EricoDeMecha/Die-Set/README.md

# DieSet Project
##  Problem statement

Among the significant advances in civil engineering, developing construction parts in pieces and sliding them together is being widely adopted especially when construction is on a busy site, and sometimes due to extreme urgency for the completion of the project. This approach allows for modularization and distribution of the project modules. However, it also introduces complexity to the project as such parts weigh hundreds of tonnes. Sliding such constructions into place requires a standard piece of engineering. 

##  Proposed solution 
This project proposes a viable solution to this problem. It proposes a slight modification of a caster wheel by setting the caster angle to zero, eliminating bearings, and using high-strength materials with a yield strength of at least 241MPa.

##  CADCAMing the solution
### parts
* Top  plate
* Axle Support
* Axle
* Wheel
#### Sofwares
   * Autodesk Inventor Pro 2020
   * Autdesk  Inventor CAM Ultimate 2020

**Note**

   Find more in the report and presentation directories,
