EricoDeMecha/Die-Set/Presentation/presentation.pptx

## Die set

easing heavy skidding

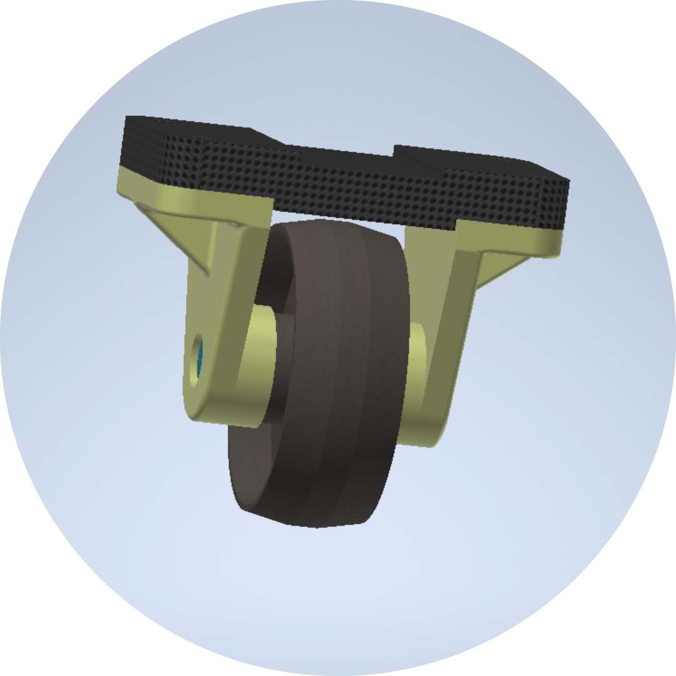
[picture p1: figure]

## Problem

- Heavy tracks. Casts.
- Complicated plate tracks.
- Enormous hydraulics.
- Costly tracks.
(Video Evidence)

## Comparison 01

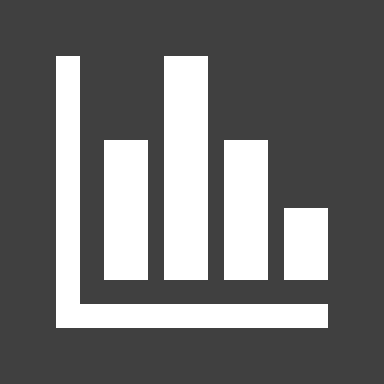
[picture p2: figure]
Bar chart

- Caster wheel 01

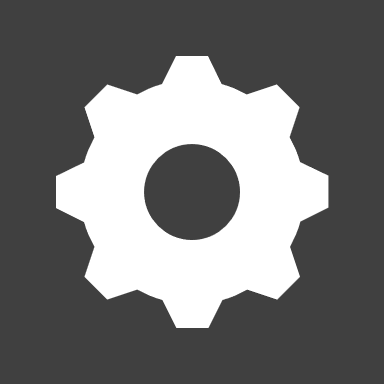
[picture p3: figure]
Single gear

- Die Set 01

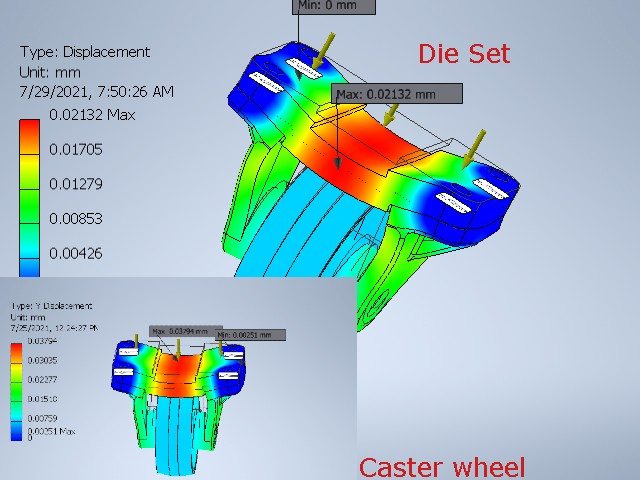
[picture p4: figure]
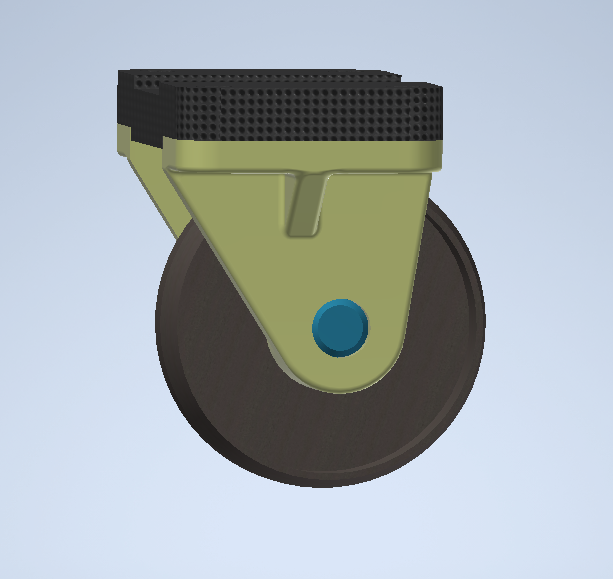
[picture p5: figure]

caster wheel
- Caster angle of approximately 15
- 0.03791mm Y displacement

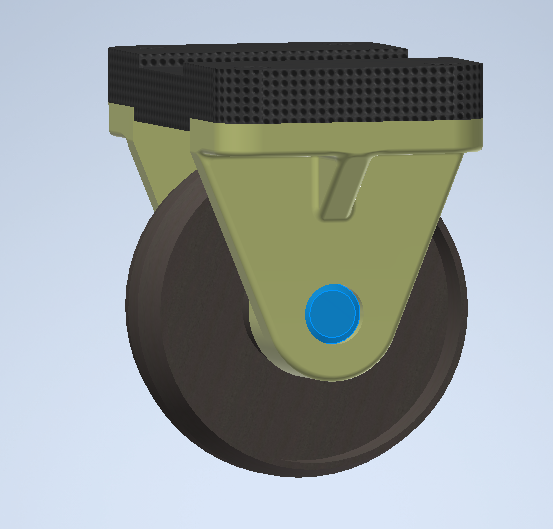
[picture p6: figure]

Die set
- Zero Caster angle
- 0.02132mm Y displacement

## Material

STAINLESS STEEL

CARBON STEEL
MALLEABLE IRON

## TOP PLATE 01

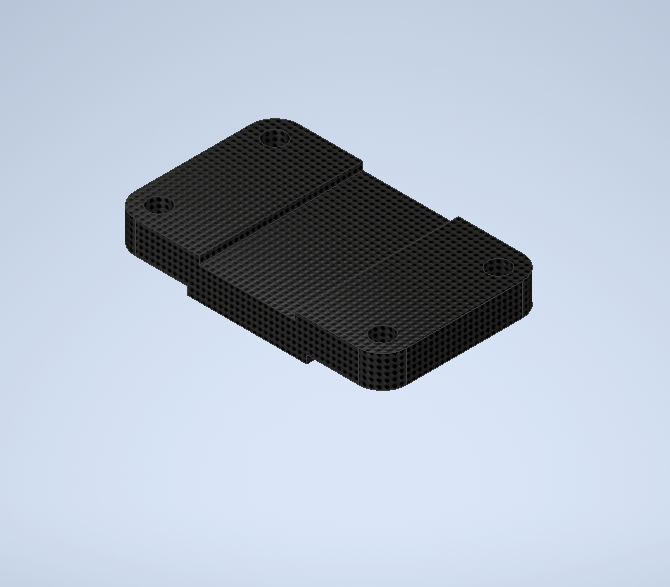
[picture p7: figure]

It is a 136mm by 82 mm by 16mm with four 11mm diameter holes
PART DESIGN: - design with machining in mind.
I. 2D MILLING (16mm flat mill)
- Stock material removal.
- top groove milling (2mm).
- 2 side grooves milling (2mm).
- Filleting (12mm radius).
MILLING: - Milling with mounting in mind.
II. DRILLING (10mm drill)
- Guided drilling(5mm then 10mm)
NOTE: - Two part machining
- machining time

## AXLE SUPPORT 02

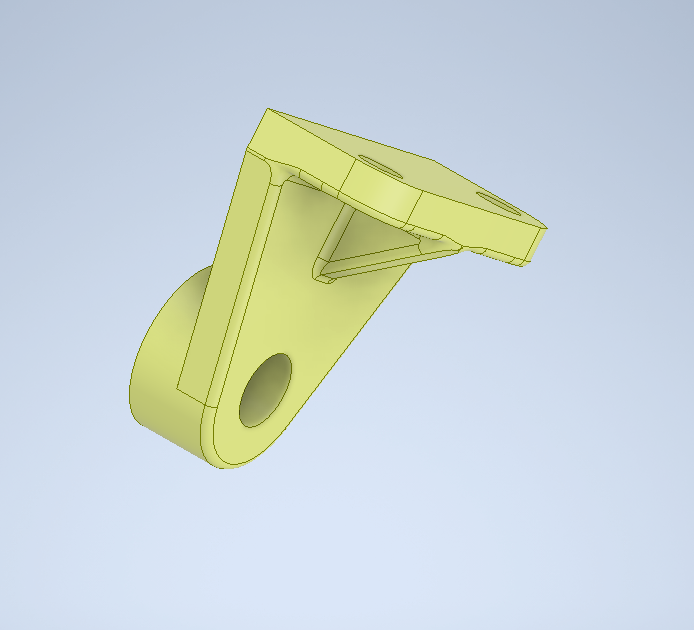
[picture p8: figure]

Connects the wheel axle and the top plate.
- Three part machining
I. 2D MILLING
- Stock material removal.
II. 2D ADAPTIVE MILLING
- Milling pockets around the rib.
- Milling the gradient of the rib.
- Filleting edges.
- Drilling by milling.
III. FINISHING
- Ball mill for smooth rib gradient.

## AXLE 03

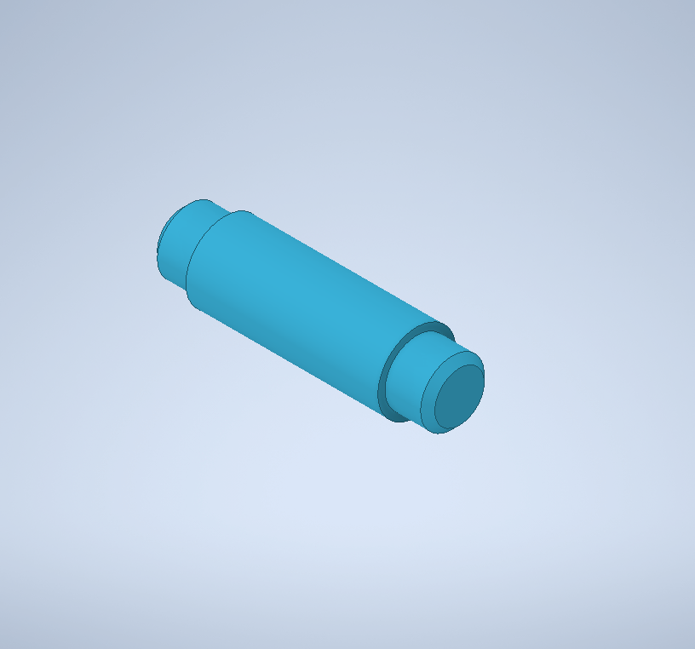
[picture p9: figure]

Supports the wheel. Cylindrical, 21.9mm O.D. , 17.9mm I.D. , and 78mm length.
I. FACING
- Removal extra stock material.
II. PROFILE TURNING
- Pattern: chamfer, side parting
NOTE: - two part milling (symmetric)

## WHEEL 04

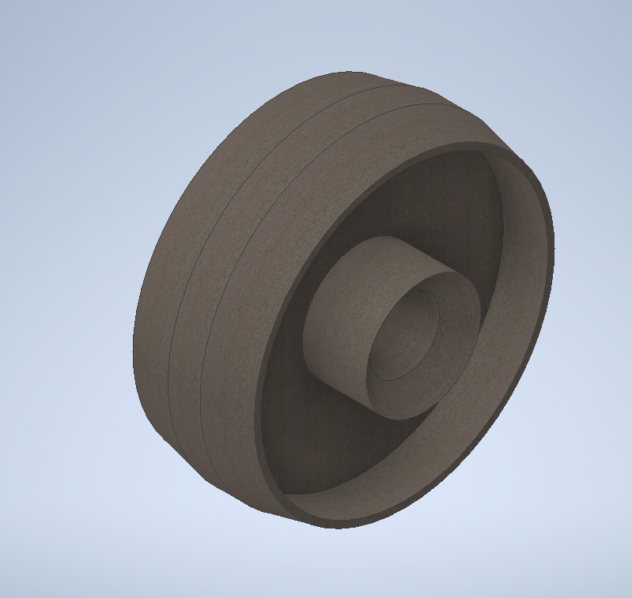
[picture p10: figure]

Interfaces with either the rail or the ground.
I. 2D MILLING
- Stock extra material removal.
II. 2D CONTOUR MILLING.
- chamfer milling
III. DRILLING BY MILLING
- circular milling with increasing feed rate.
Note:- Machining time
- Symmetric two part milling.

## NOTE 01

- NOTE 01 MACHINING TIME

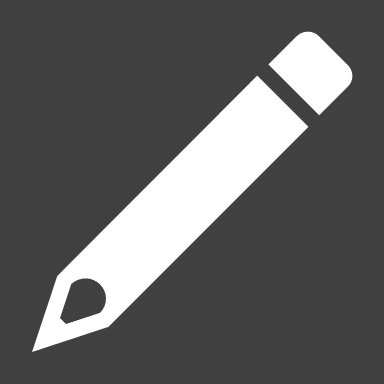
[picture p11: figure]
Pencil

- Tool travel path. Idling.
- Adaptive milling. Optimized tool path.

- Ball milling tool for 2D milling ribs.
- 0.5mm material left for finishing.
- Tool speed.

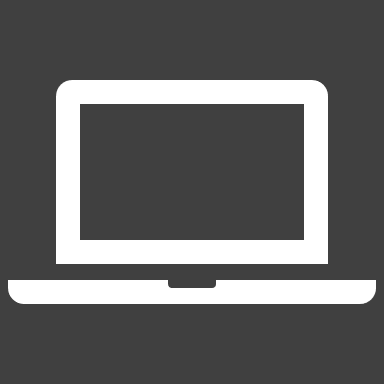
[picture p12: figure]
Laptop

- NOTE 02 SURFACE AESTHETICS

## NOTE 02

- NOTE 03 not achieved

- Synchronizing subsequent adaptive milling operations.
- Filleting for the axle support.
- Smooth finishing for the axle support’s rib.

- - TODO

- NOTE 02 todo

## Chart

## Table

TOPIC 01 | TOPIC 02 | TOPIC 03 | TOPIC 04 | TOPIC 05
Item 01 | Text | Text | Text | Text
Item 02 | Text | Text | Text | Text
Item 03 | Text | Text | Text | Text
Item 04 | Text | Text | Text | Text
Item 05 | Text | Text | Text | Text
Item 06 | Text | Text | Text | Text
Item 07 | Text | Text | Text | Text
Item 08 | Text | Text | Text | Text
TOTAL | Text | Text | Text | Text

## Project files

Template Editing Instructions and Feedback

## Thank you!

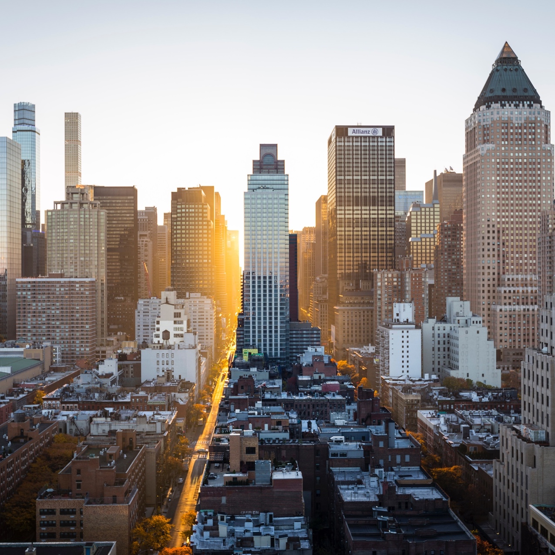
[picture p13: figure]
cityscape

Flora@contoso.com

- http://www.contoso.com/
