EricoDeMecha/Die-Set/(list of files, cad)

Other CAD files:
CAD/CasterWheel/Assembly.iam
CAD/CasterWheel/OldVersions/Assembly.0008.iam
CAD/CasterWheel/OldVersions/axle.0002.ipt
CAD/CasterWheel/OldVersions/axleSupport.0004.ipt
CAD/CasterWheel/OldVersions/drawing.0001.idw
CAD/CasterWheel/OldVersions/topPlate.0006.ipt
CAD/CasterWheel/OldVersions/wheel.0004.ipt
CAD/CasterWheel/axle.ipt
CAD/CasterWheel/axleSupport.ipt
CAD/CasterWheel/drawing.idw
CAD/CasterWheel/topPlate.ipt
CAD/CasterWheel/wheel.ipt
CAD/DieSet/Assembly.iam
CAD/DieSet/OldVersions/Assembly.0006.iam
CAD/DieSet/OldVersions/axle.0004.ipt
CAD/DieSet/OldVersions/axleSupport.0005.ipt
CAD/DieSet/OldVersions/drawing.0003.idw
CAD/DieSet/OldVersions/topPlate.0010.ipt
CAD/DieSet/OldVersions/wheel.0005.ipt
CAD/DieSet/axle.ipt
CAD/DieSet/axleSupport.ipt
CAD/DieSet/drawing.idw
CAD/DieSet/topPlate.ipt
CAD/DieSet/wheel.ipt
CAM/Assembly.iam
CAM/OldVersions/Assembly.0003.iam
CAM/OldVersions/axle.0002.ipt
CAM/OldVersions/axleSupport.0003.ipt
CAM/OldVersions/topPlate.0004.ipt
CAM/OldVersions/wheel.0004.ipt
CAM/axle.ipt
CAM/axleSupport.ipt
CAM/axleSupport2/OldVersions/Assembly.0001.iam
CAM/axleSupport2/OldVersions/axleSupport.0003.ipt
CAM/axleSupport2/OldVersions/topPlate.0002.ipt
CAM/axleSupport2/OldVersions/wheel.0001.ipt
CAM/axleSupport2/axleSupport.ipt
CAM/axleSupport3/OldVersions/Assembly.0001.iam
CAM/axleSupport3/OldVersions/axleSupport.0002.ipt
CAM/axleSupport3/OldVersions/topPlate.0002.ipt
CAM/axleSupport3/OldVersions/wheel.0001.ipt
CAM/axleSupport3/axleSupport.ipt
CAM/axleSupportFinal1/OldVersions/Assembly.0001.iam
CAM/axleSupportFinal1/OldVersions/axleSupport.0002.ipt
CAM/axleSupportFinal1/OldVersions/topPlate.0002.ipt
CAM/axleSupportFinal1/OldVersions/wheel.0001.ipt
CAM/axleSupportFinal1/axleSupport.ipt
CAM/drawing.idw
CAM/topPlate.ipt
CAM/topPlate2/OldVersions/Assembly.0001.iam
CAM/topPlate2/OldVersions/axleSupport.0001.ipt
CAM/topPlate2/OldVersions/topPlate.0003.ipt
CAM/topPlate2/OldVersions/wheel.0001.ipt
CAM/topPlate2/topPlate.ipt
CAM/wheel.ipt
