EricoDeMecha/Die-Set/Reports/CasterWheelAnalysisReports/Caster Wheel Stress Analysis Report.pdf

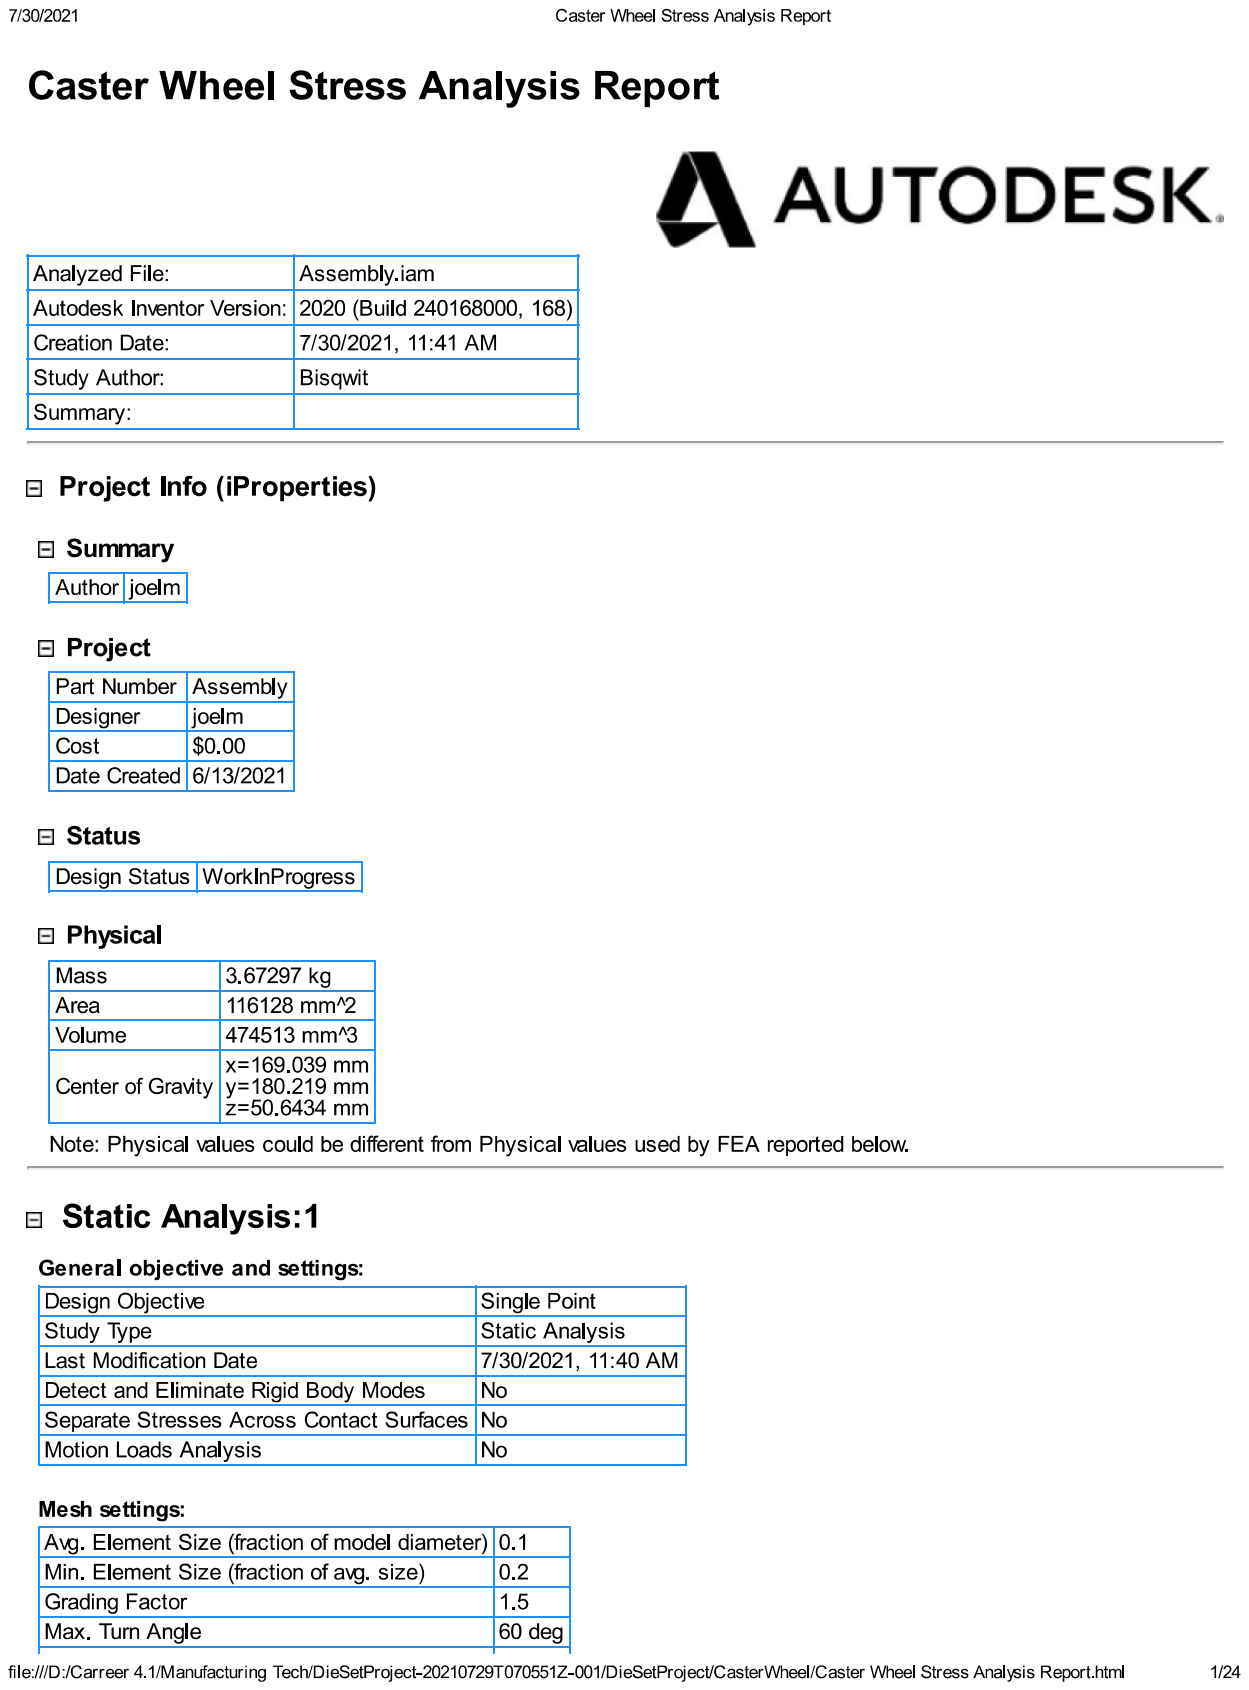
[picture p26: page 1]

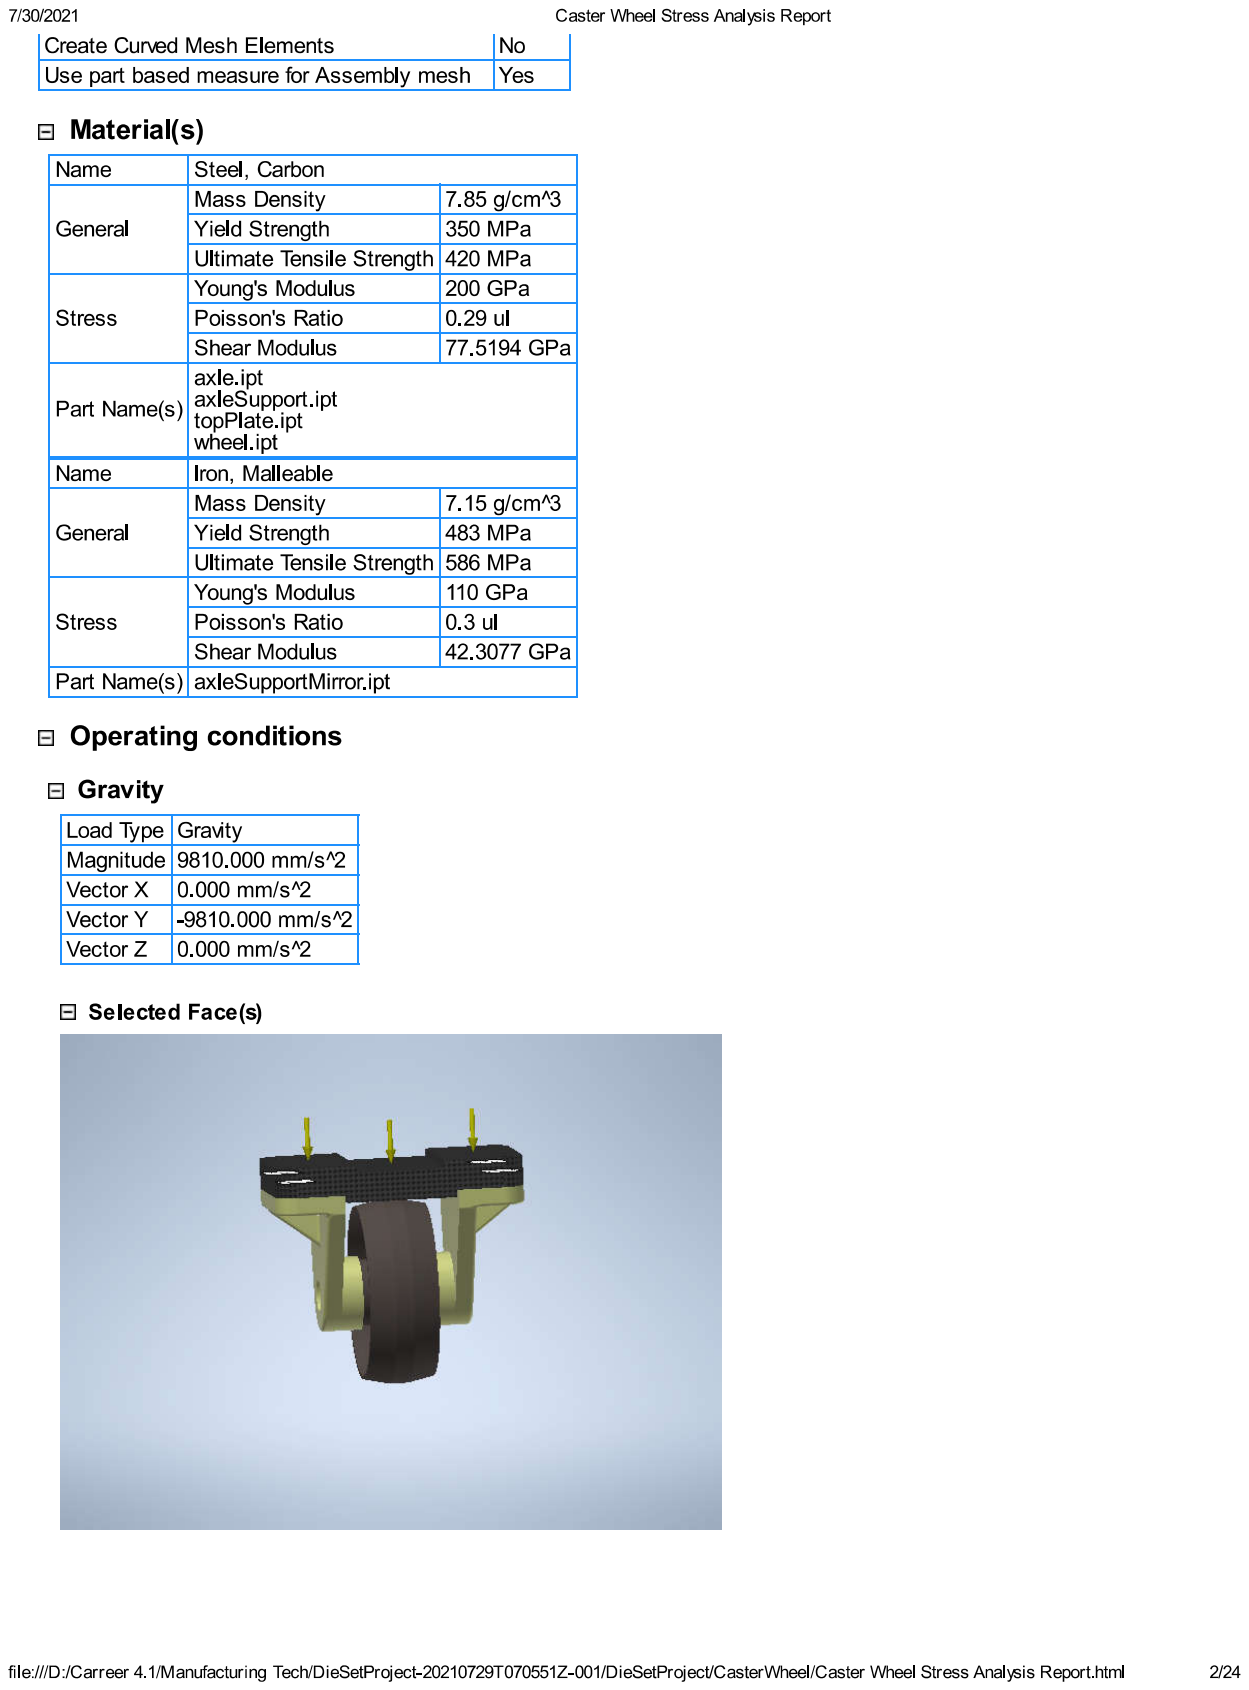
[picture p27: page 2]

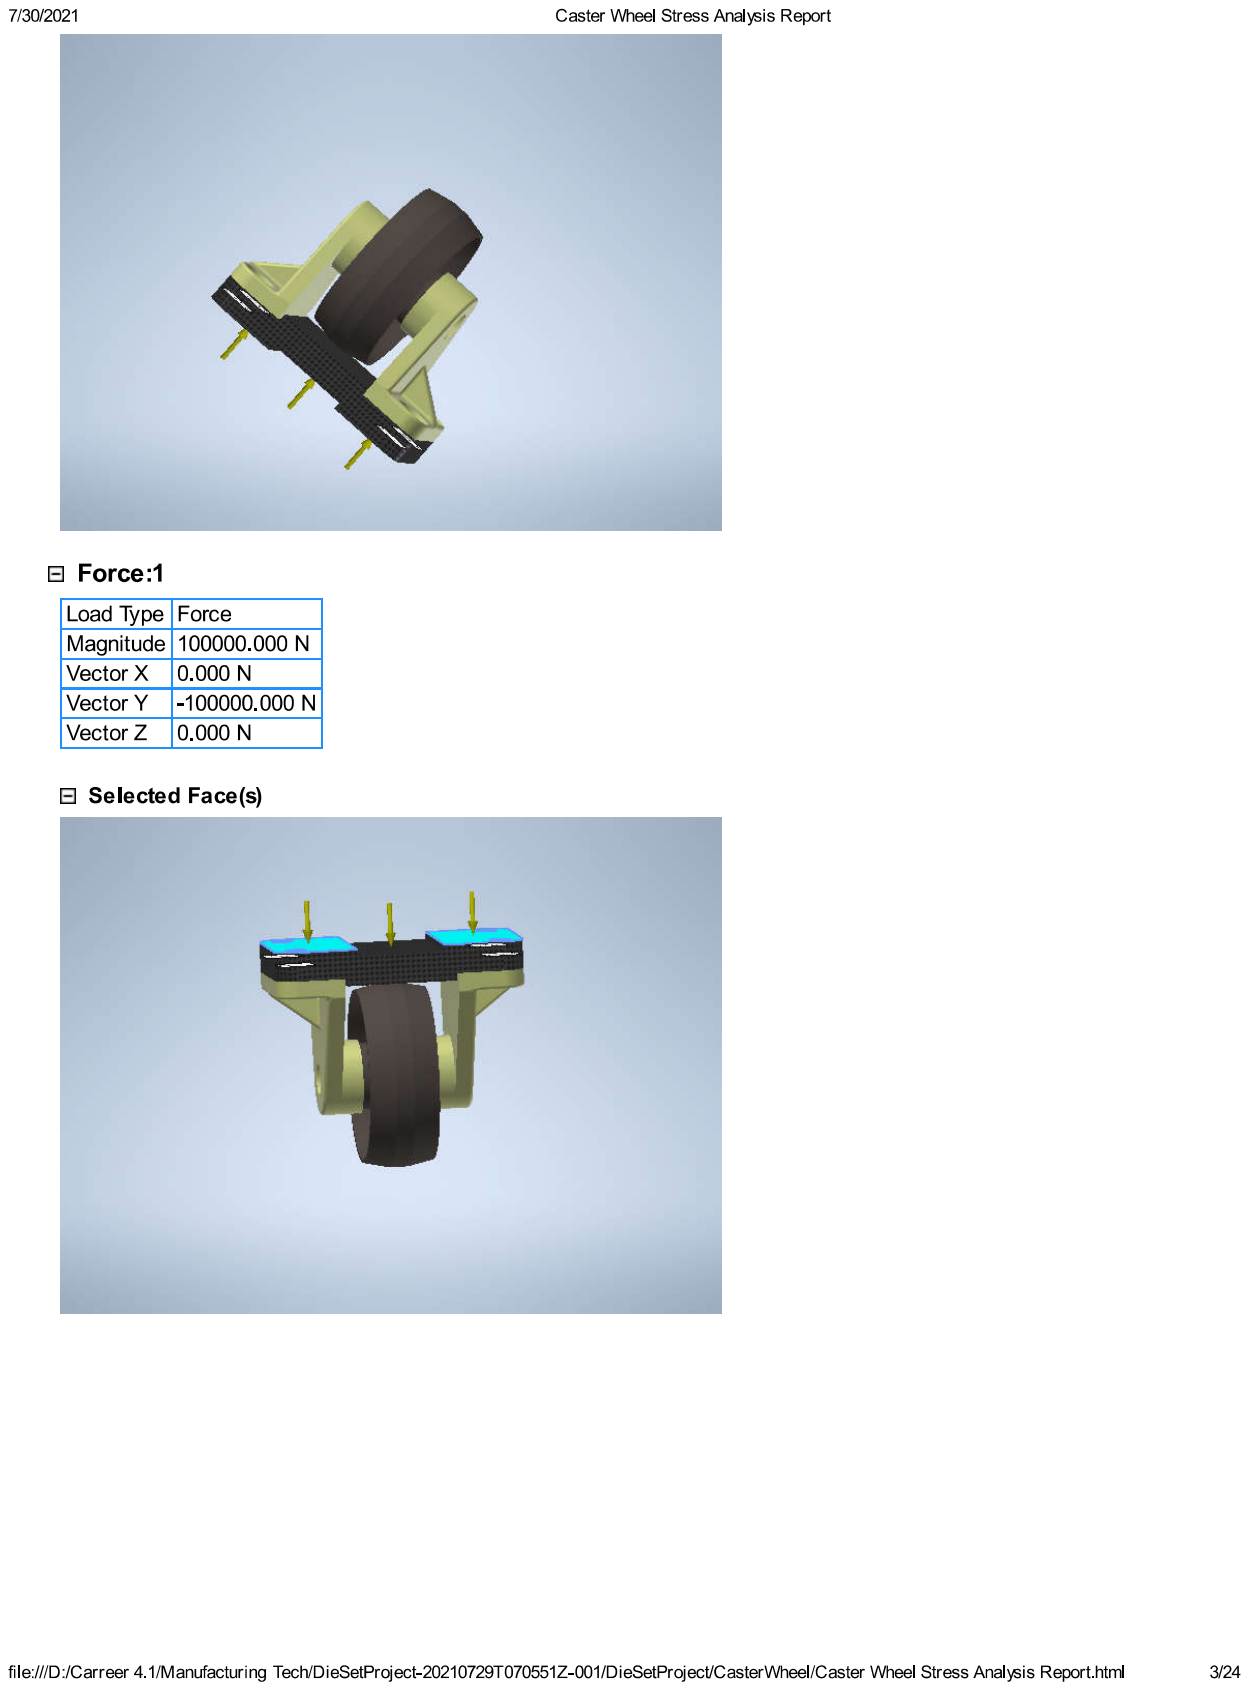
[picture p28: page 3]

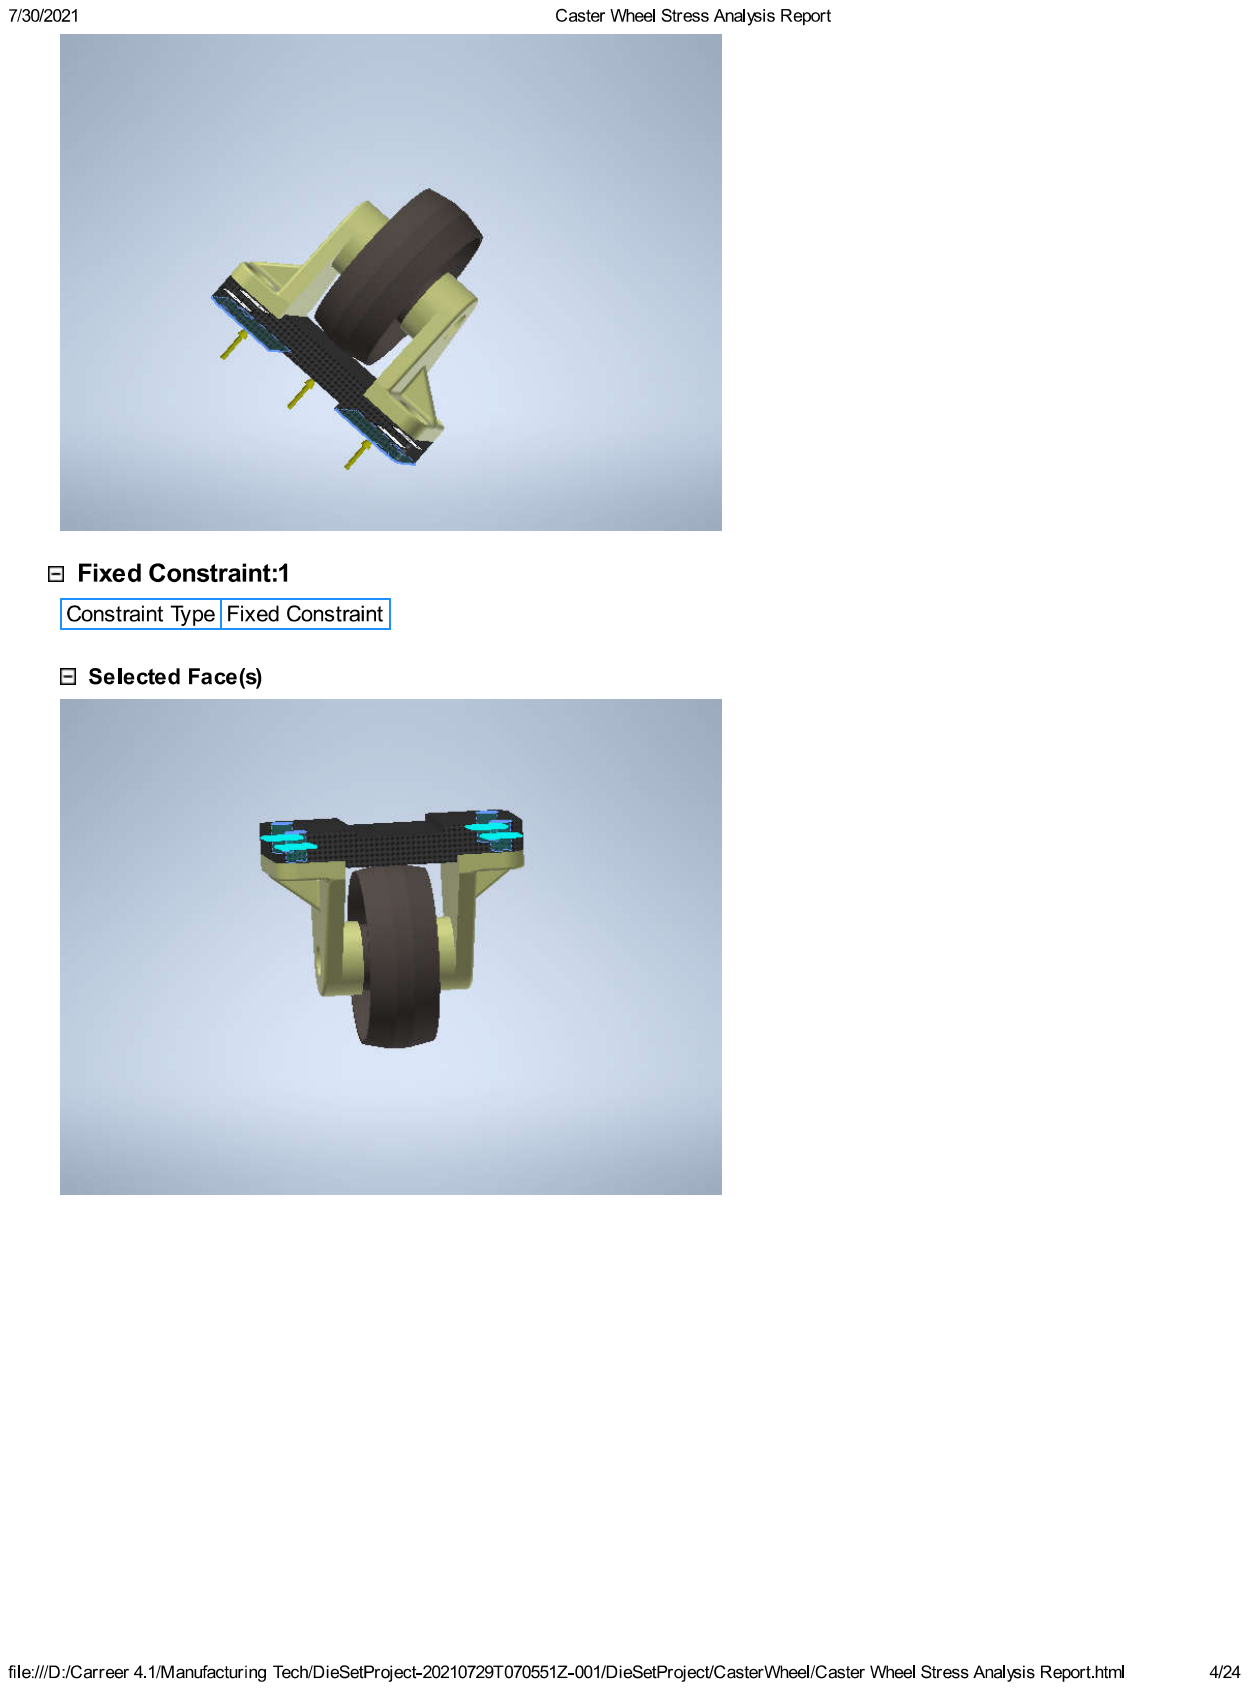
[picture p29: page 4]

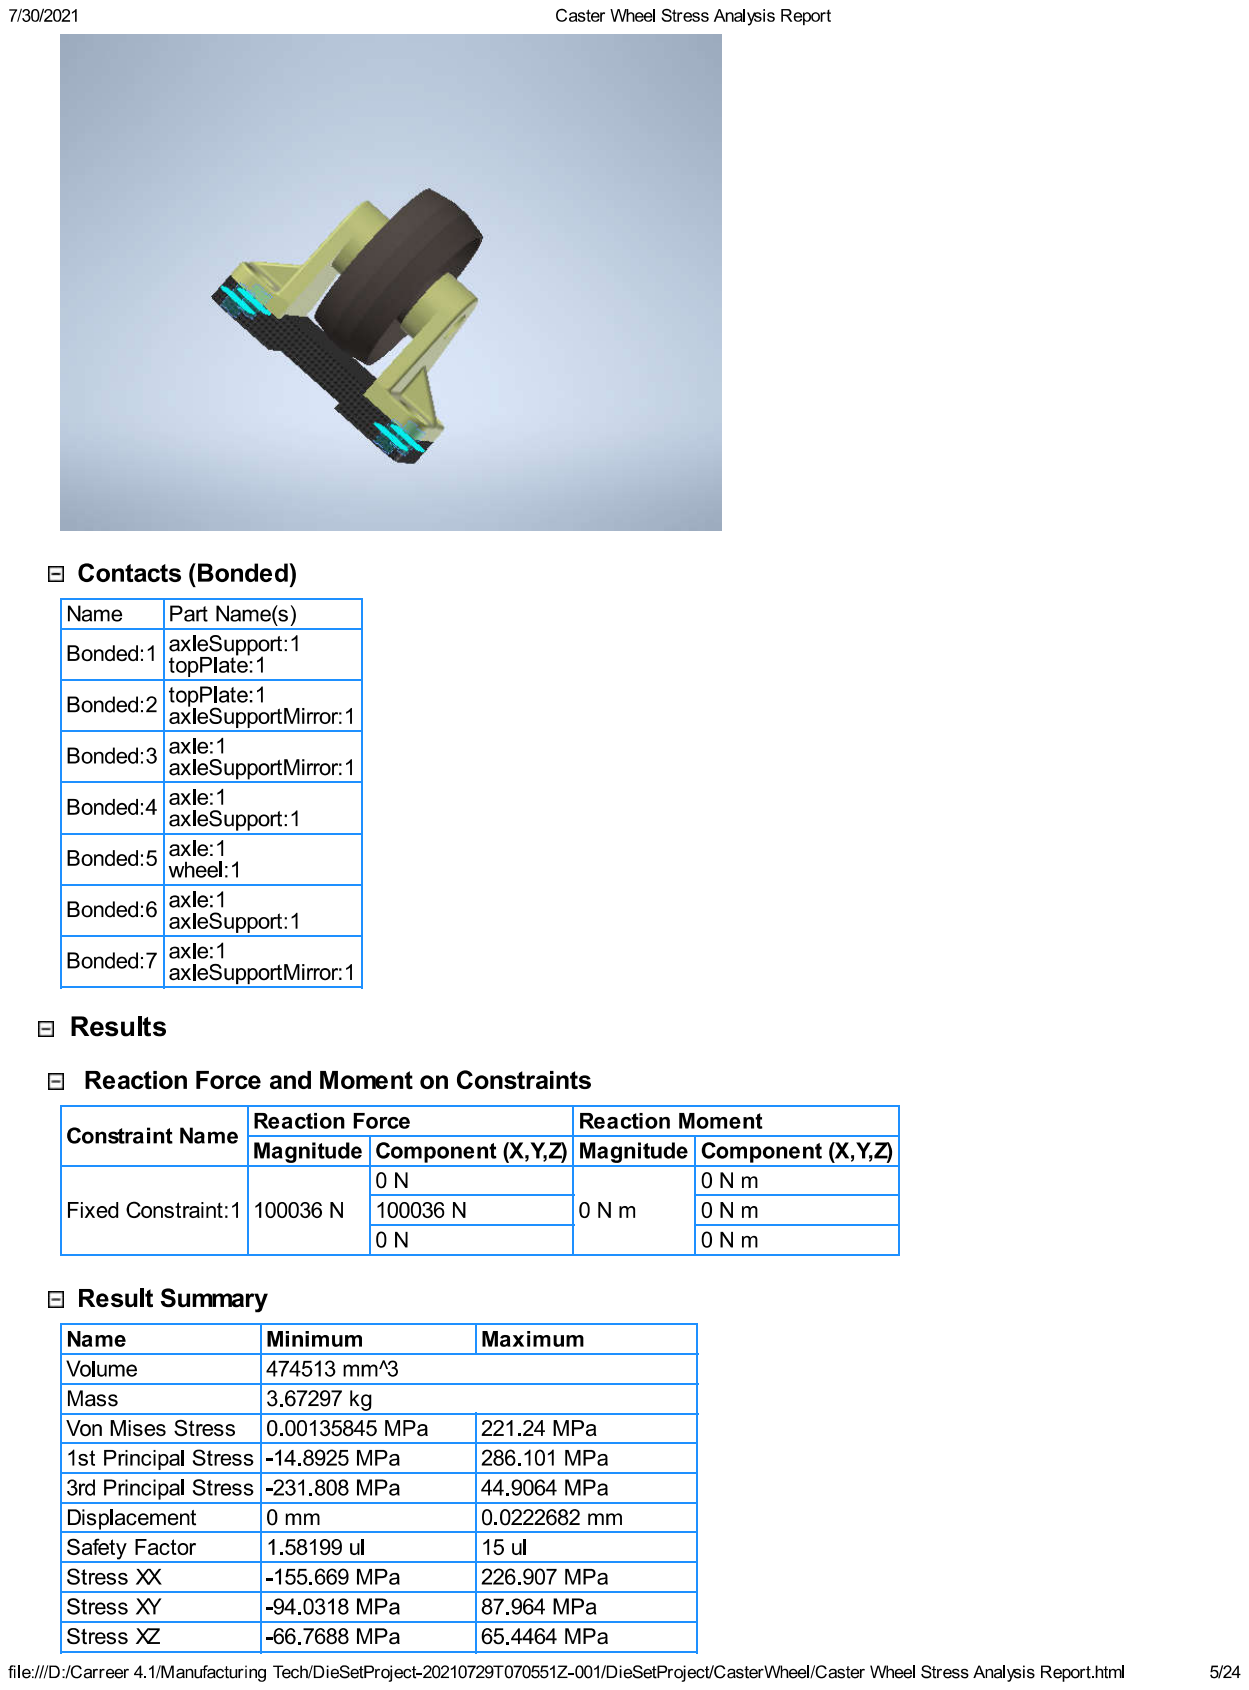
[picture p30: page 5]

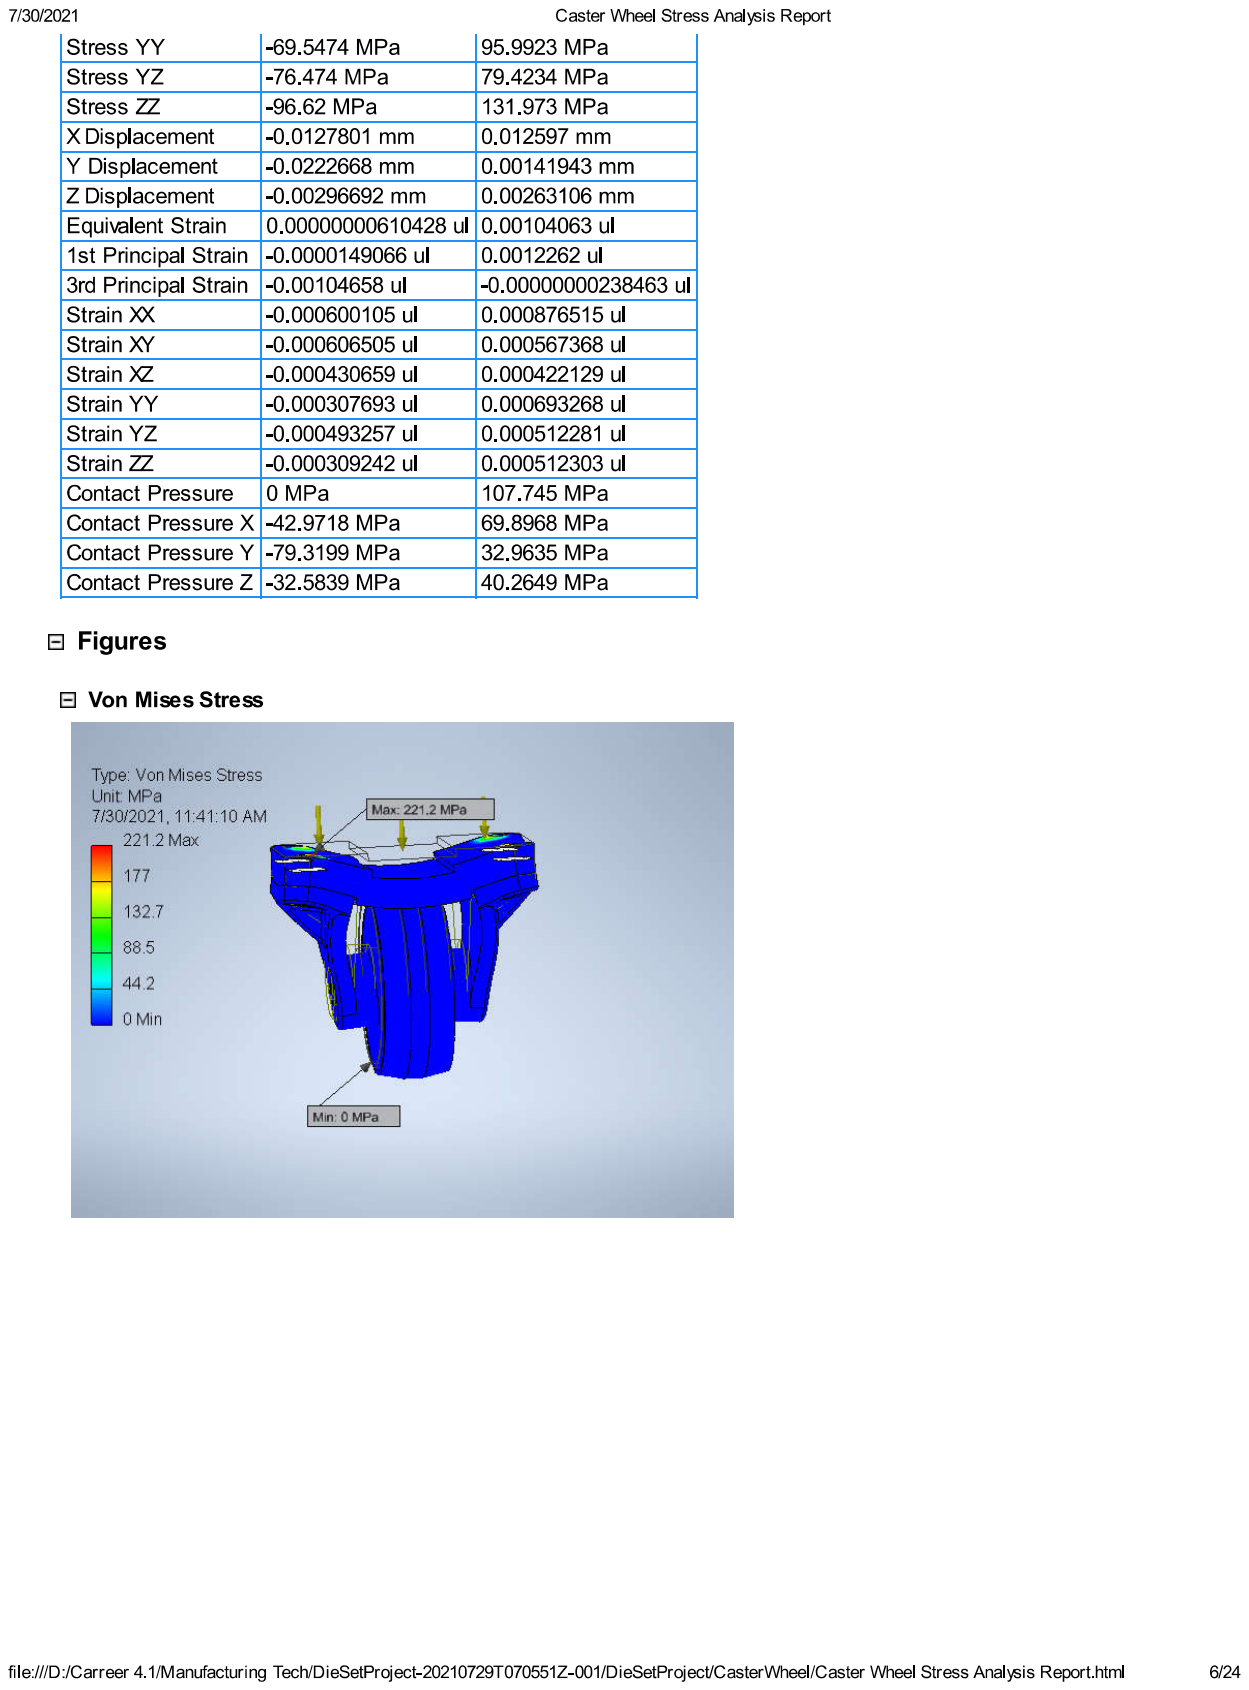
[picture p31: page 6]

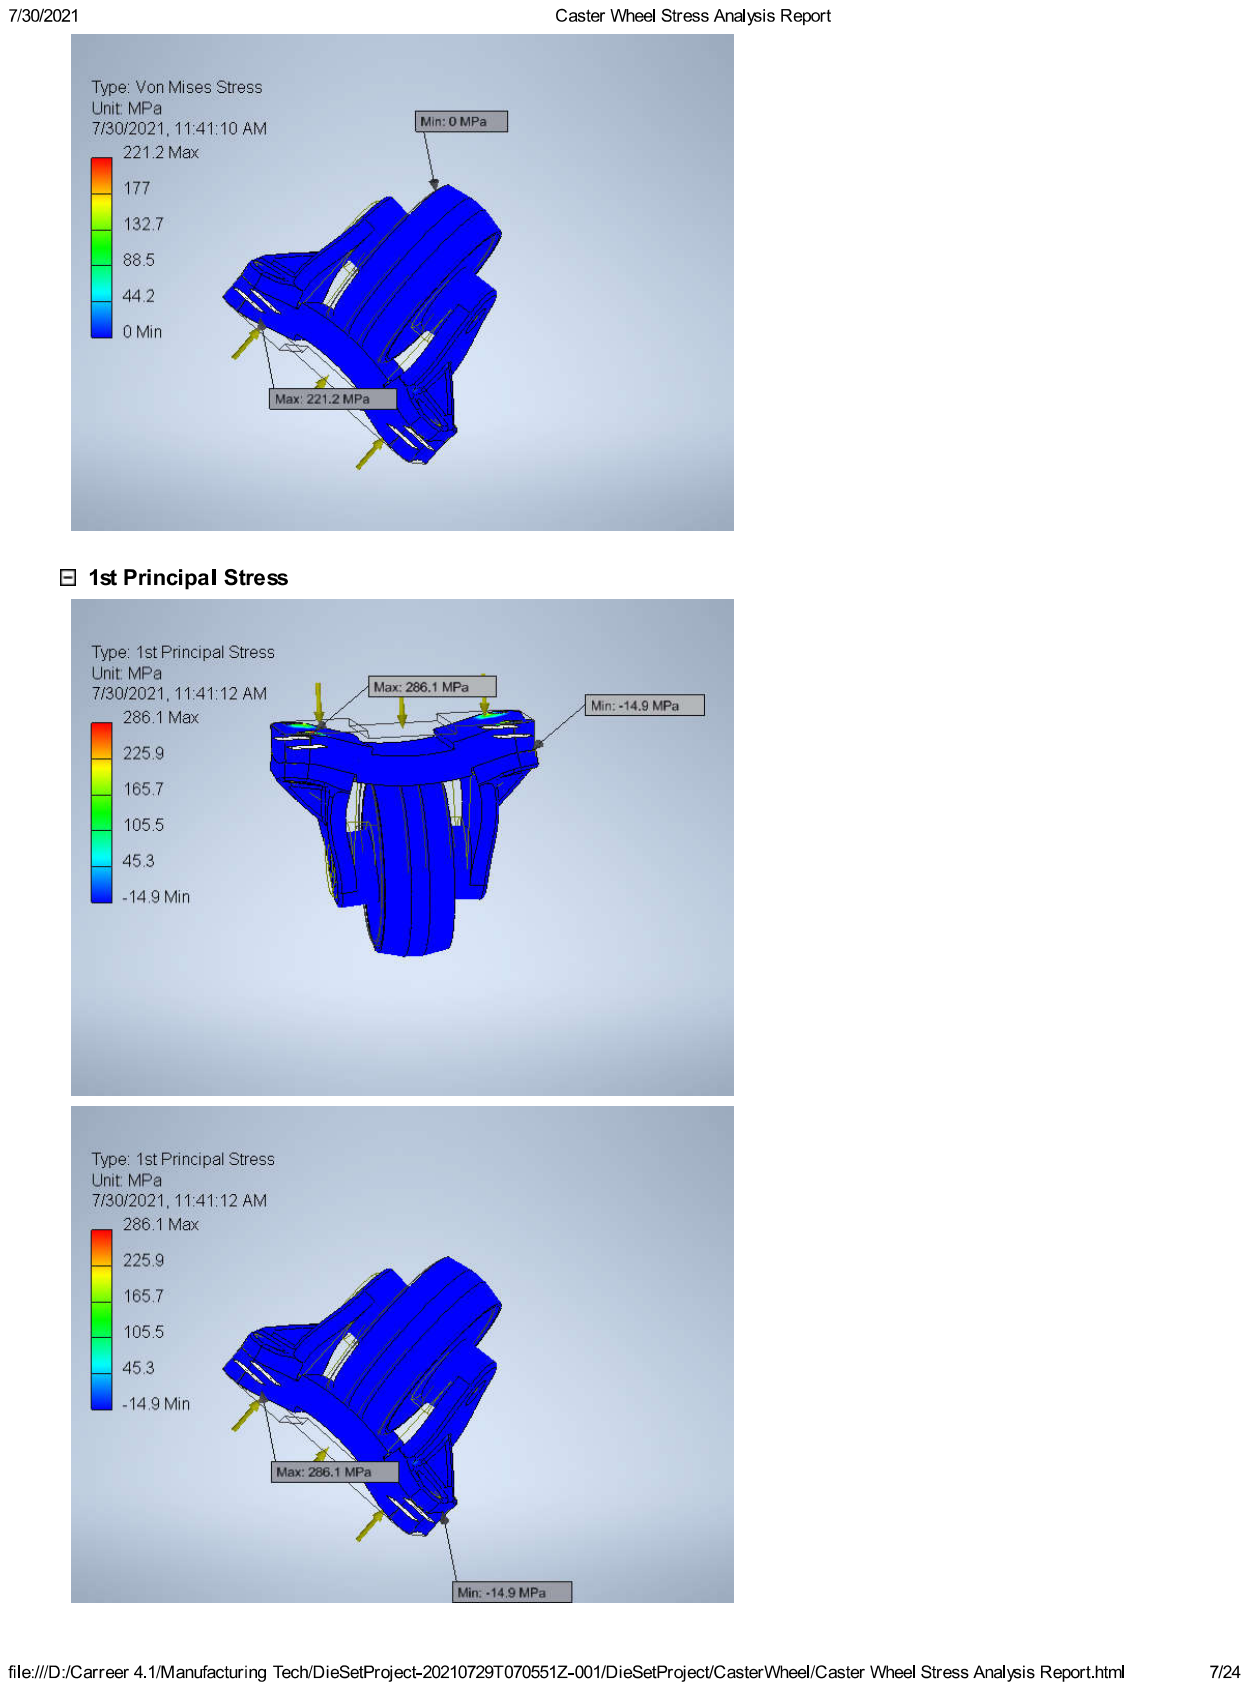
[picture p32: page 7]

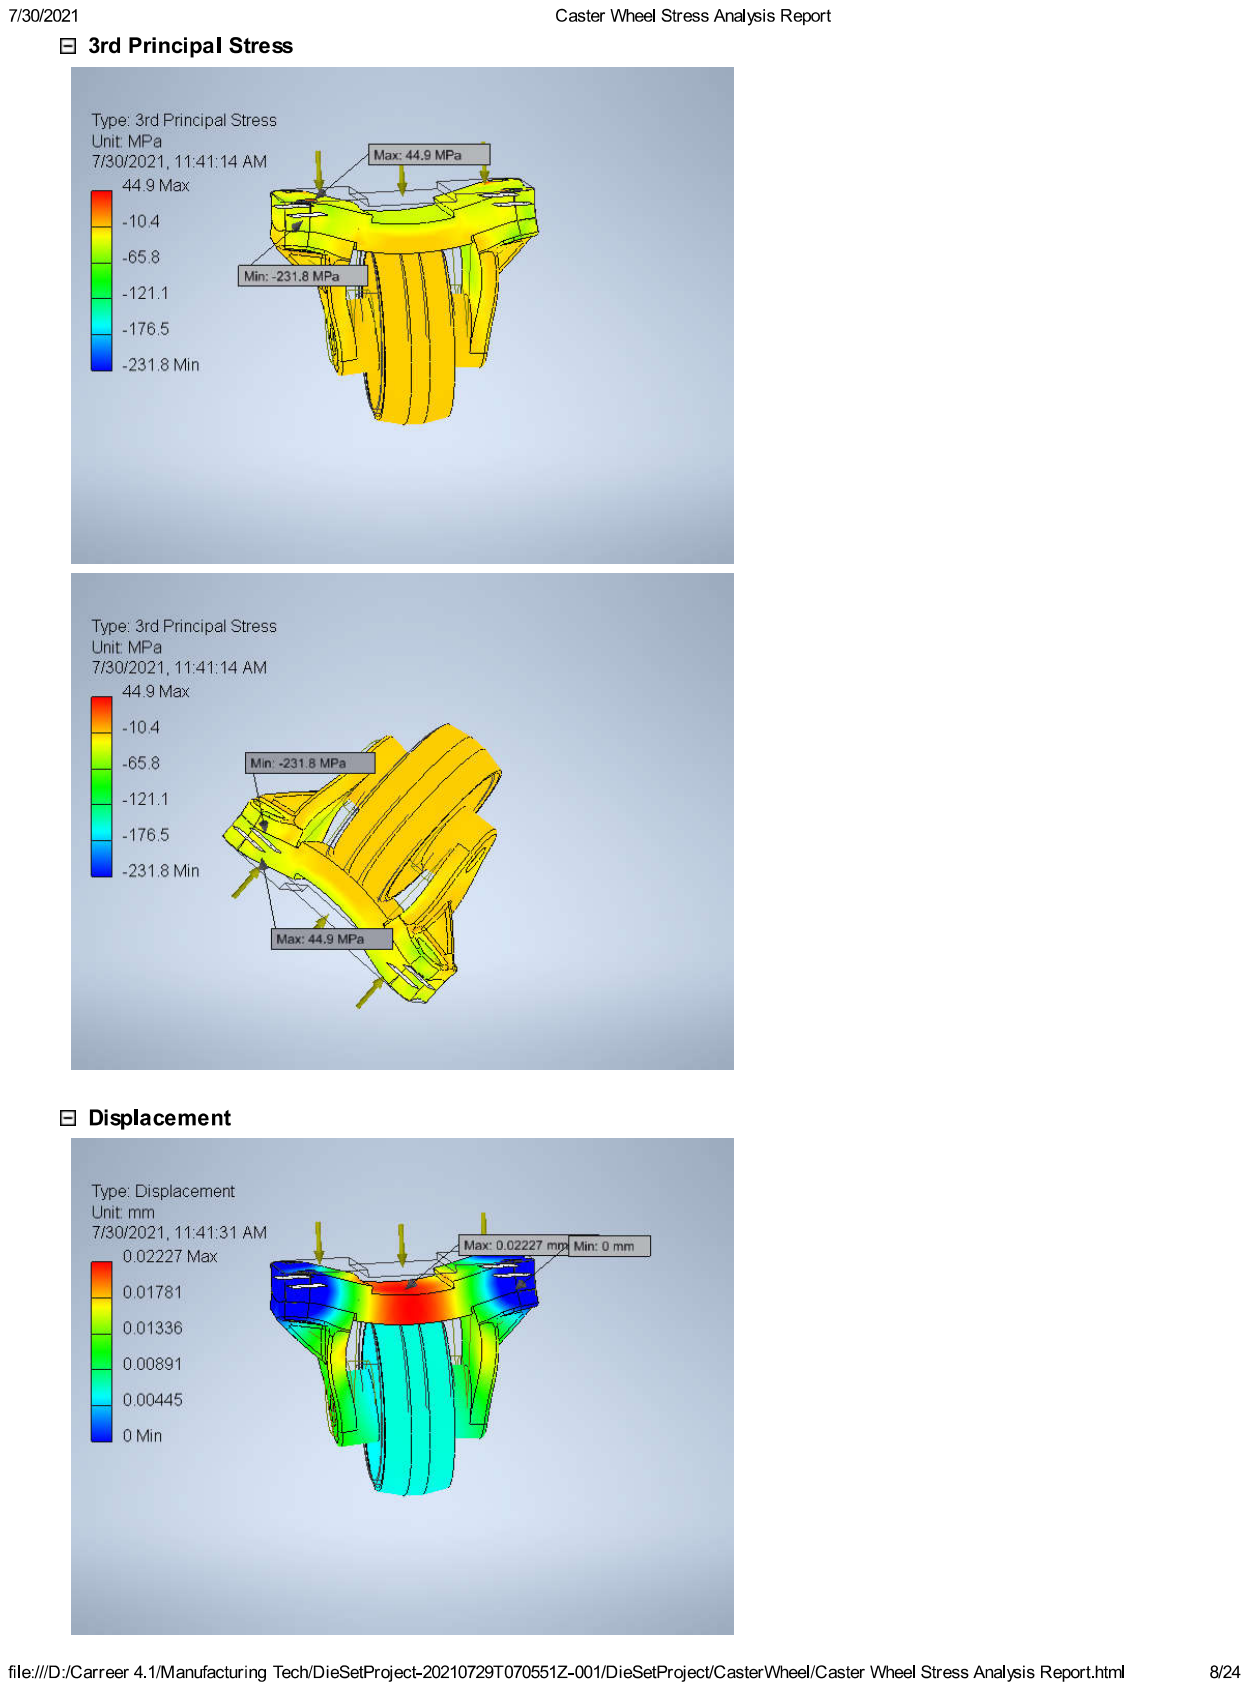
[picture p33: page 8]

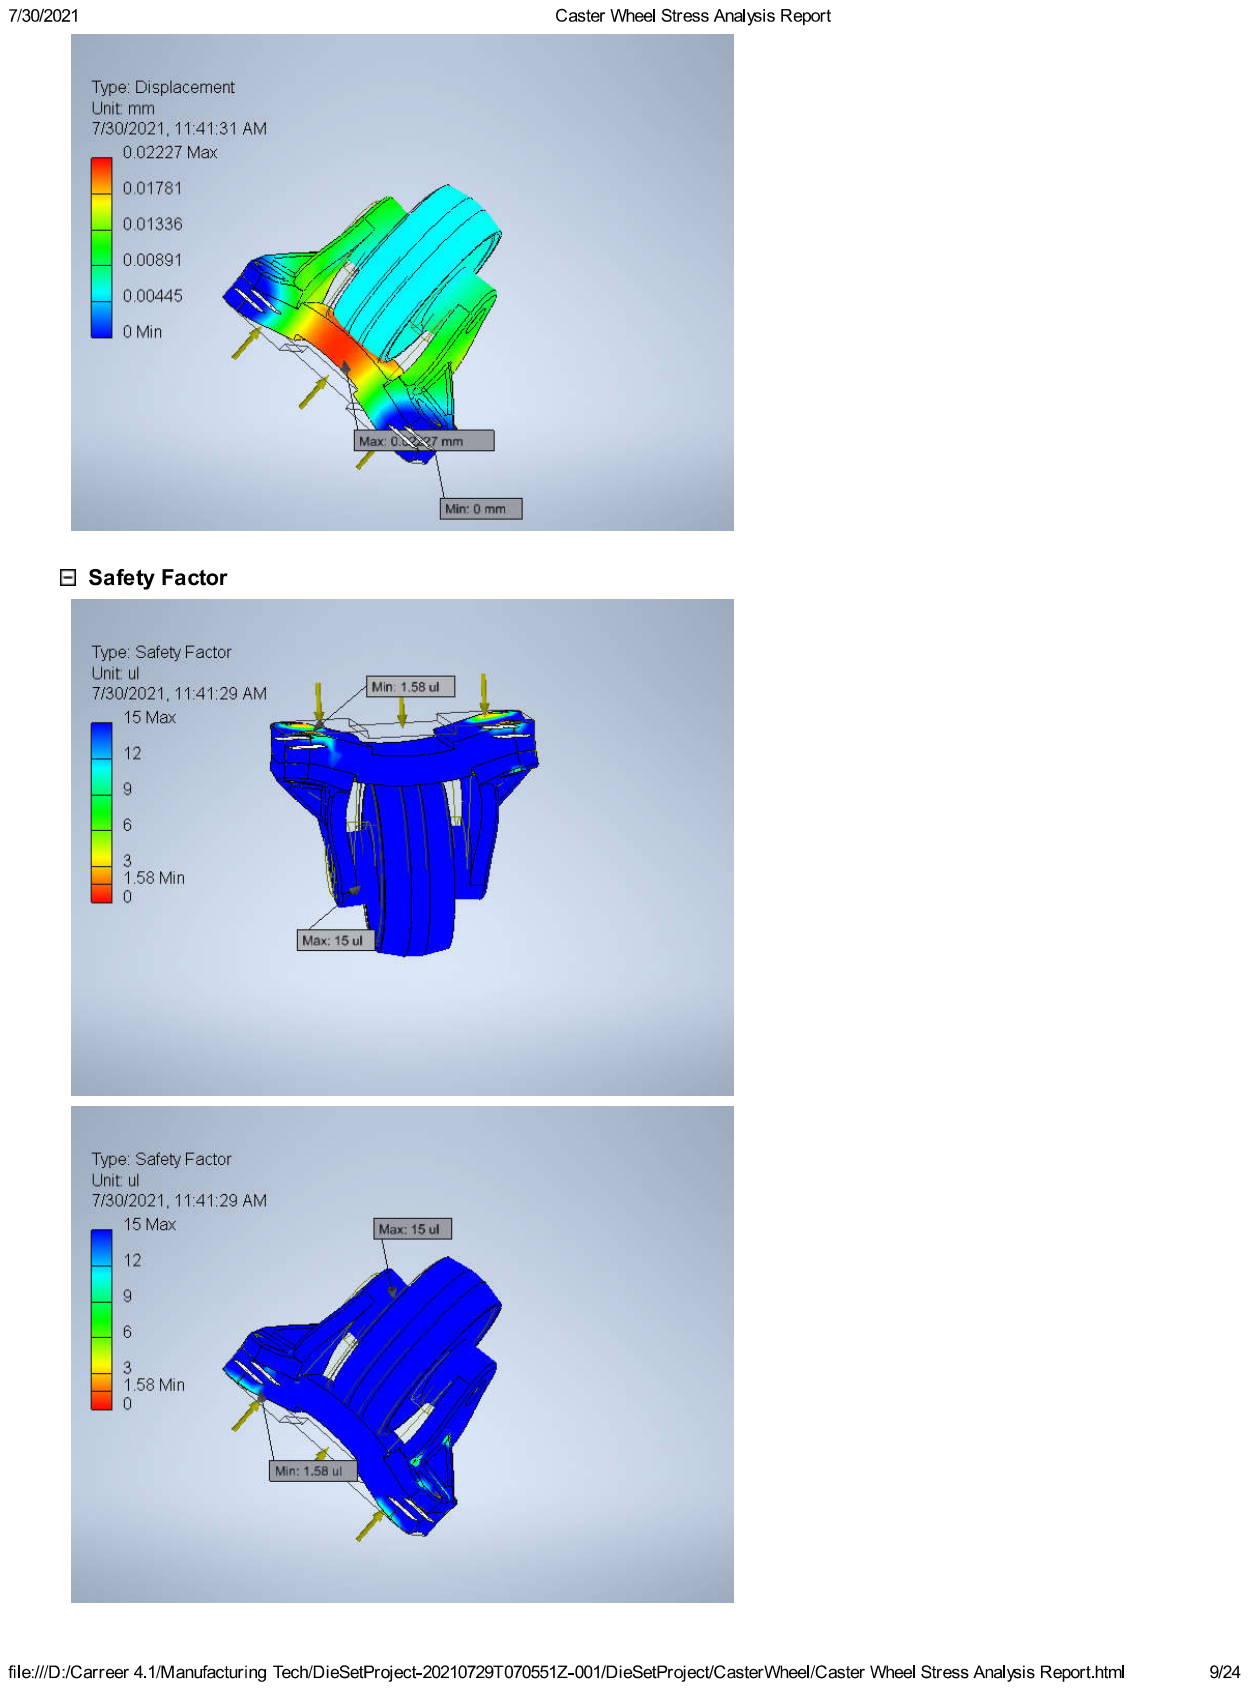
[picture p34: page 9]

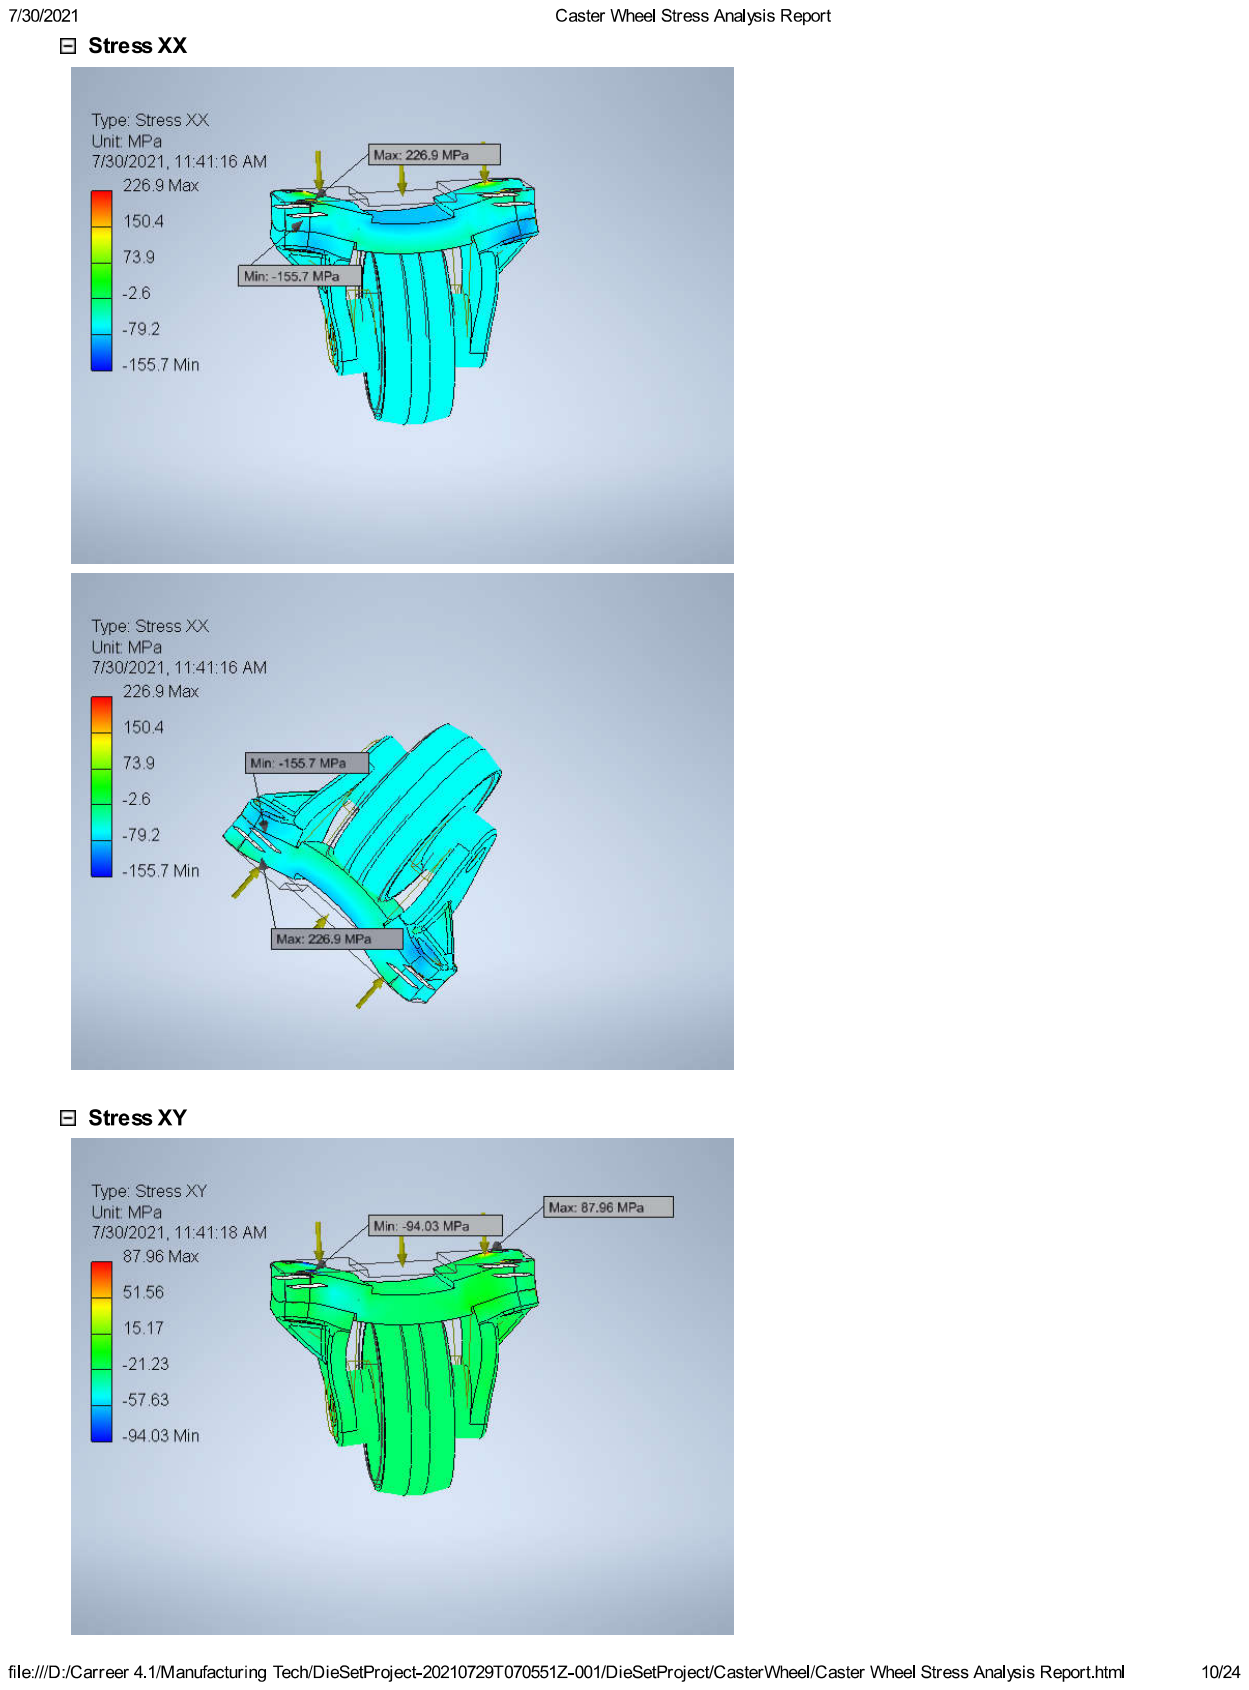
[picture p35: page 10]

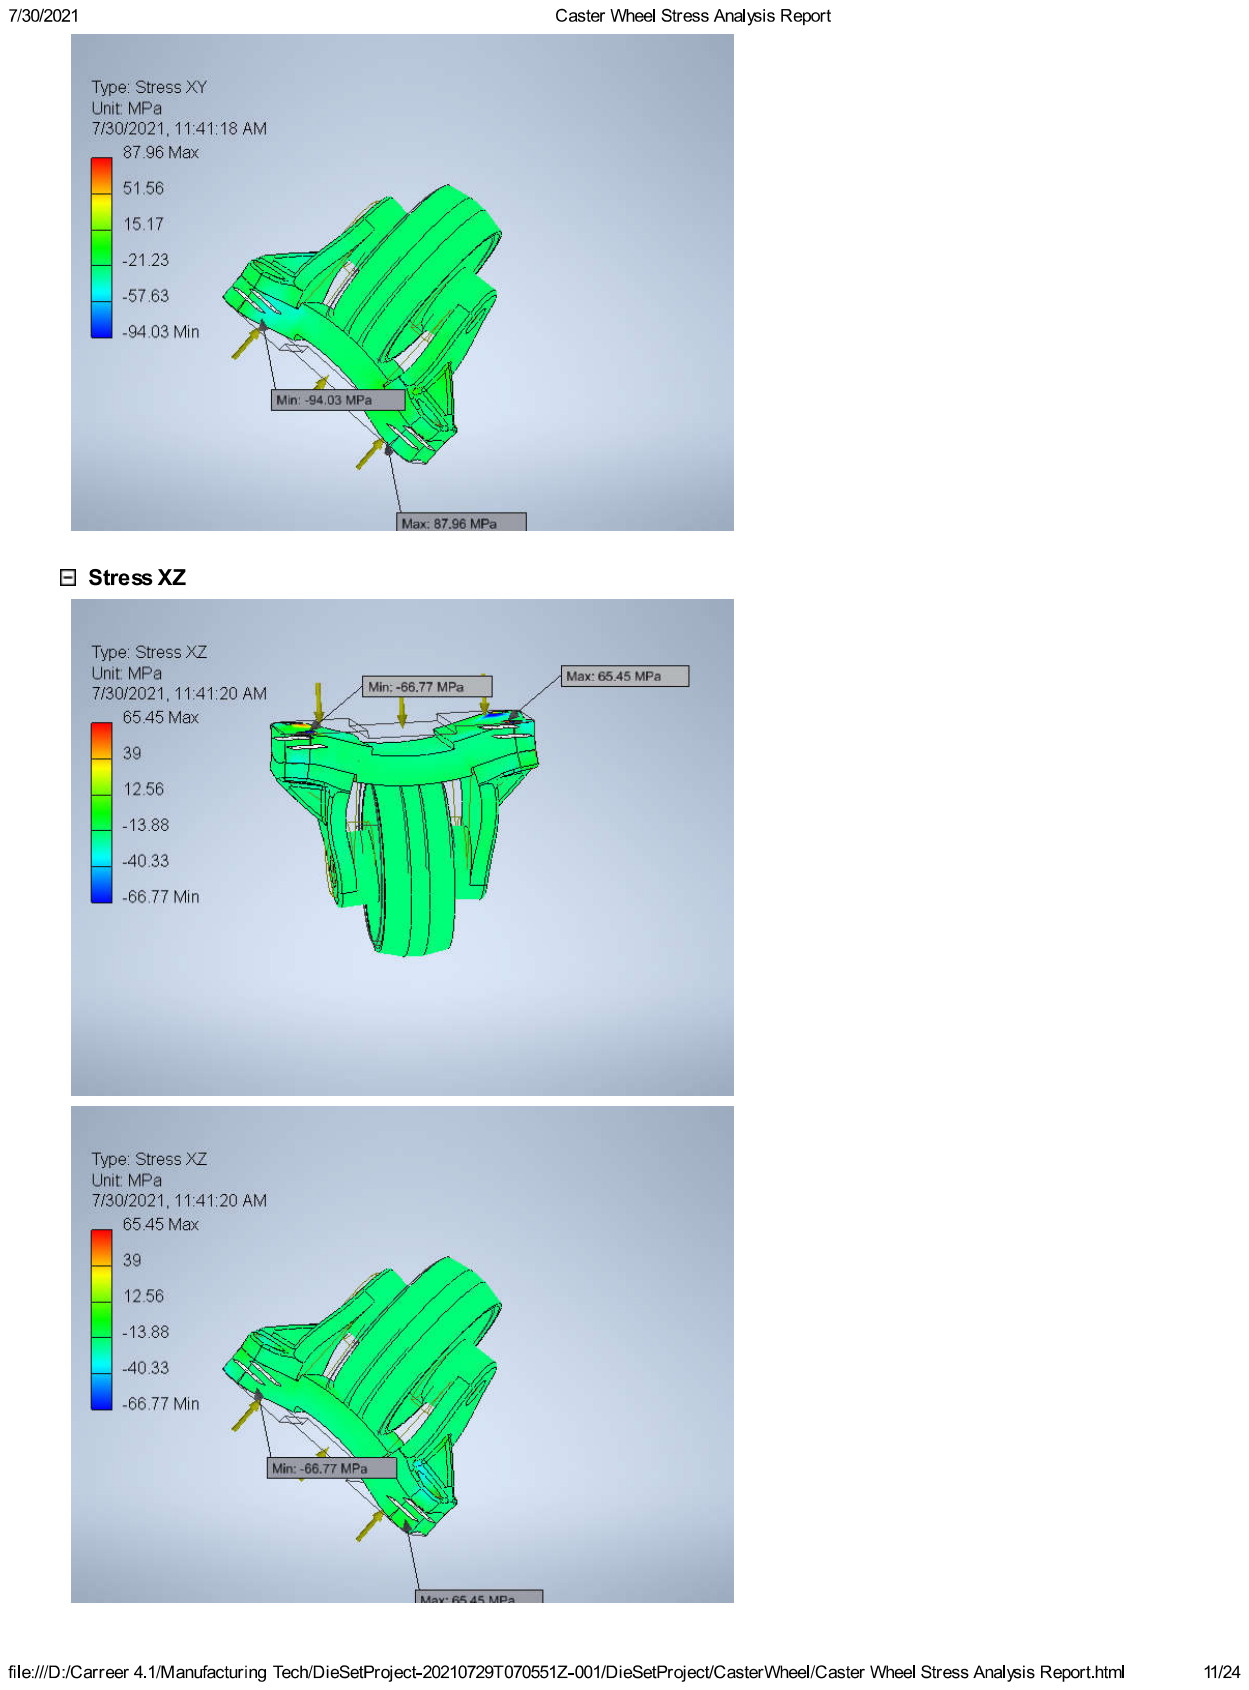
[picture p36: page 11]

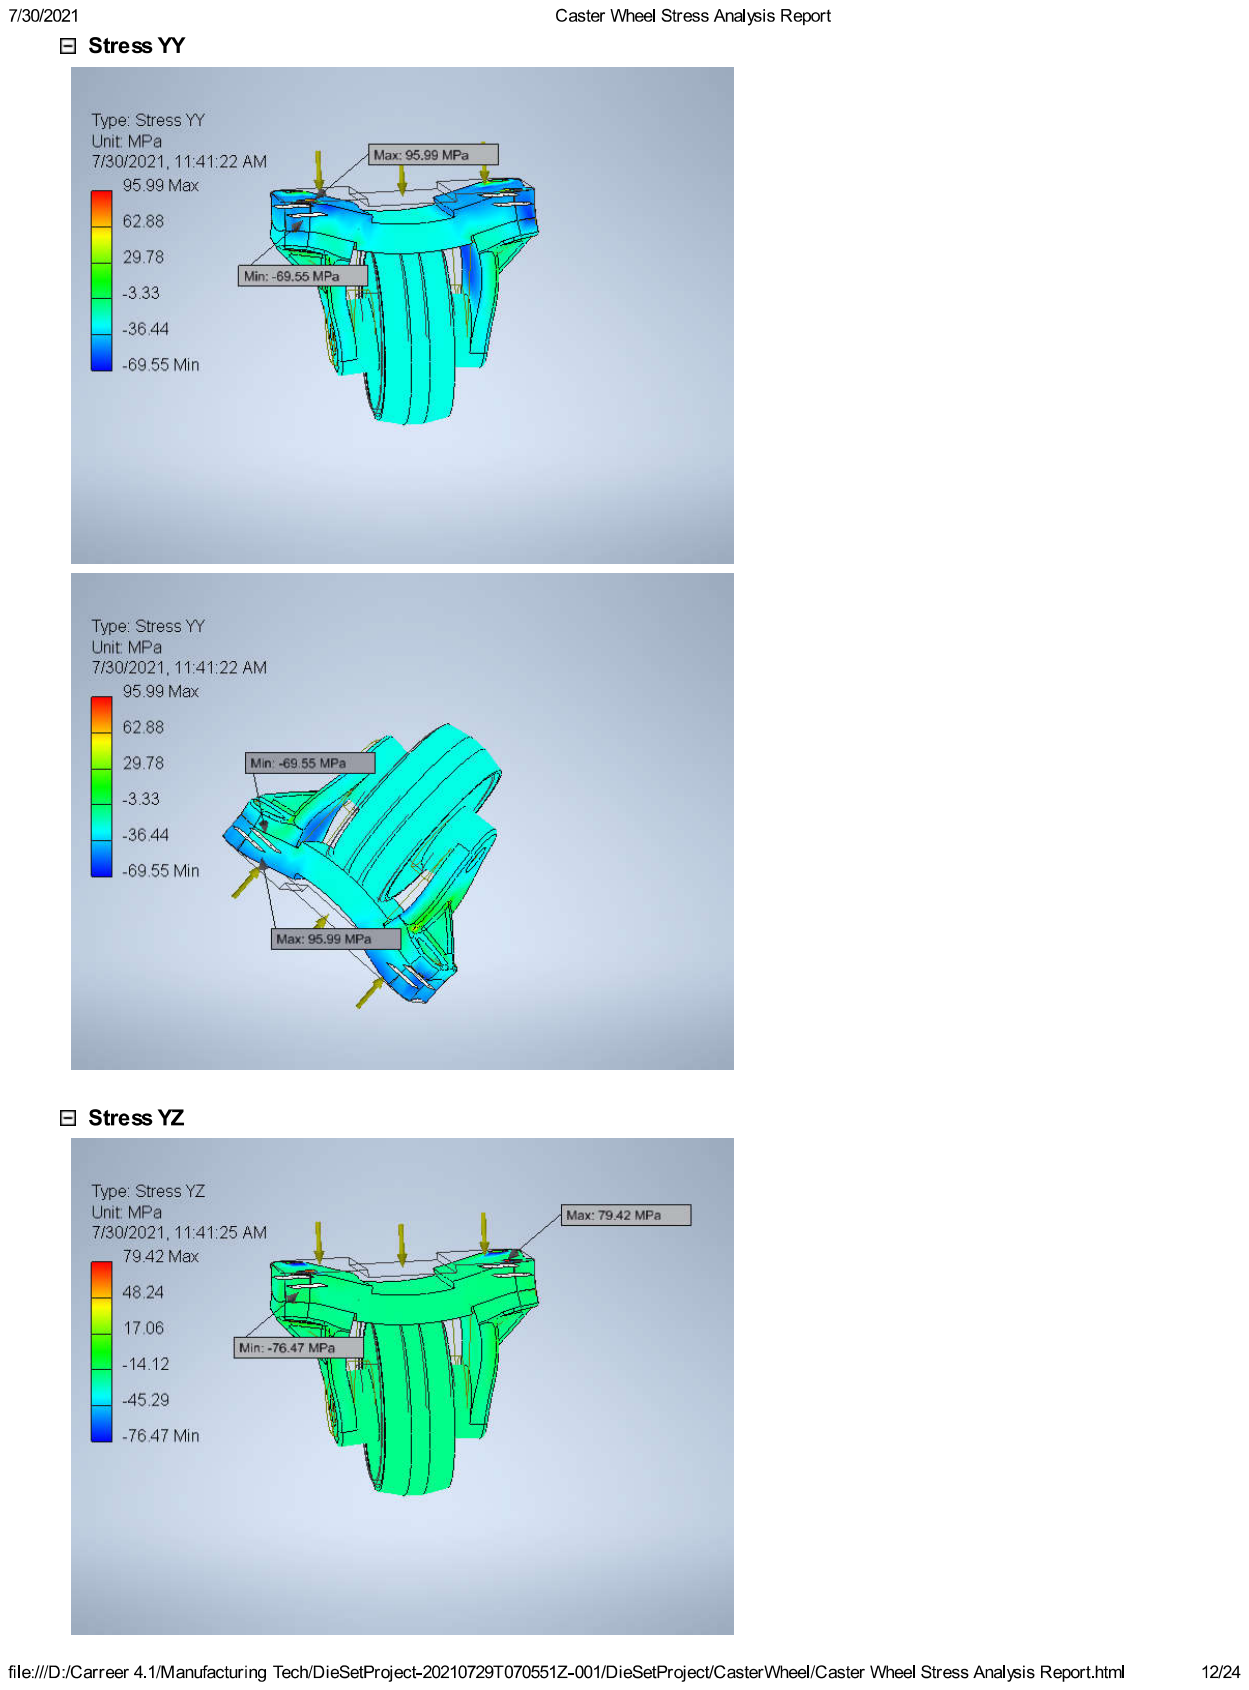
[picture p37: page 12]

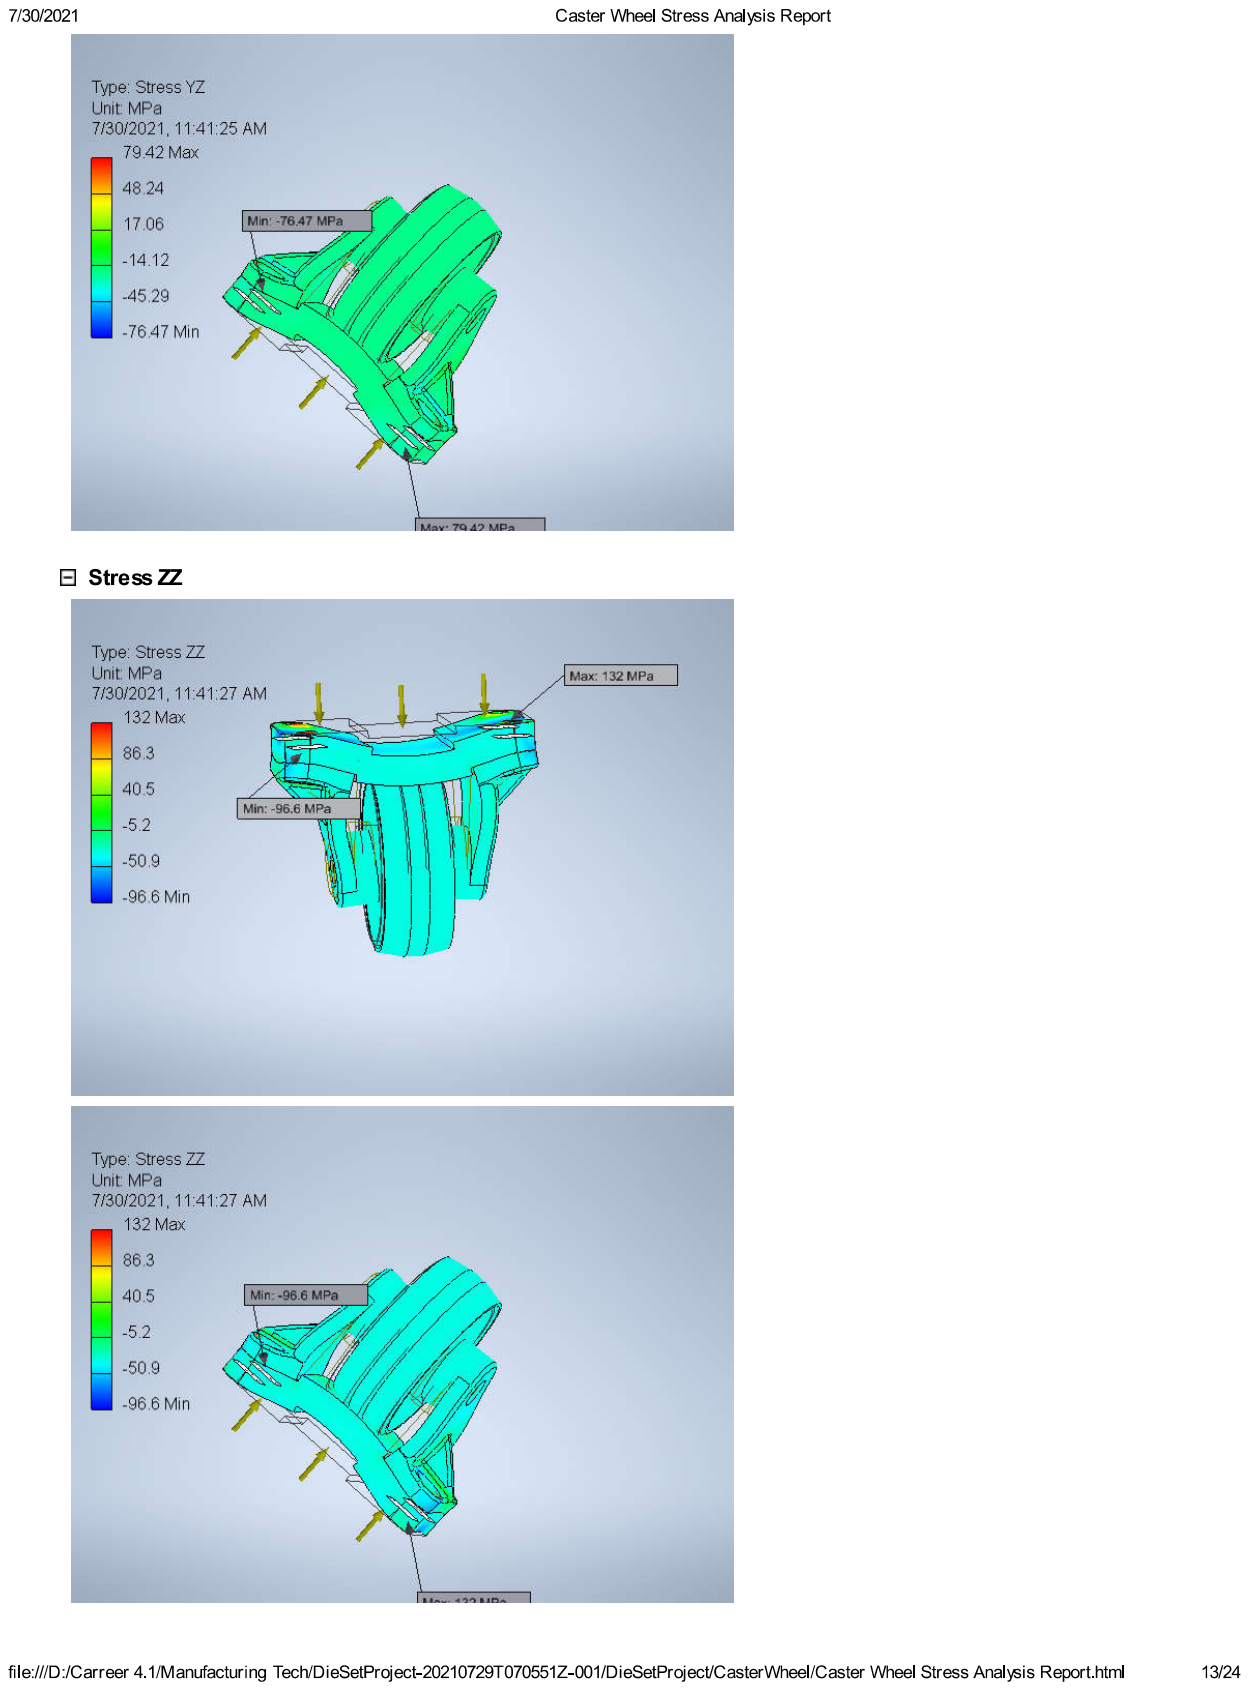
[picture p38: page 13]

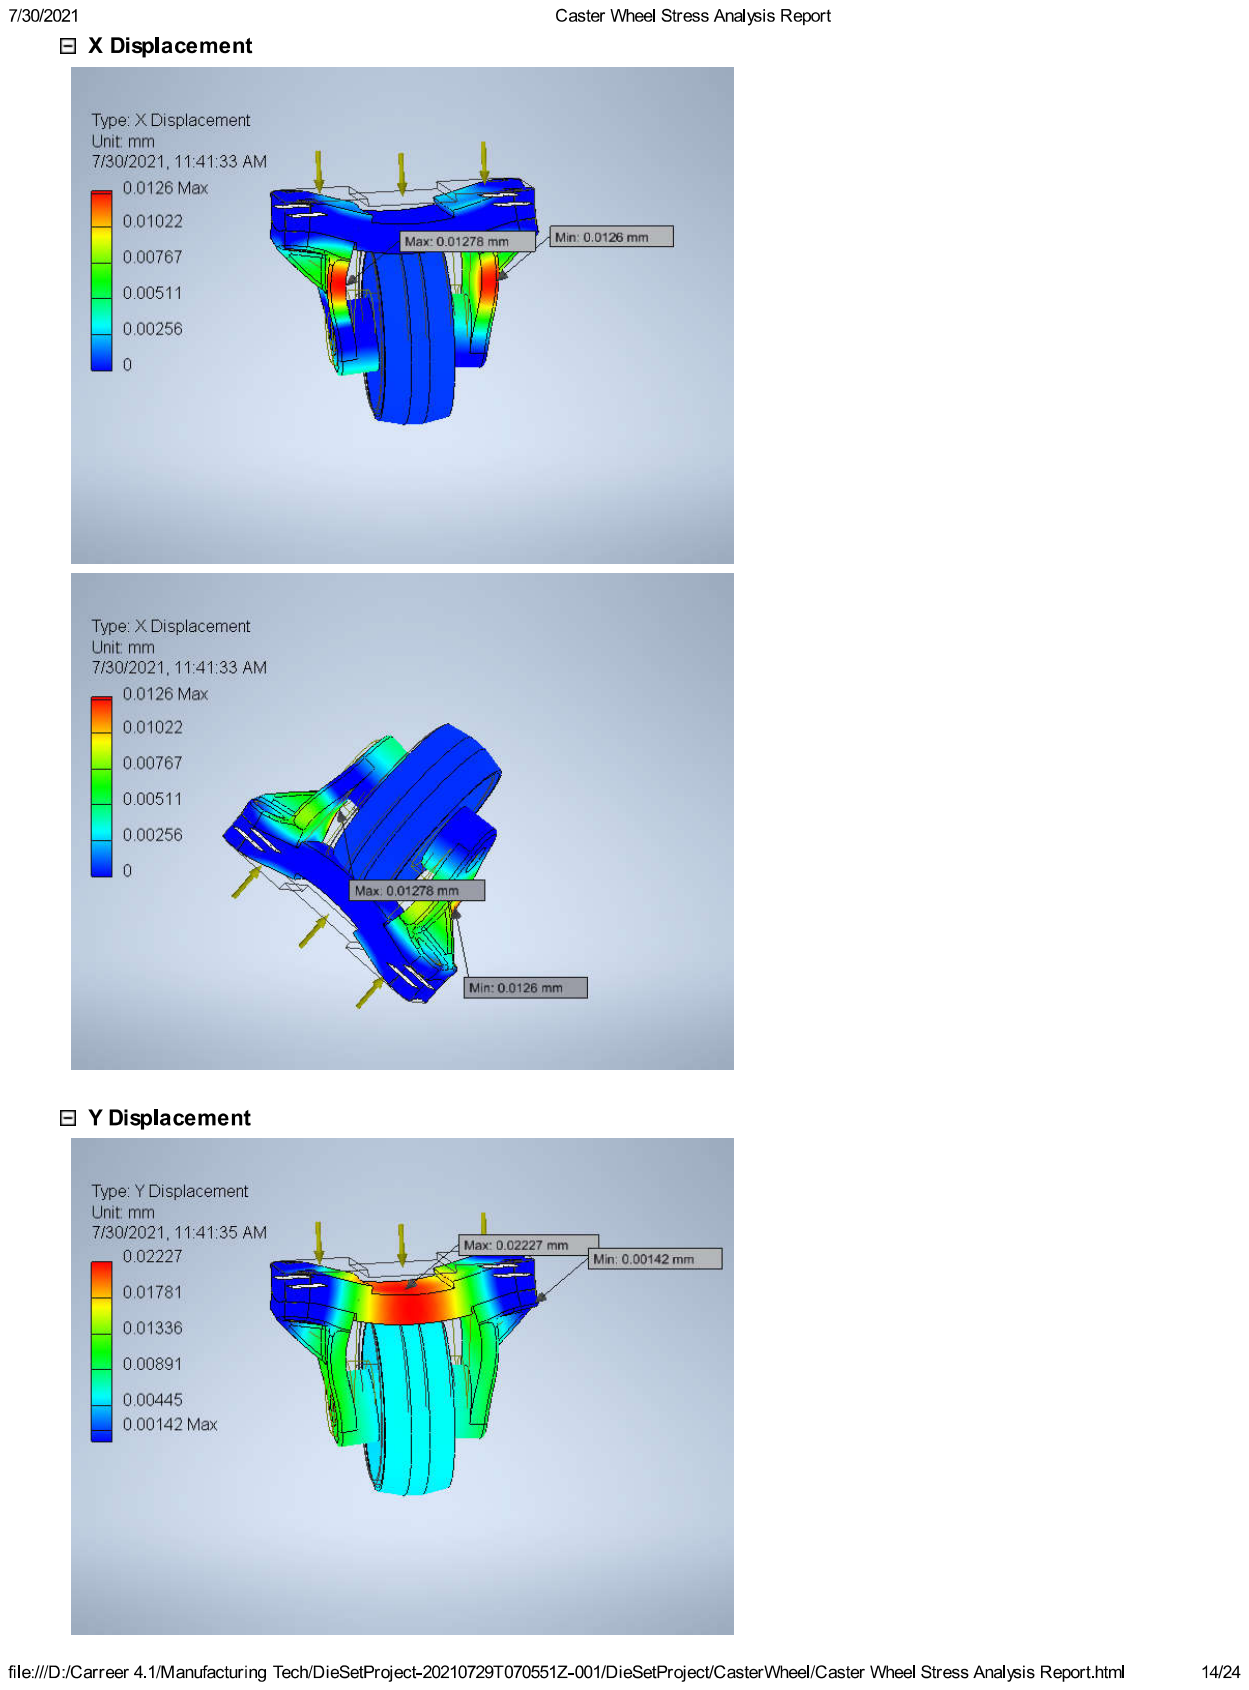
[picture p39: page 14]

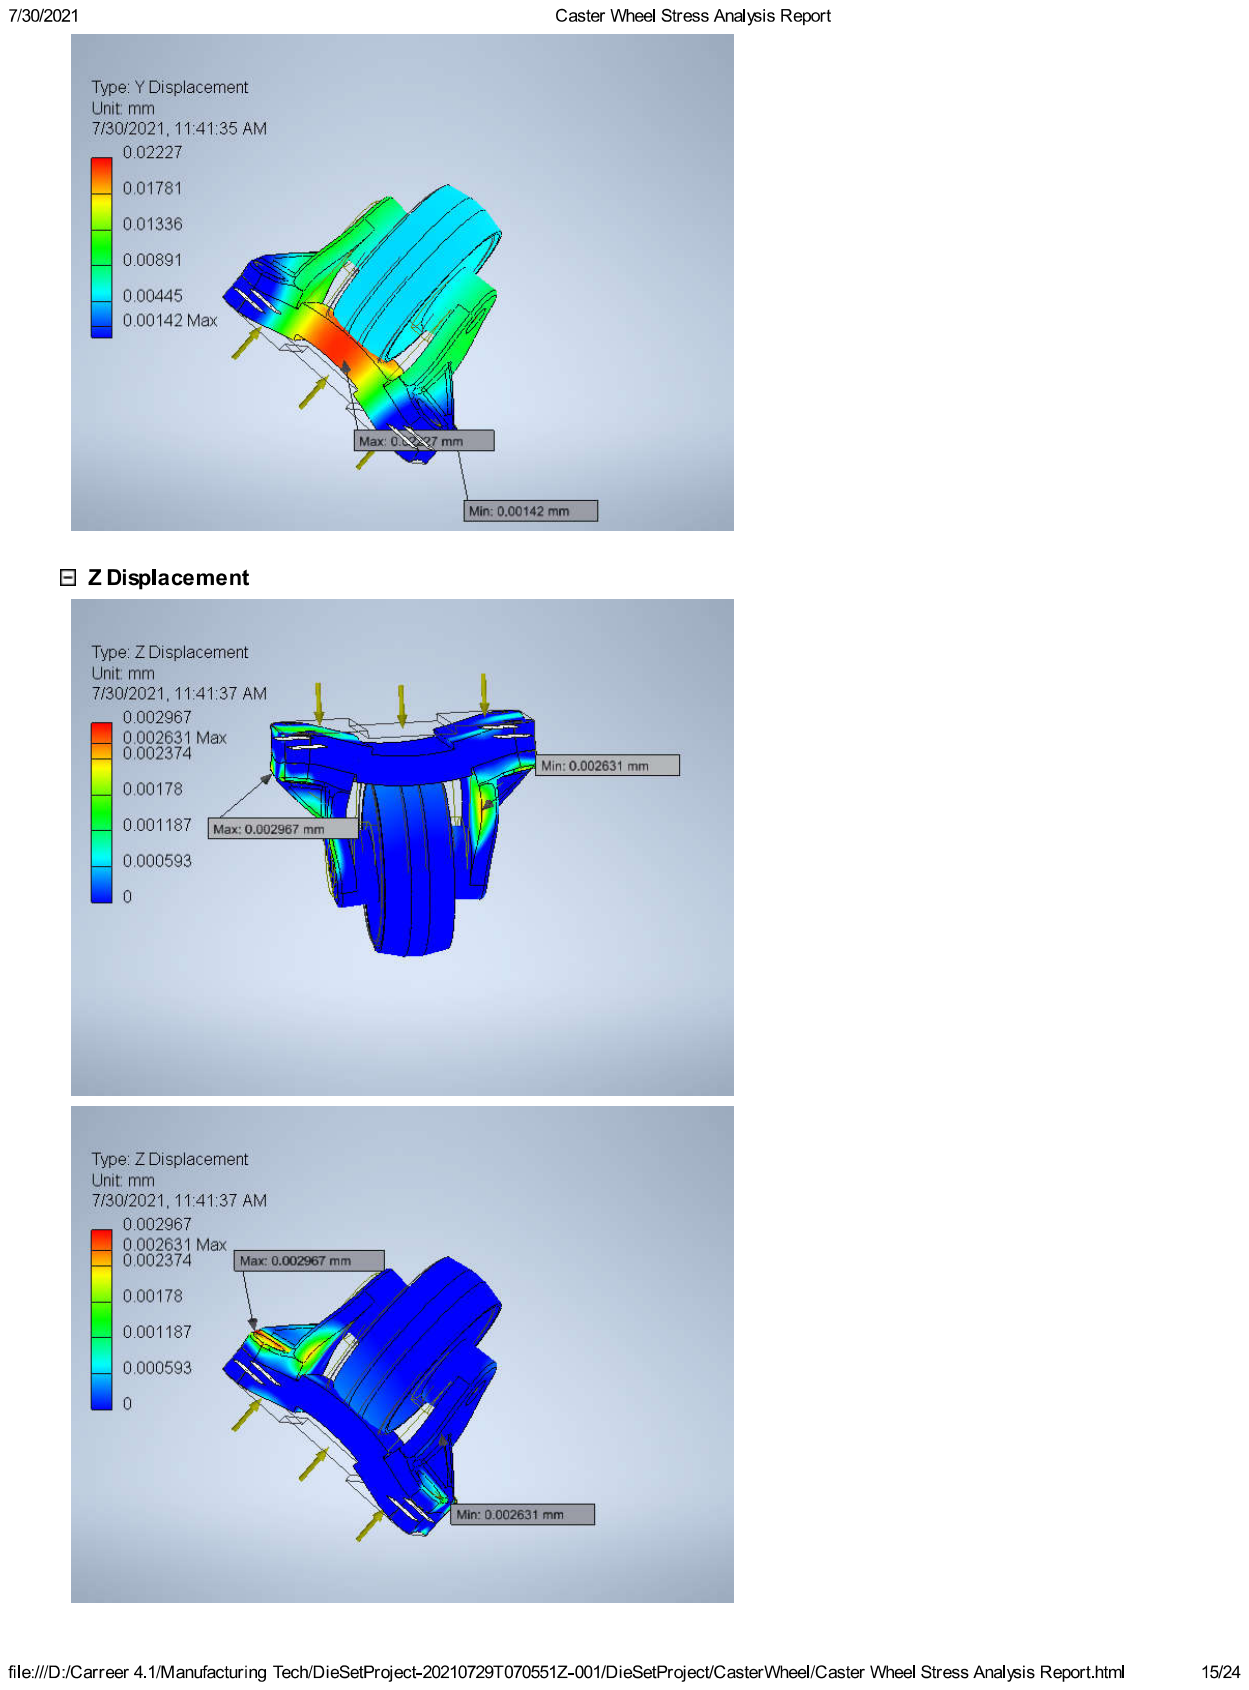
[picture p40: page 15]

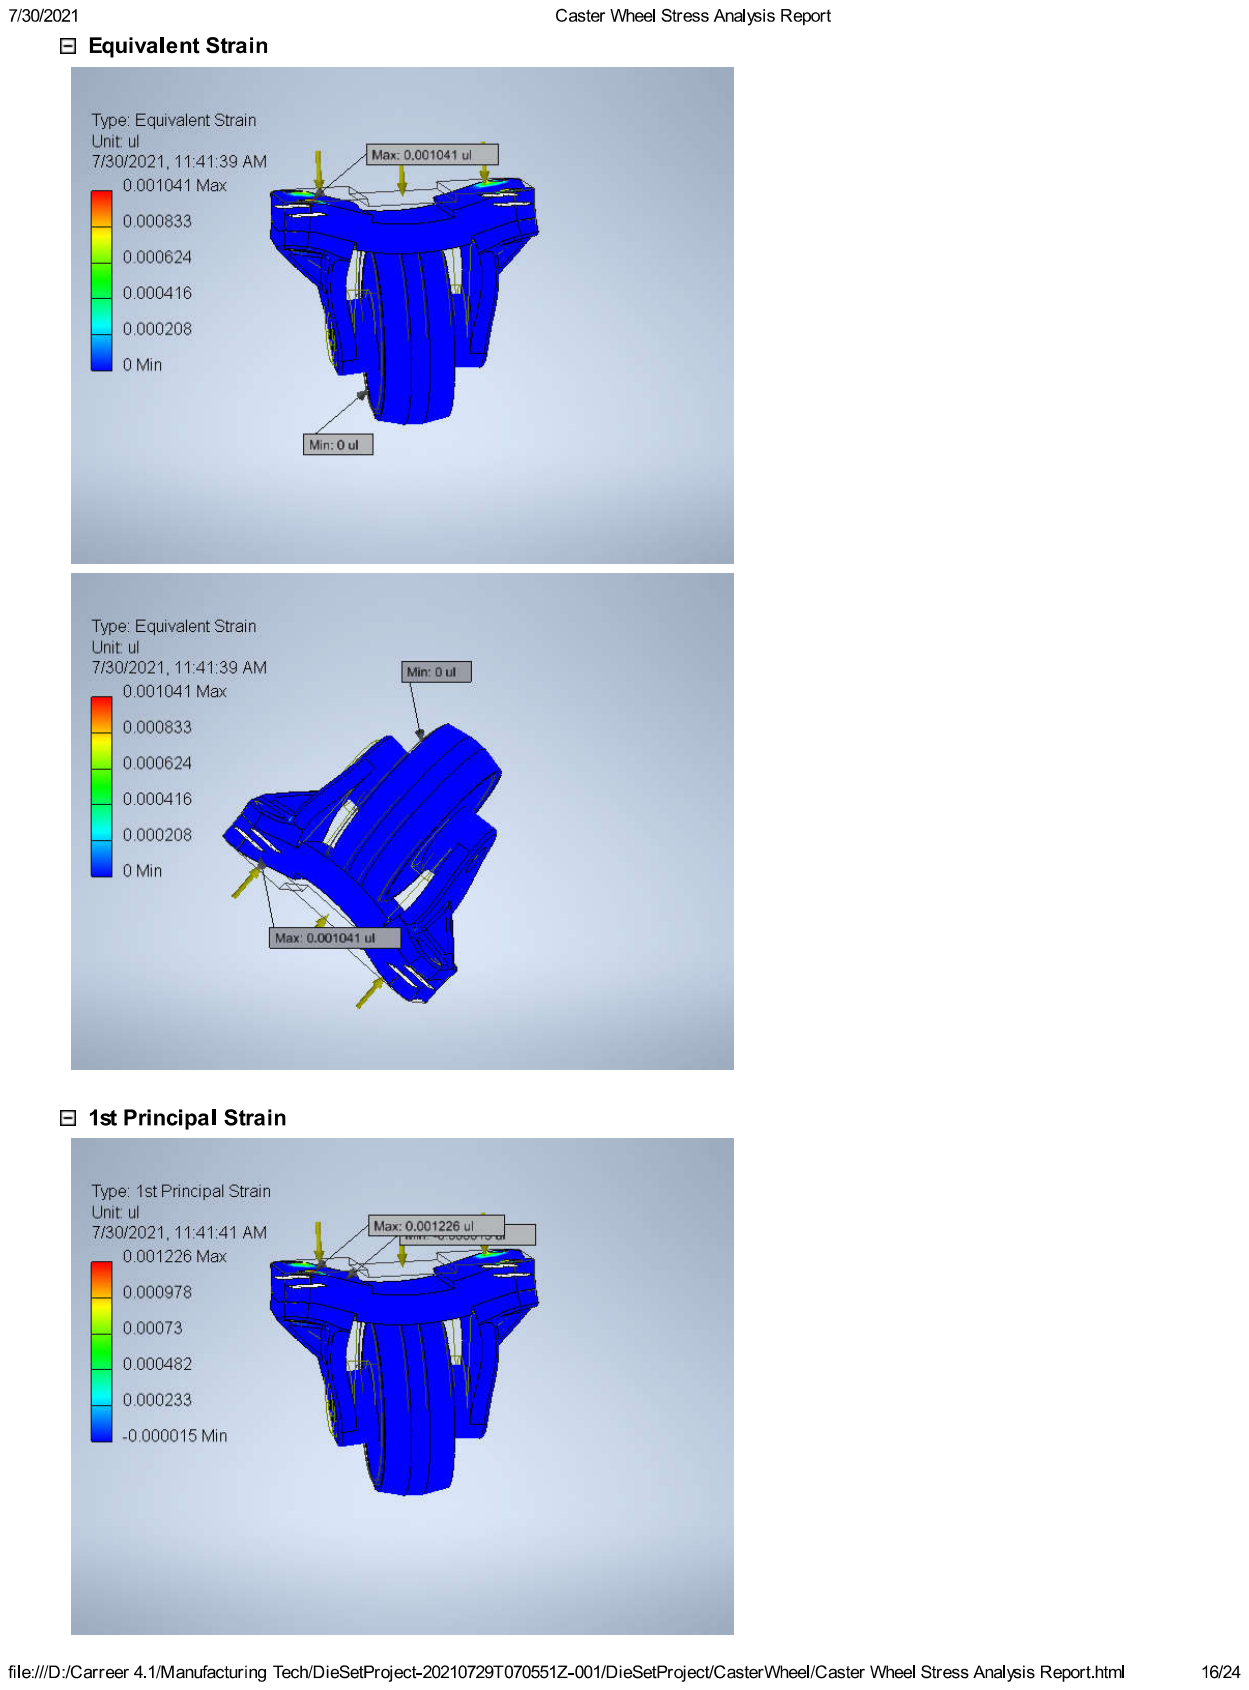
[picture p41: page 16]

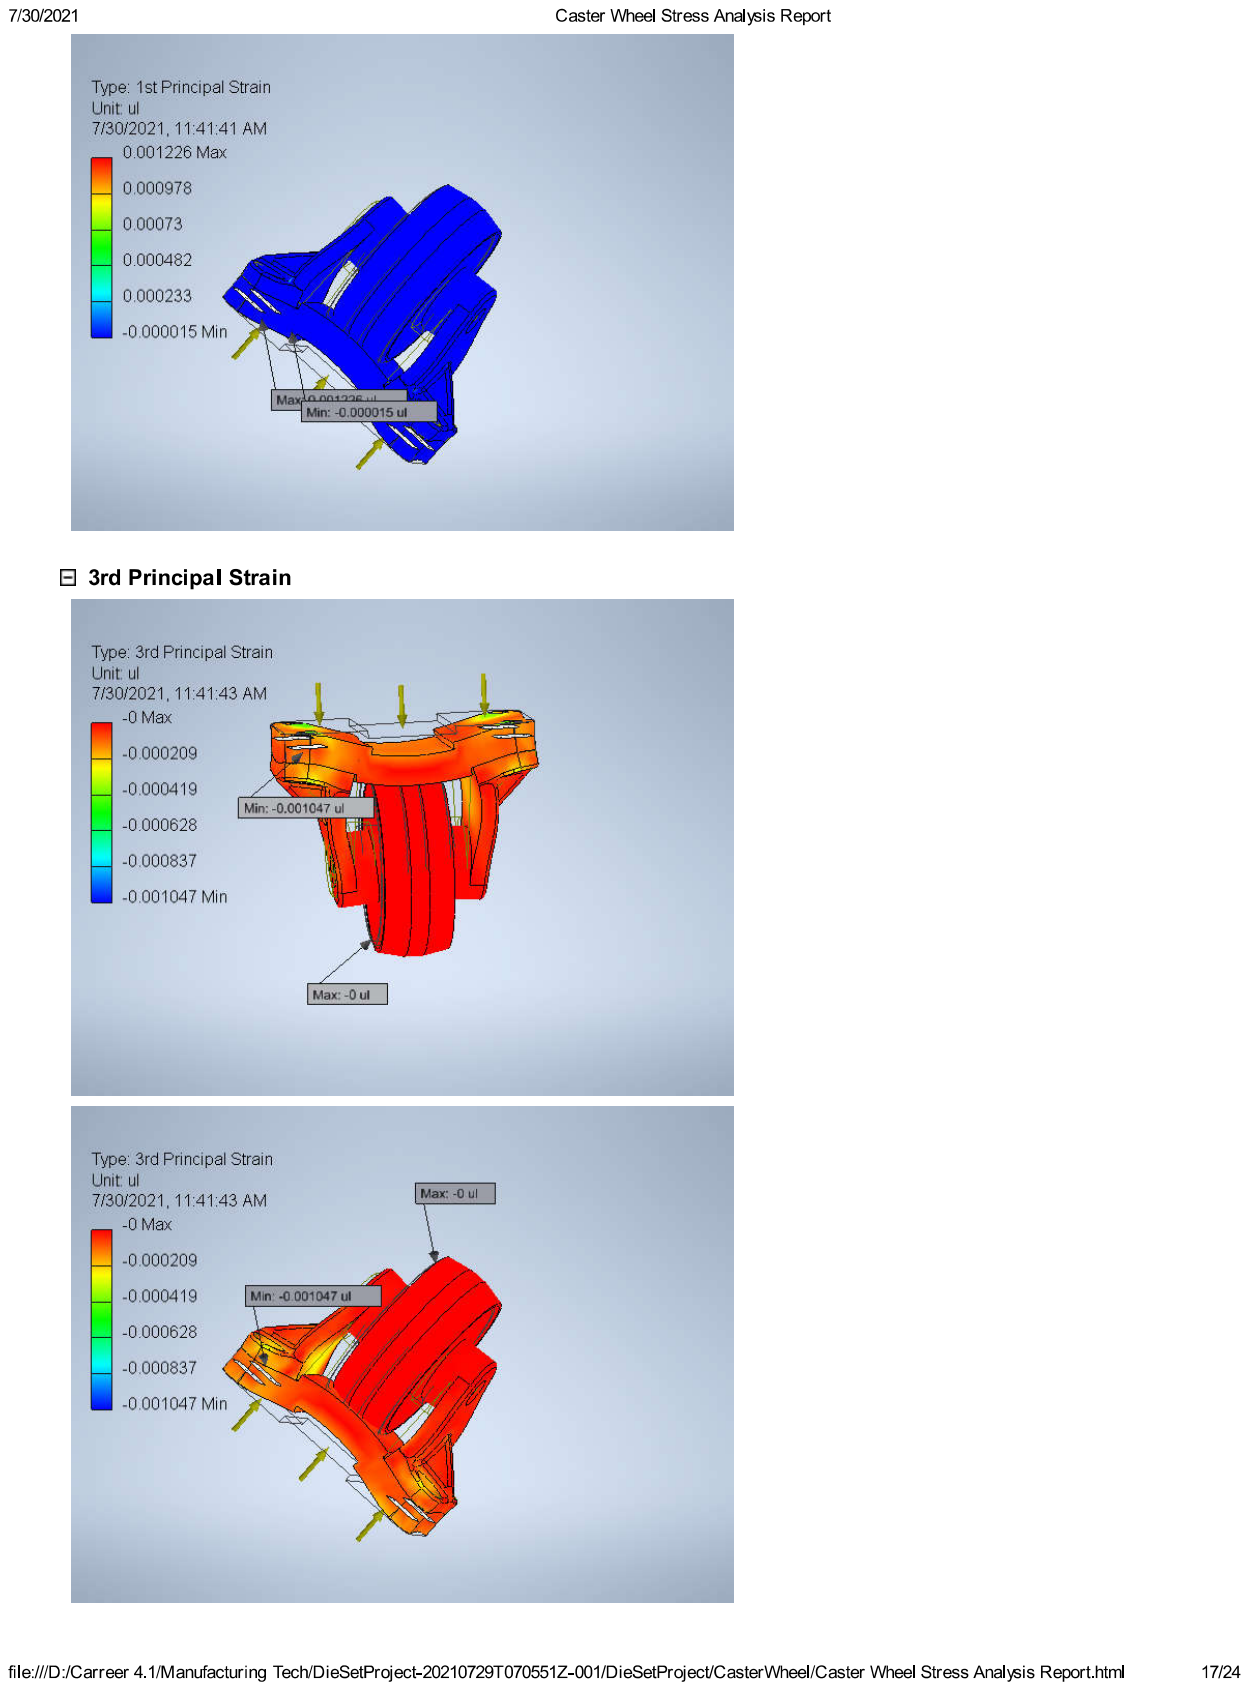
[picture p42: page 17]

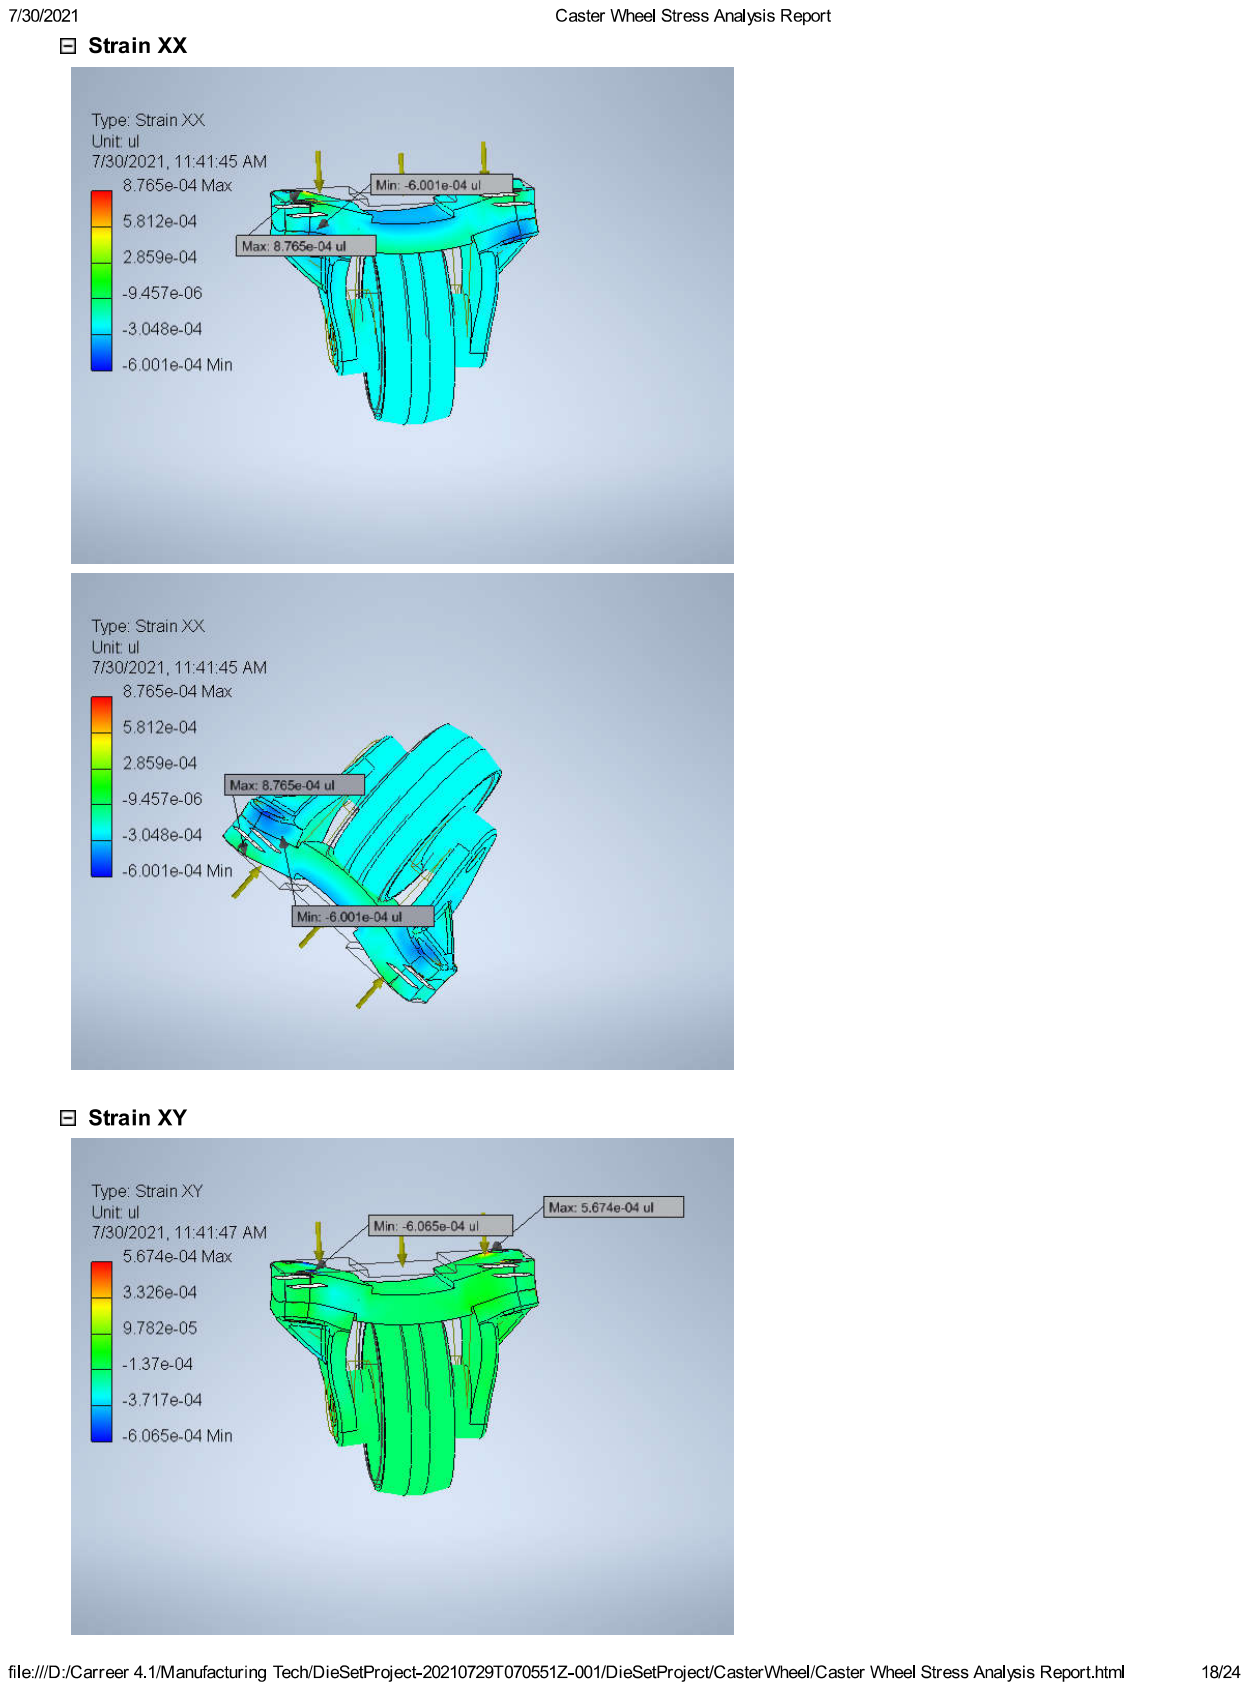
[picture p43: page 18]

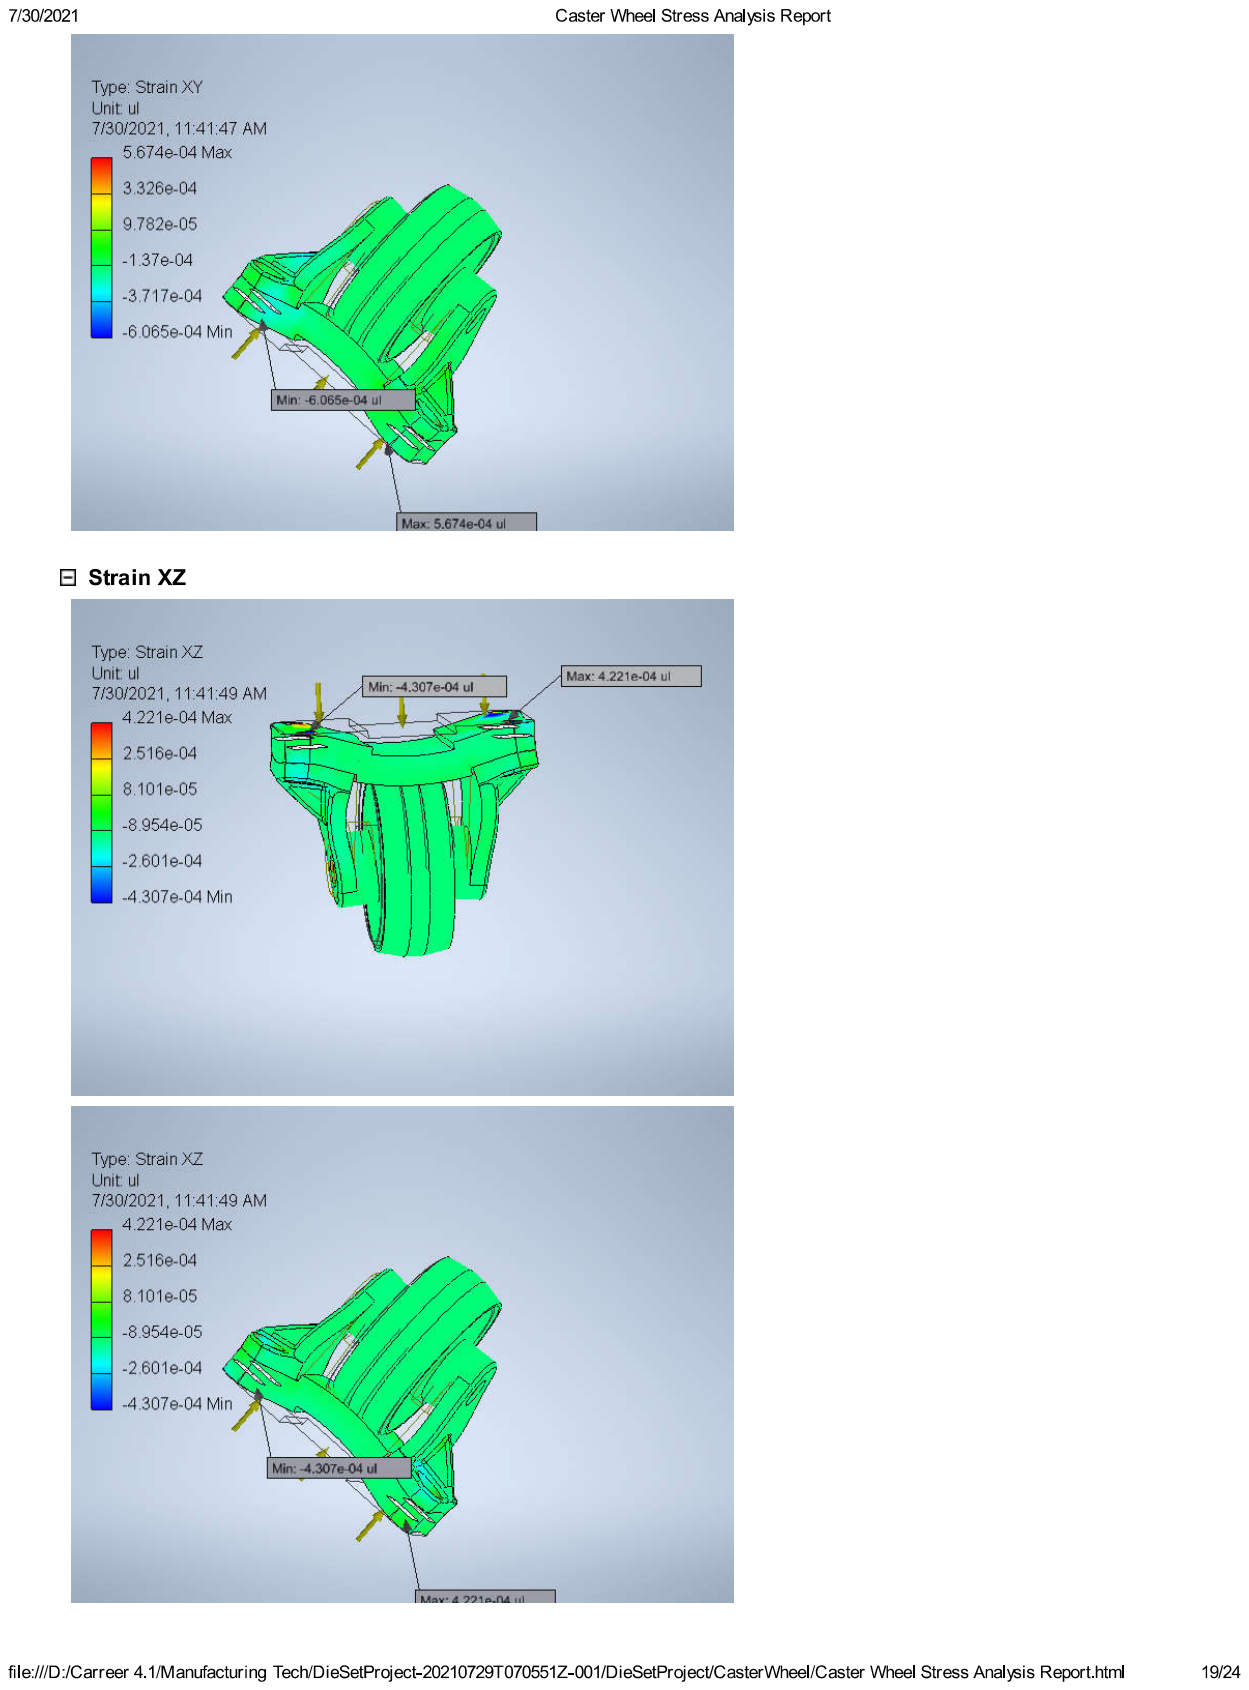
[picture p44: page 19]

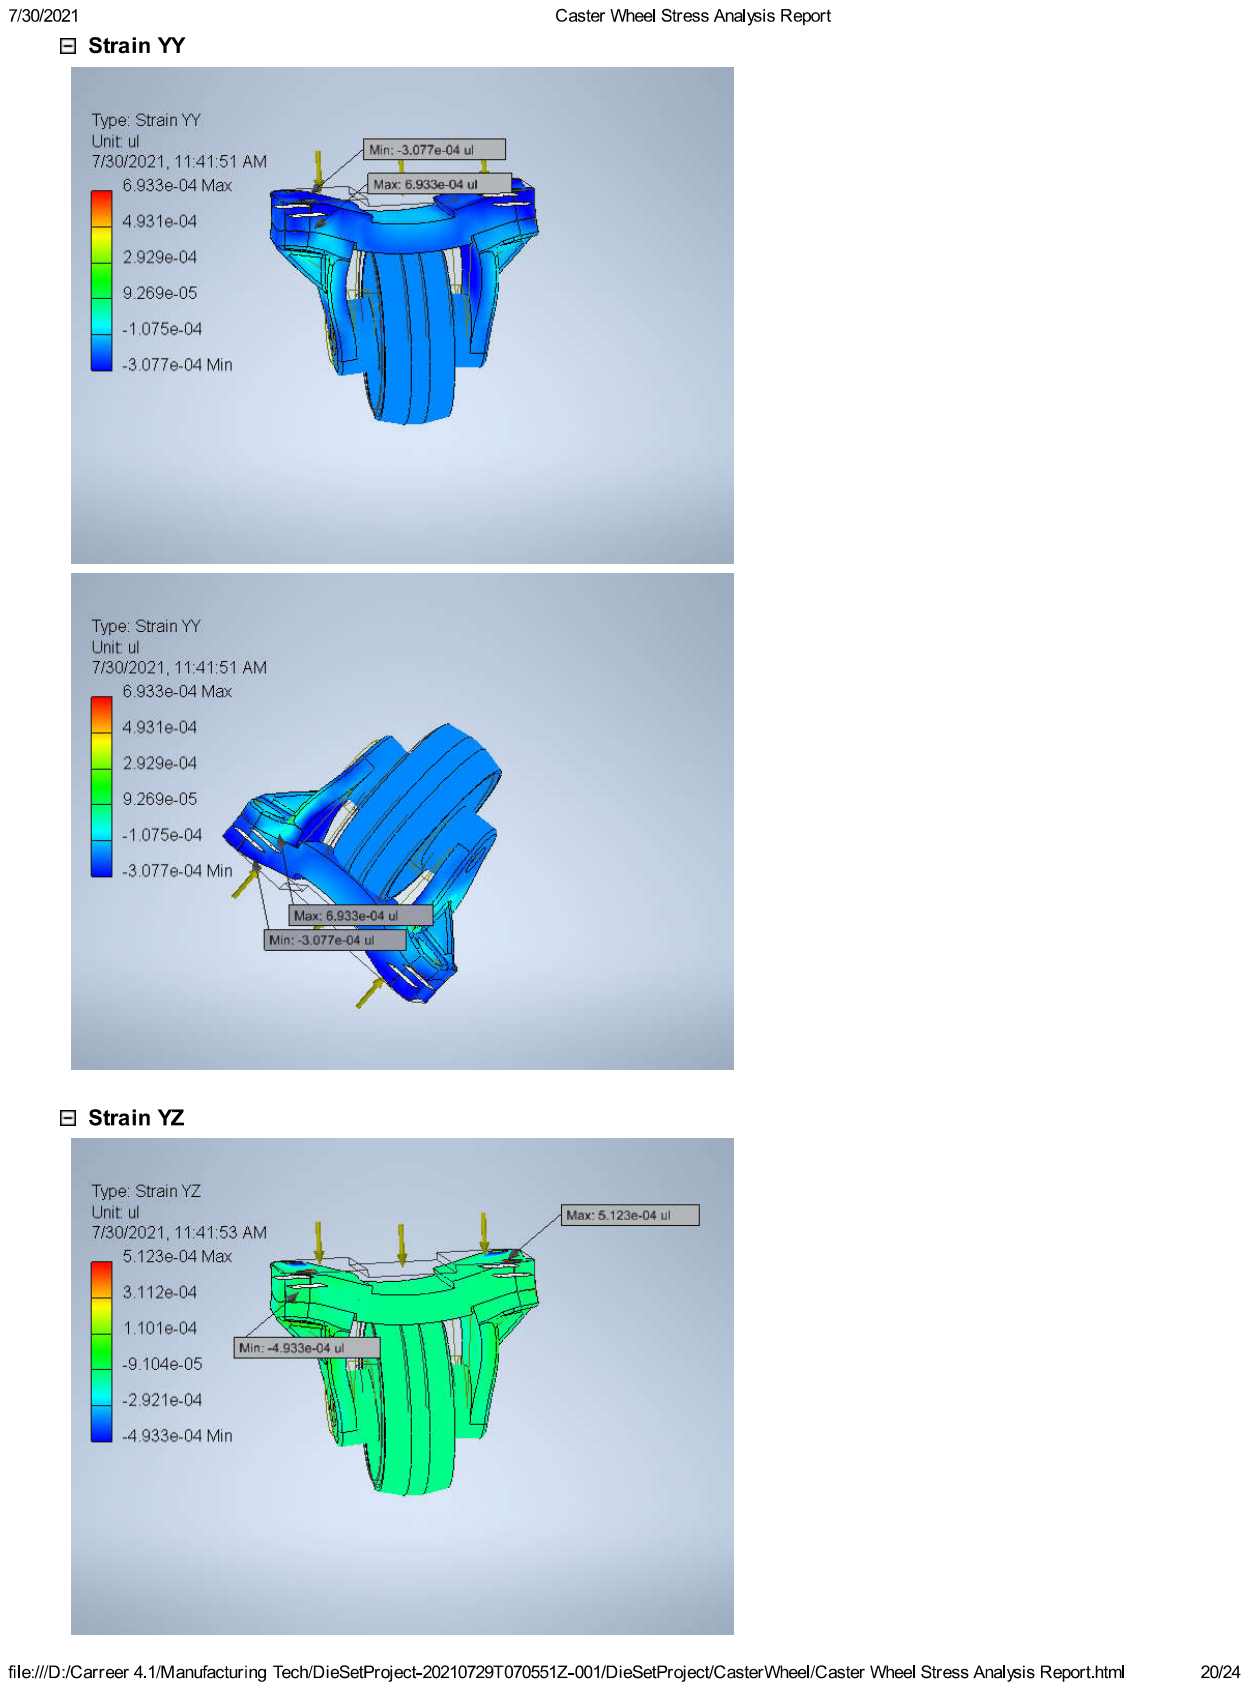
[picture p45: page 20]

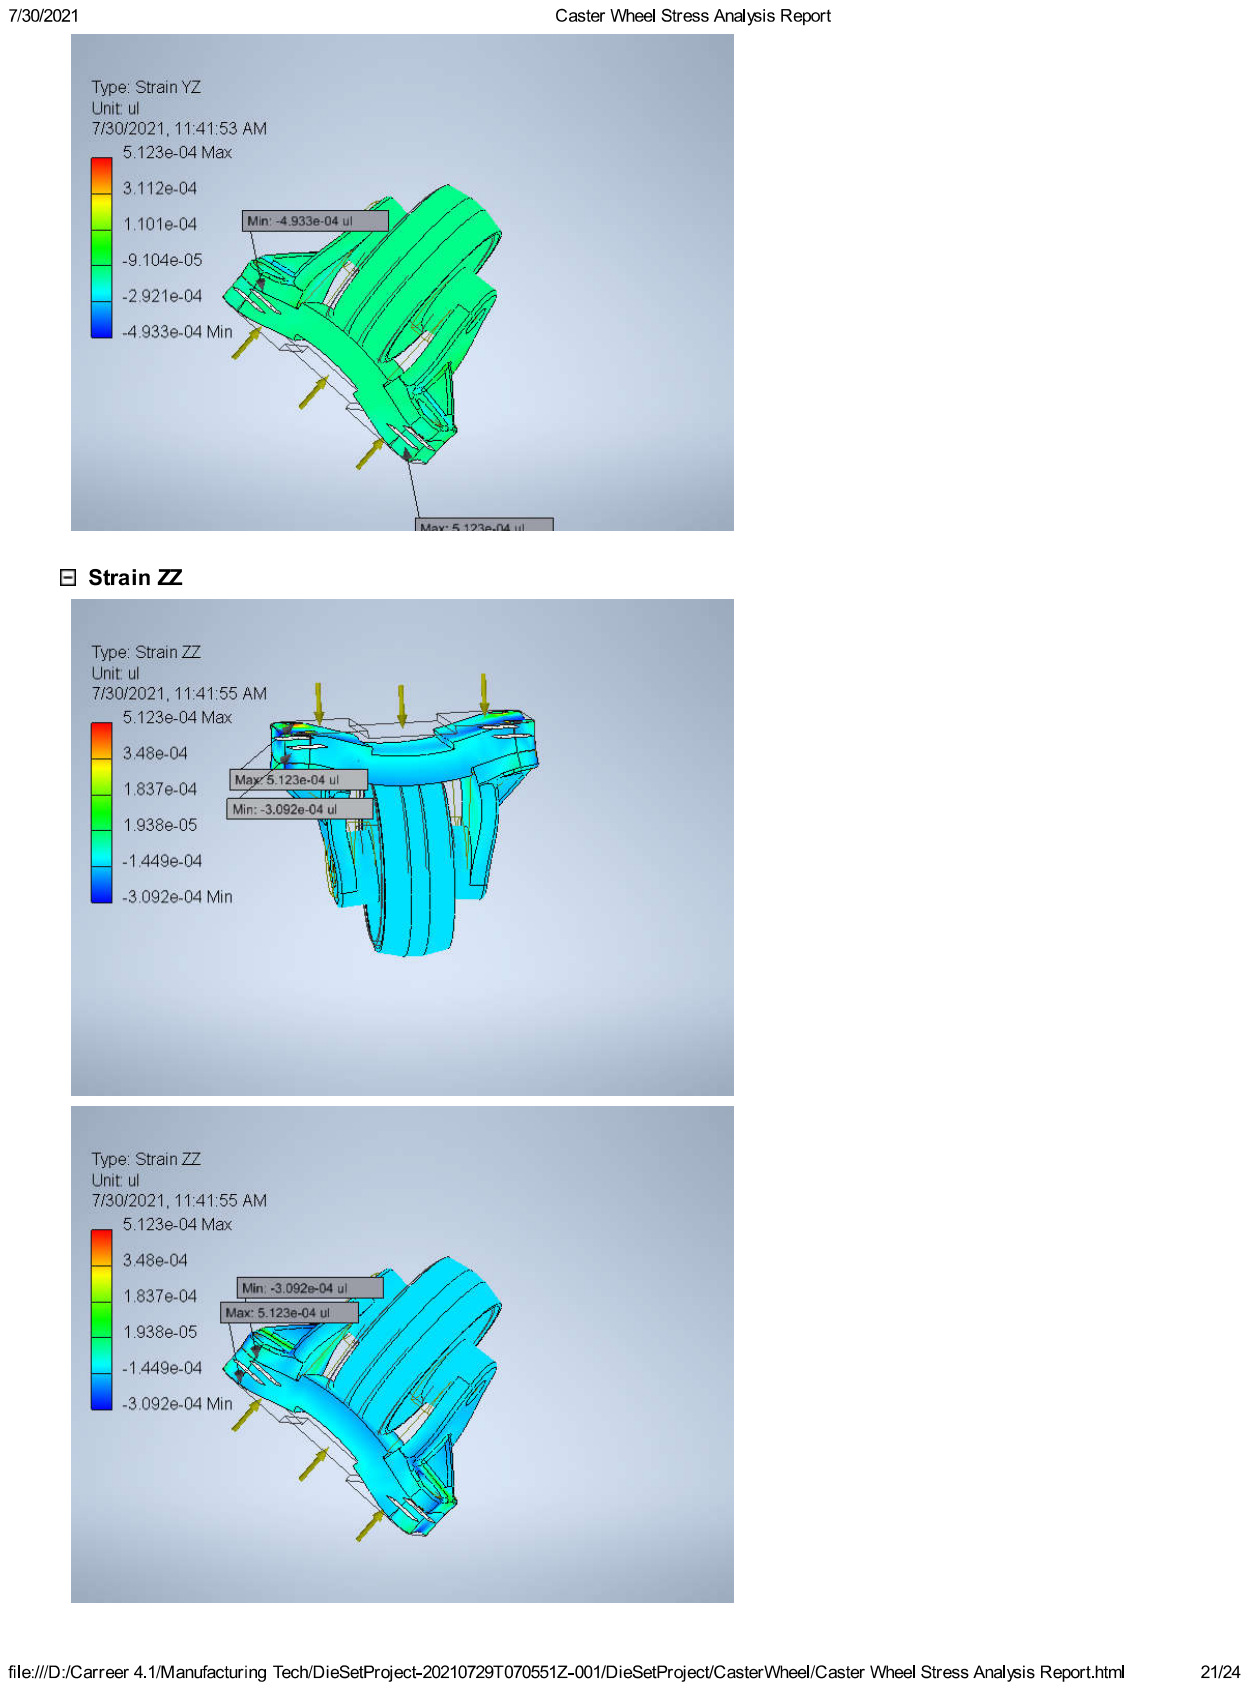
[picture p46: page 21]

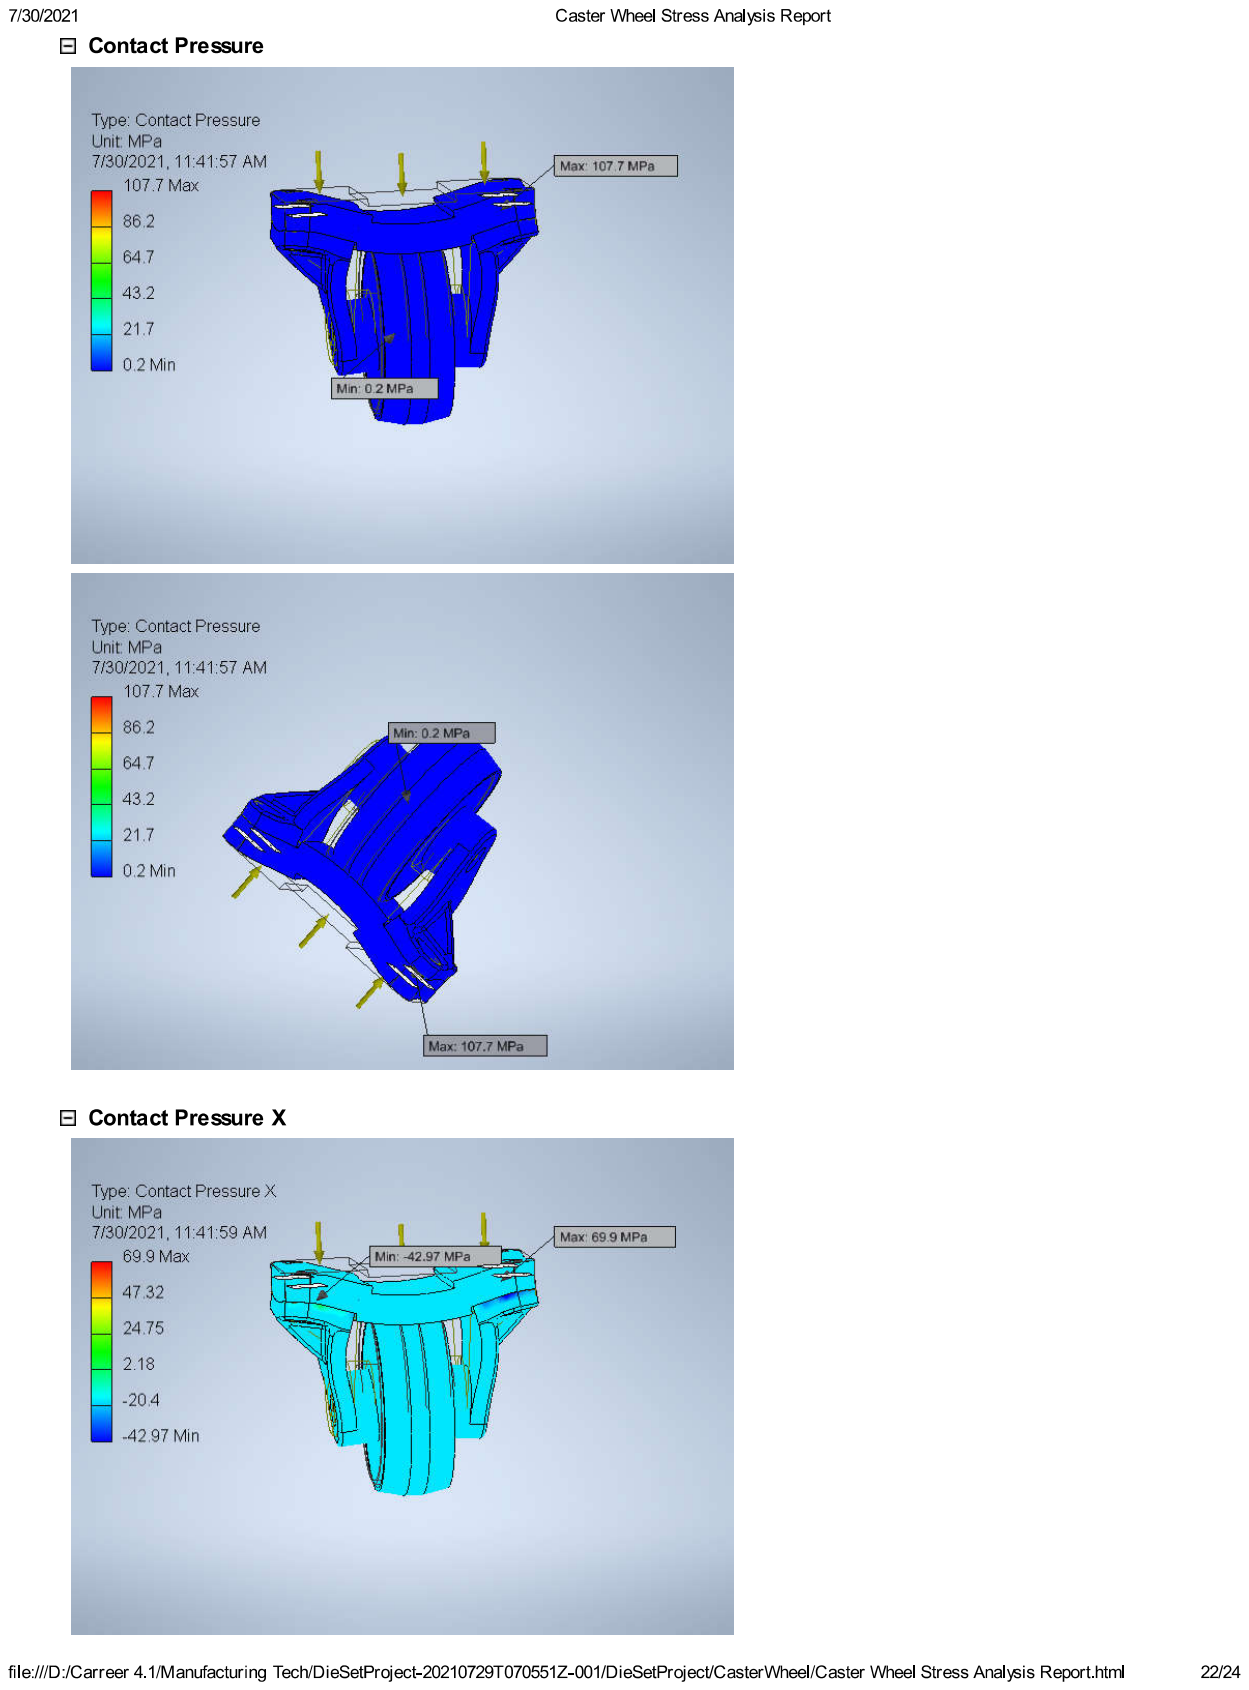
[picture p47: page 22]

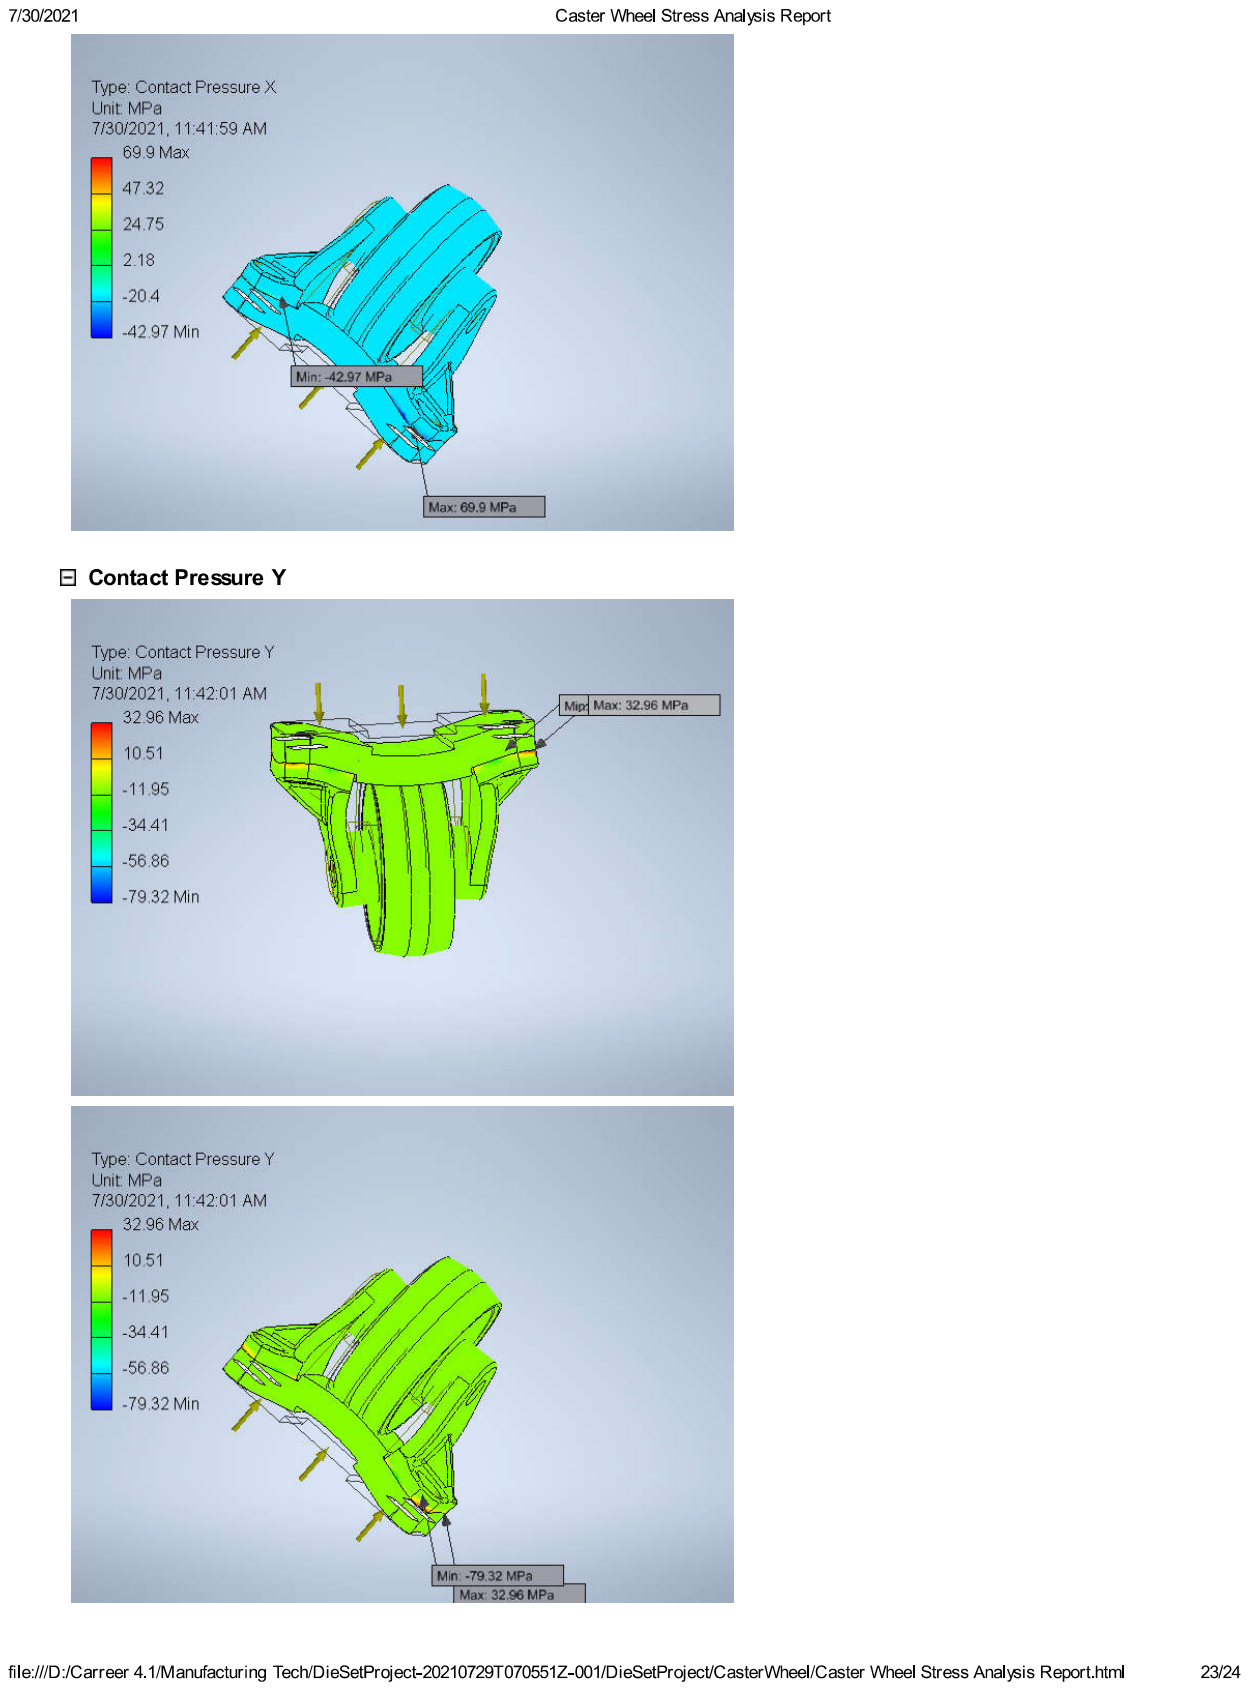
[picture p48: page 23]

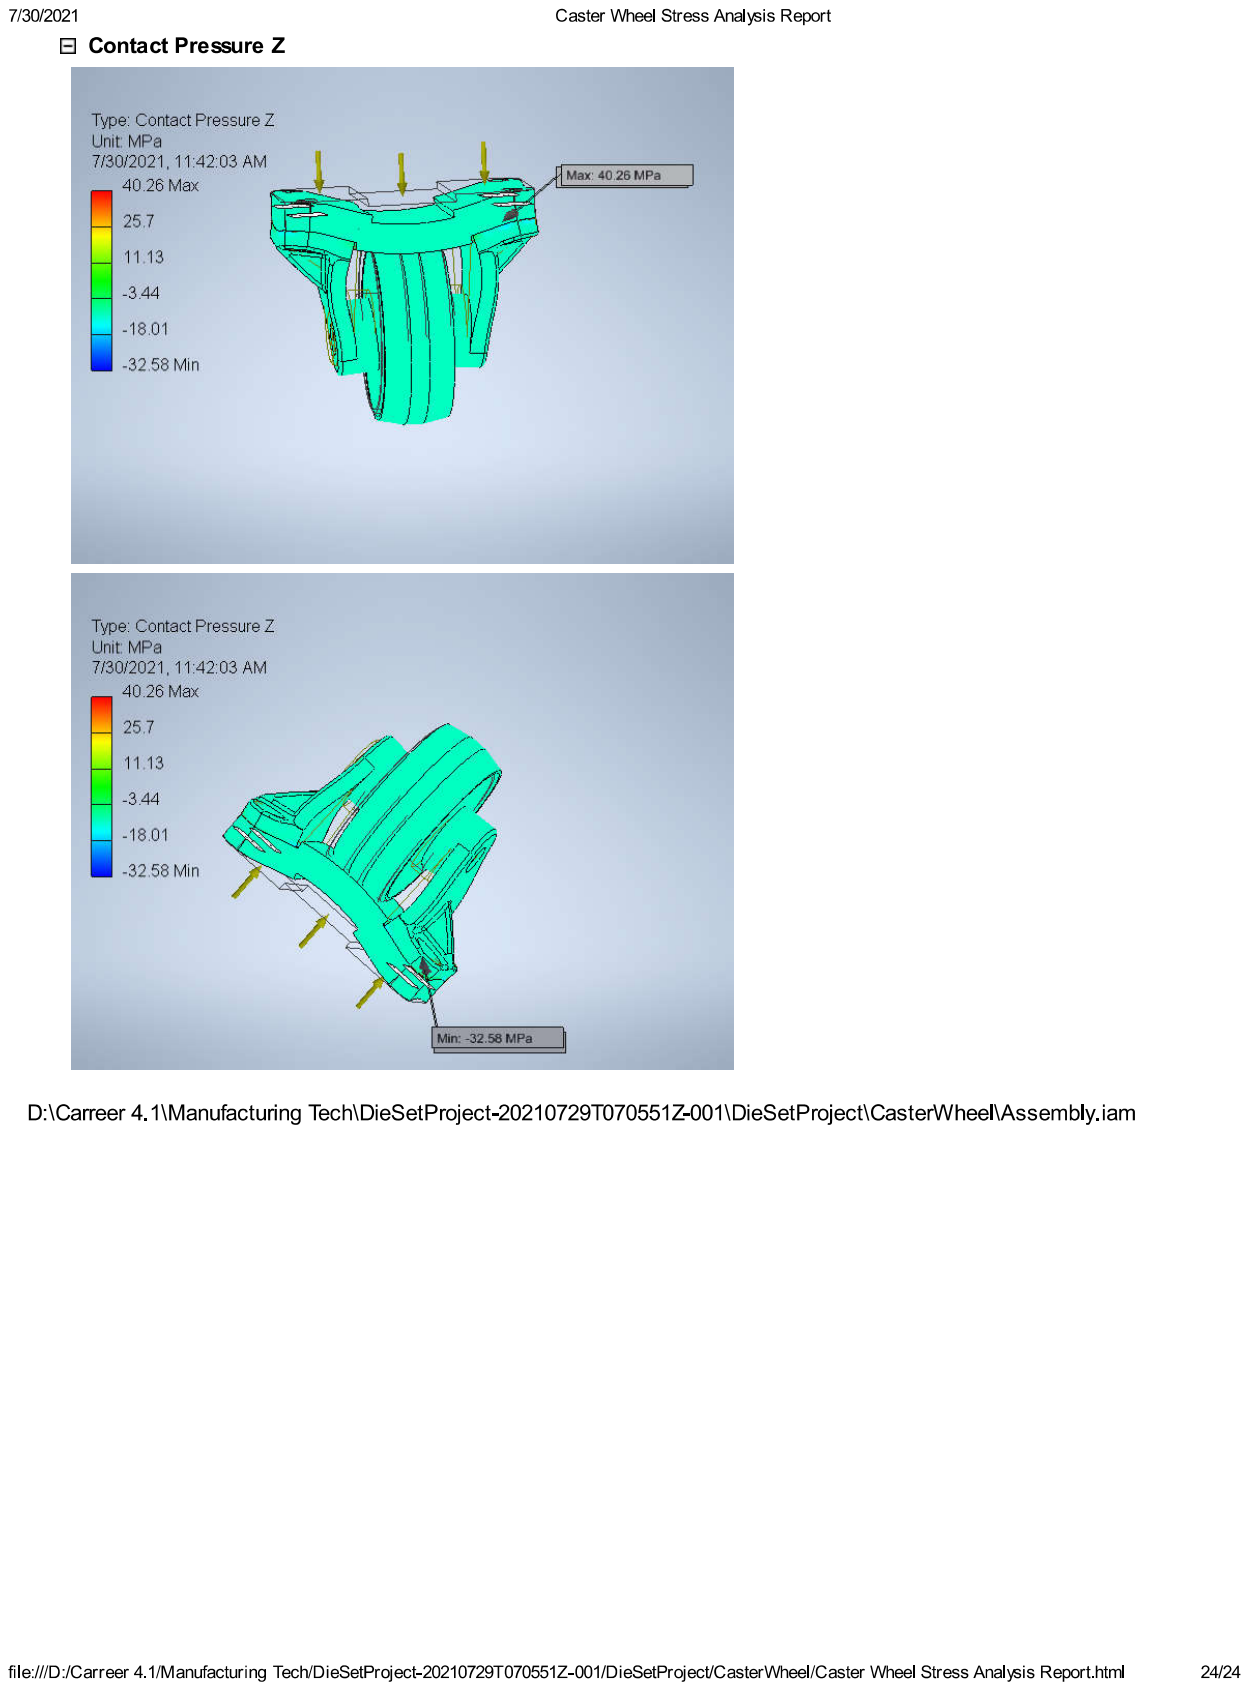
[picture p49: page 24]
