EricoDeMecha/Die-Set/Reports/DieSetAnalysisReports/High carbon steel Top Plate Analysis Report.pdf

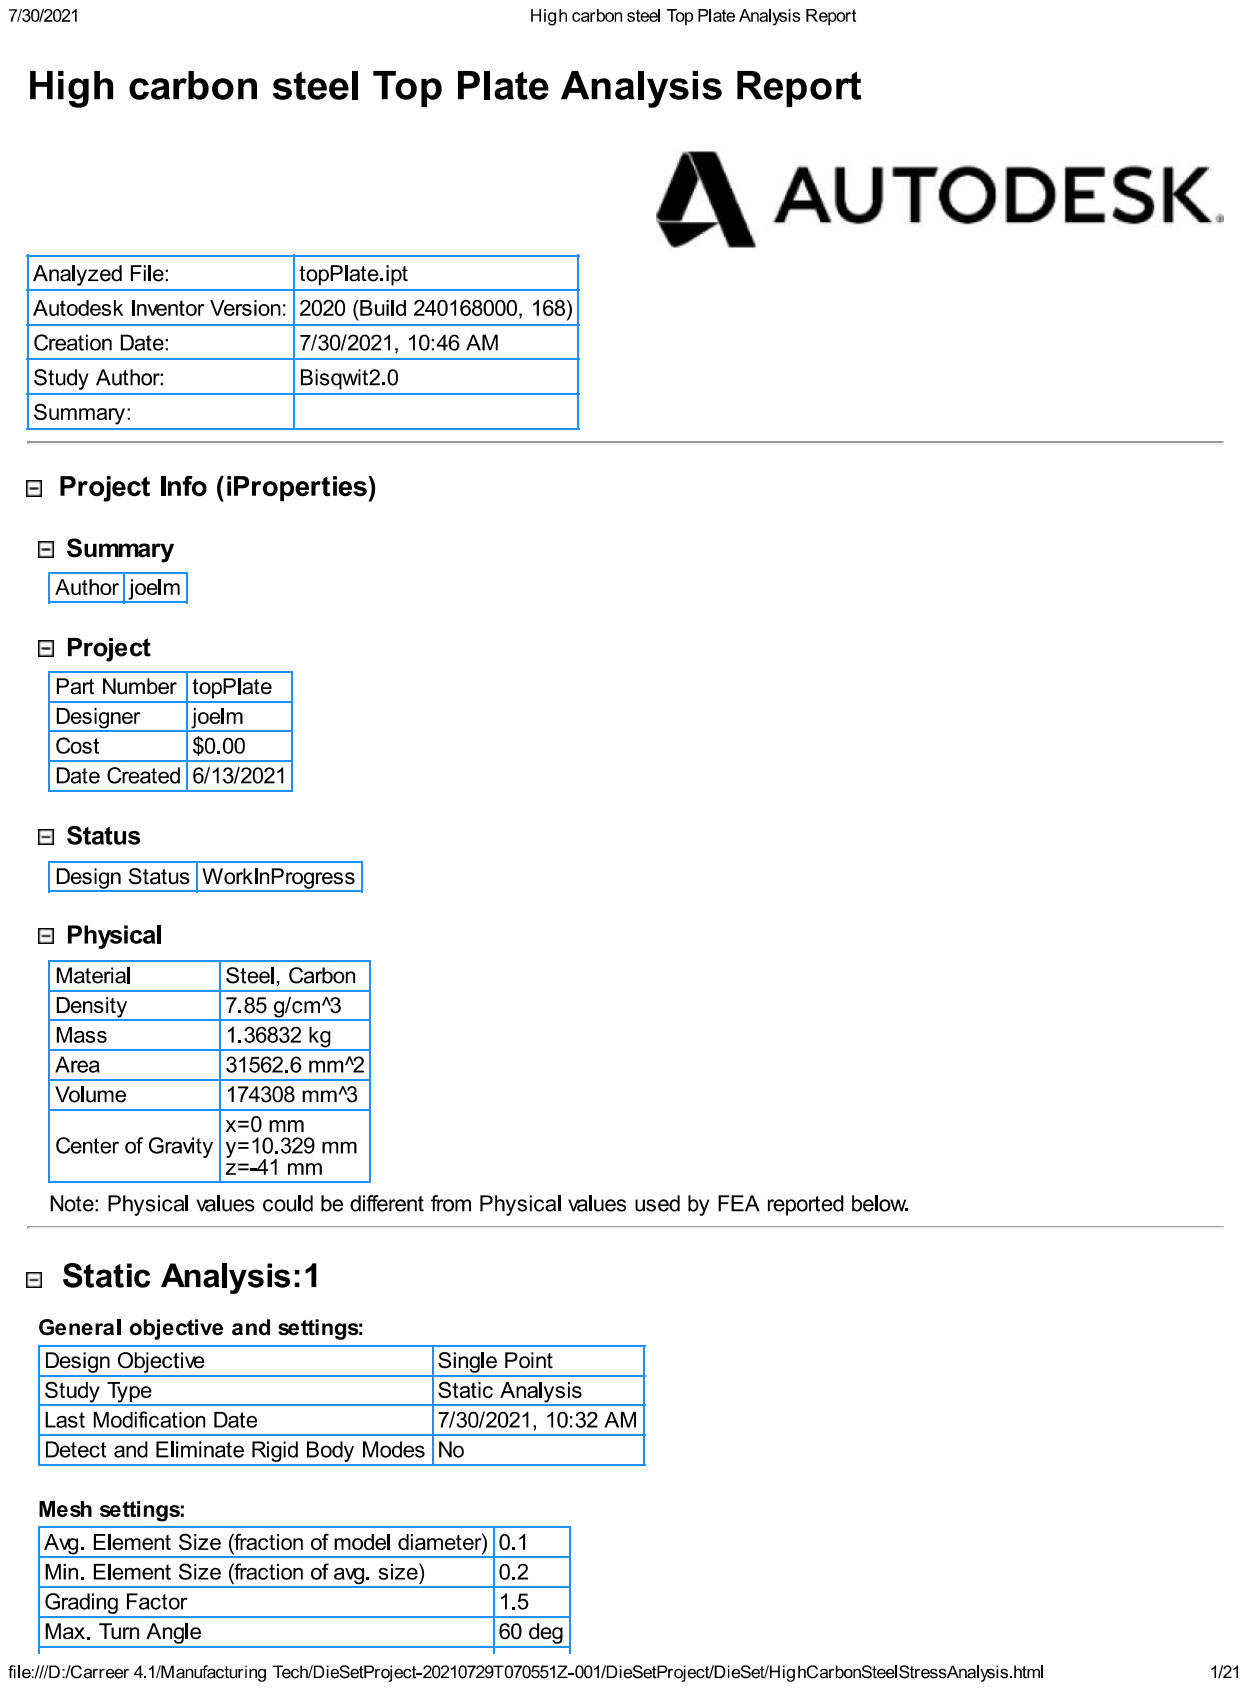
[picture p50: page 1]

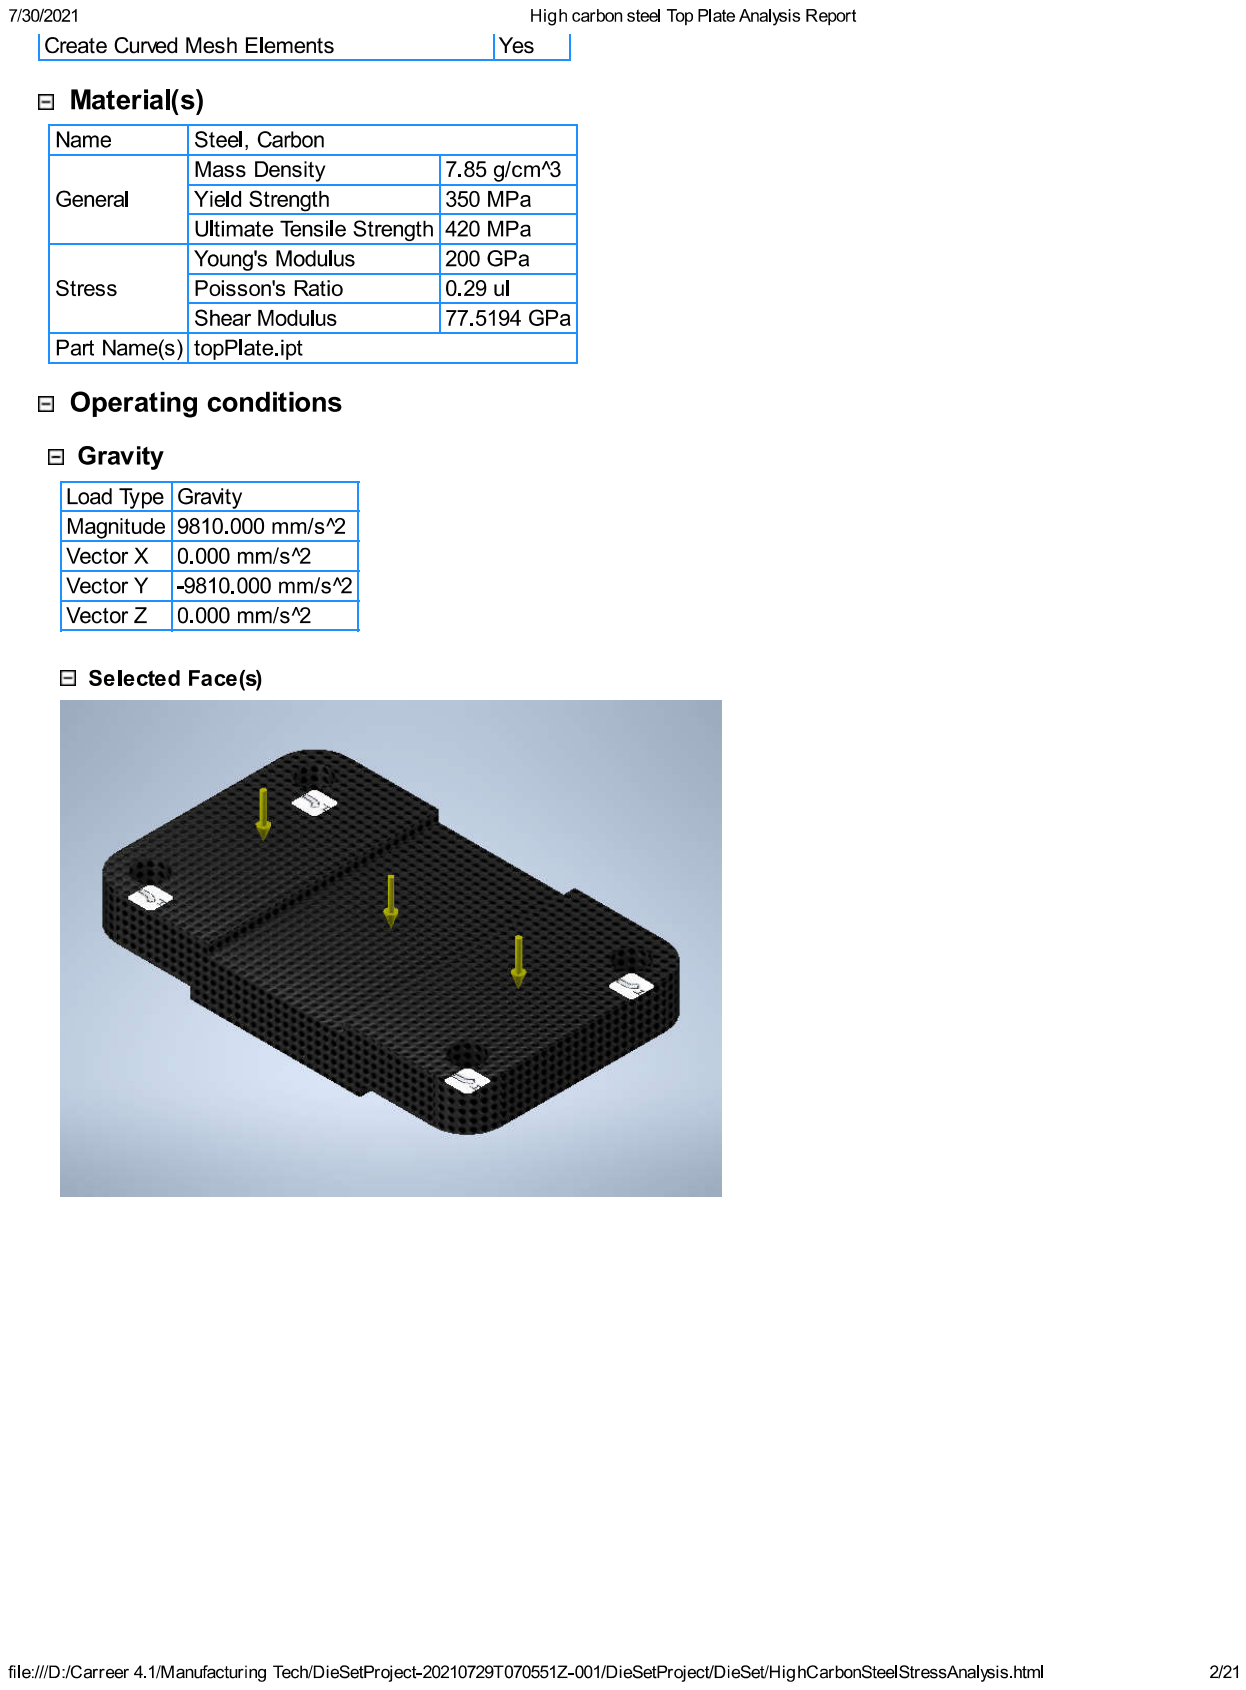
[picture p51: page 2]

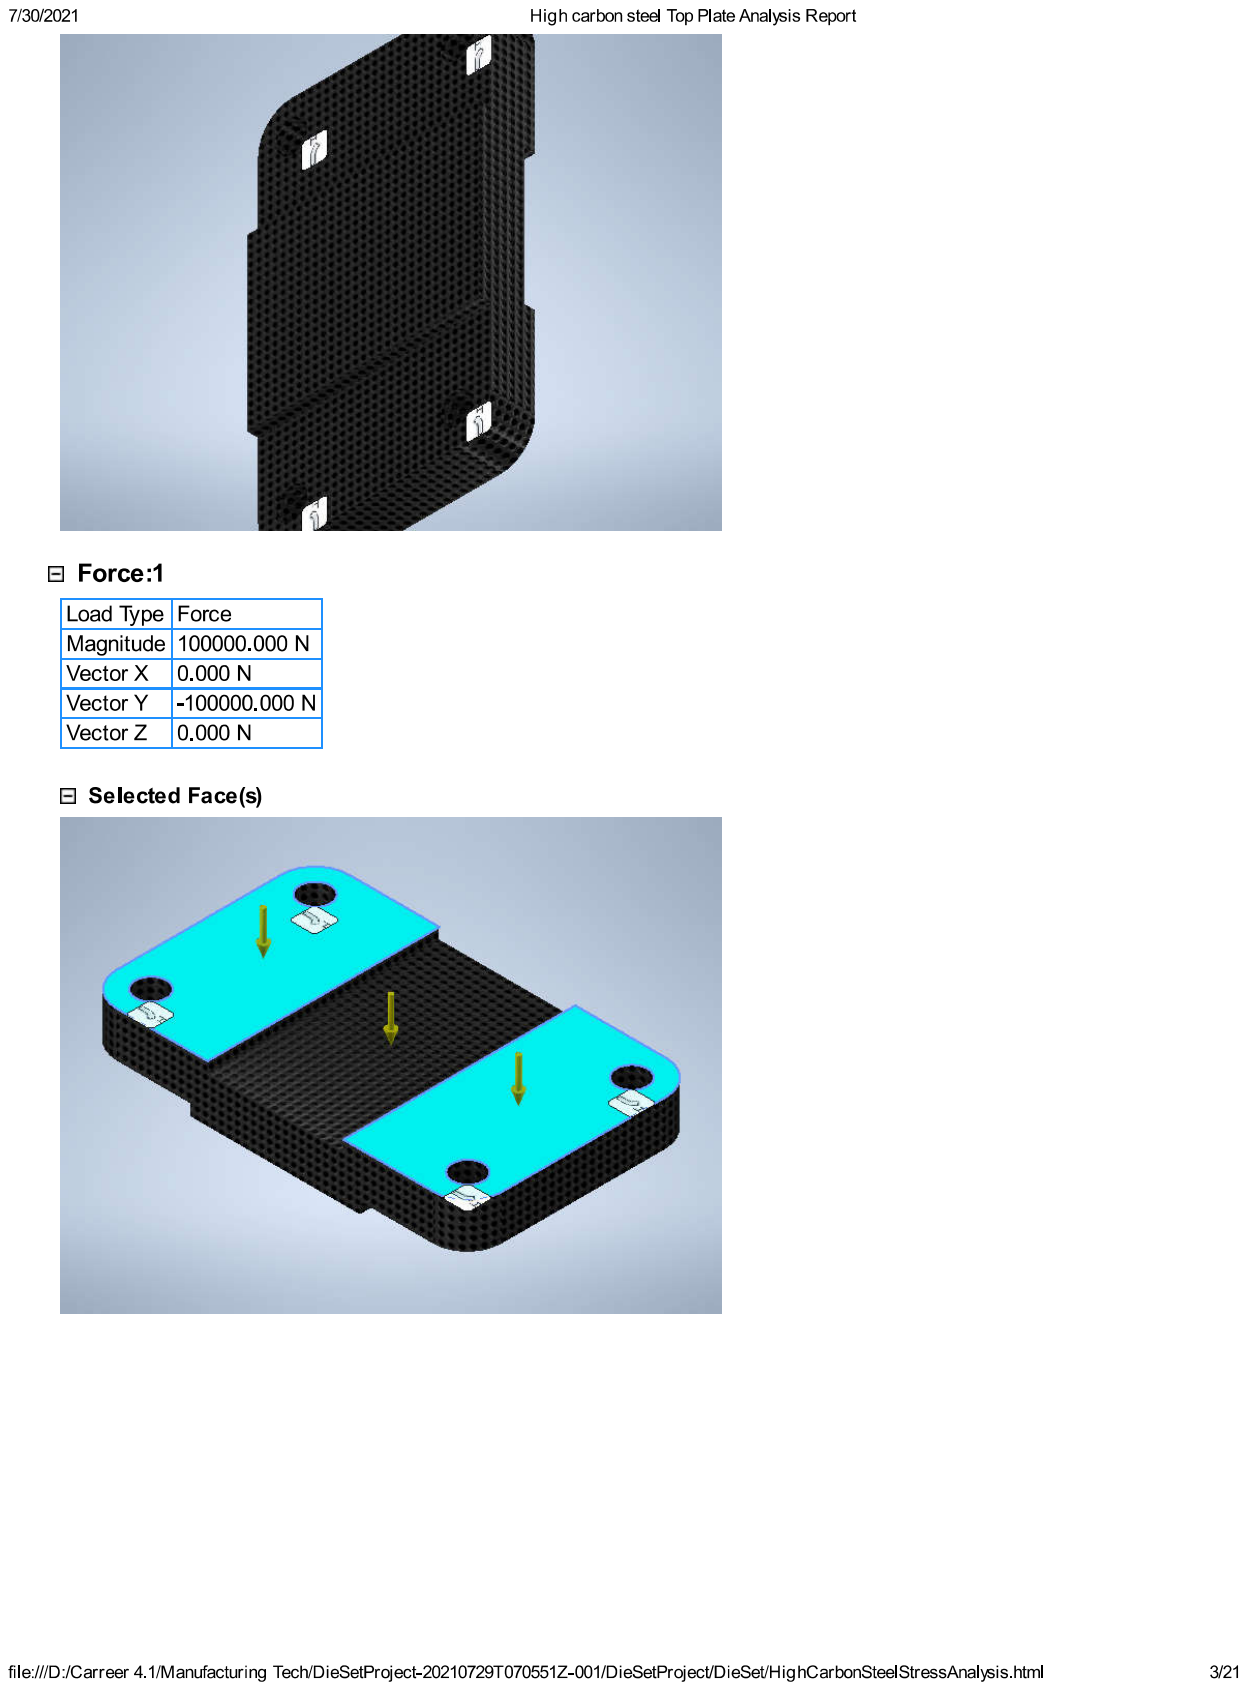
[picture p52: page 3]

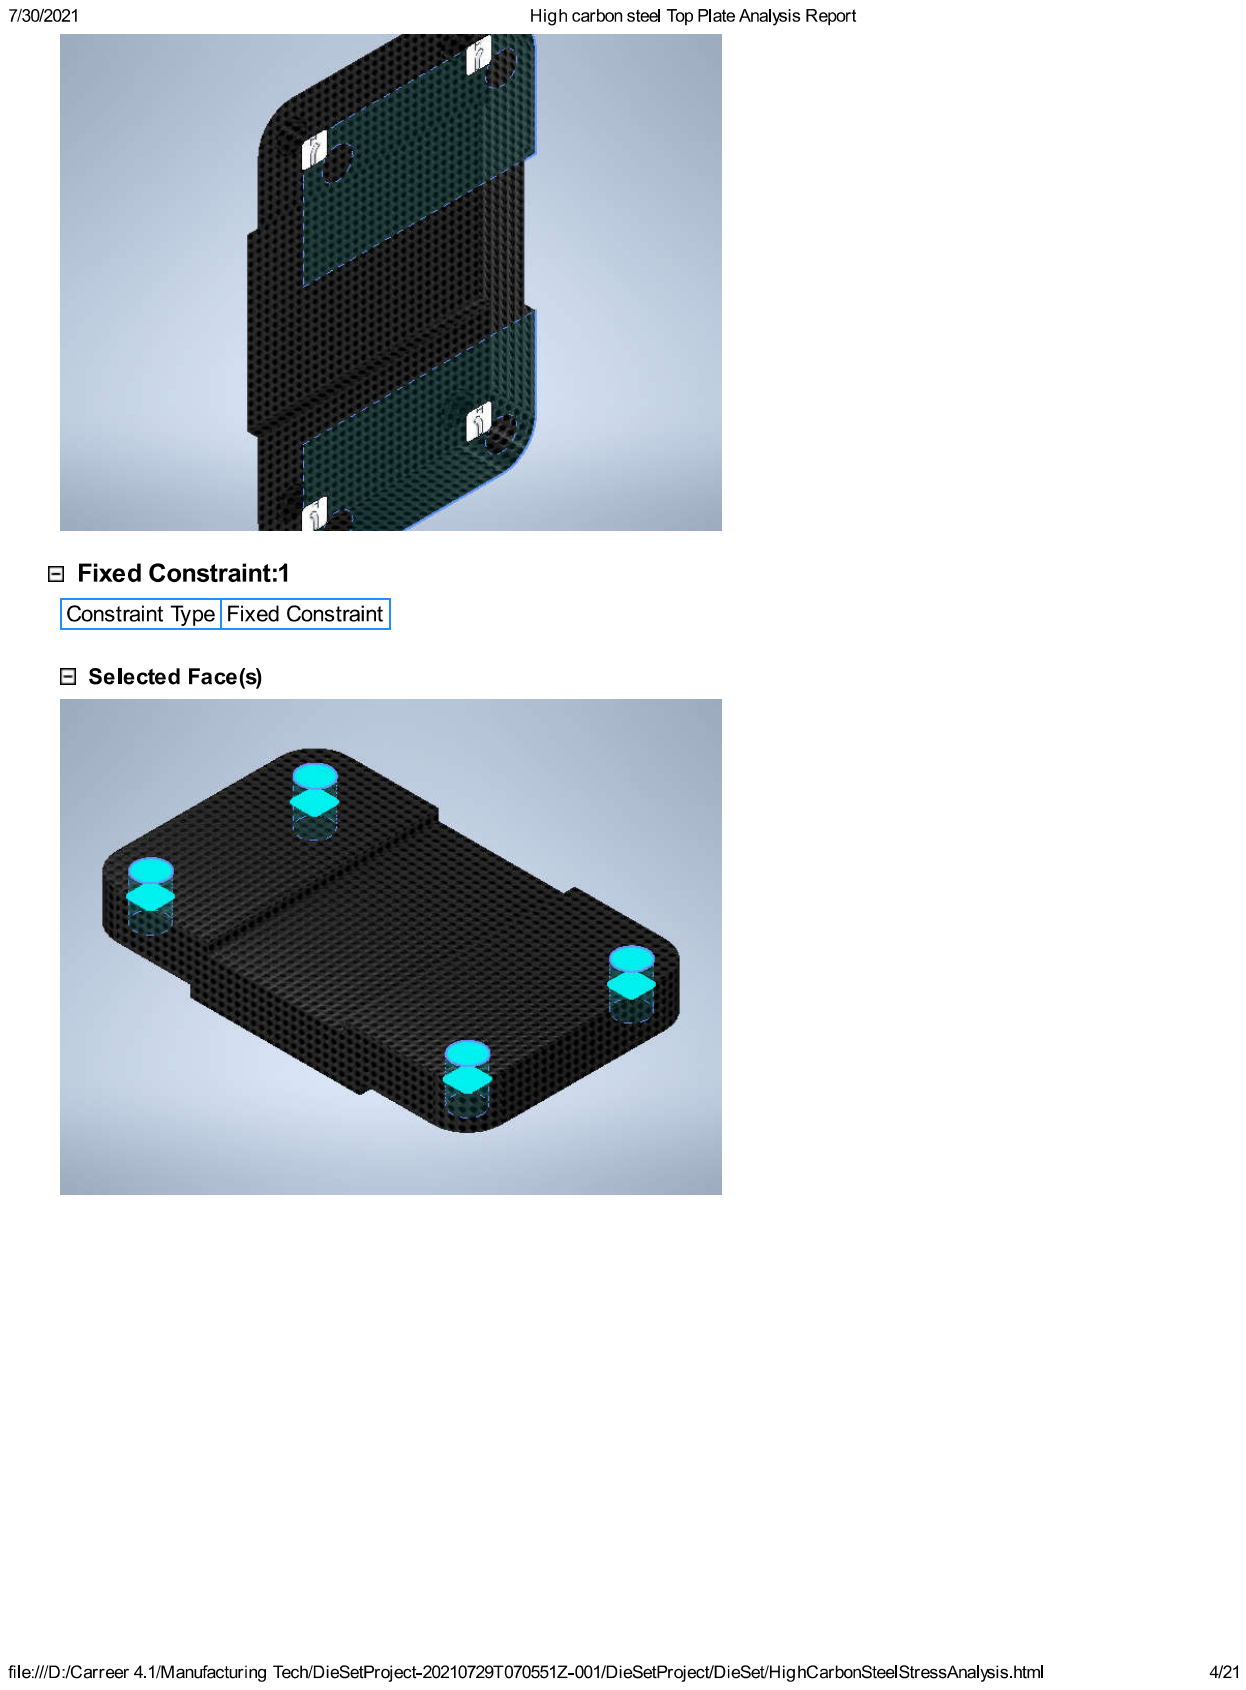
[picture p53: page 4]

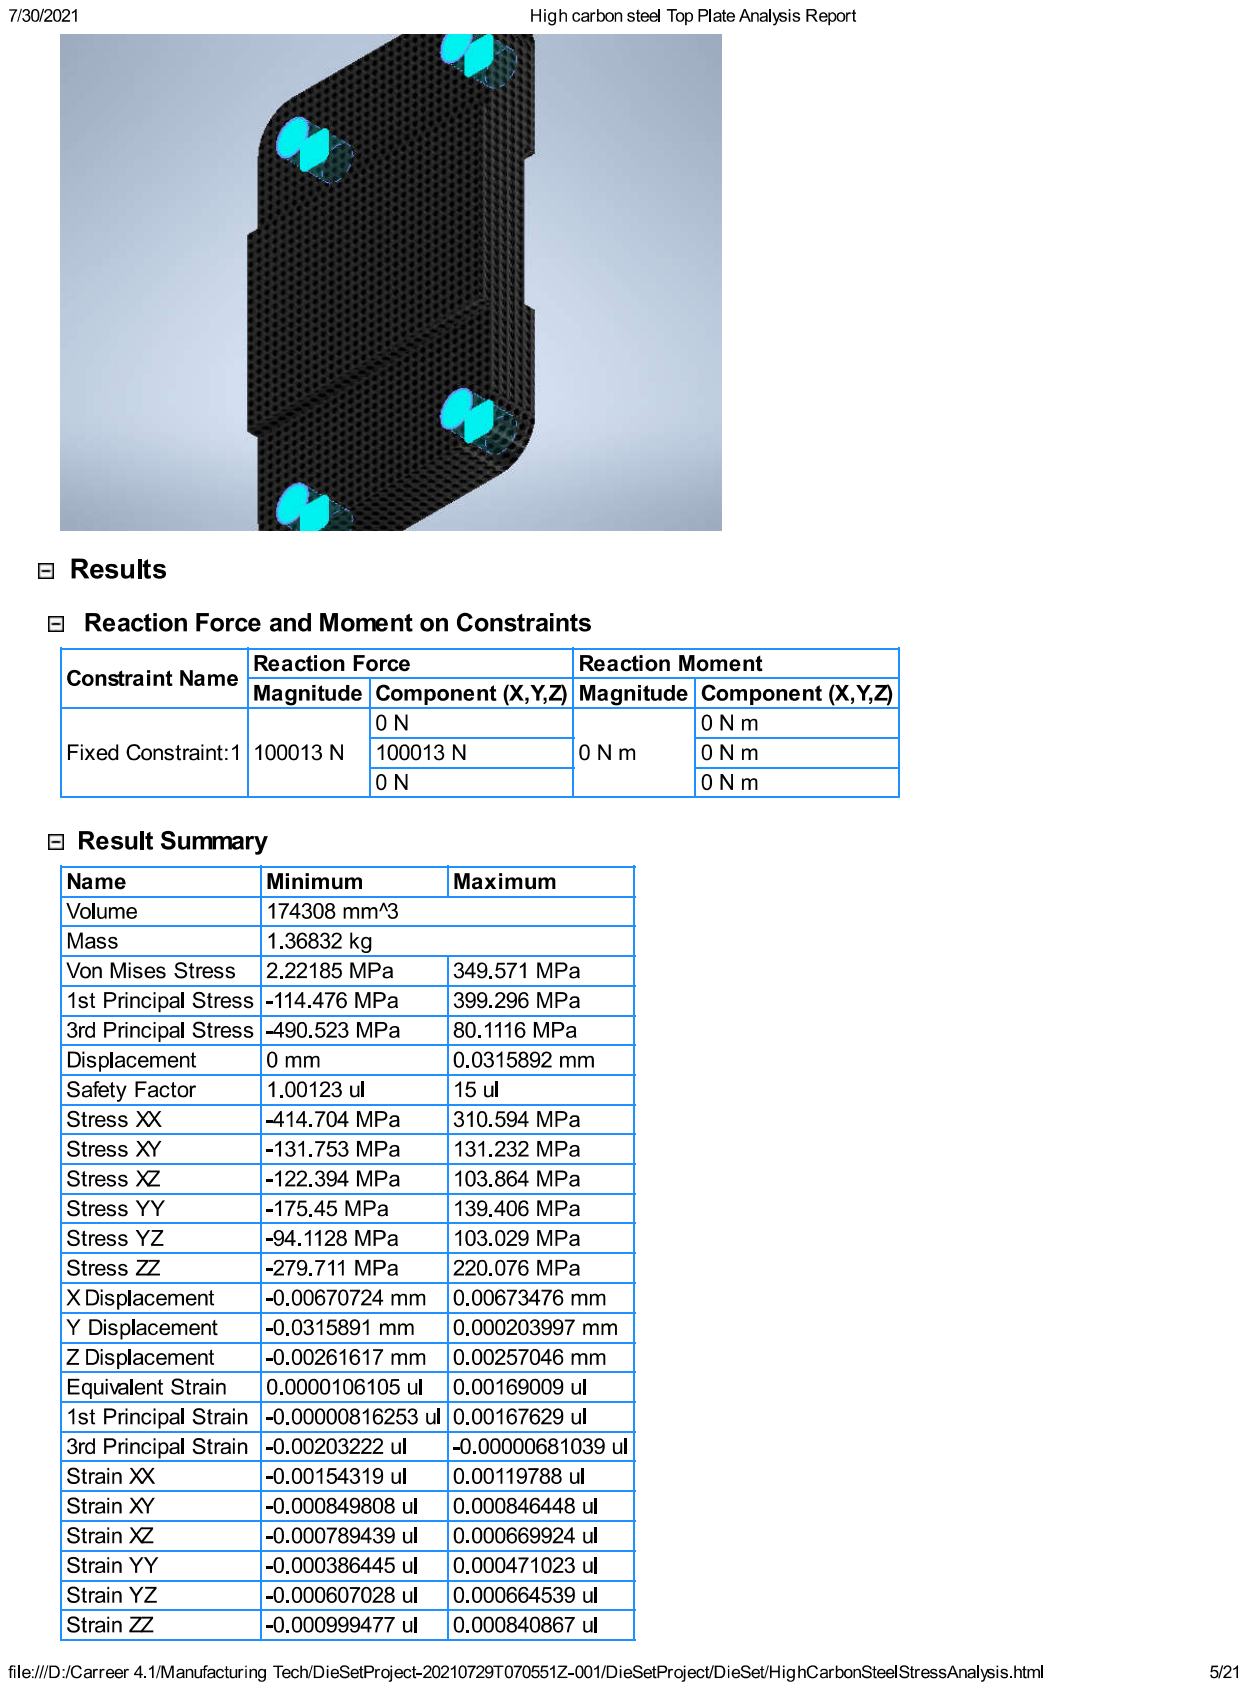
[picture p54: page 5]

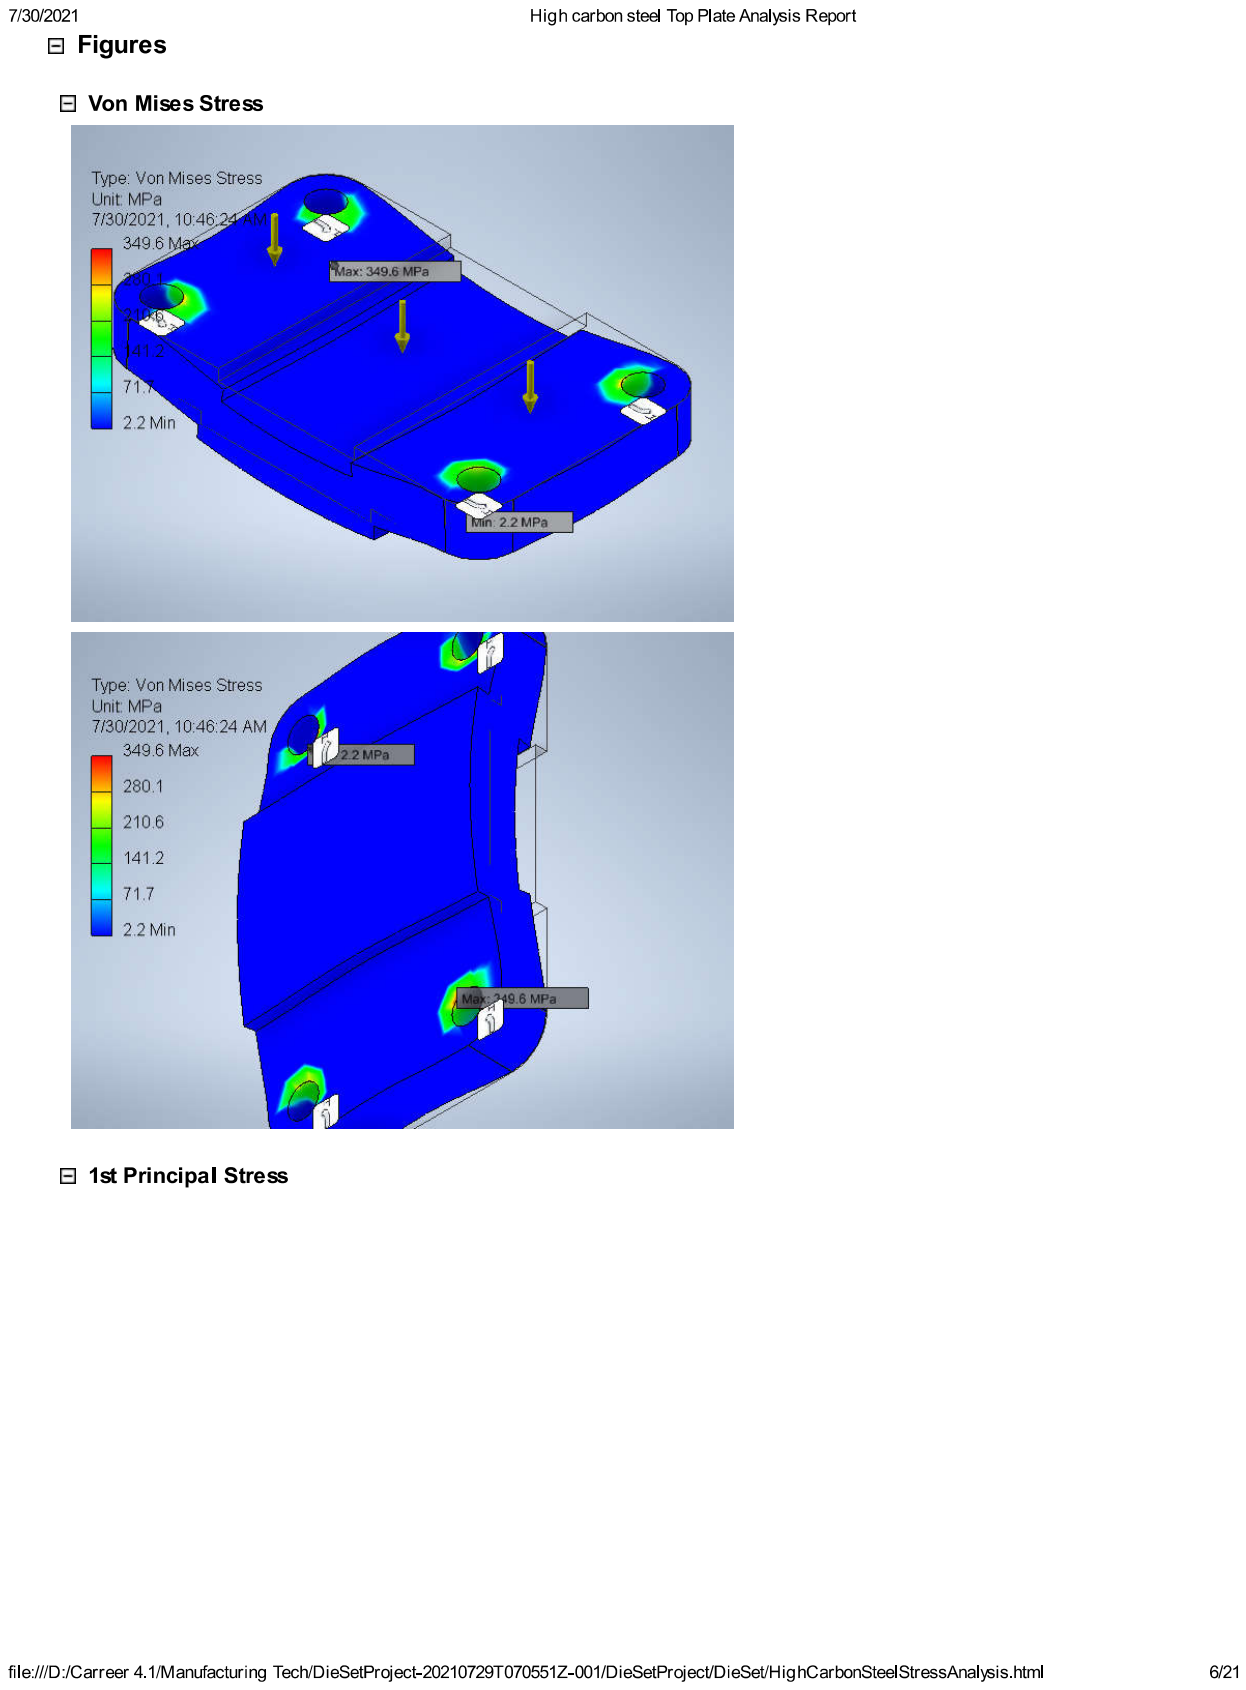
[picture p55: page 6]

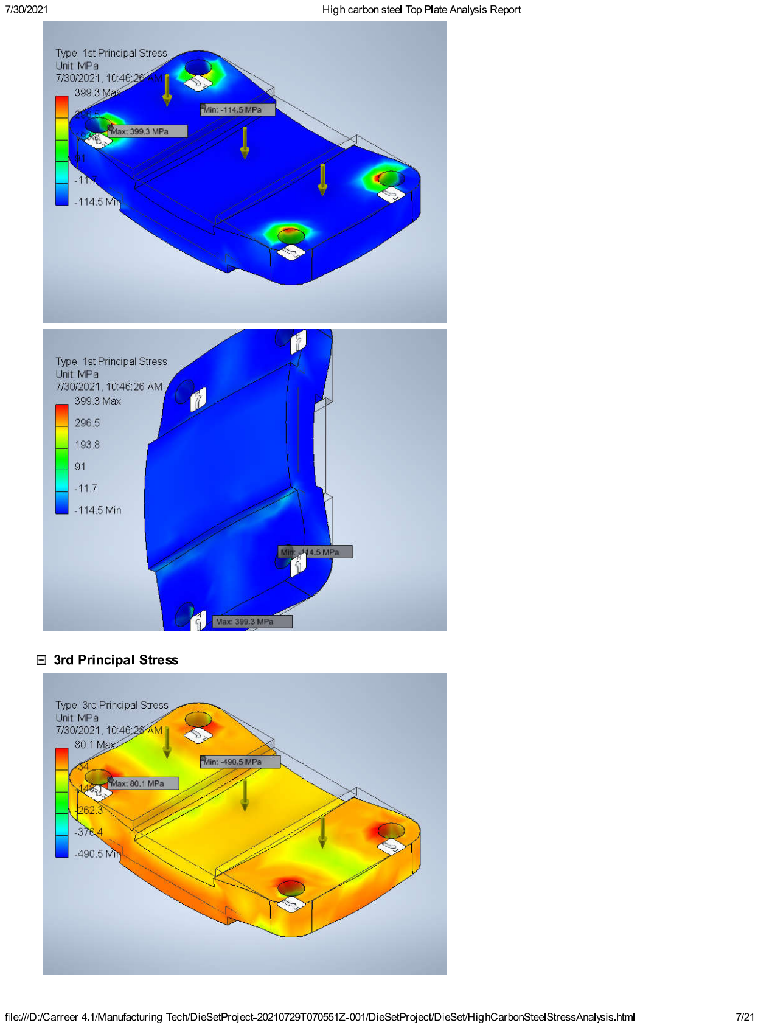
[picture p56: page 7]

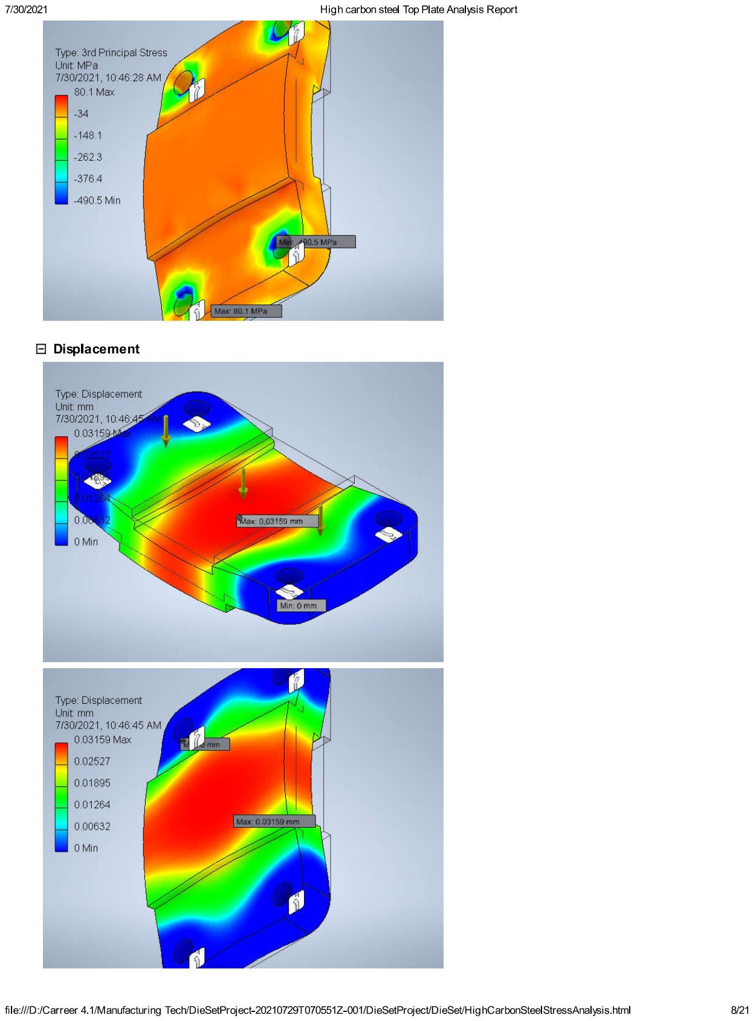
[picture p57: page 8]

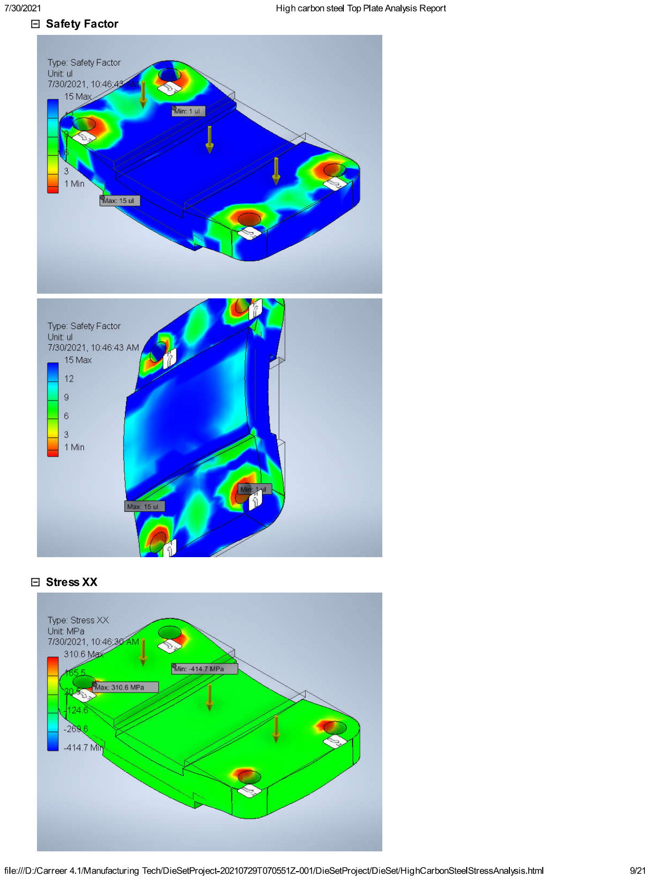
[picture p58: page 9]

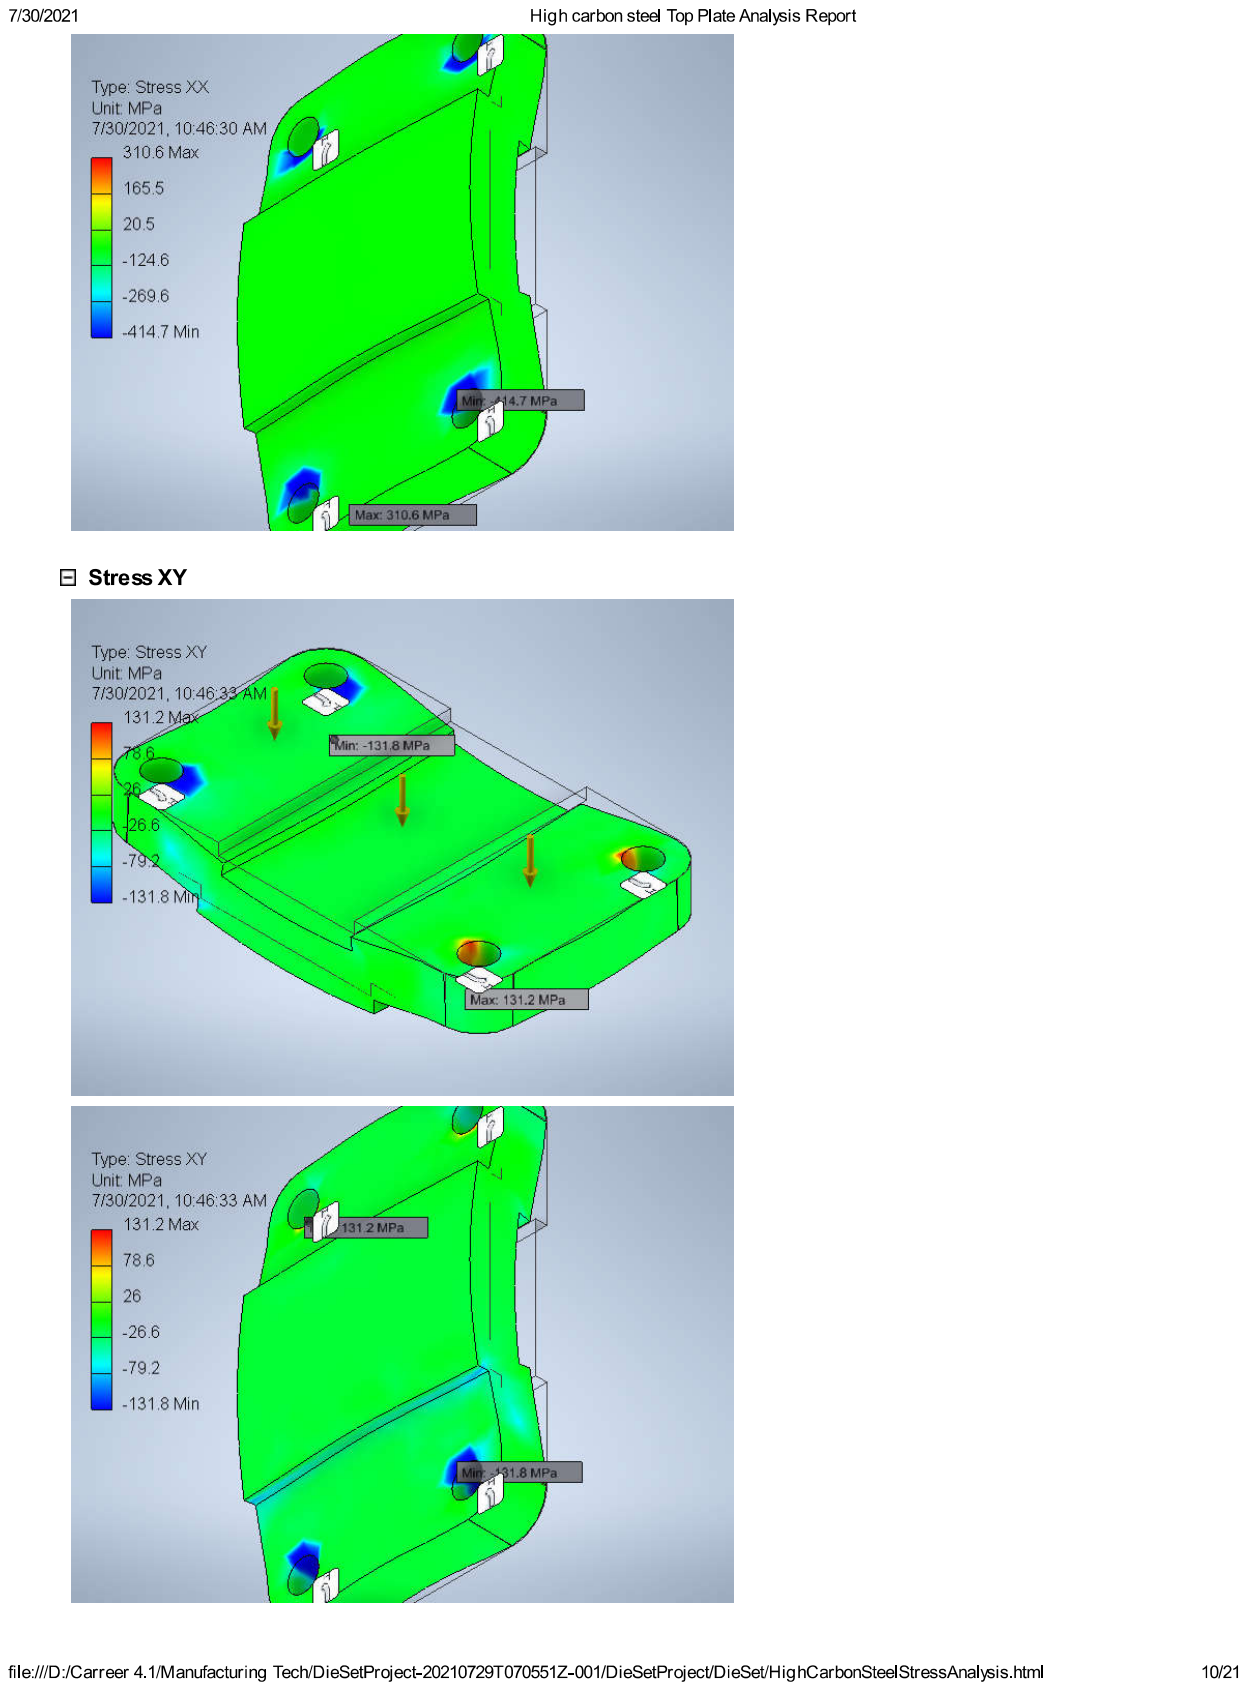
[picture p59: page 10]

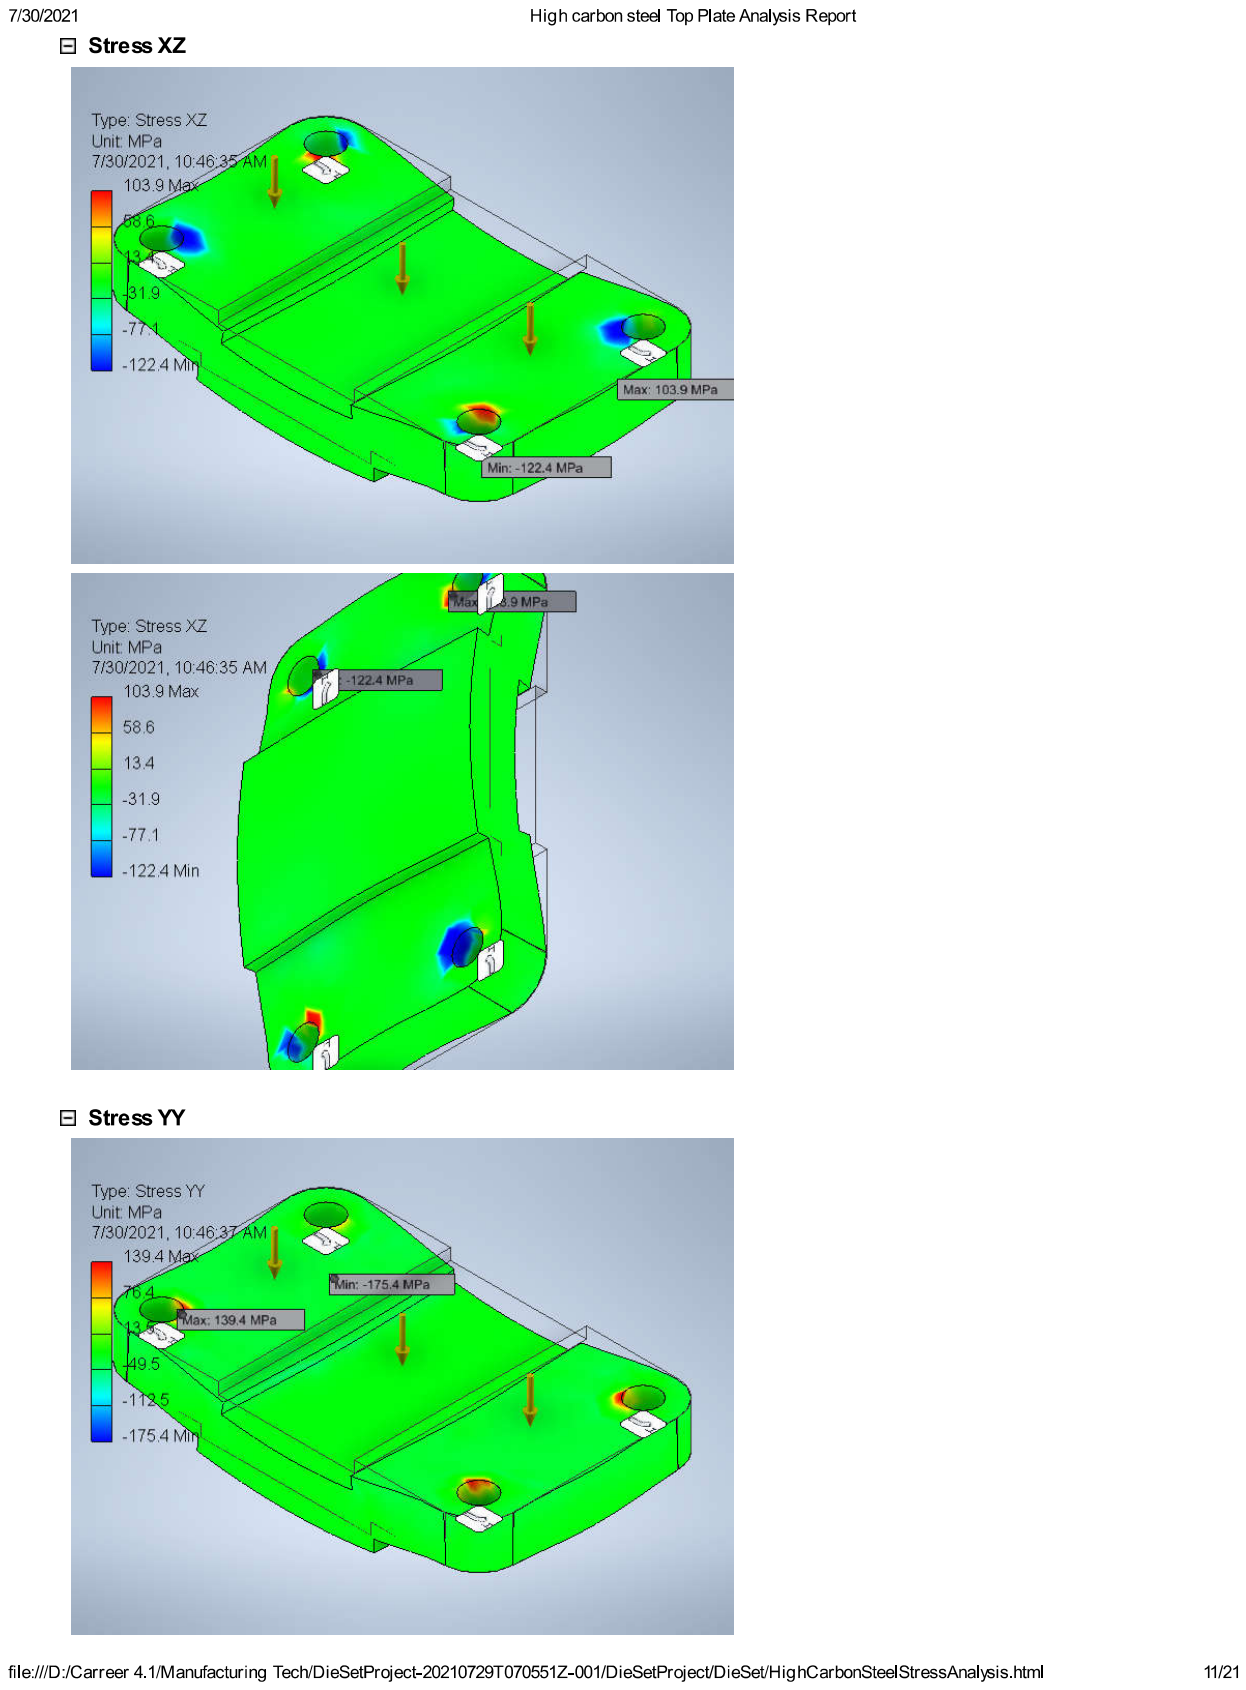
[picture p60: page 11]

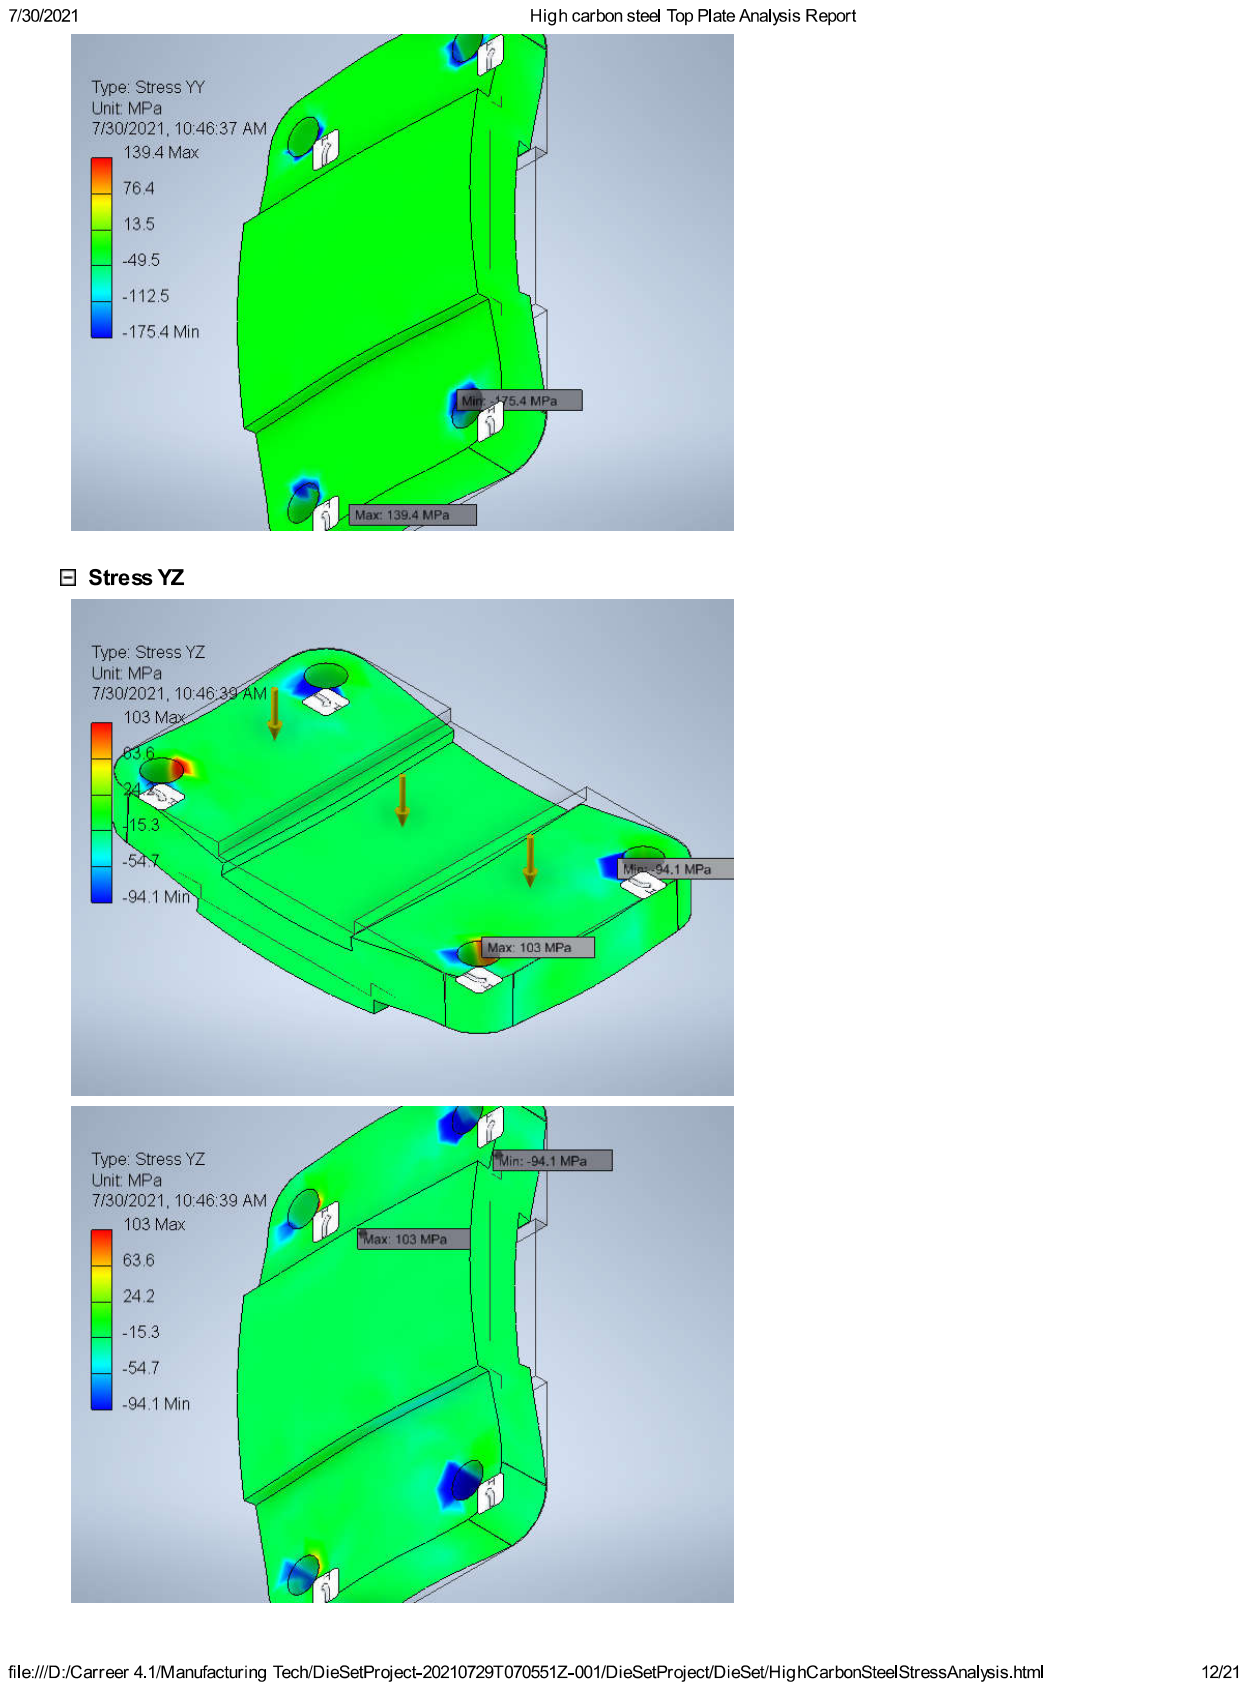
[picture p61: page 12]

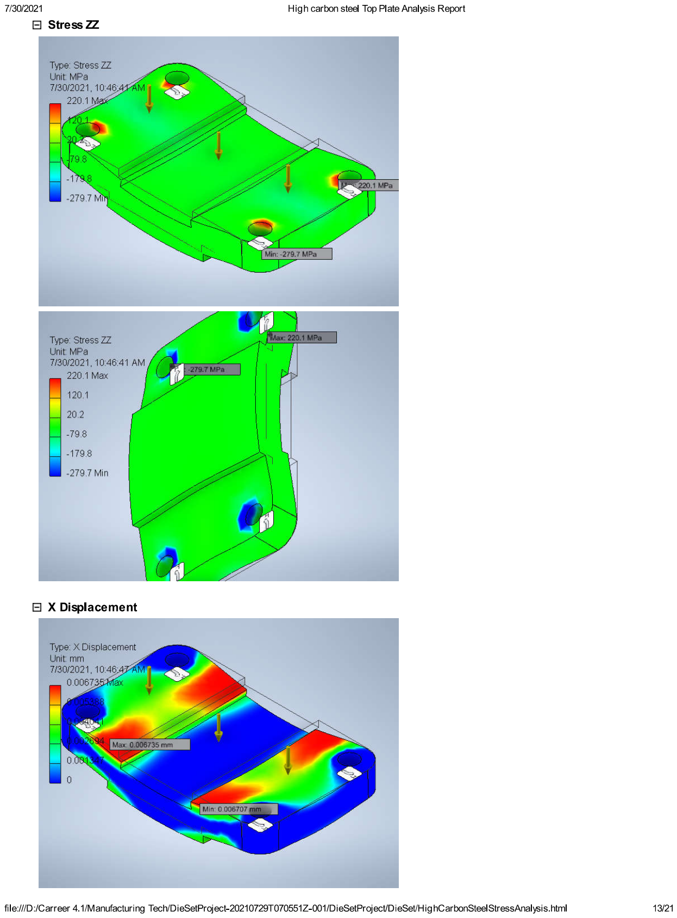
[picture p62: page 13]

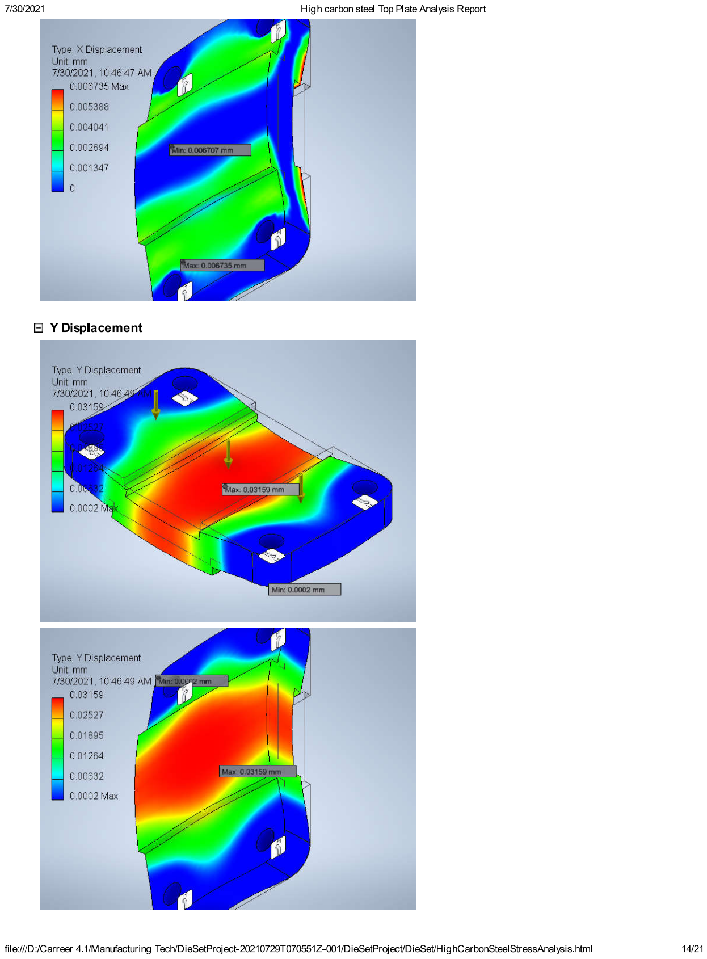
[picture p63: page 14]

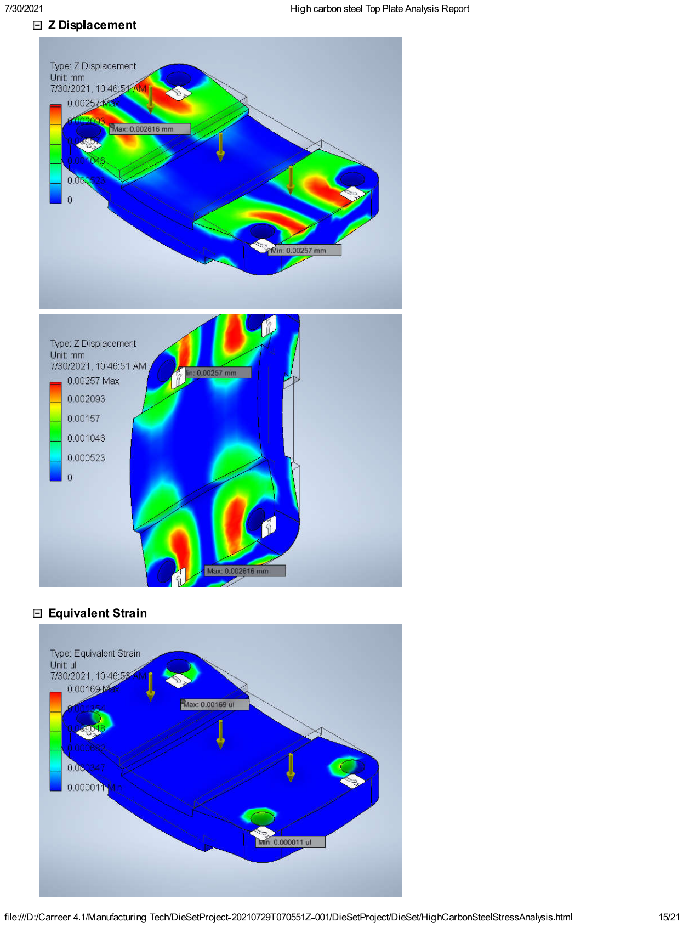
[picture p64: page 15]

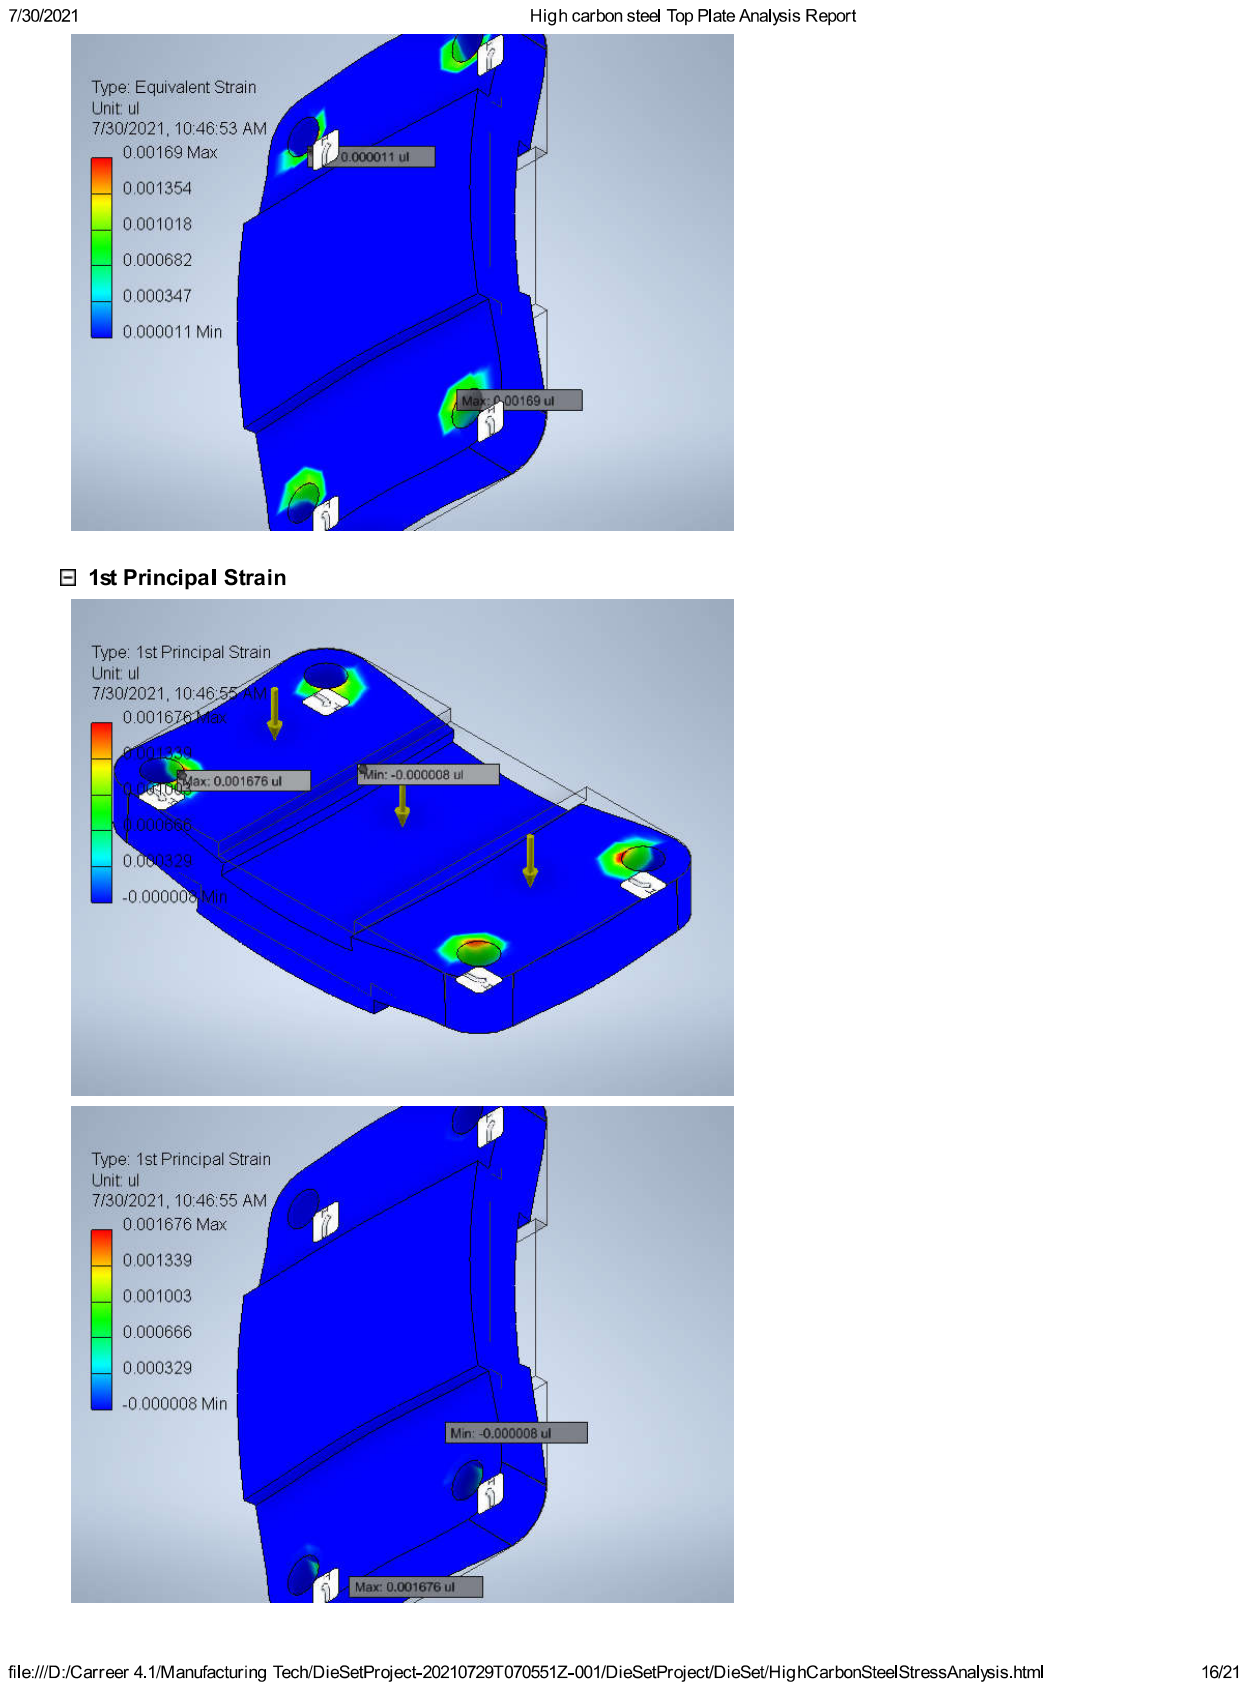
[picture p65: page 16]

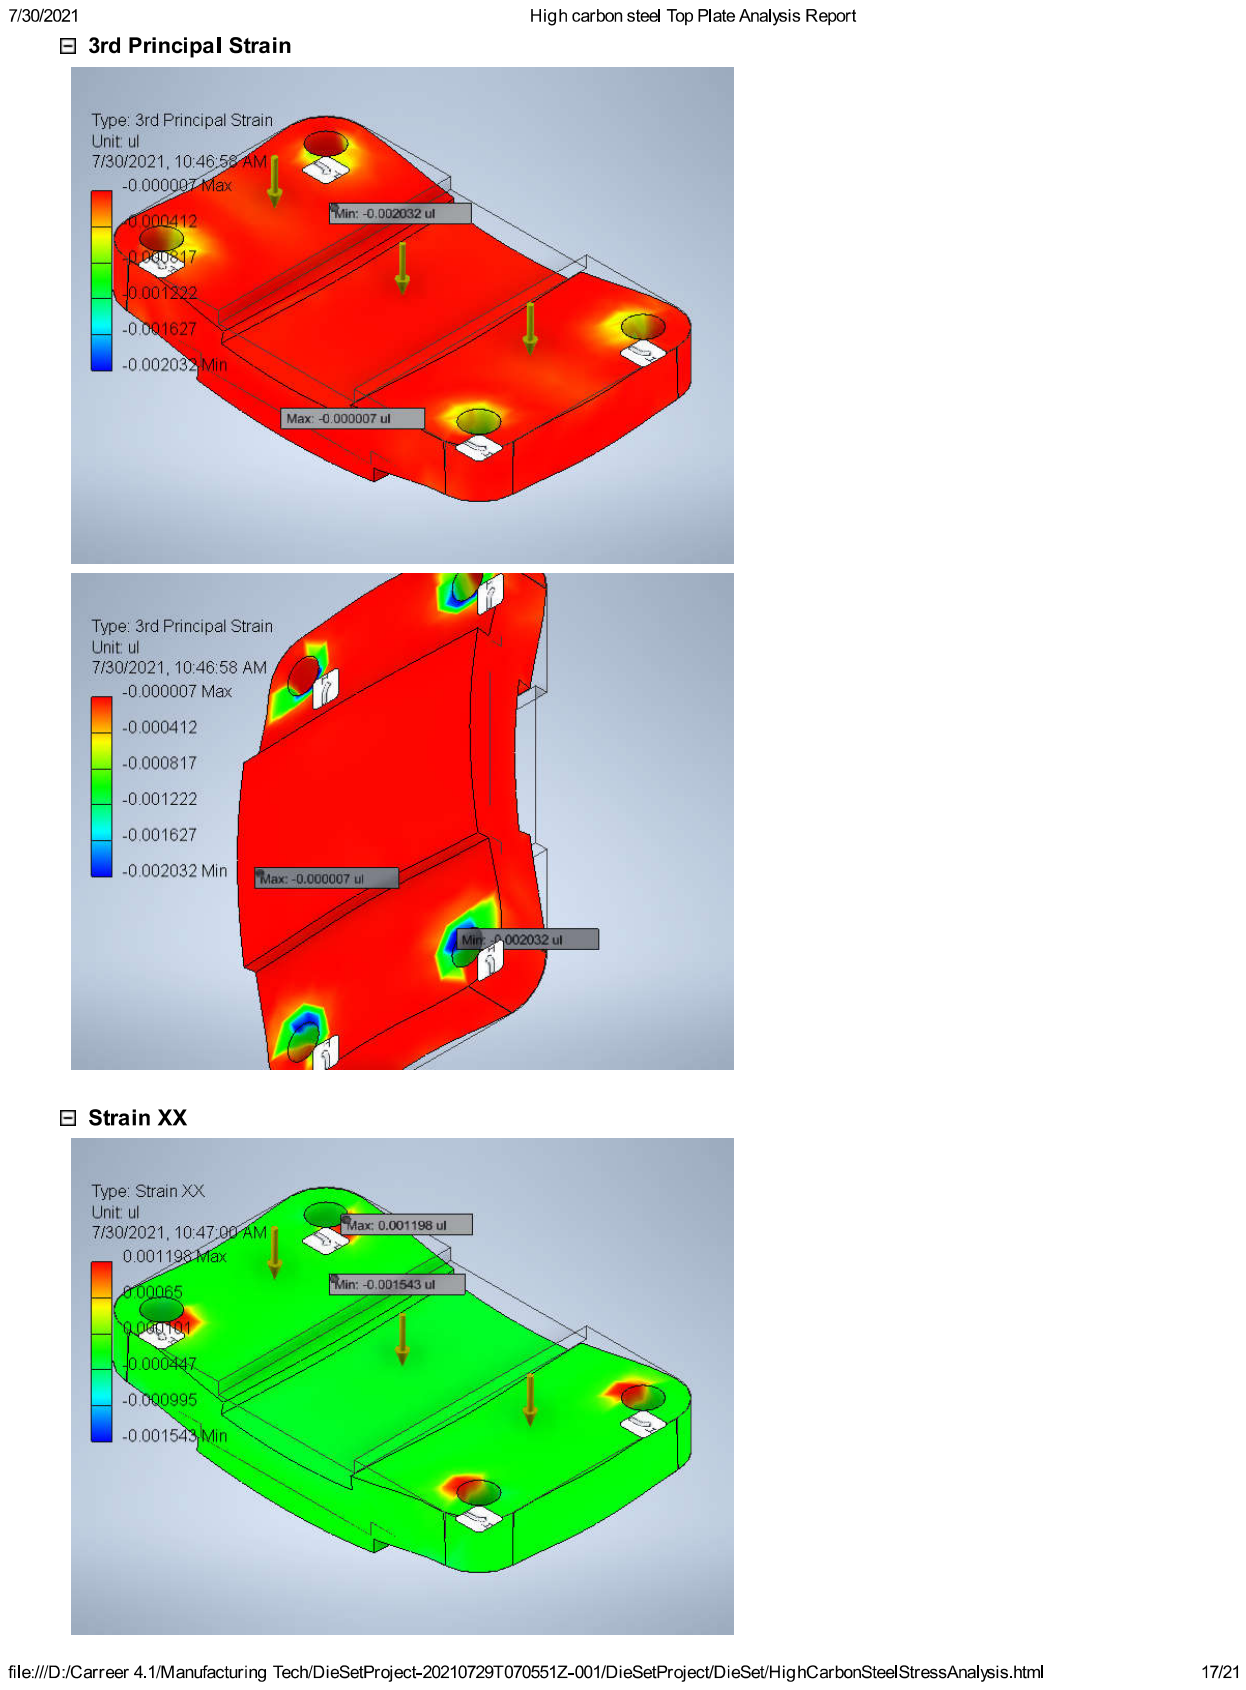
[picture p66: page 17]

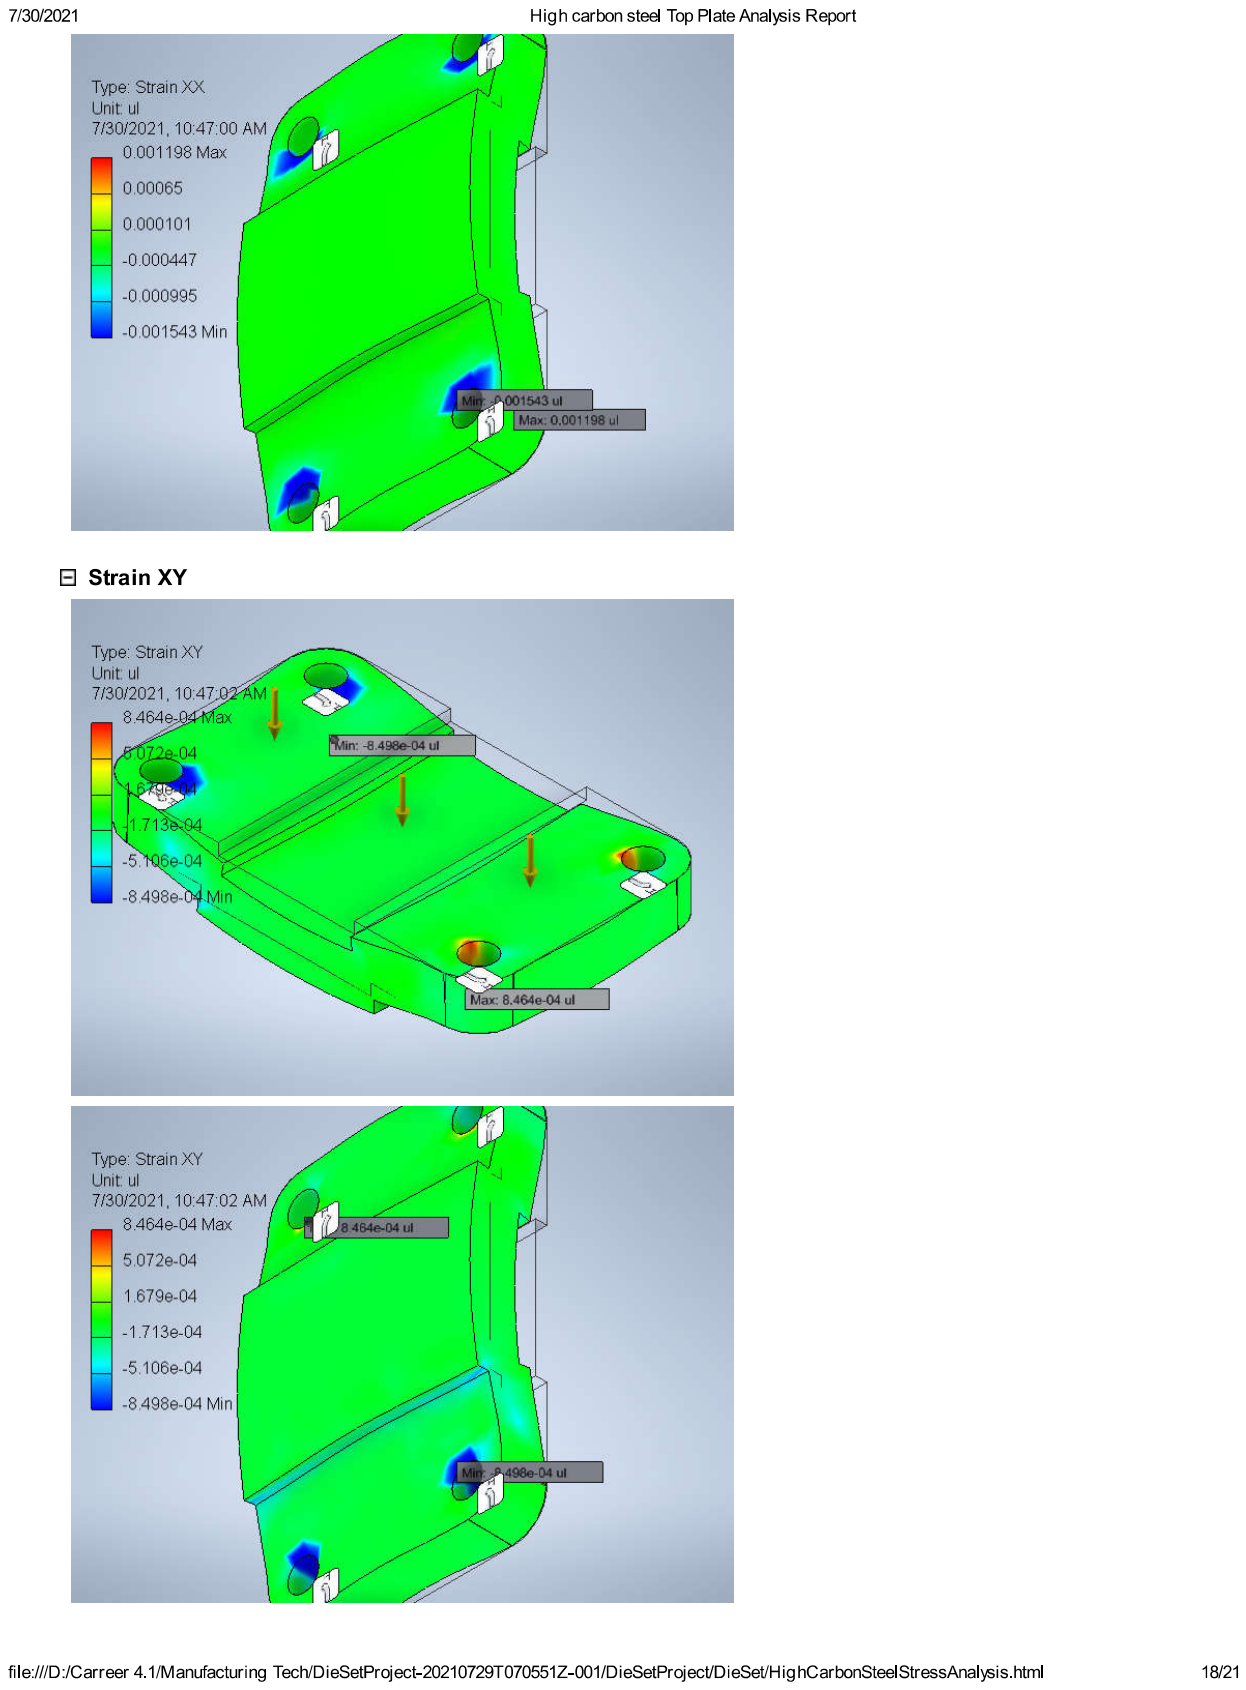
[picture p67: page 18]

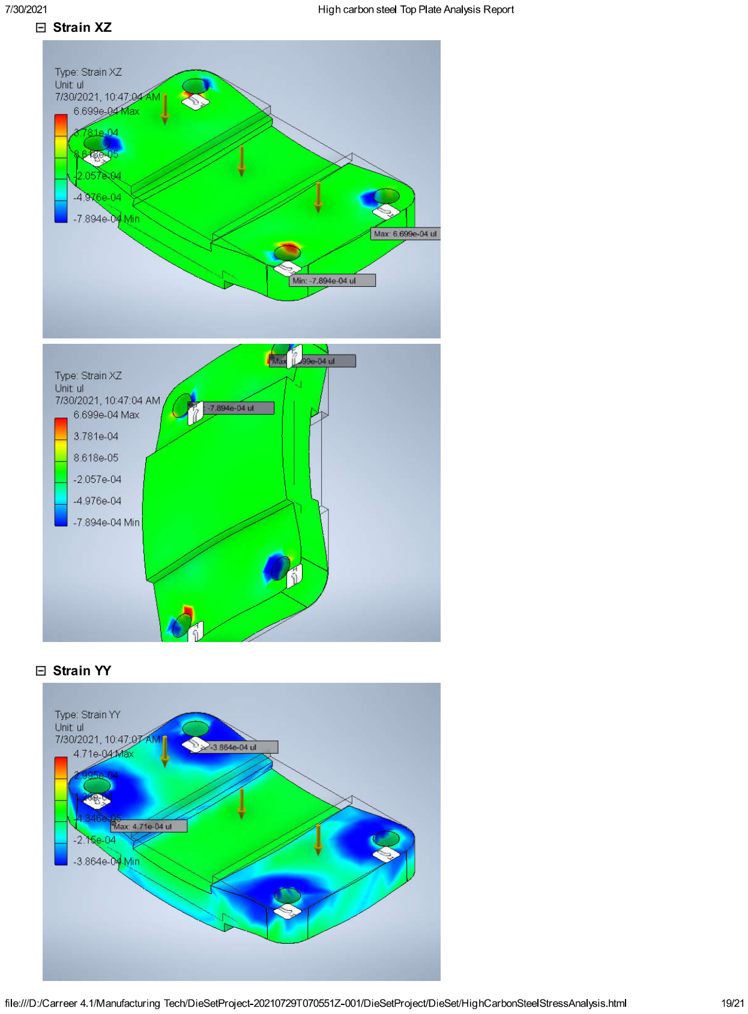
[picture p68: page 19]

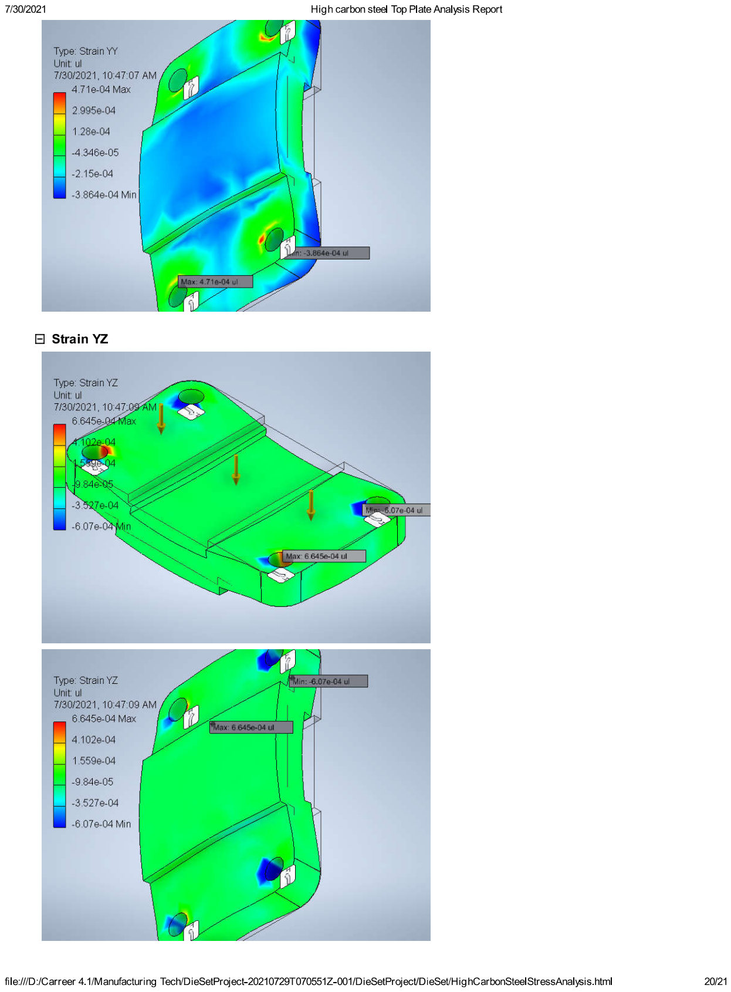
[picture p69: page 20]

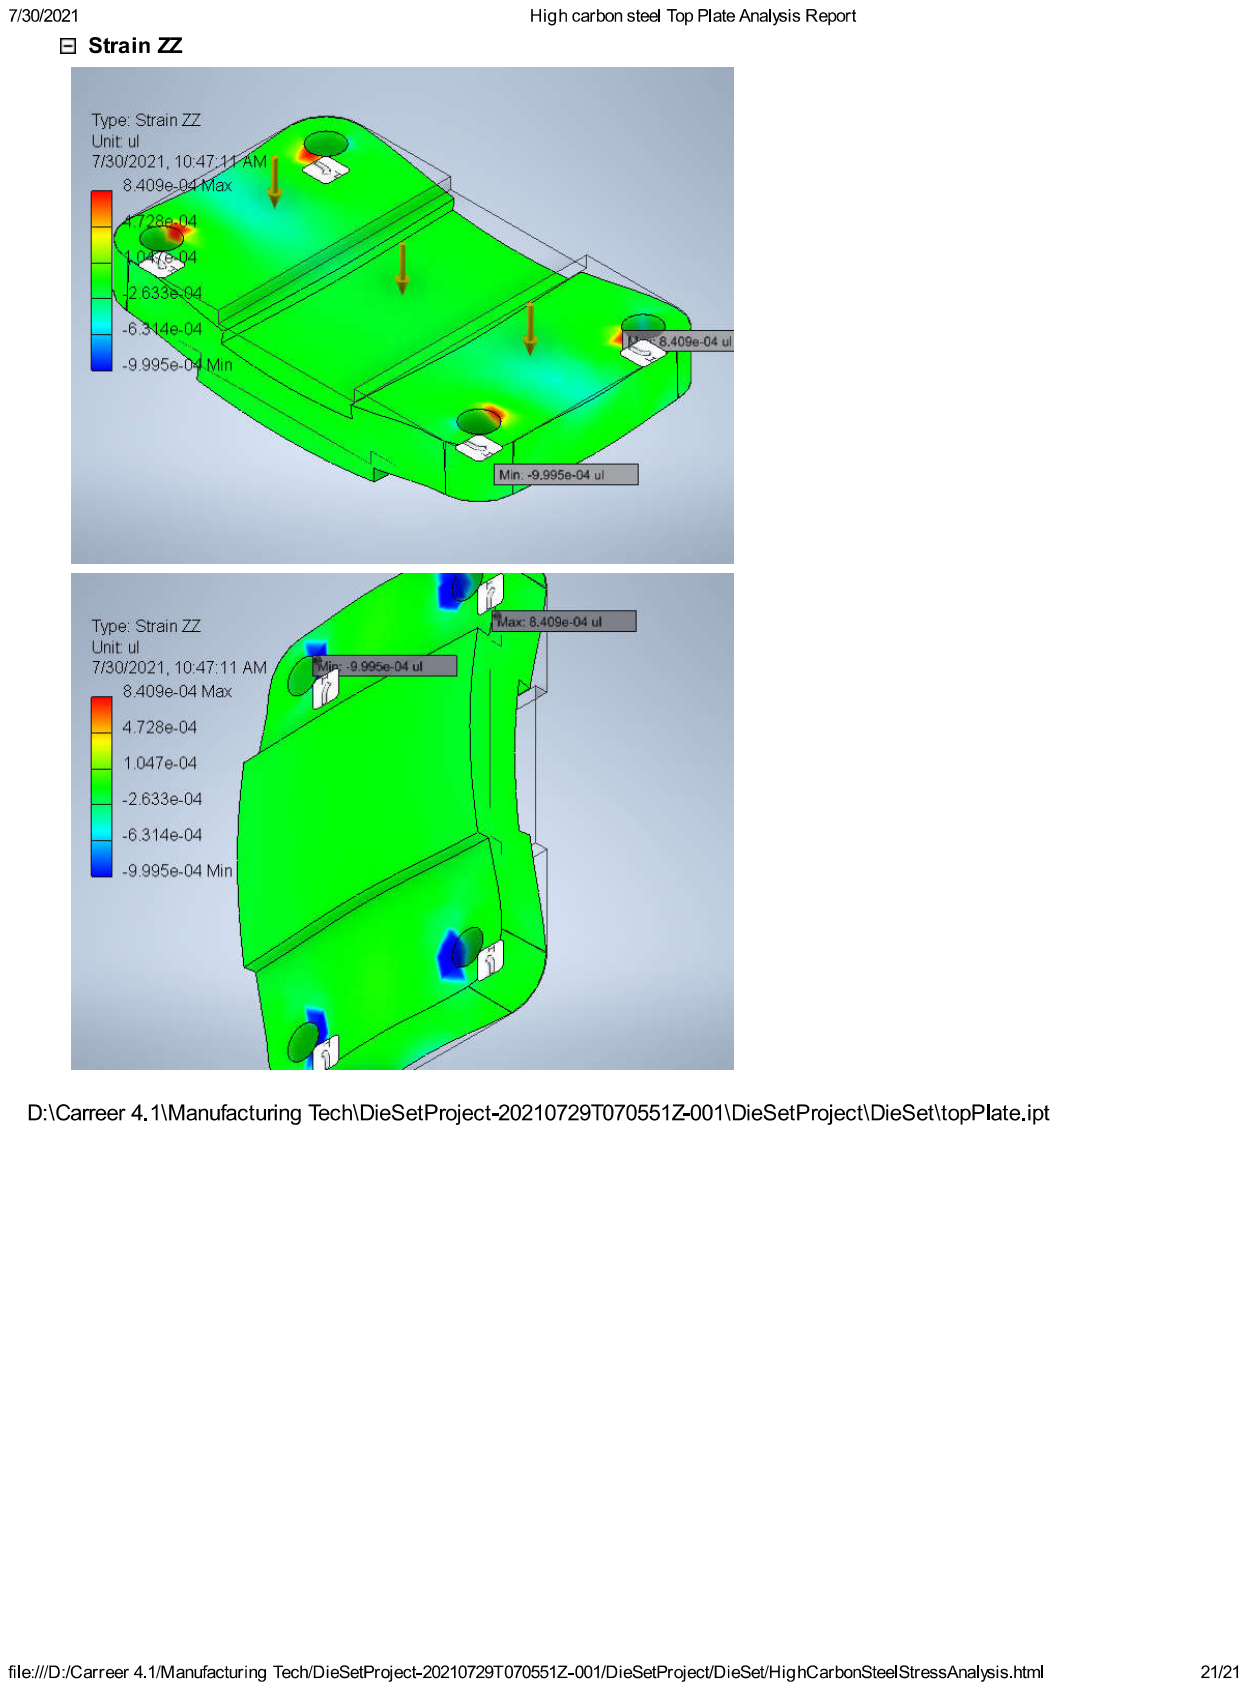
[picture p70: page 21]
