EricoDeMecha/Die-Set/Reports/DieSetAnalysisReports/Stainless Steel Top Plate Analysis Report.pdf

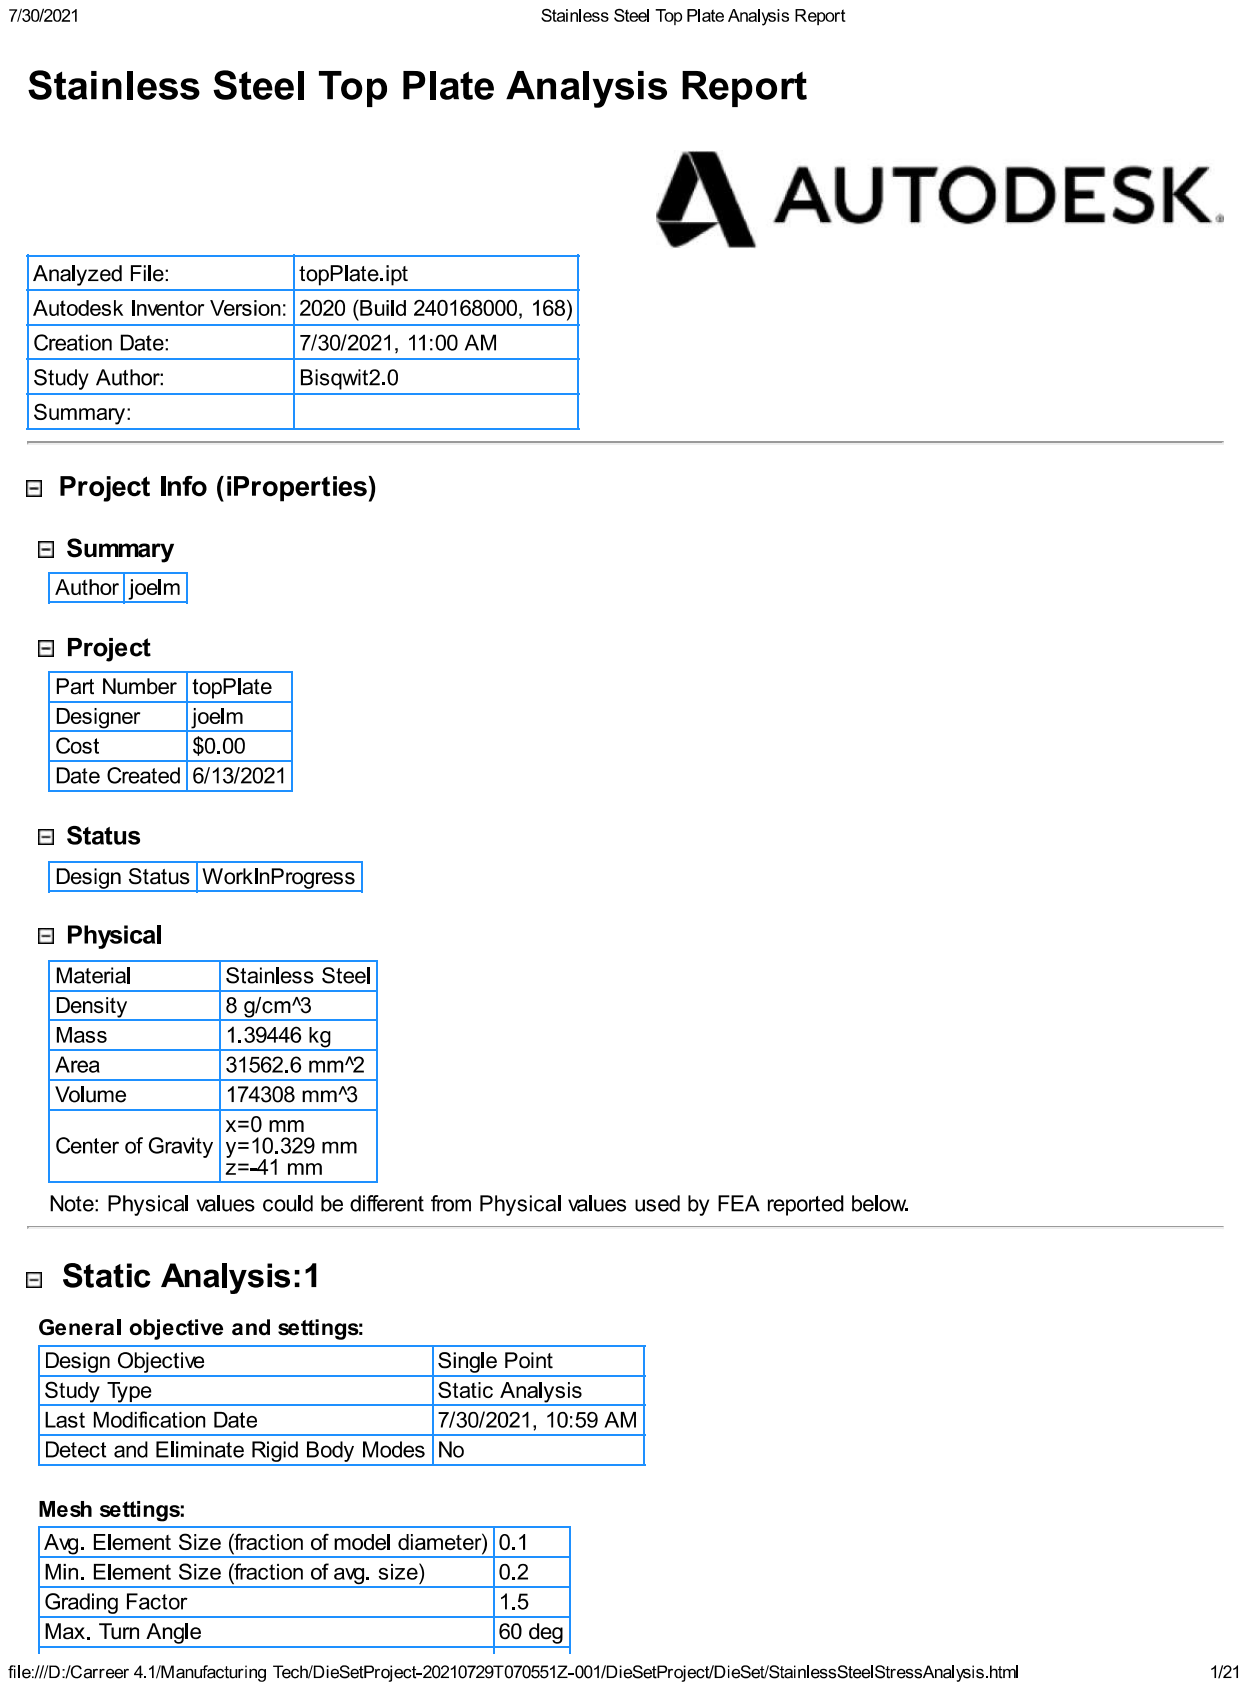
[picture p92: page 1]

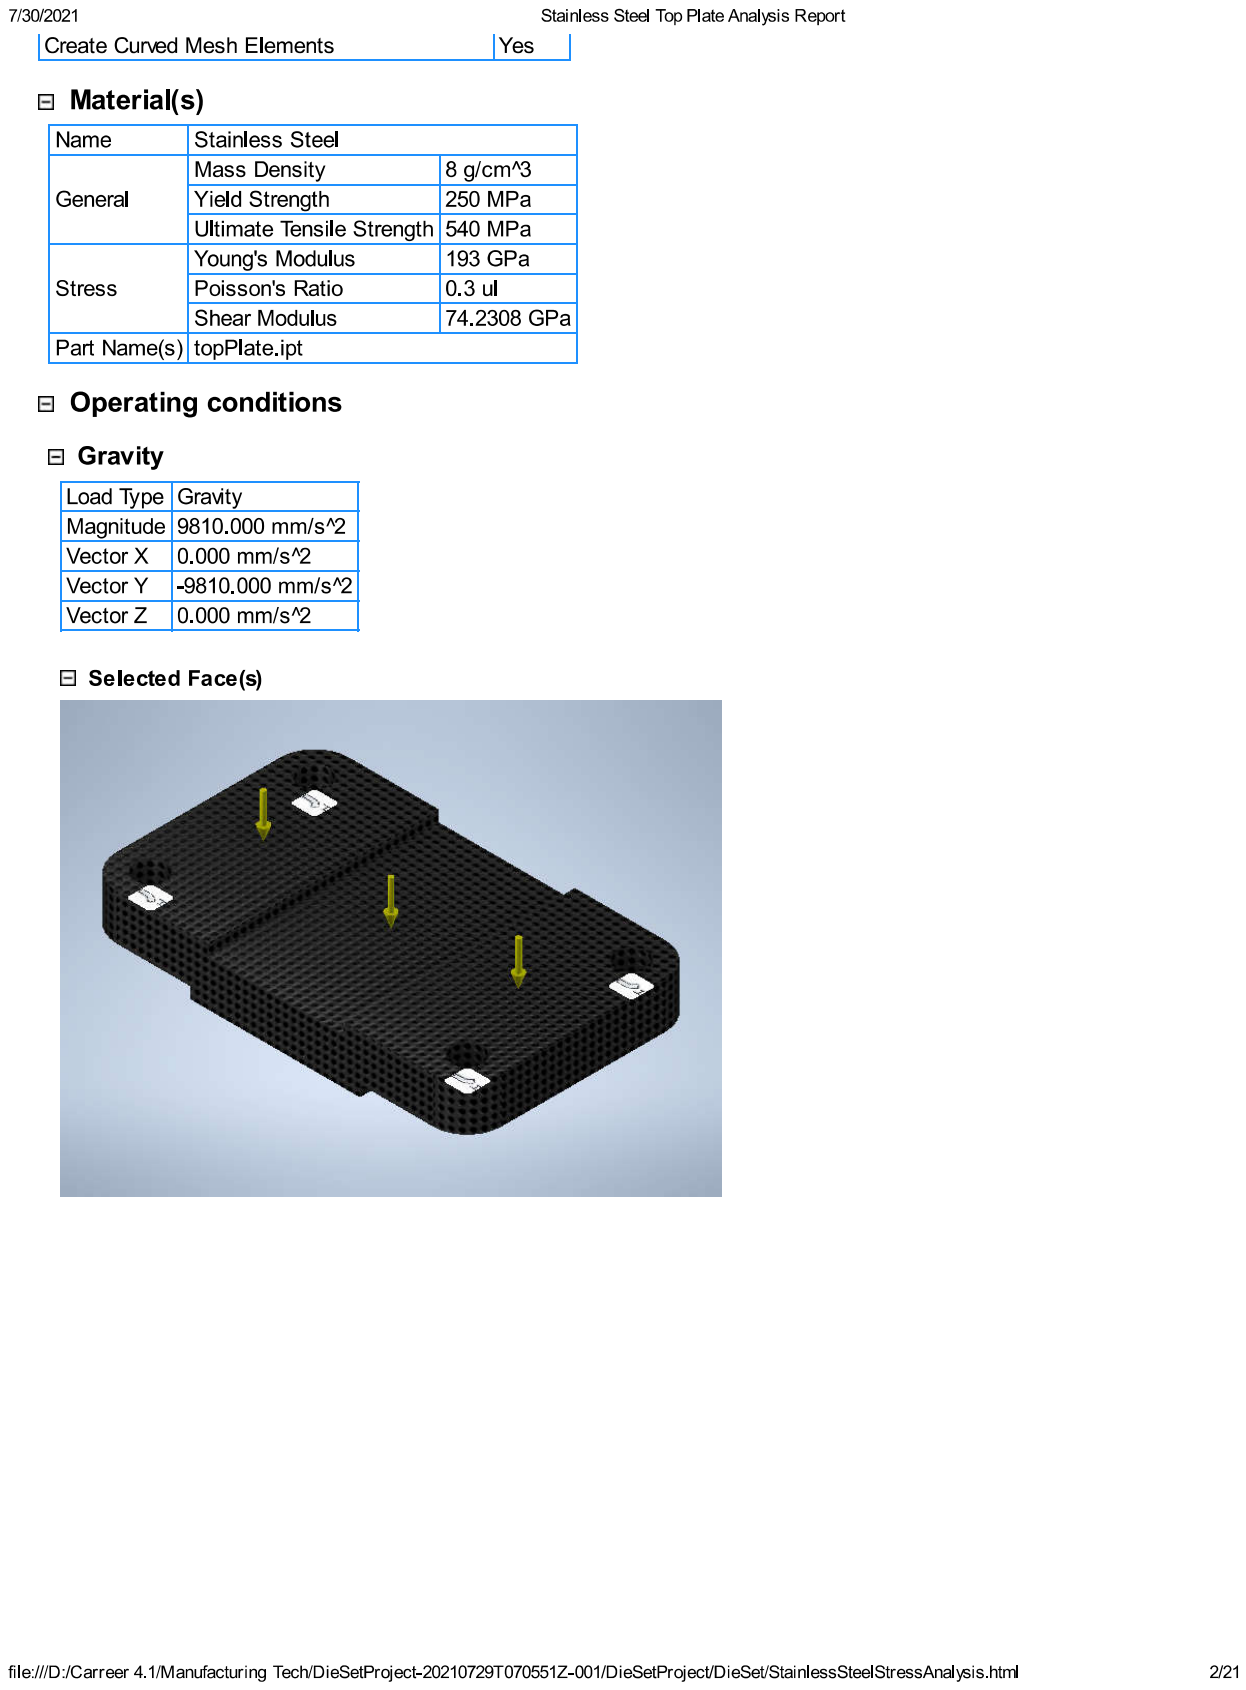
[picture p93: page 2]

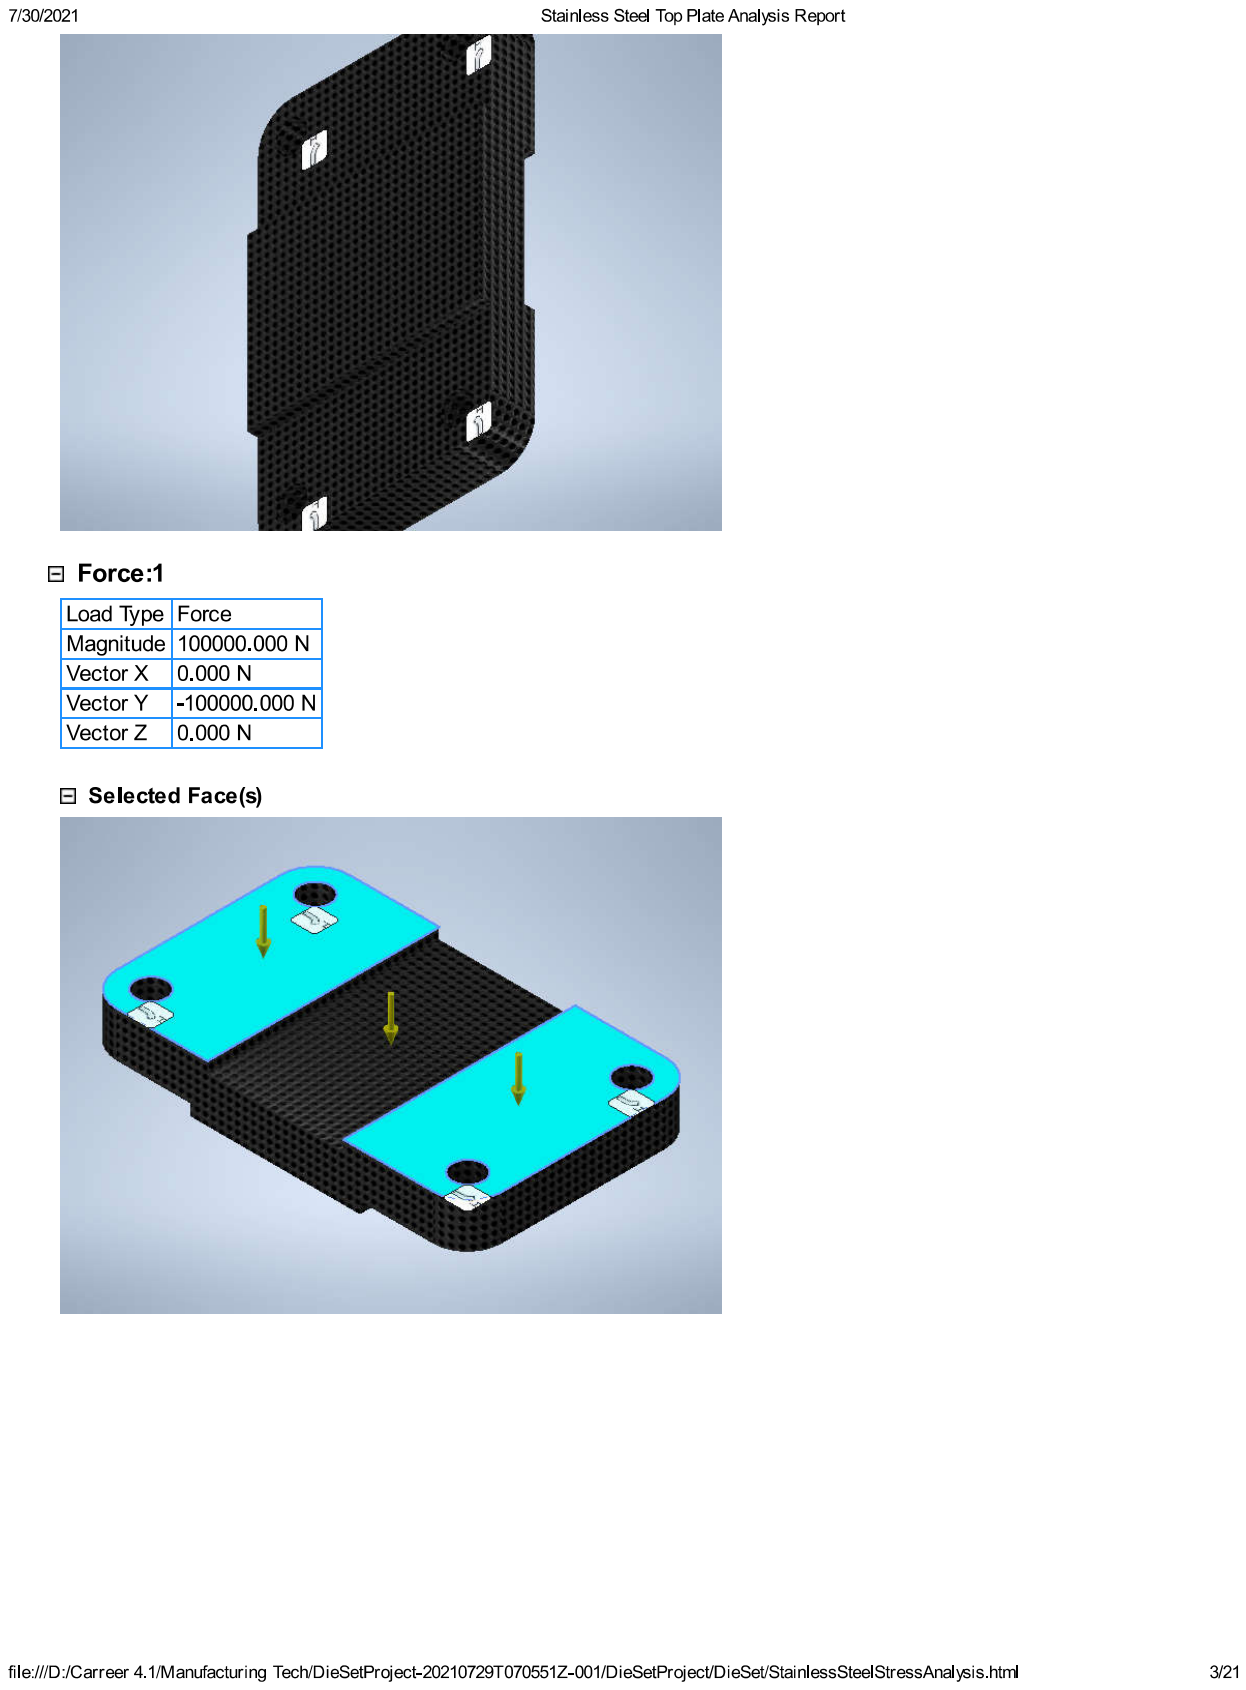
[picture p94: page 3]

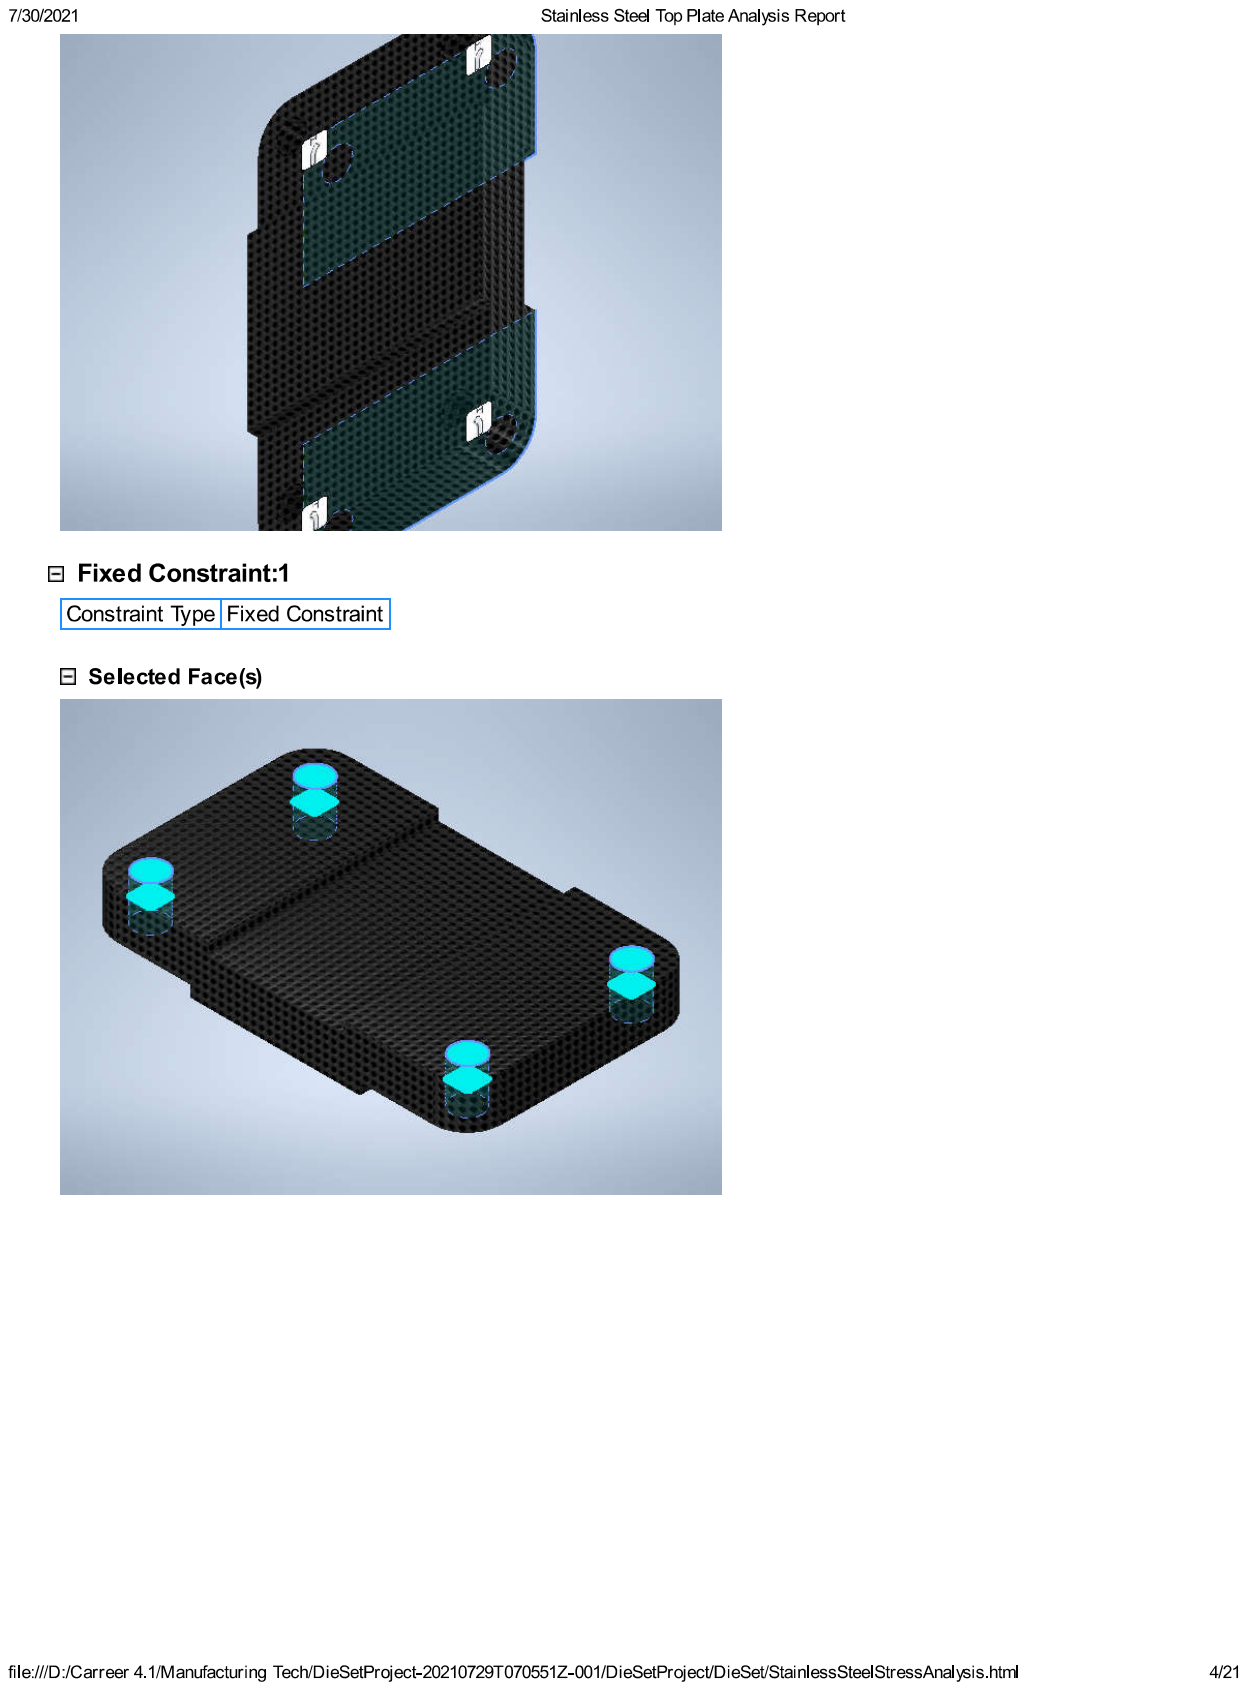
[picture p95: page 4]

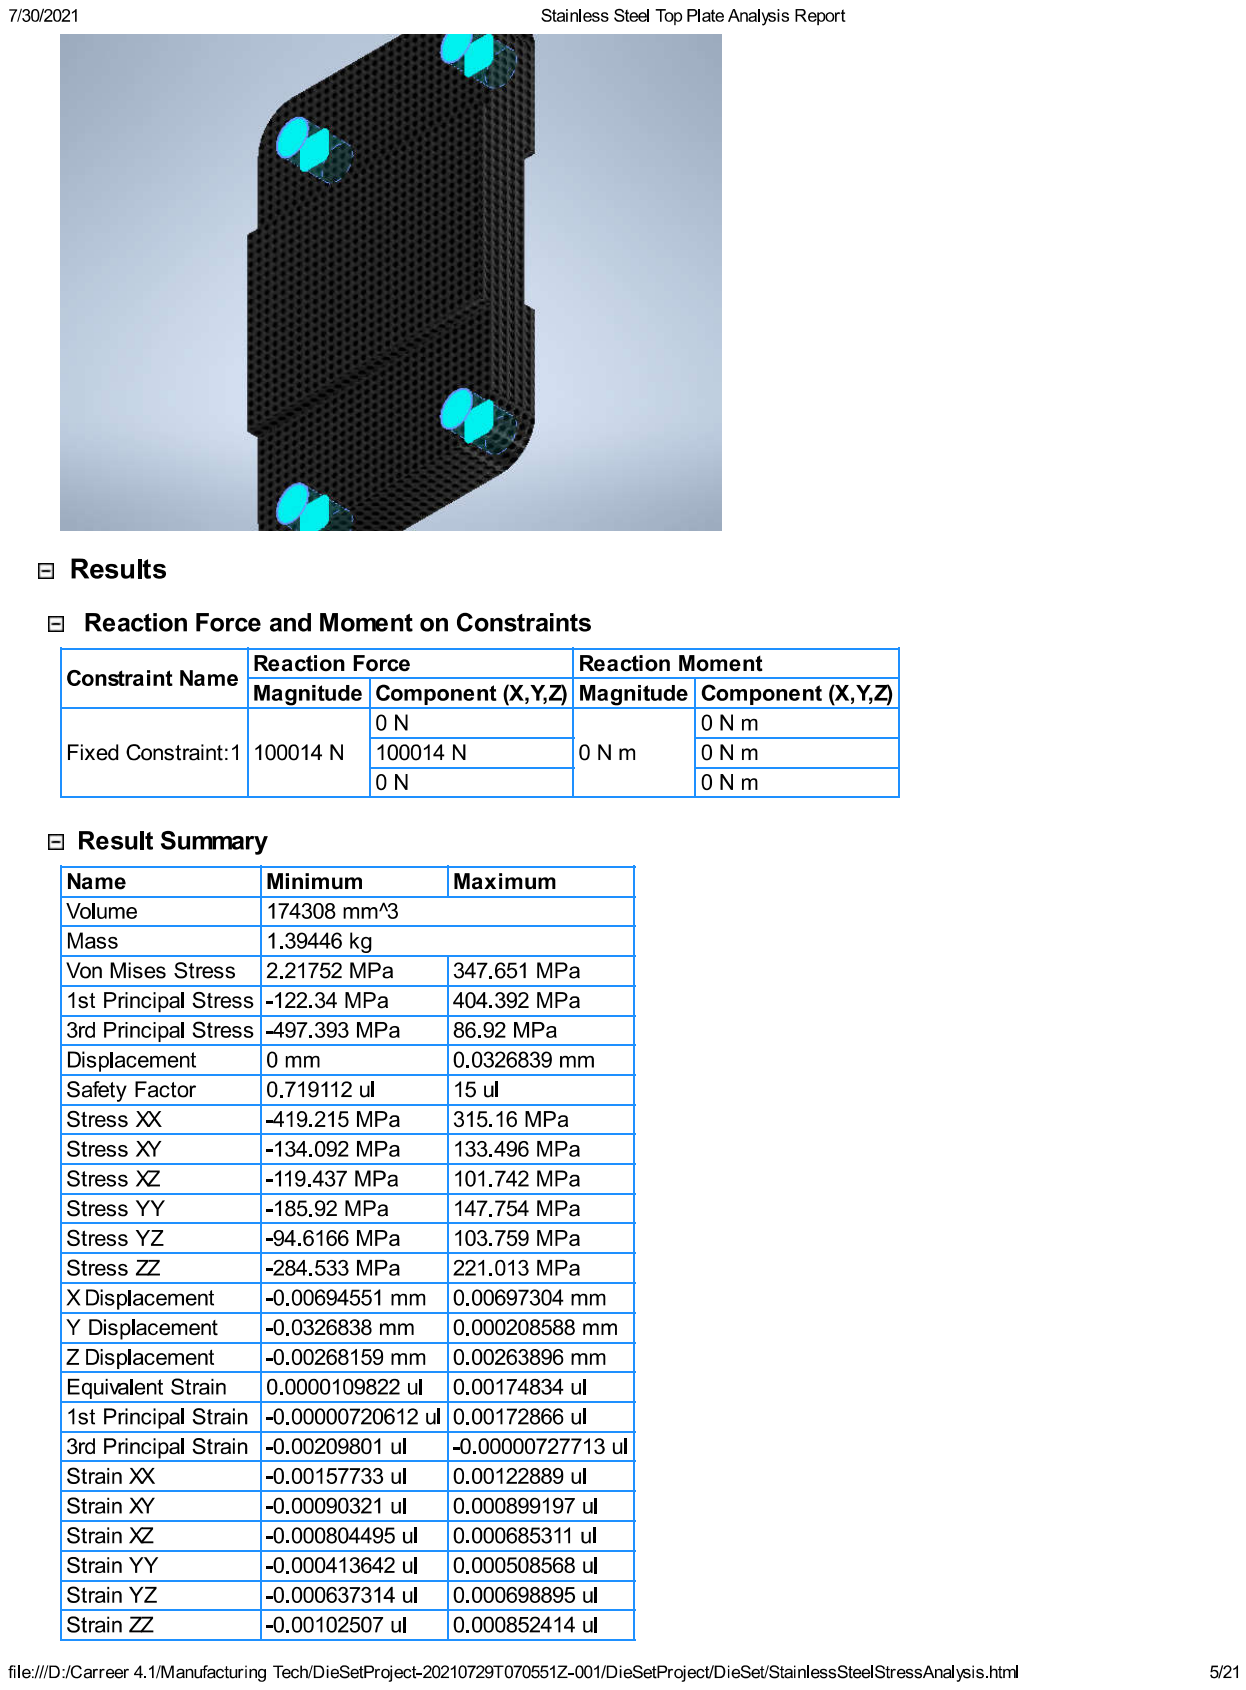
[picture p96: page 5]

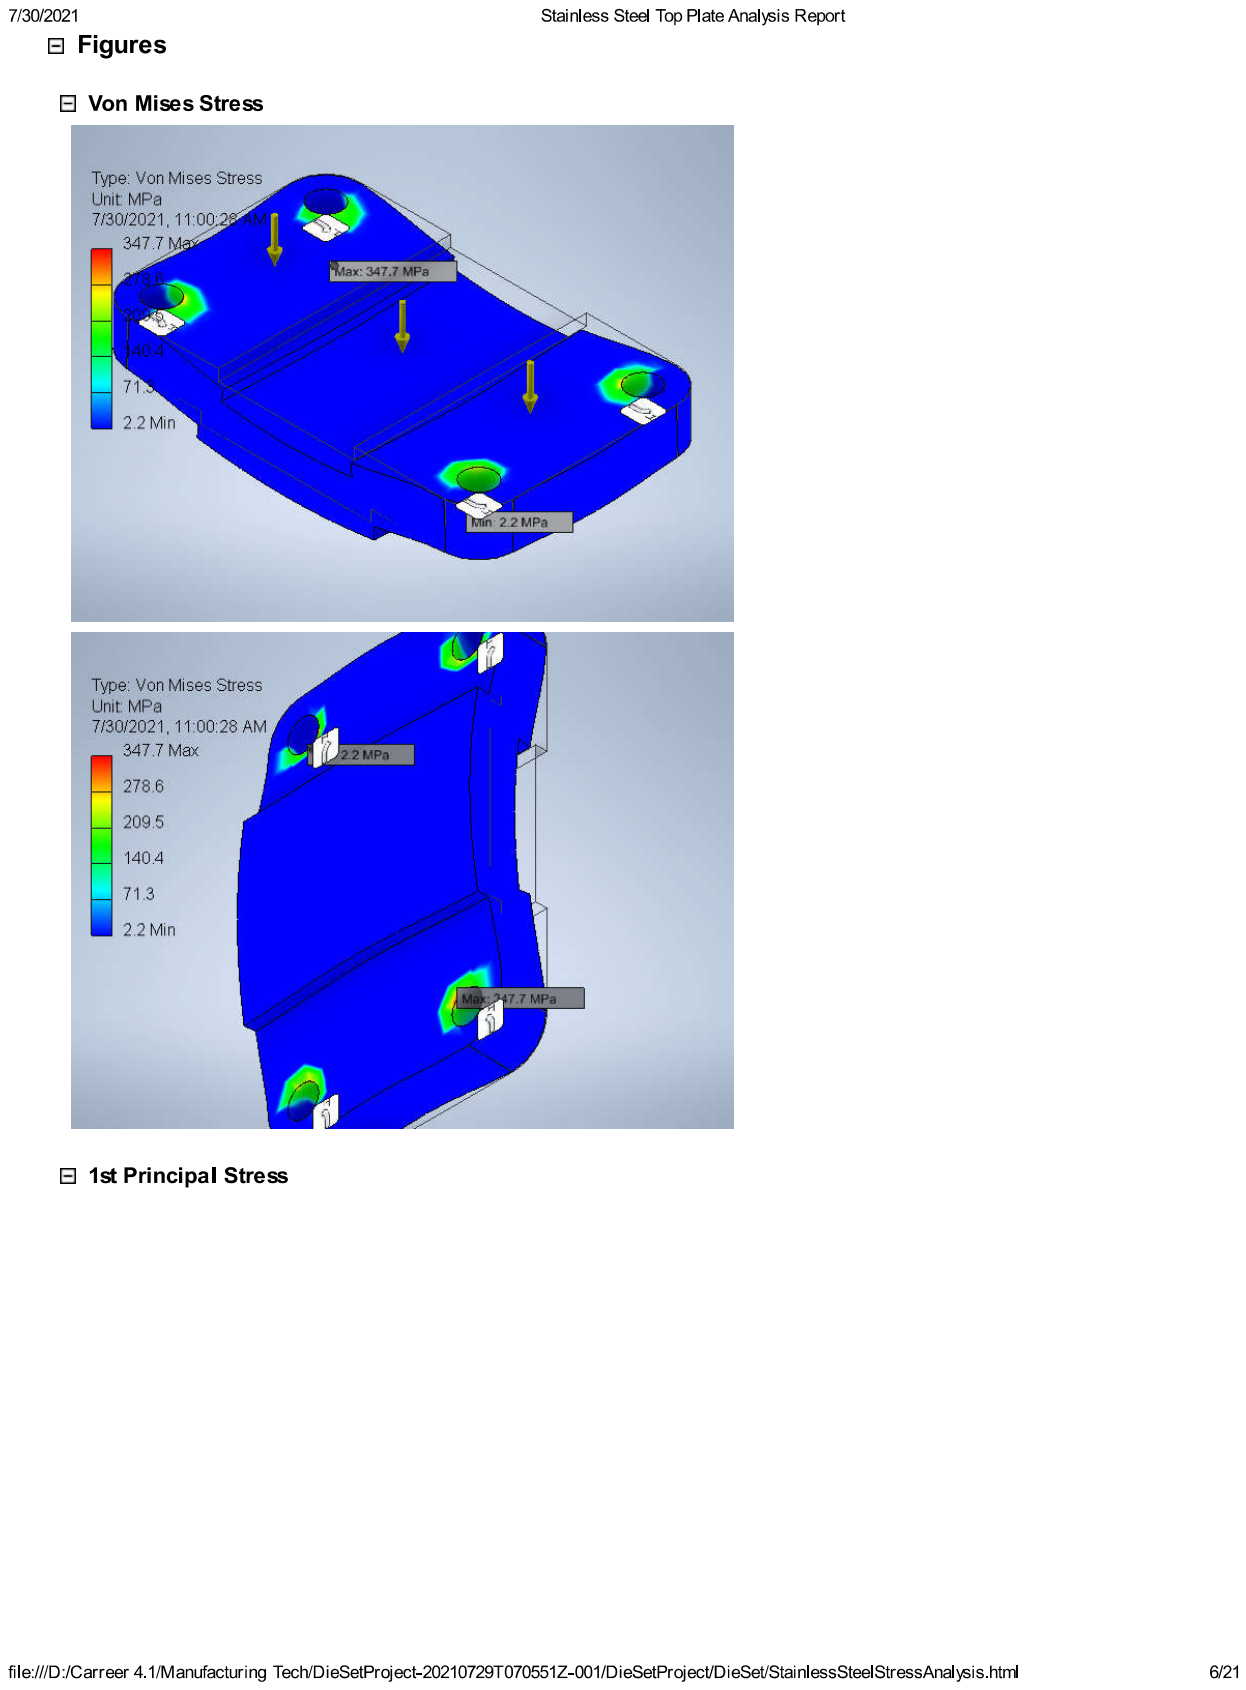
[picture p97: page 6]

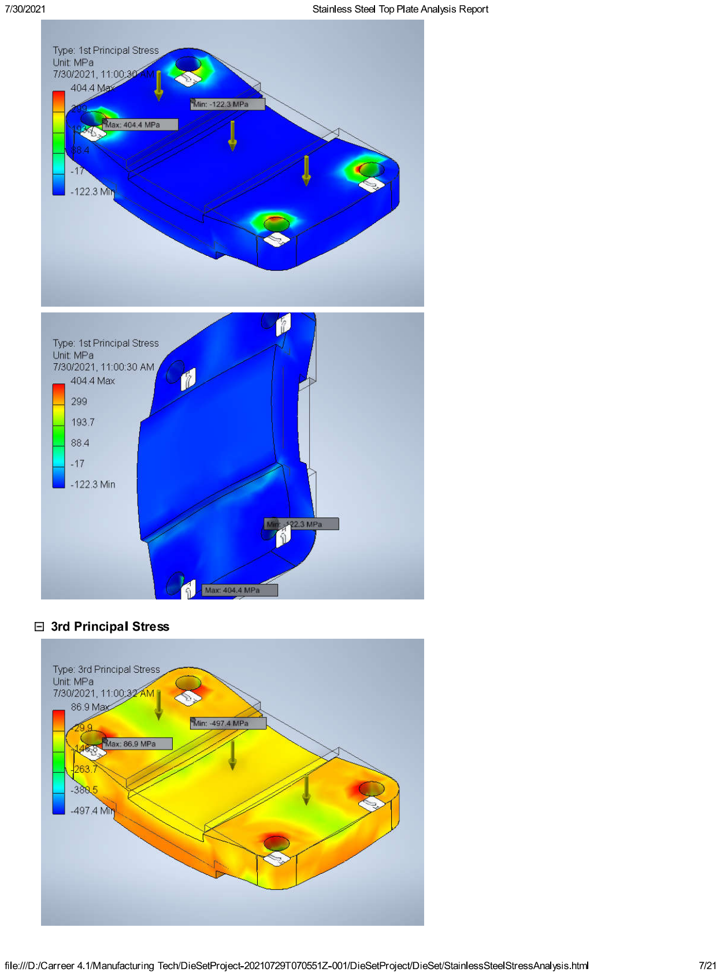
[picture p98: page 7]

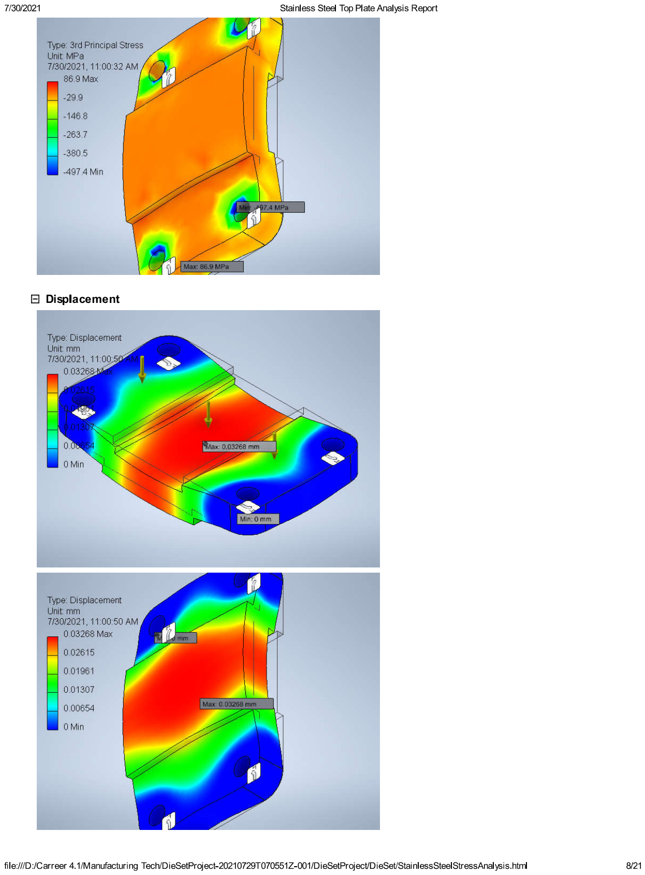
[picture p99: page 8]

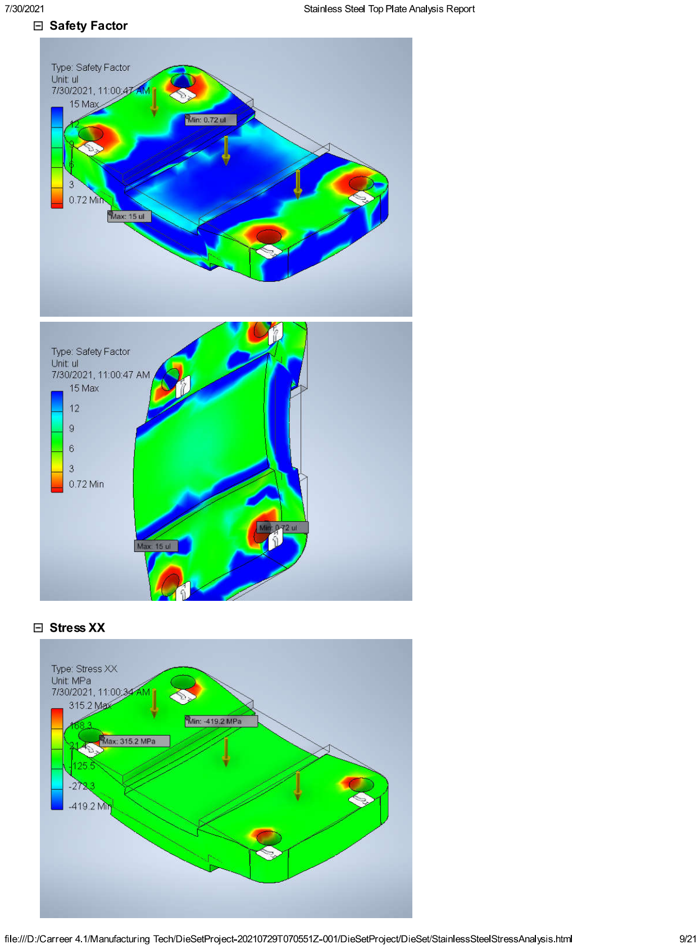
[picture p100: page 9]

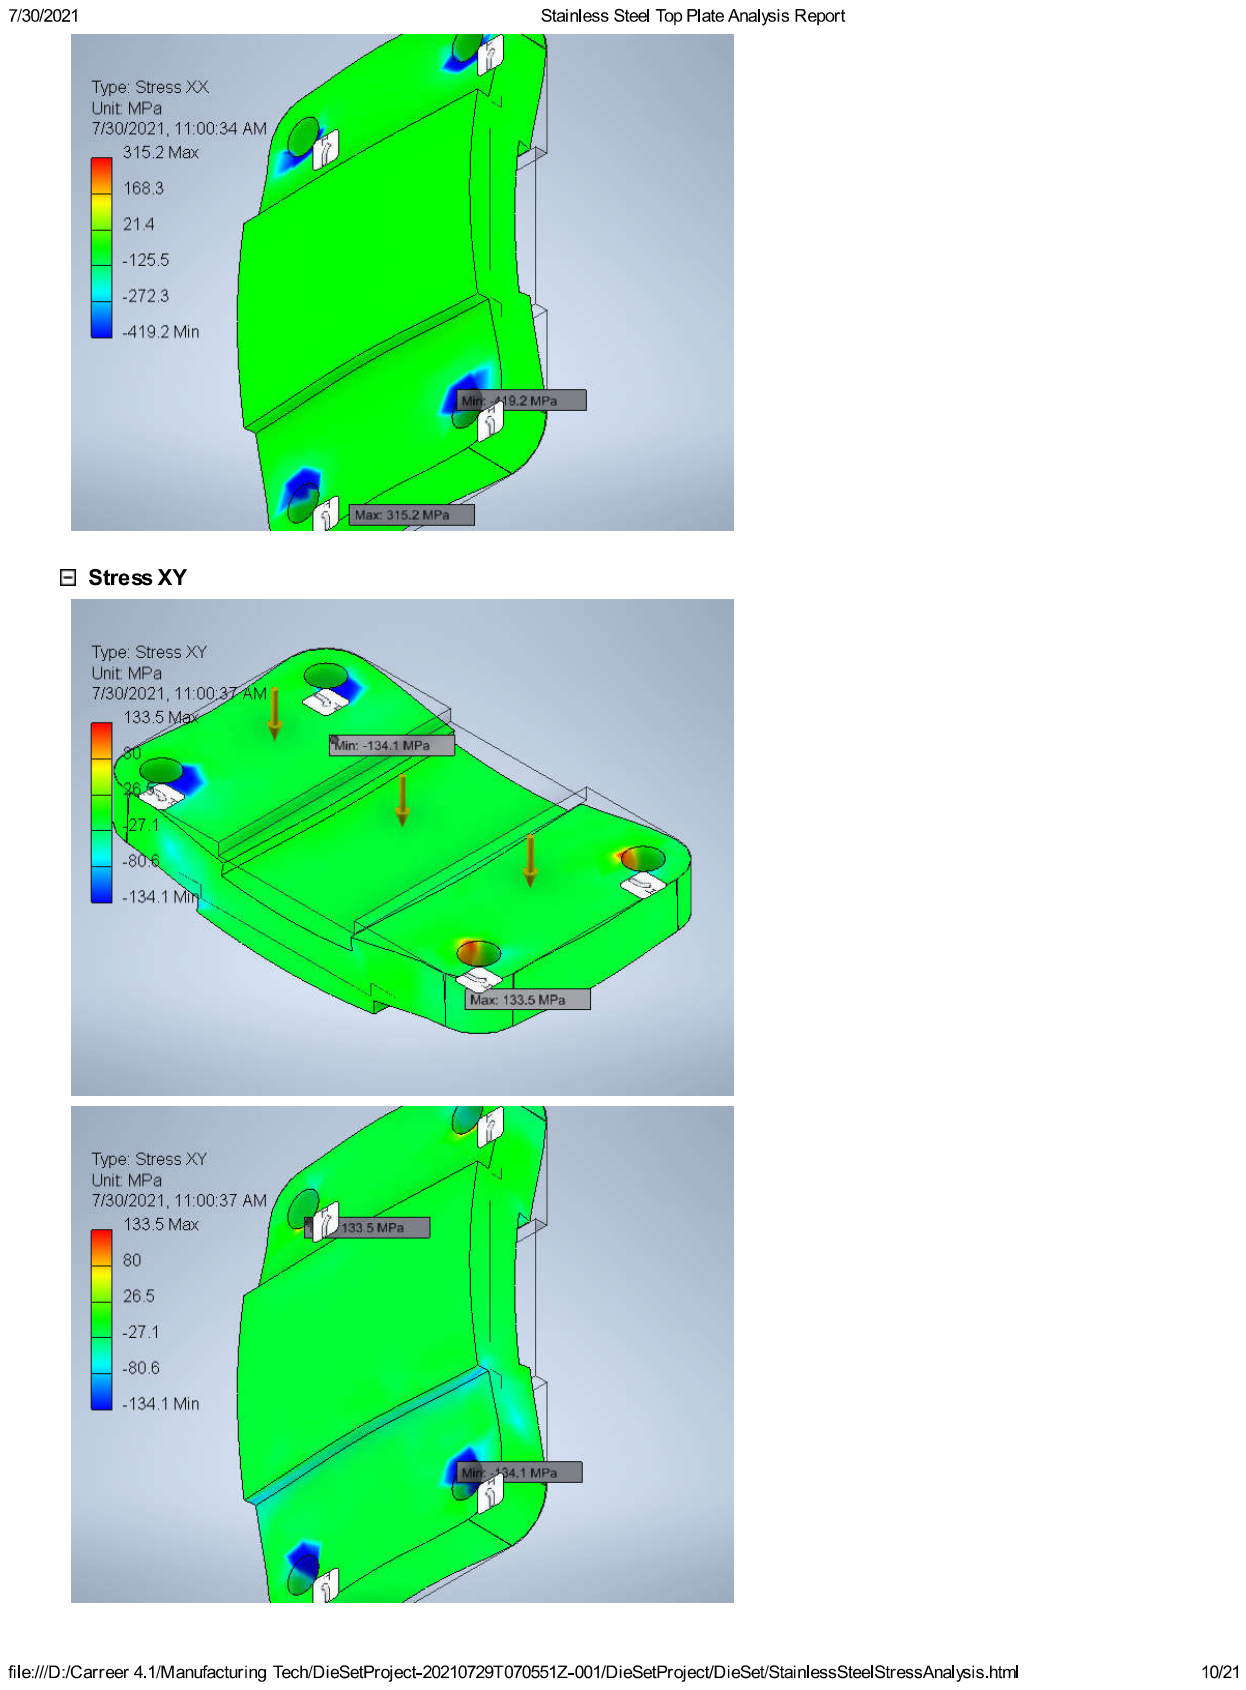
[picture p101: page 10]

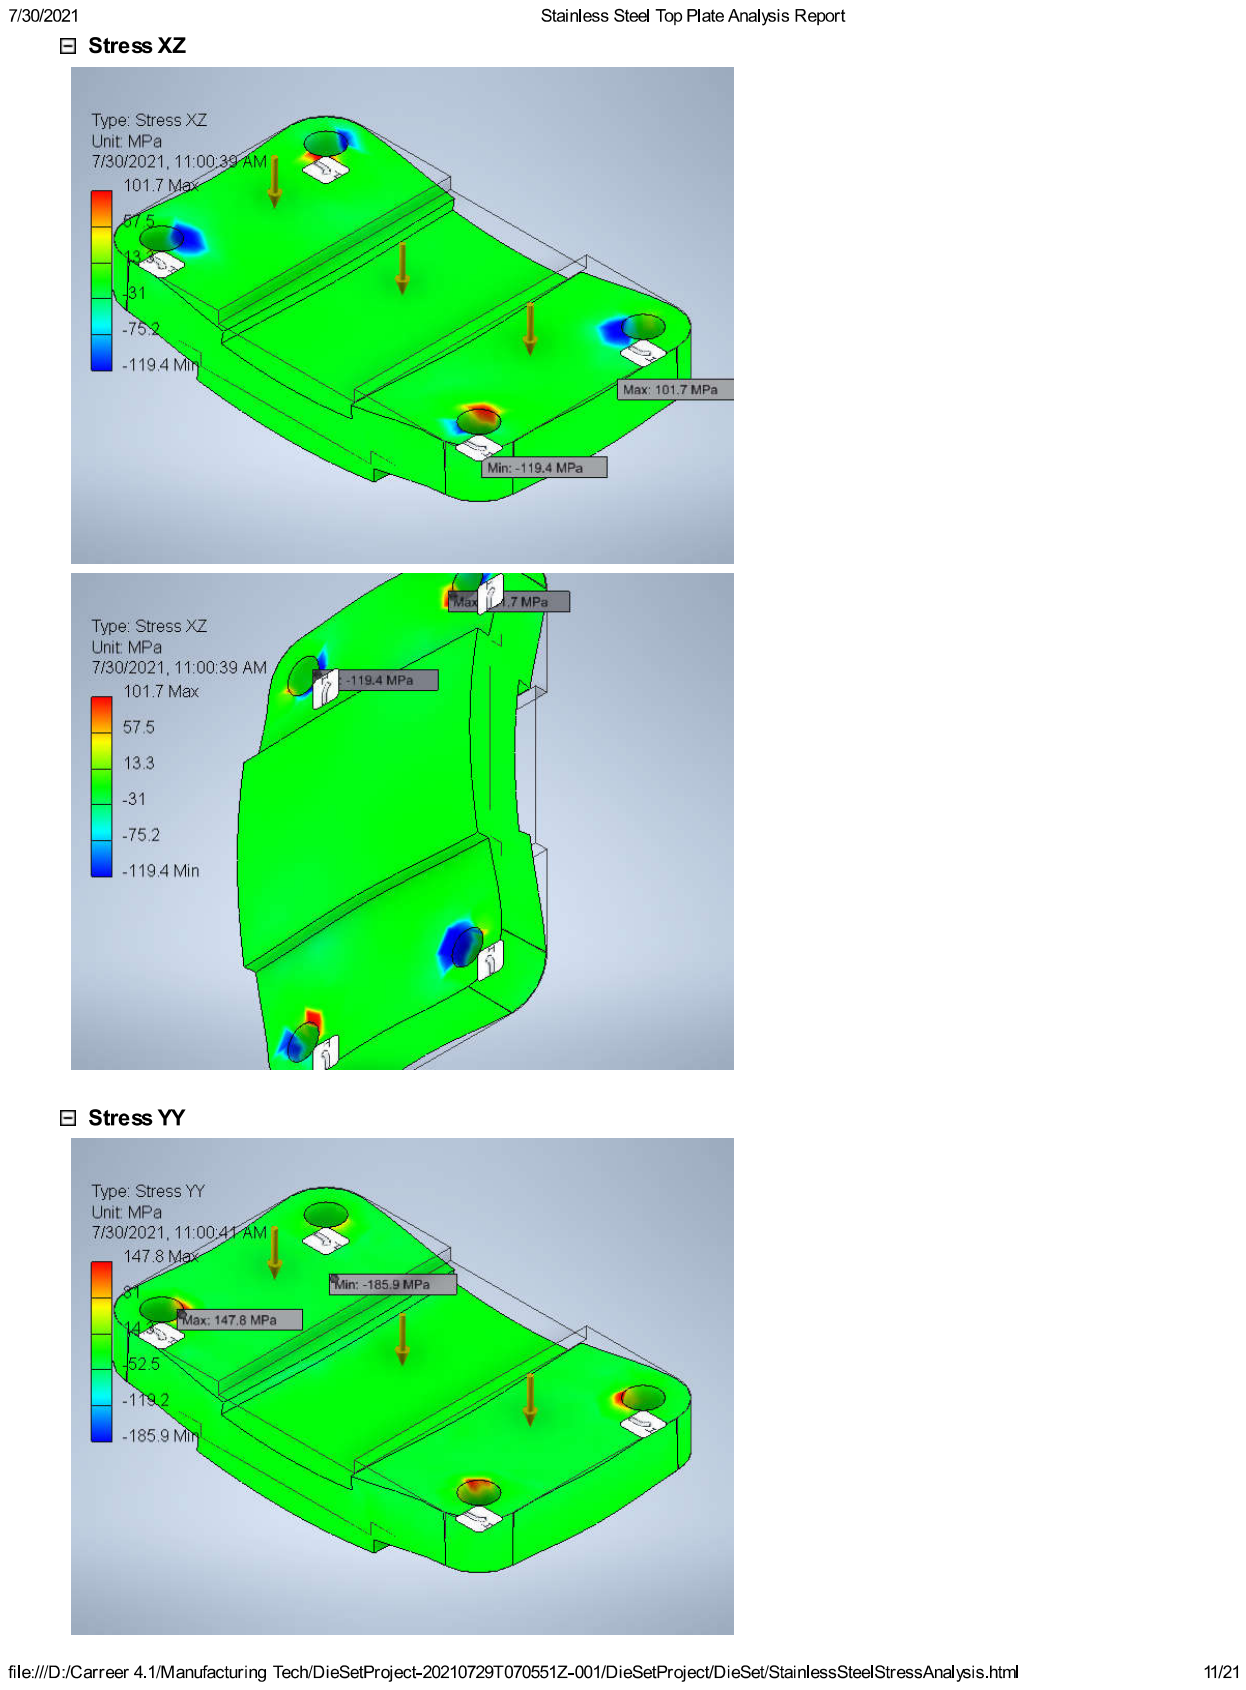
[picture p102: page 11]

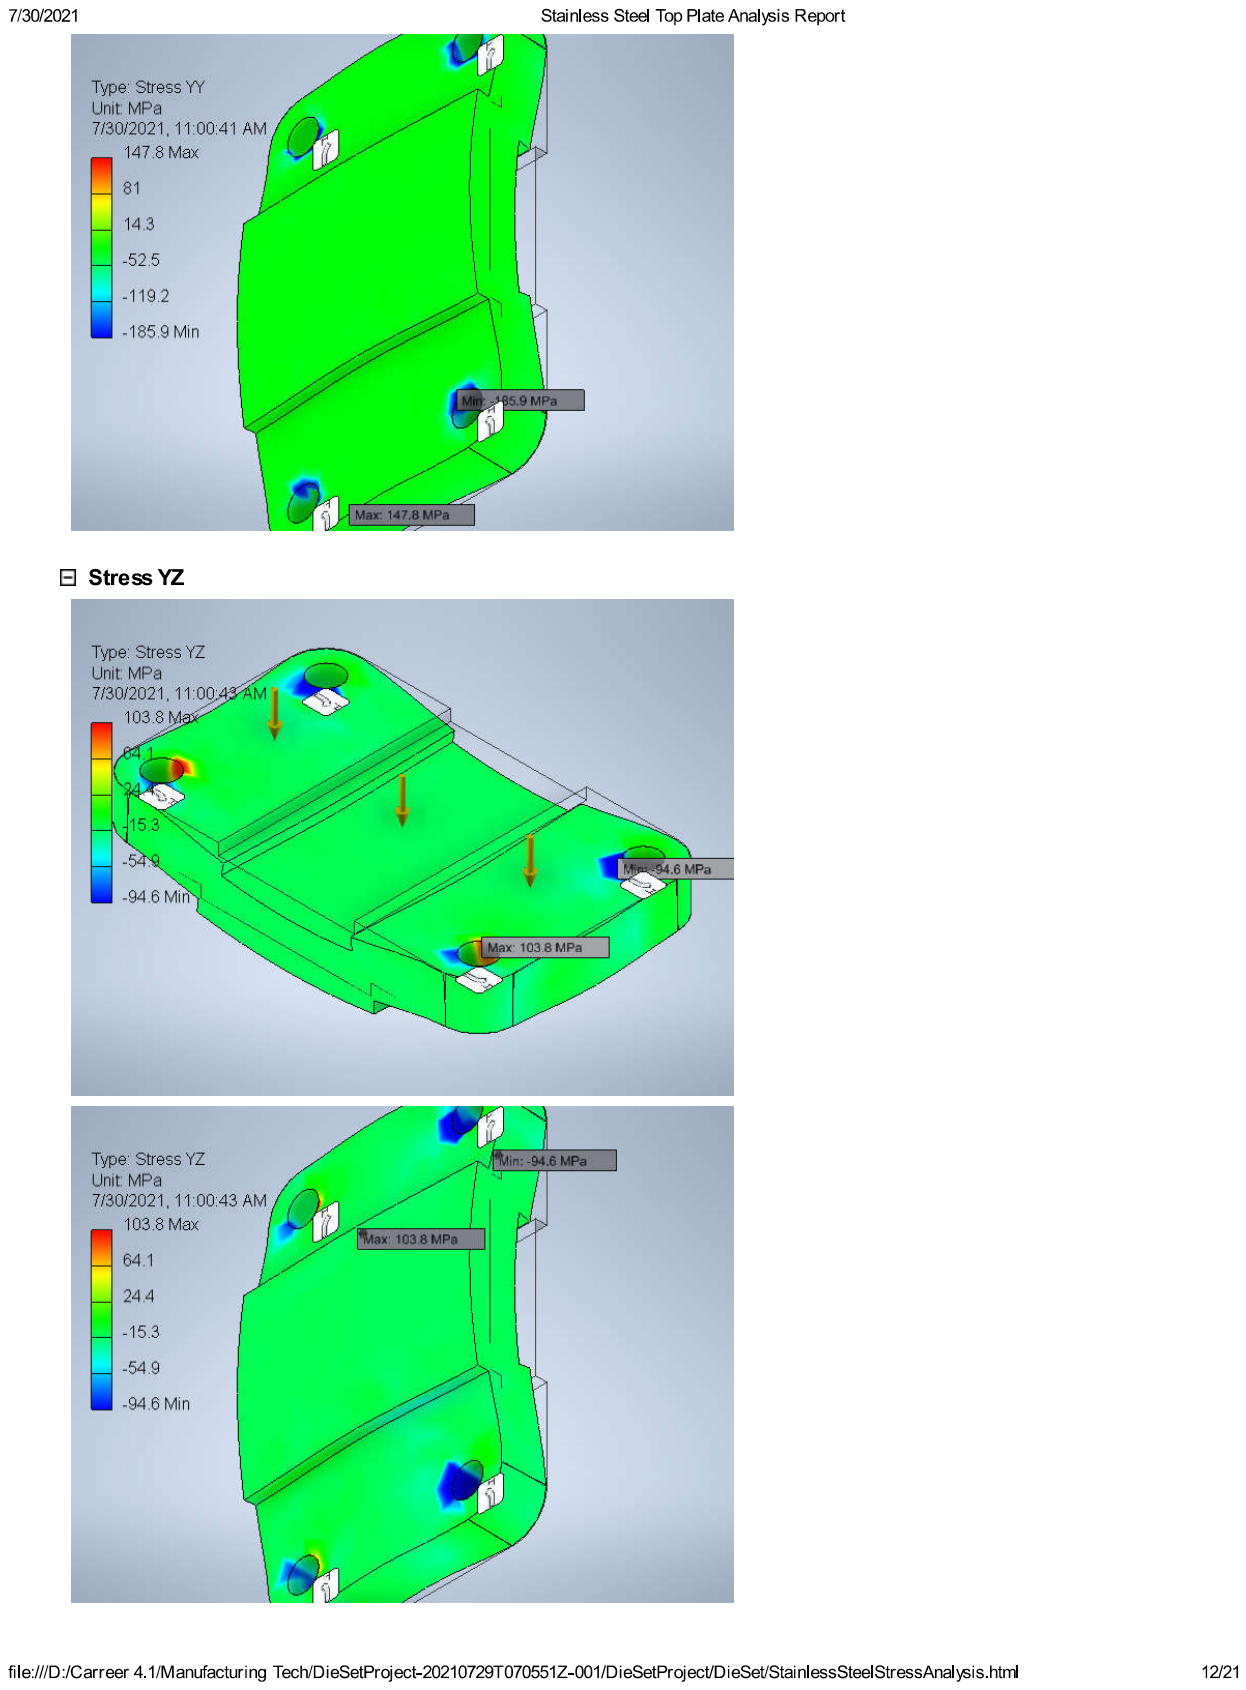
[picture p103: page 12]

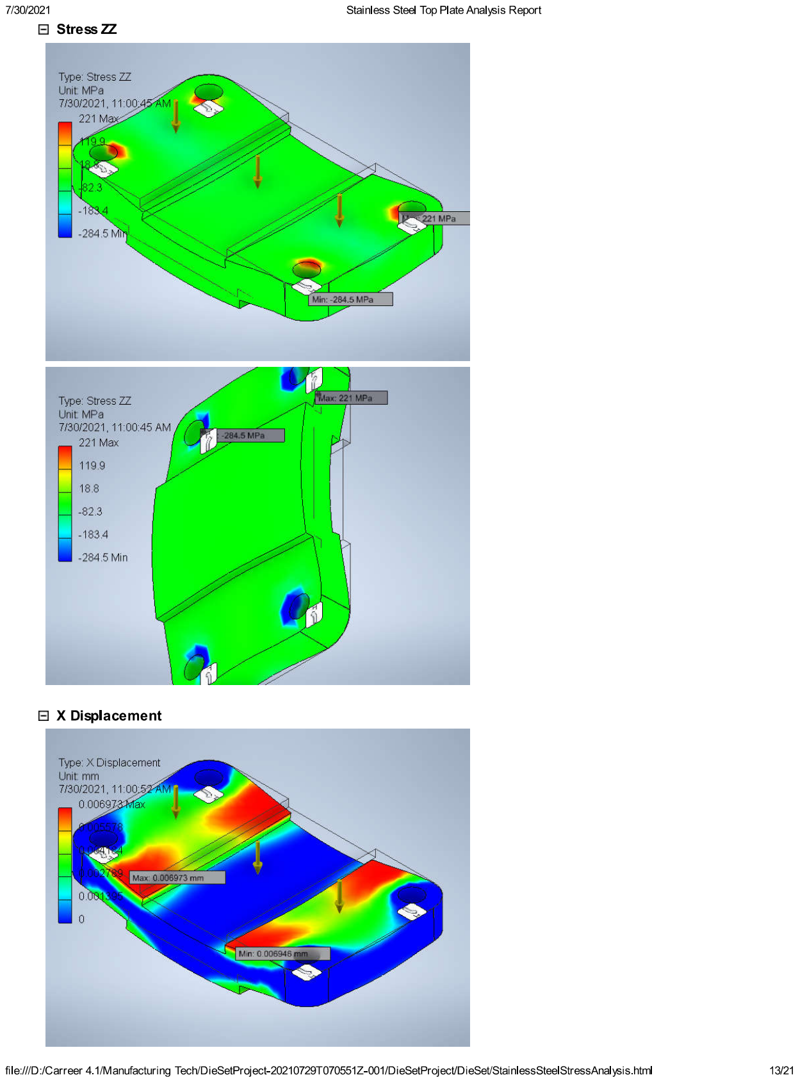
[picture p104: page 13]

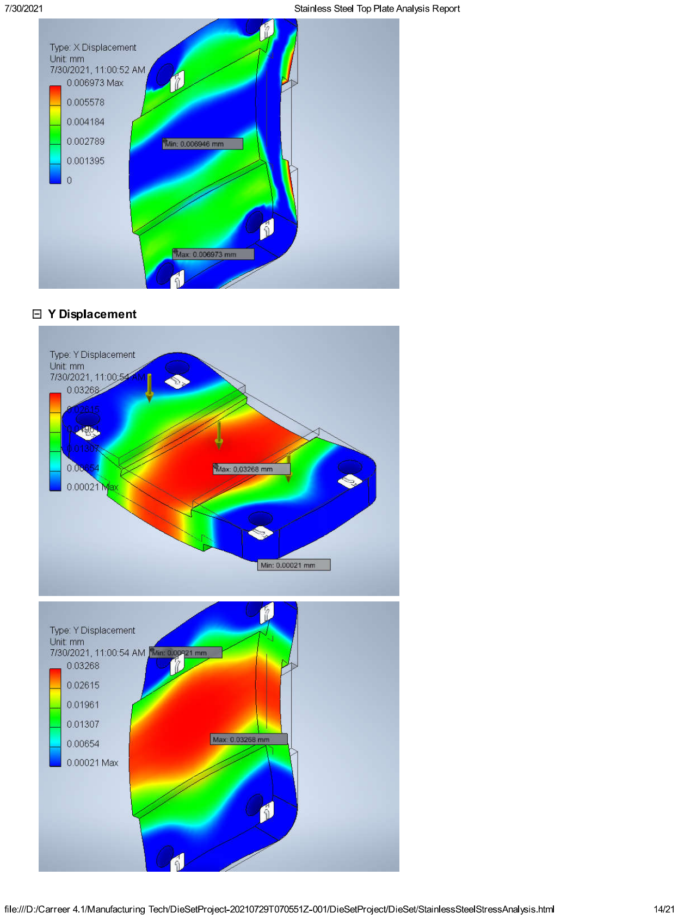
[picture p105: page 14]

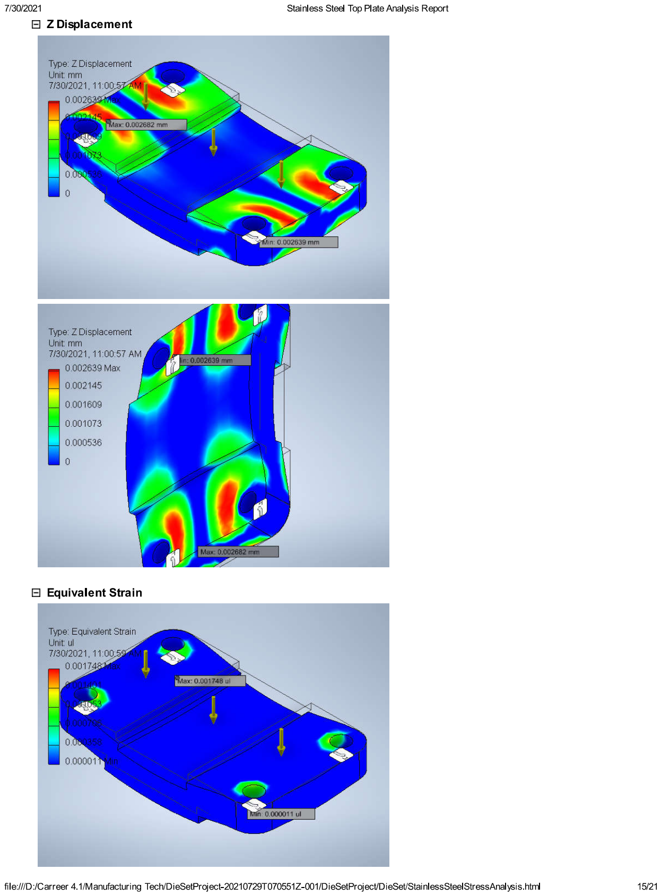
[picture p106: page 15]

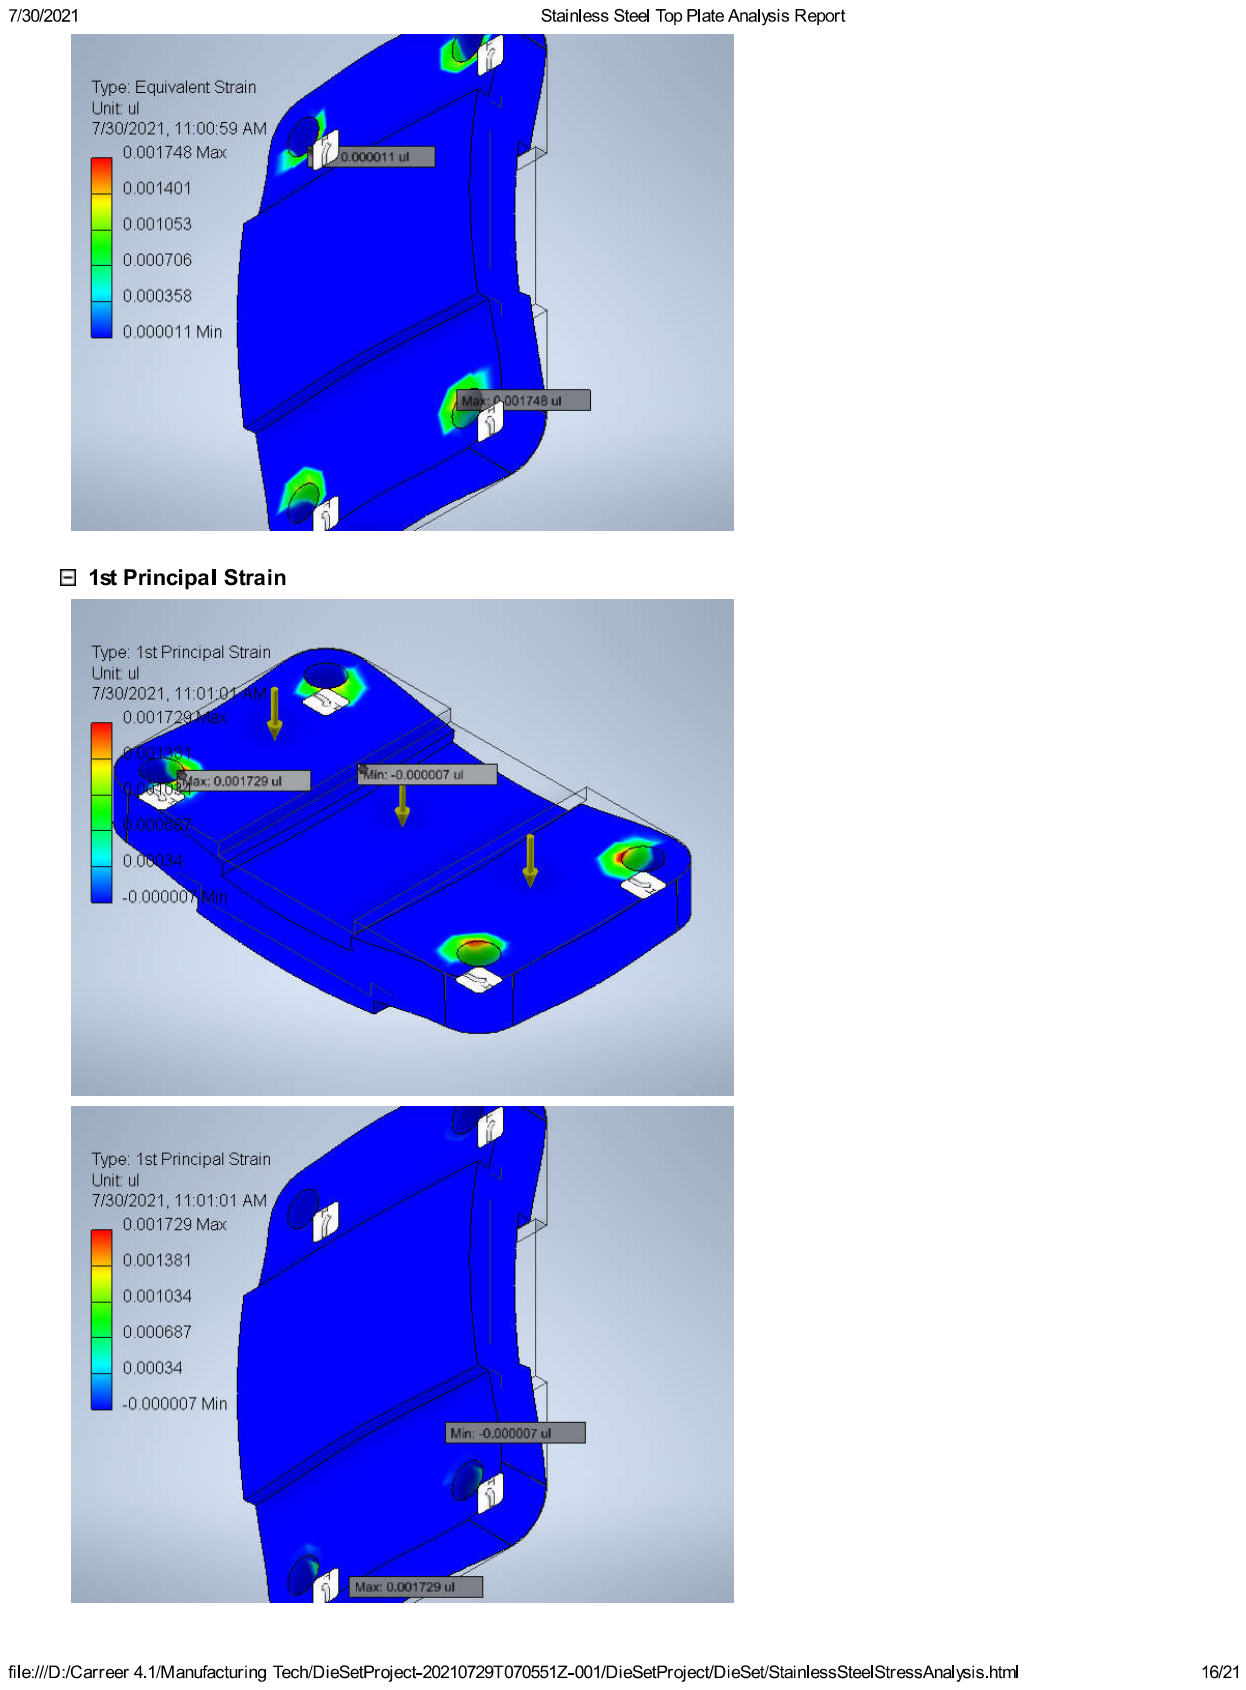
[picture p107: page 16]

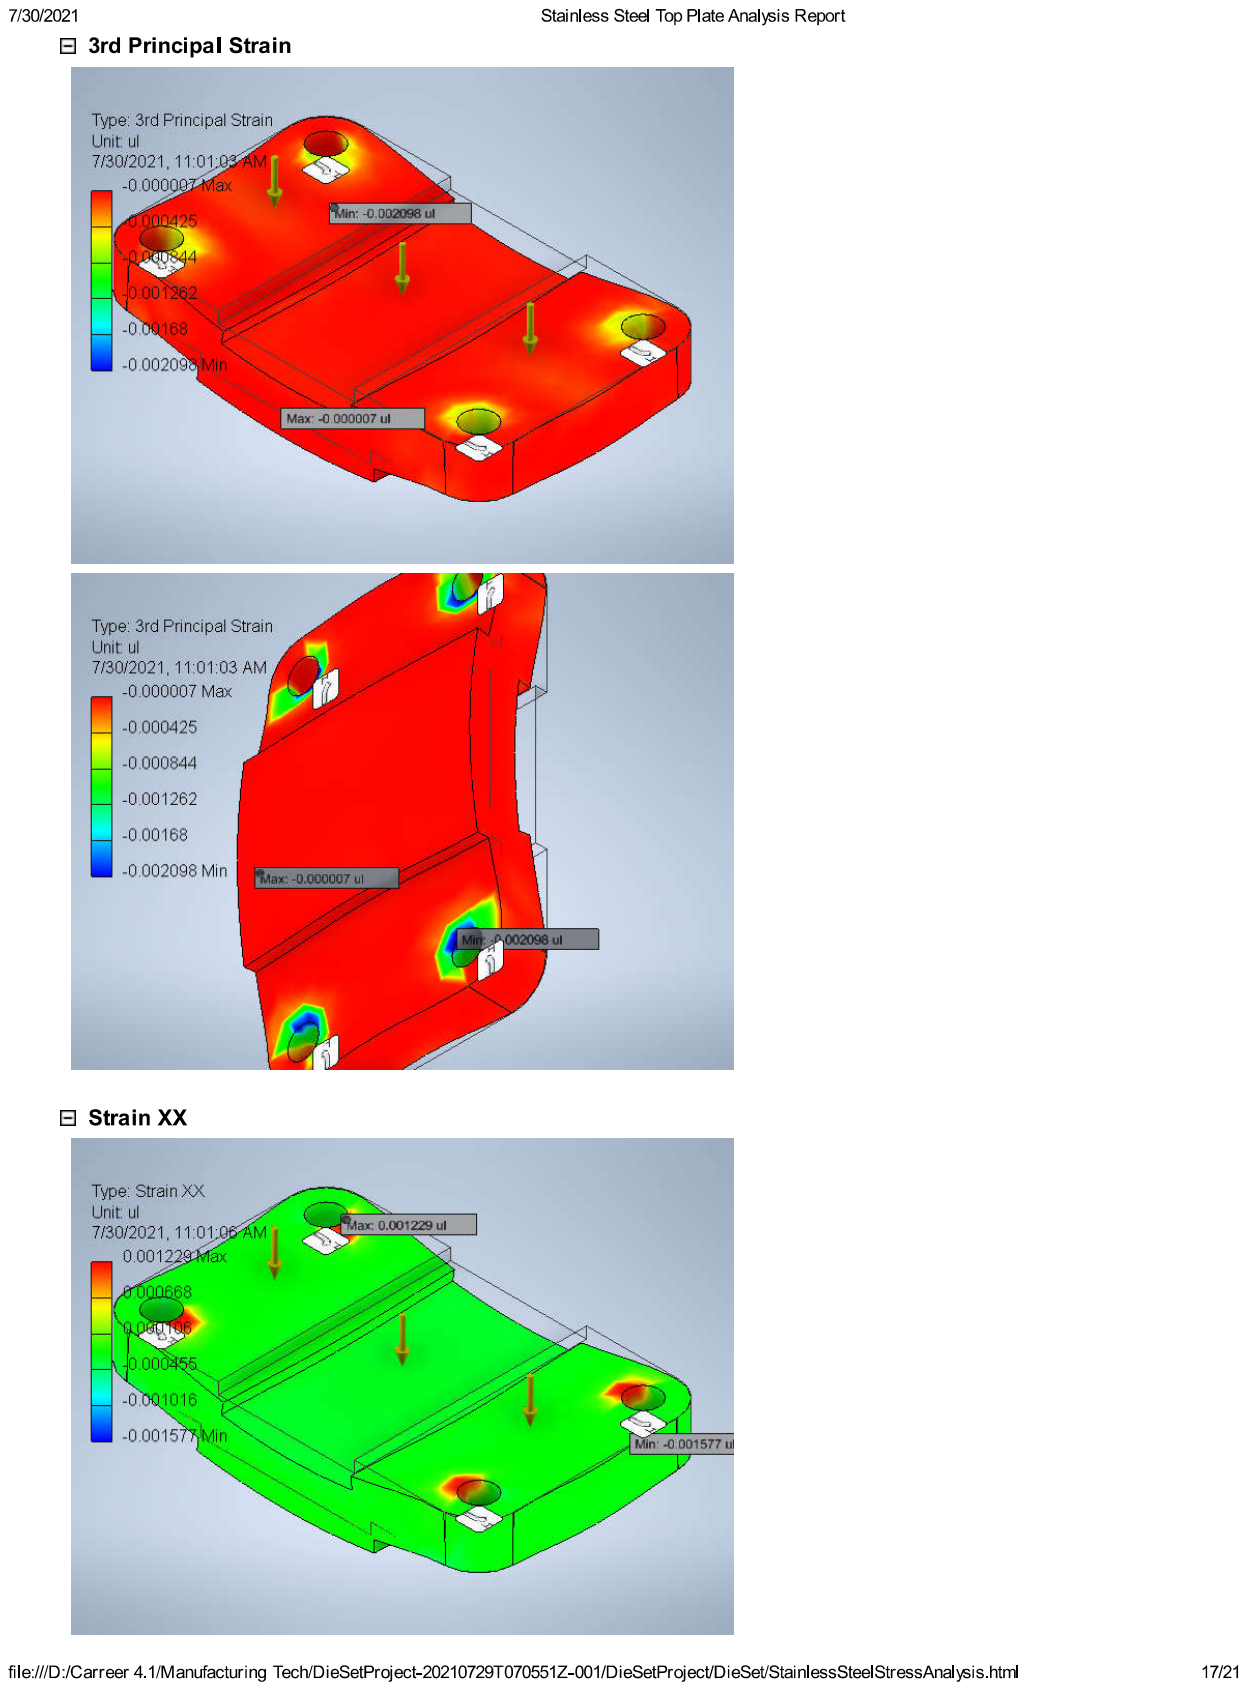
[picture p108: page 17]

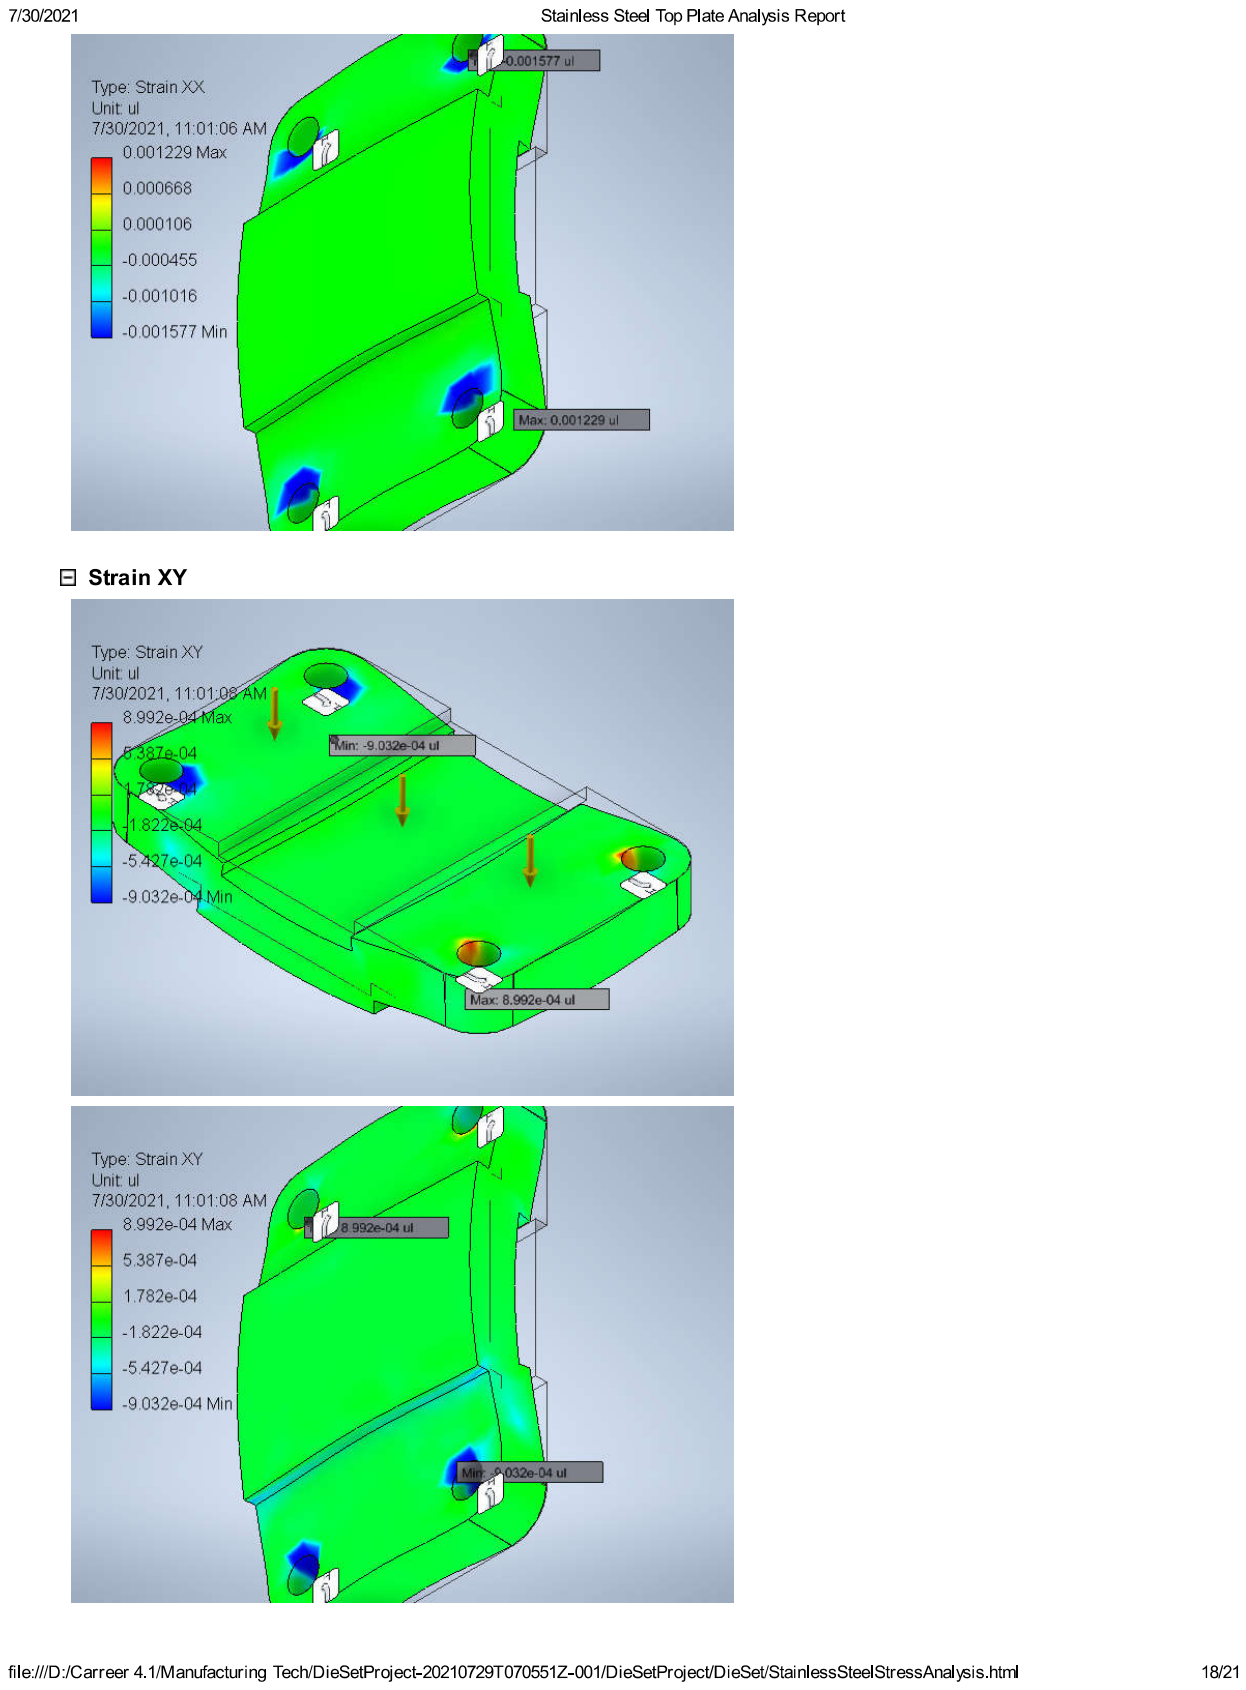
[picture p109: page 18]

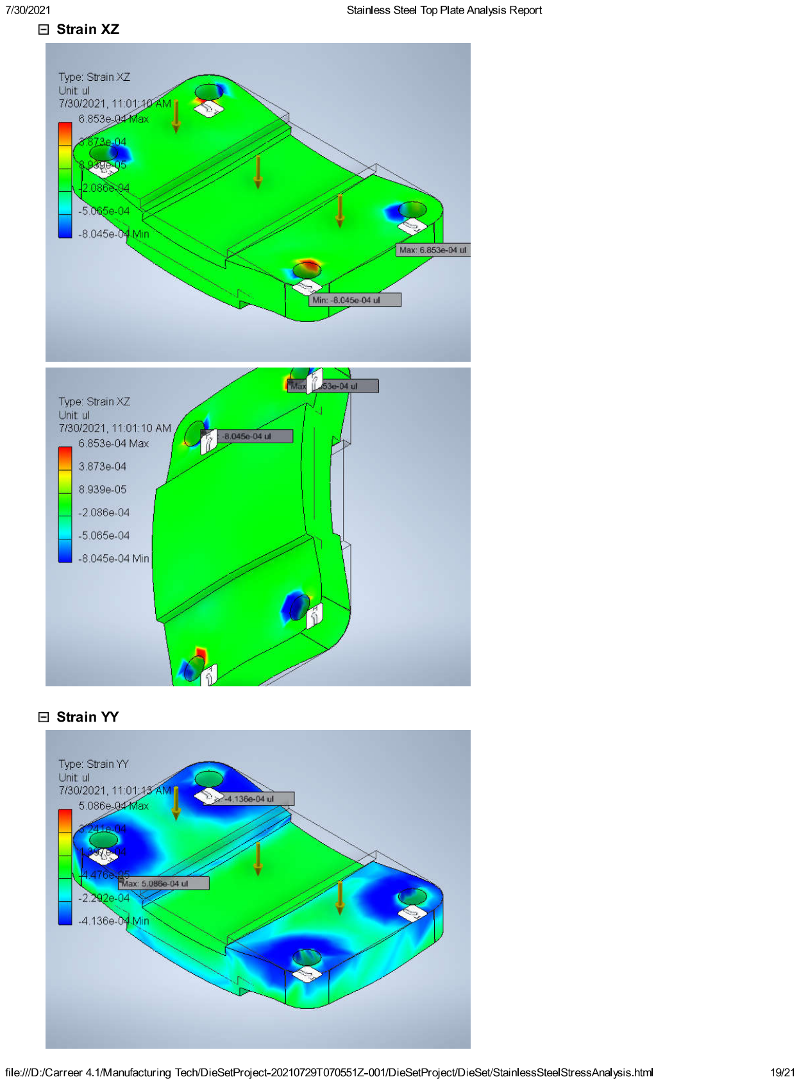
[picture p110: page 19]

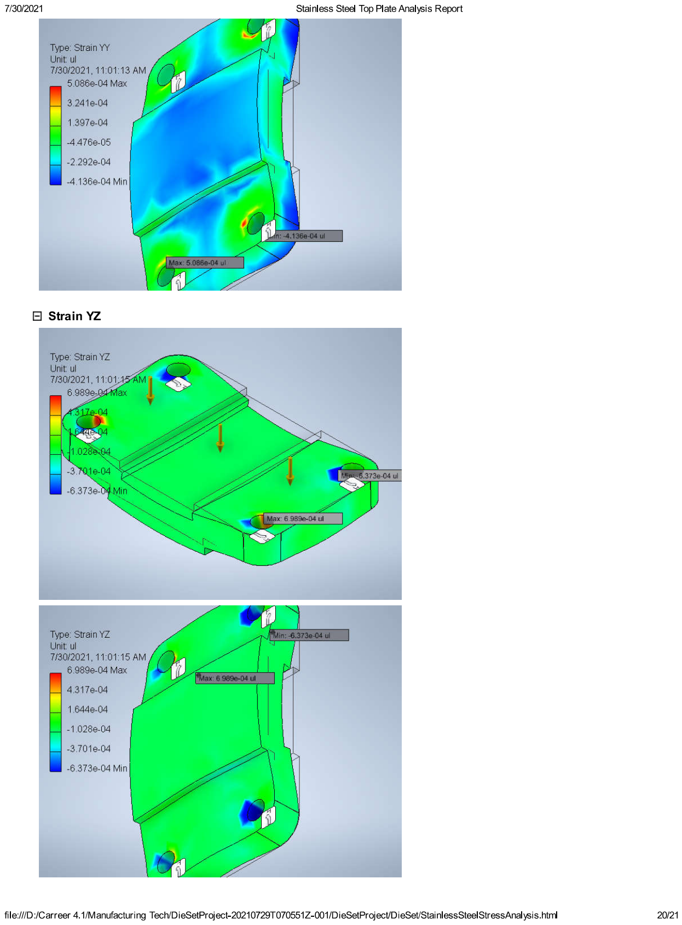
[picture p111: page 20]

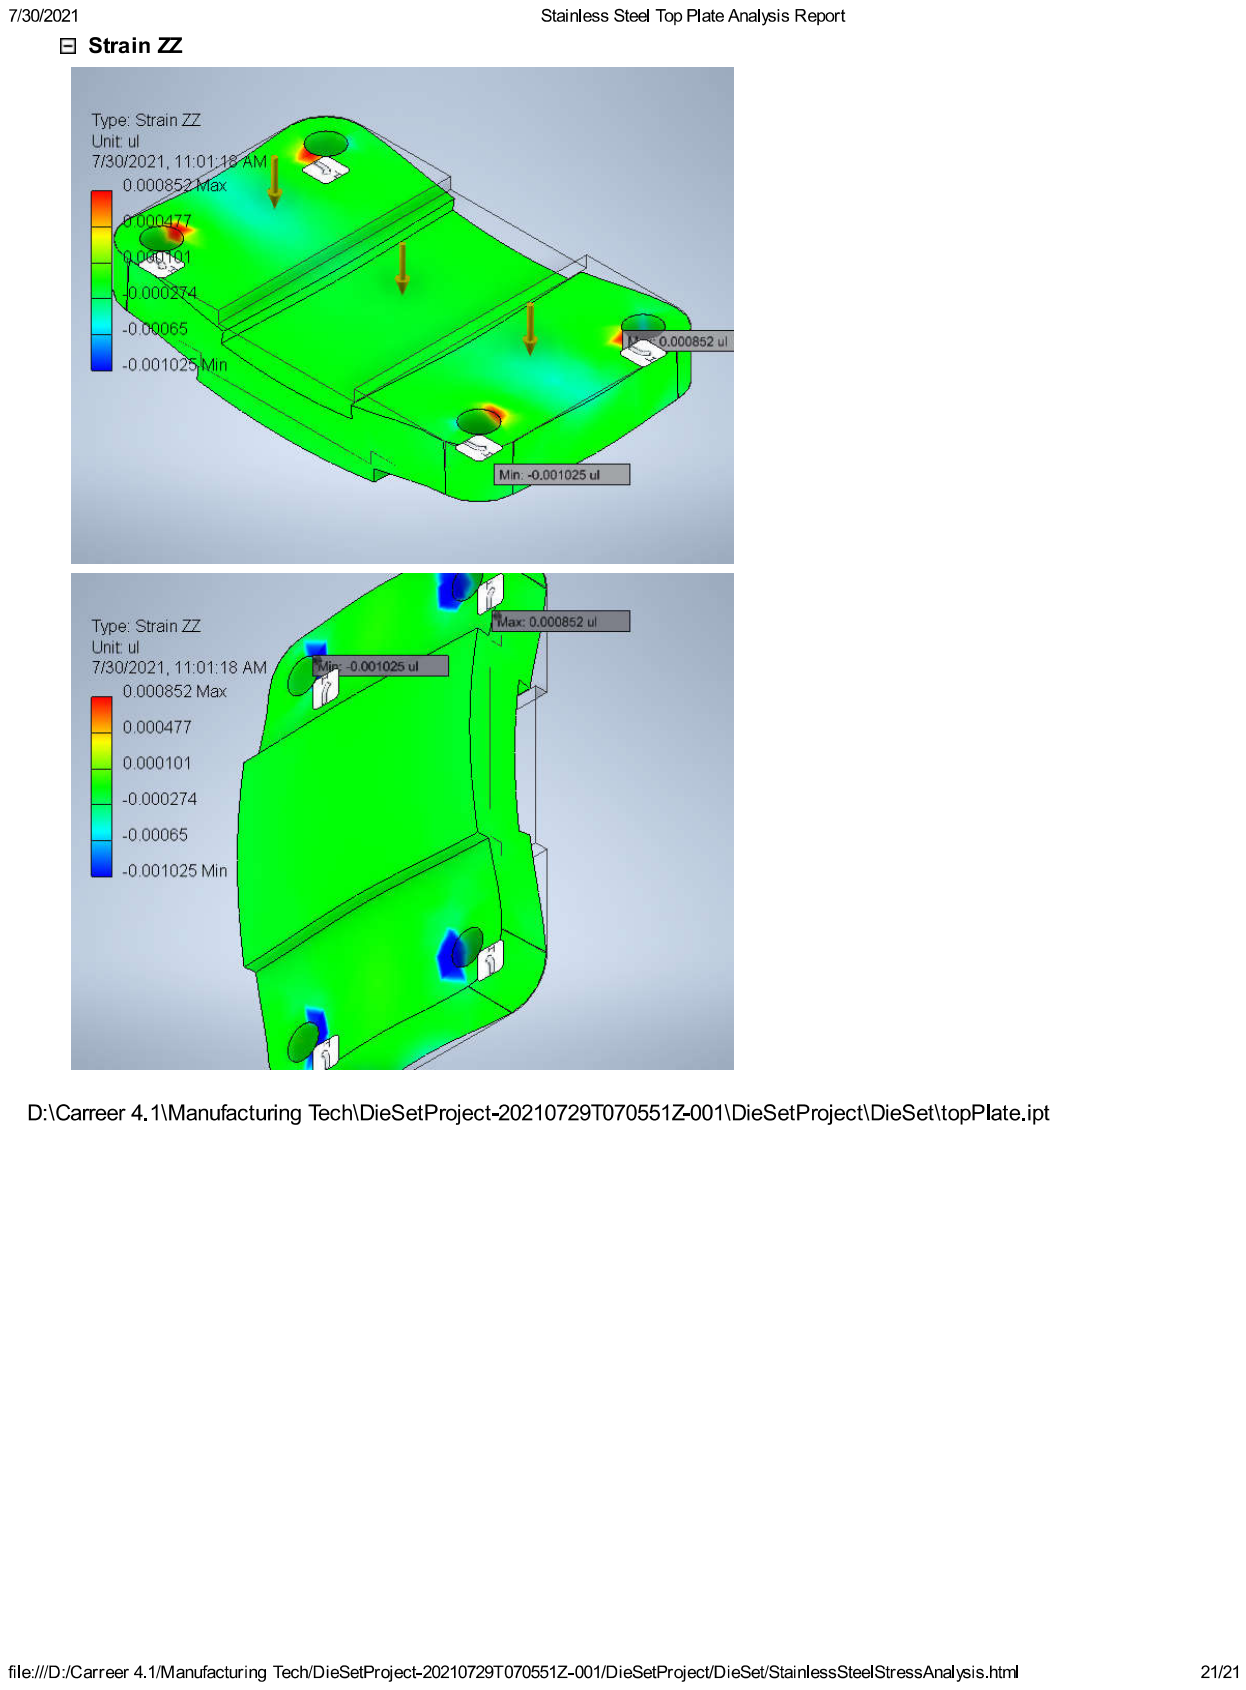
[picture p112: page 21]
