EricoDeMecha/Die-Set/Reports/DieSetAnalysisReports/Die Set Stress Analysis Report.pdf

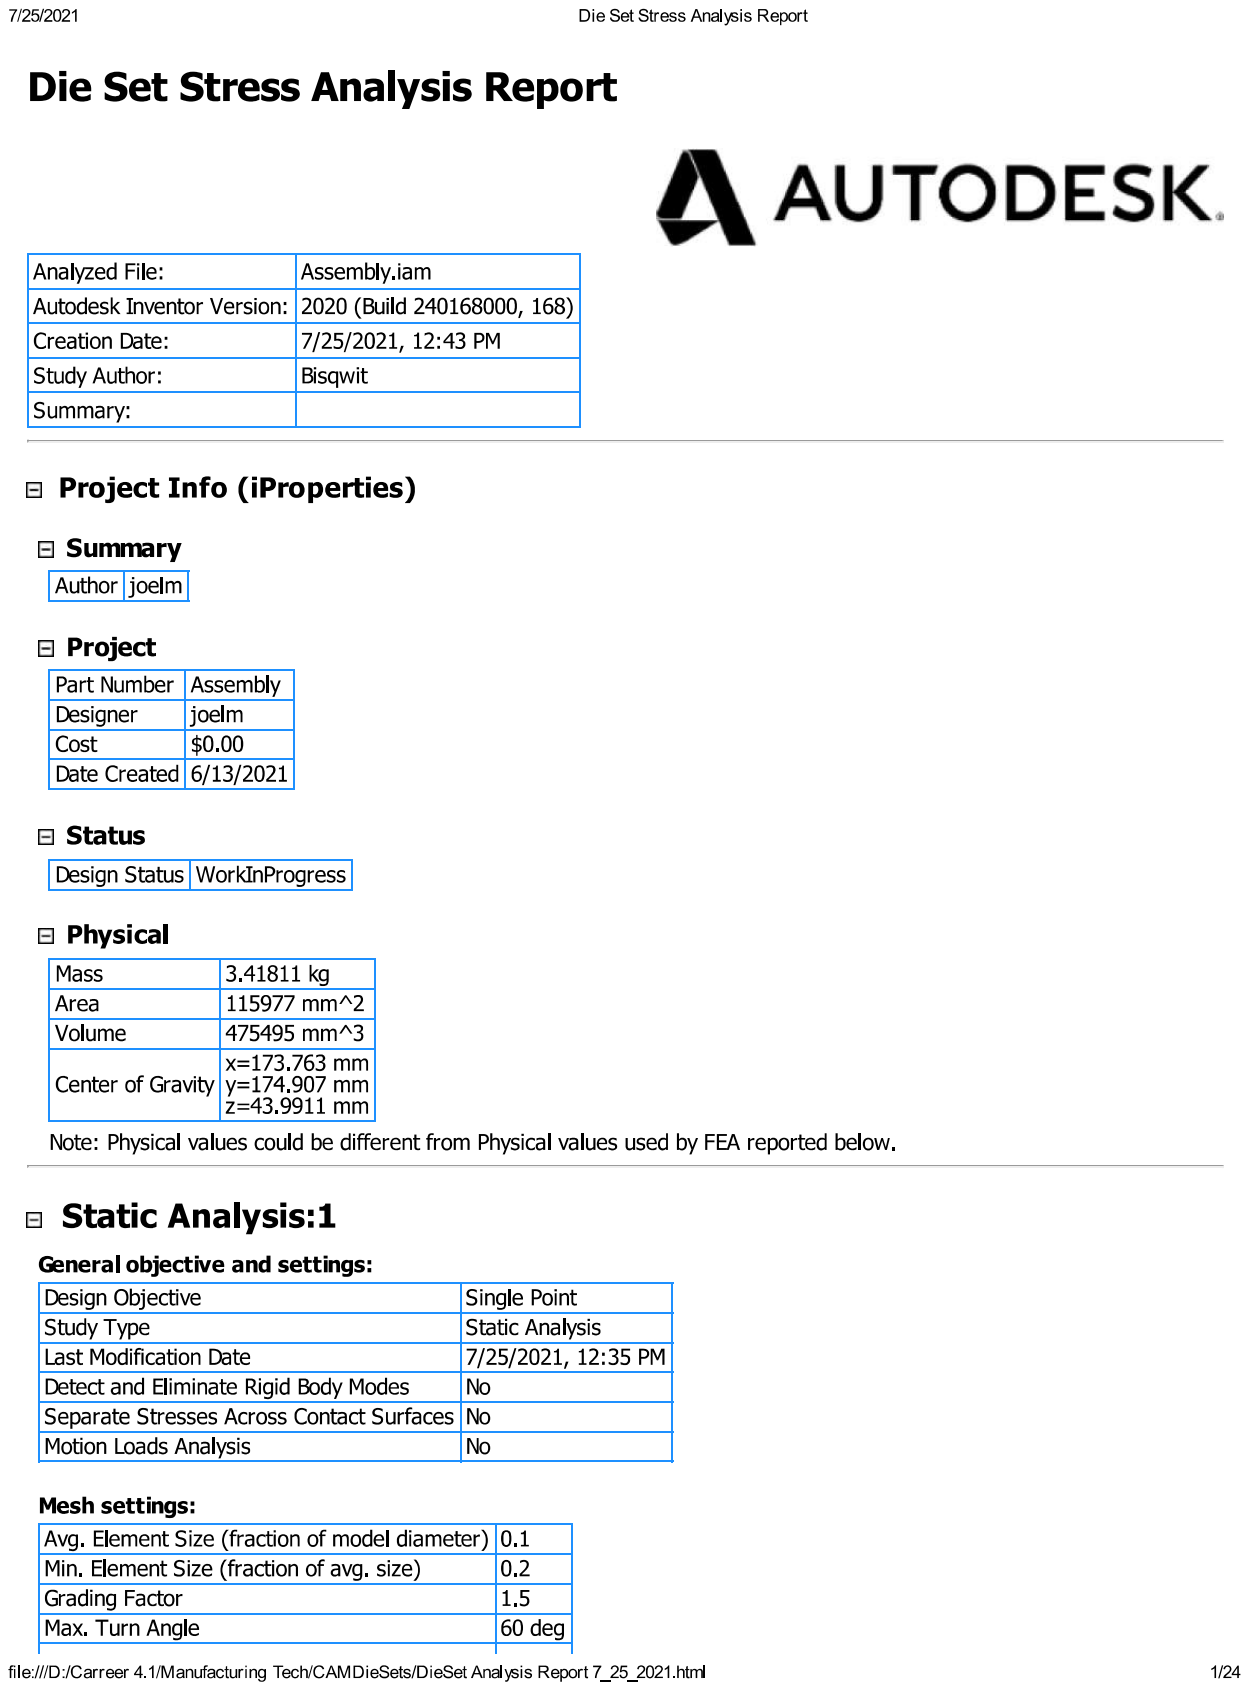
[picture p113: page 1]

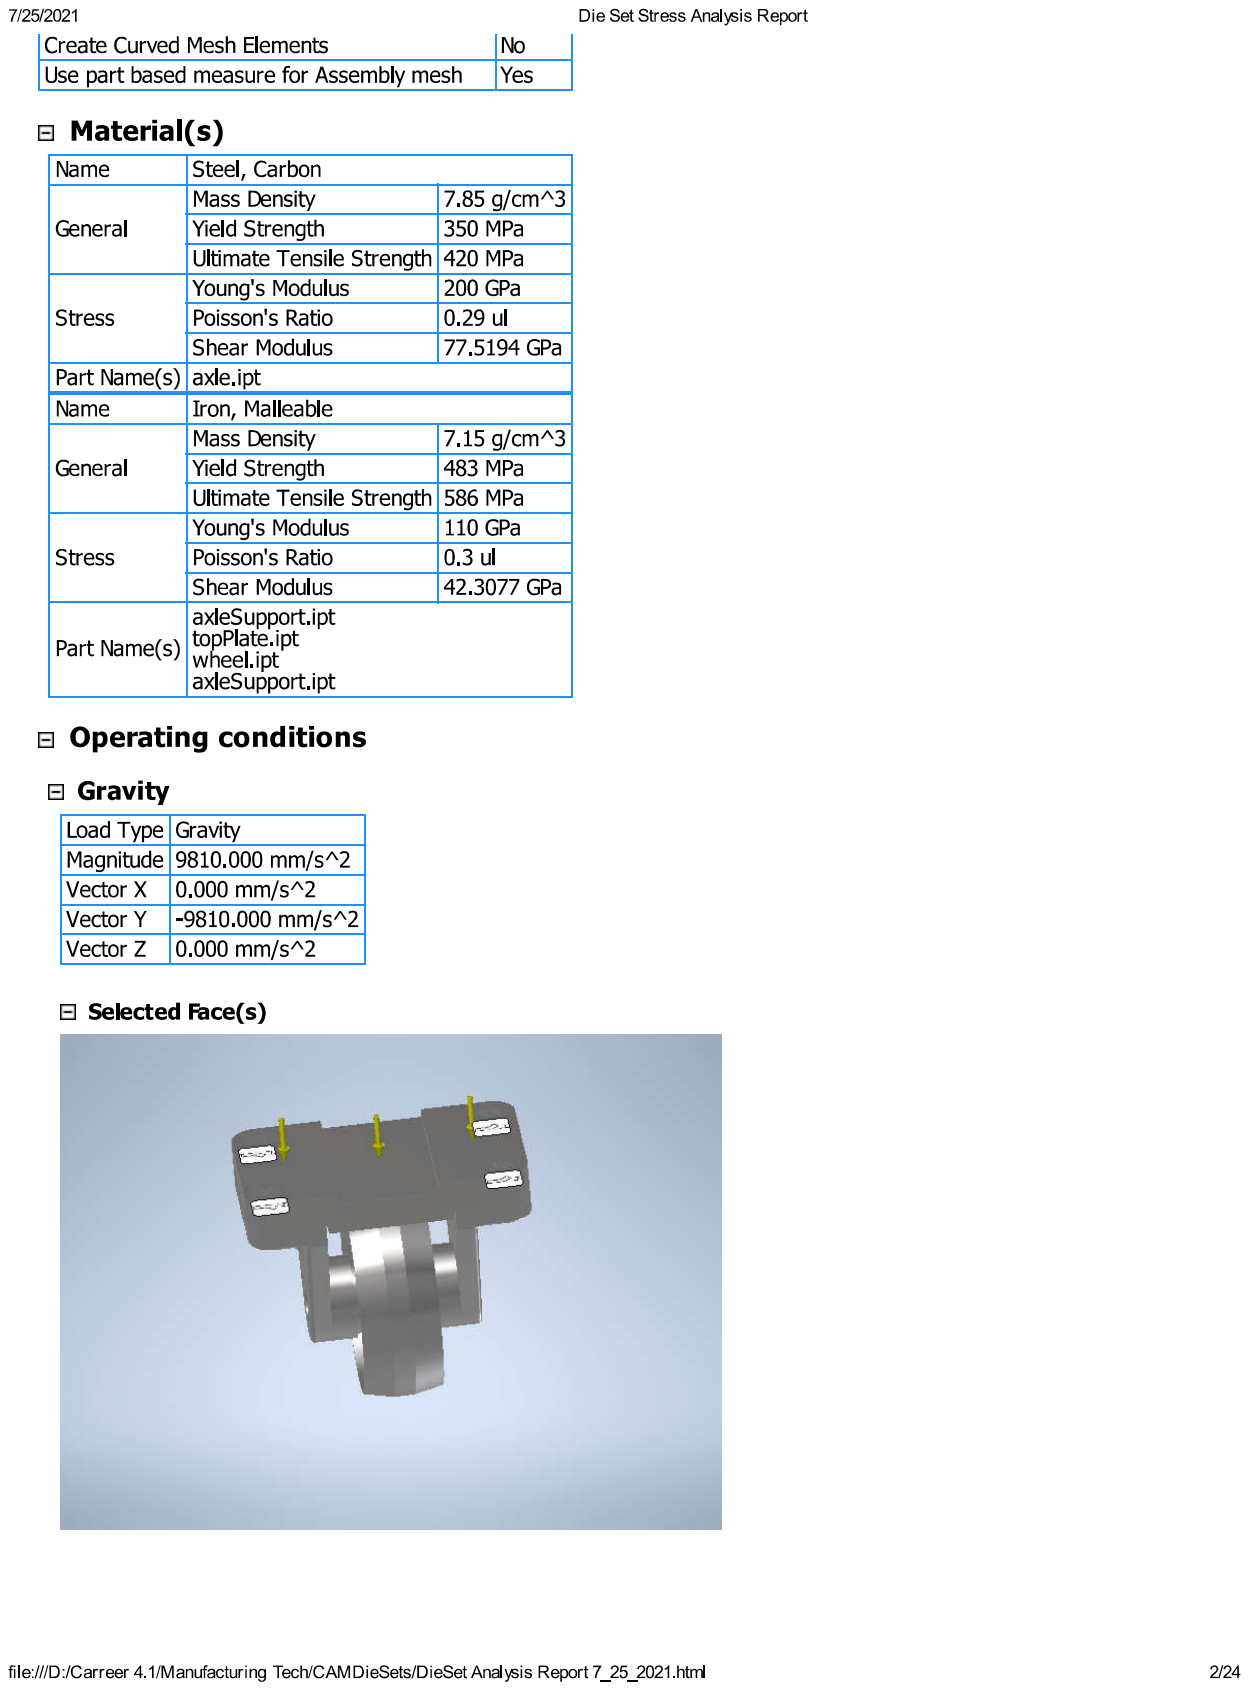
[picture p114: page 2]

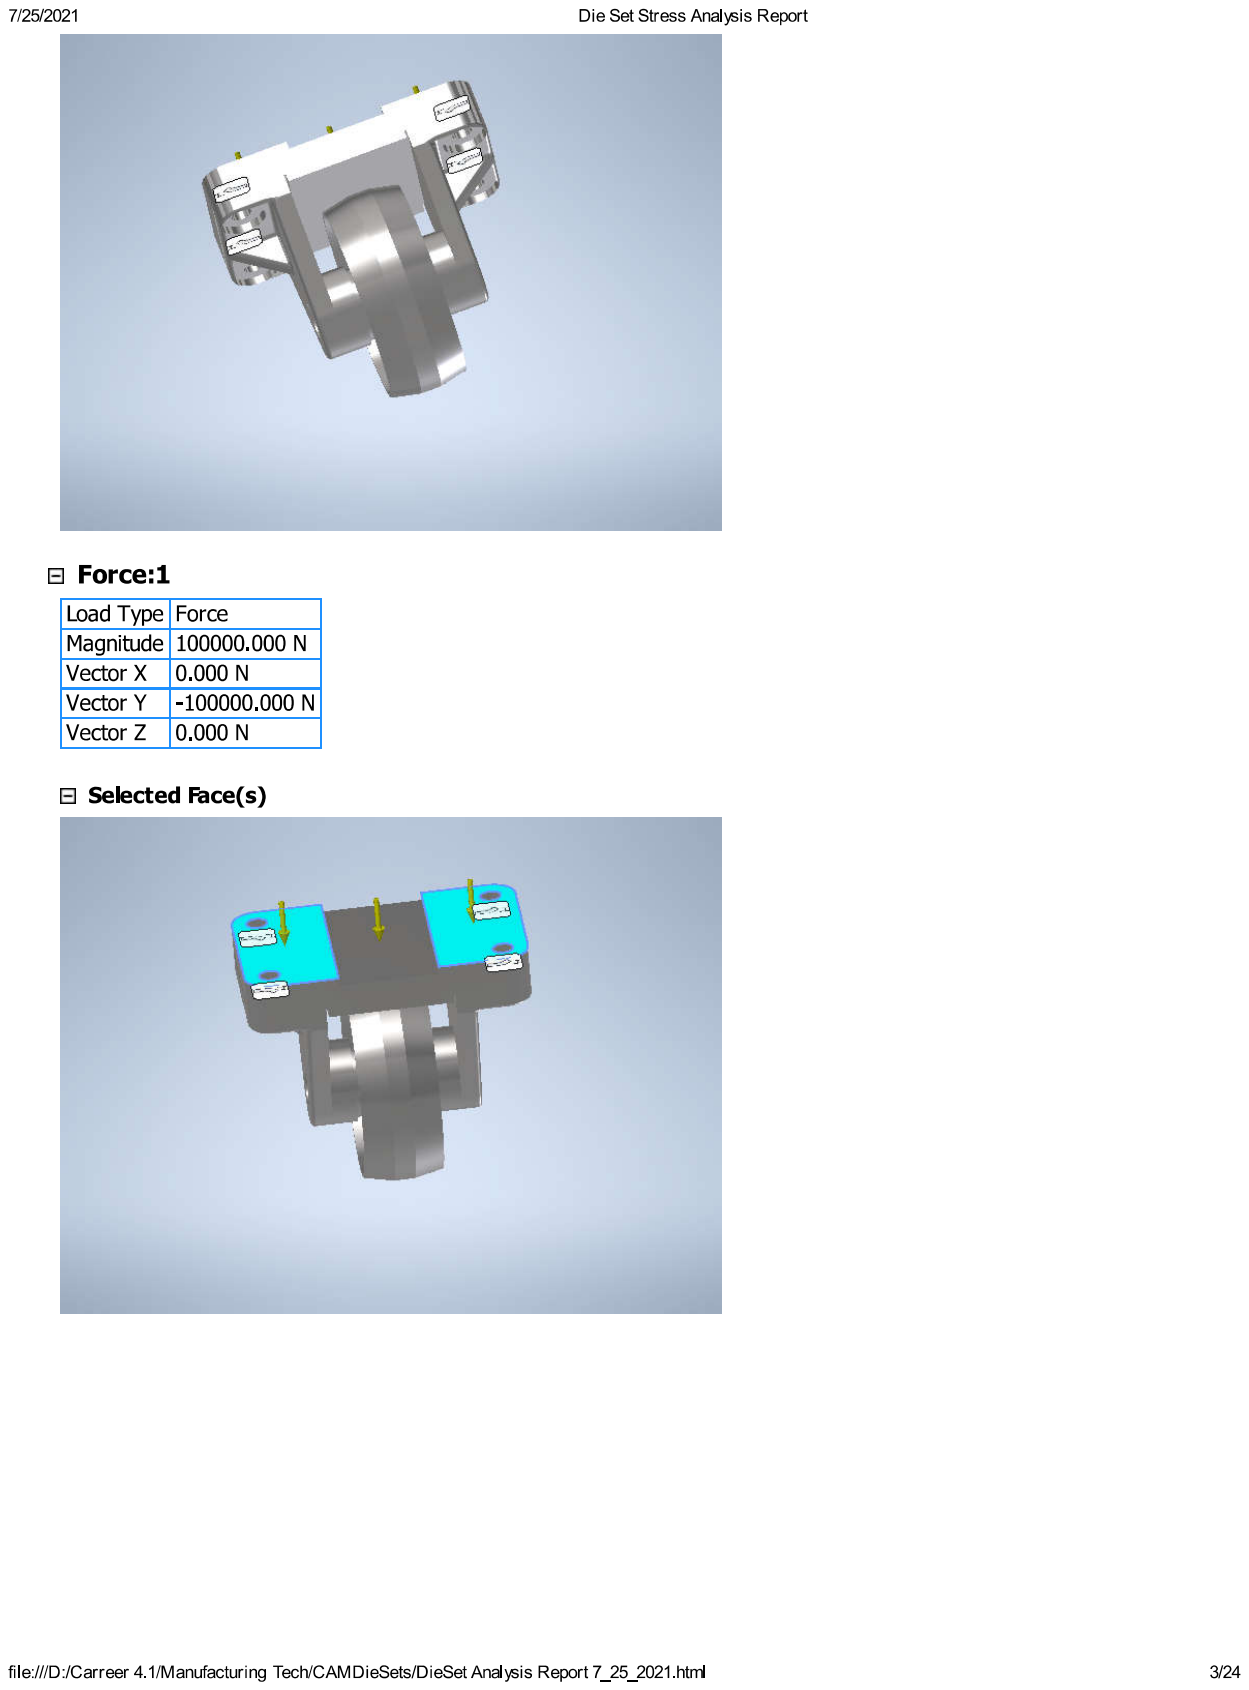
[picture p115: page 3]

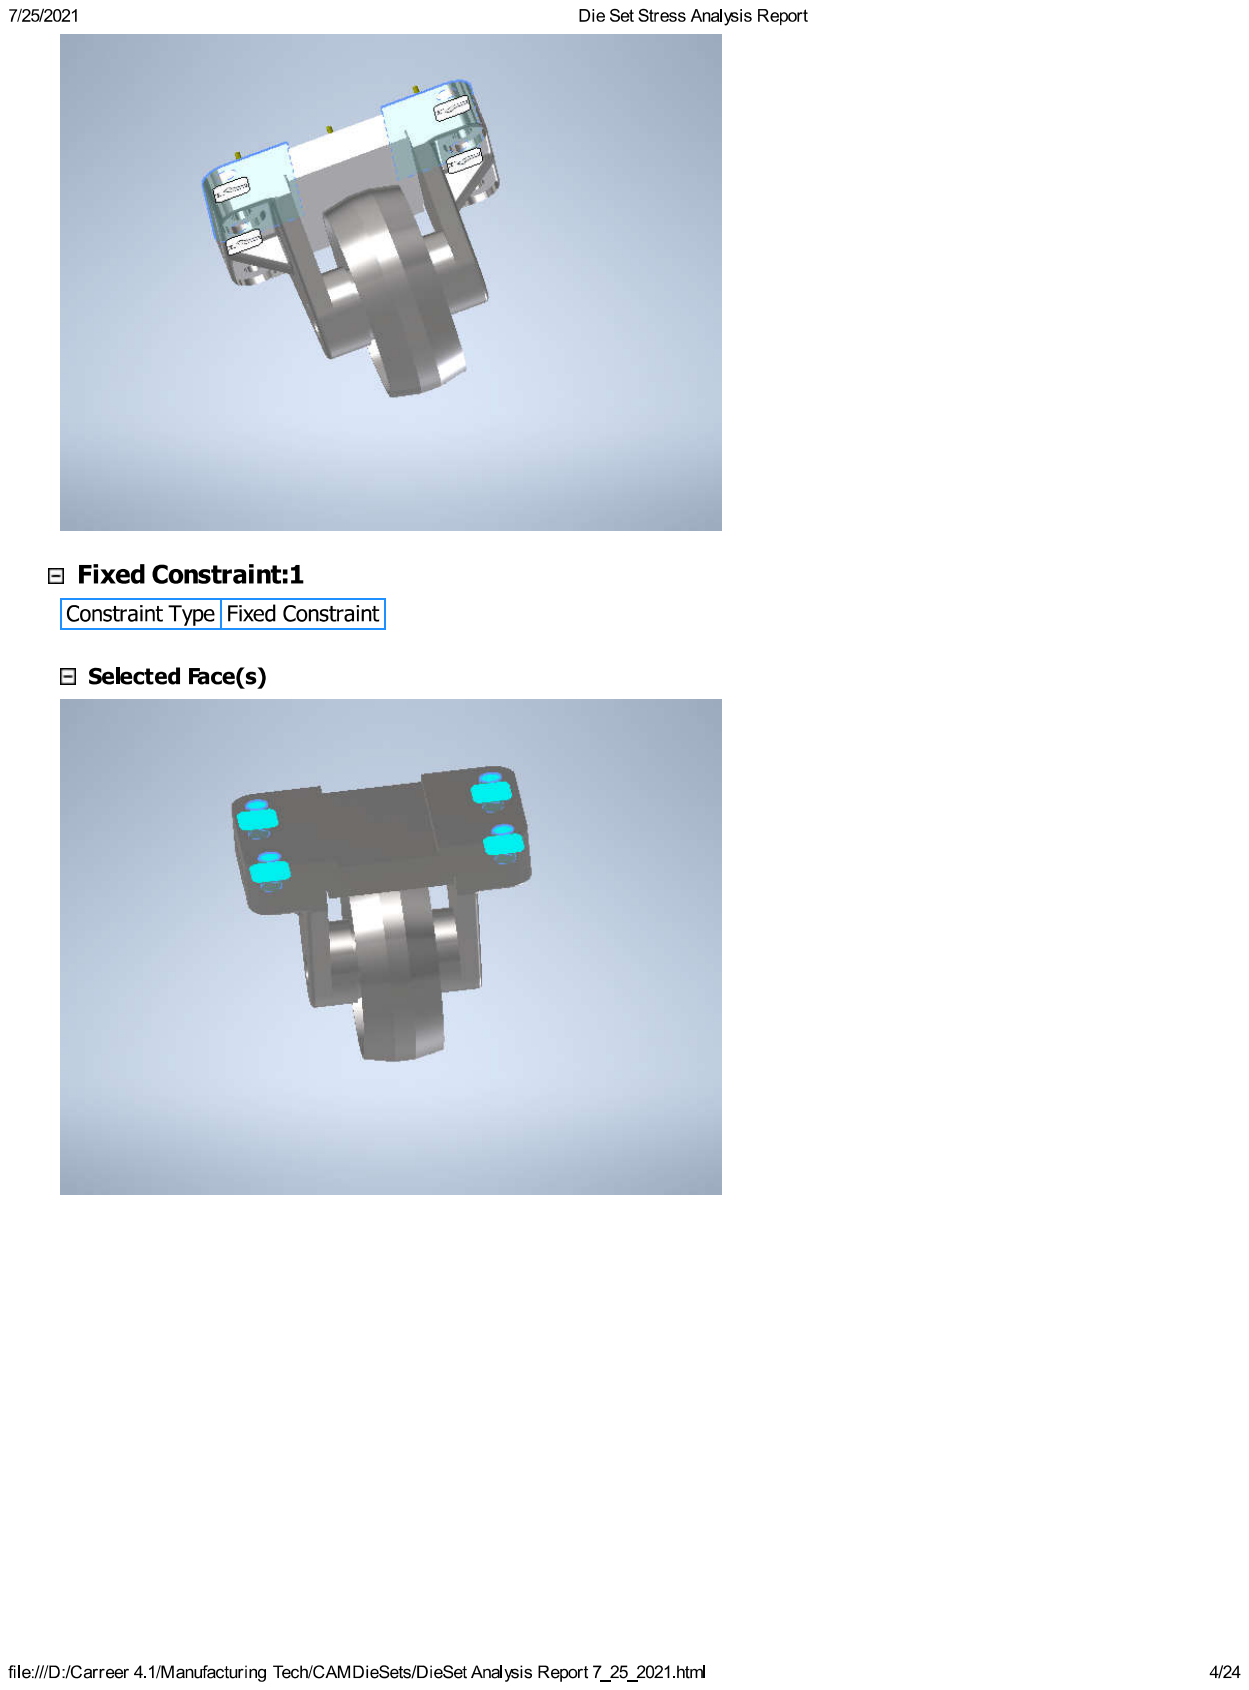
[picture p116: page 4]

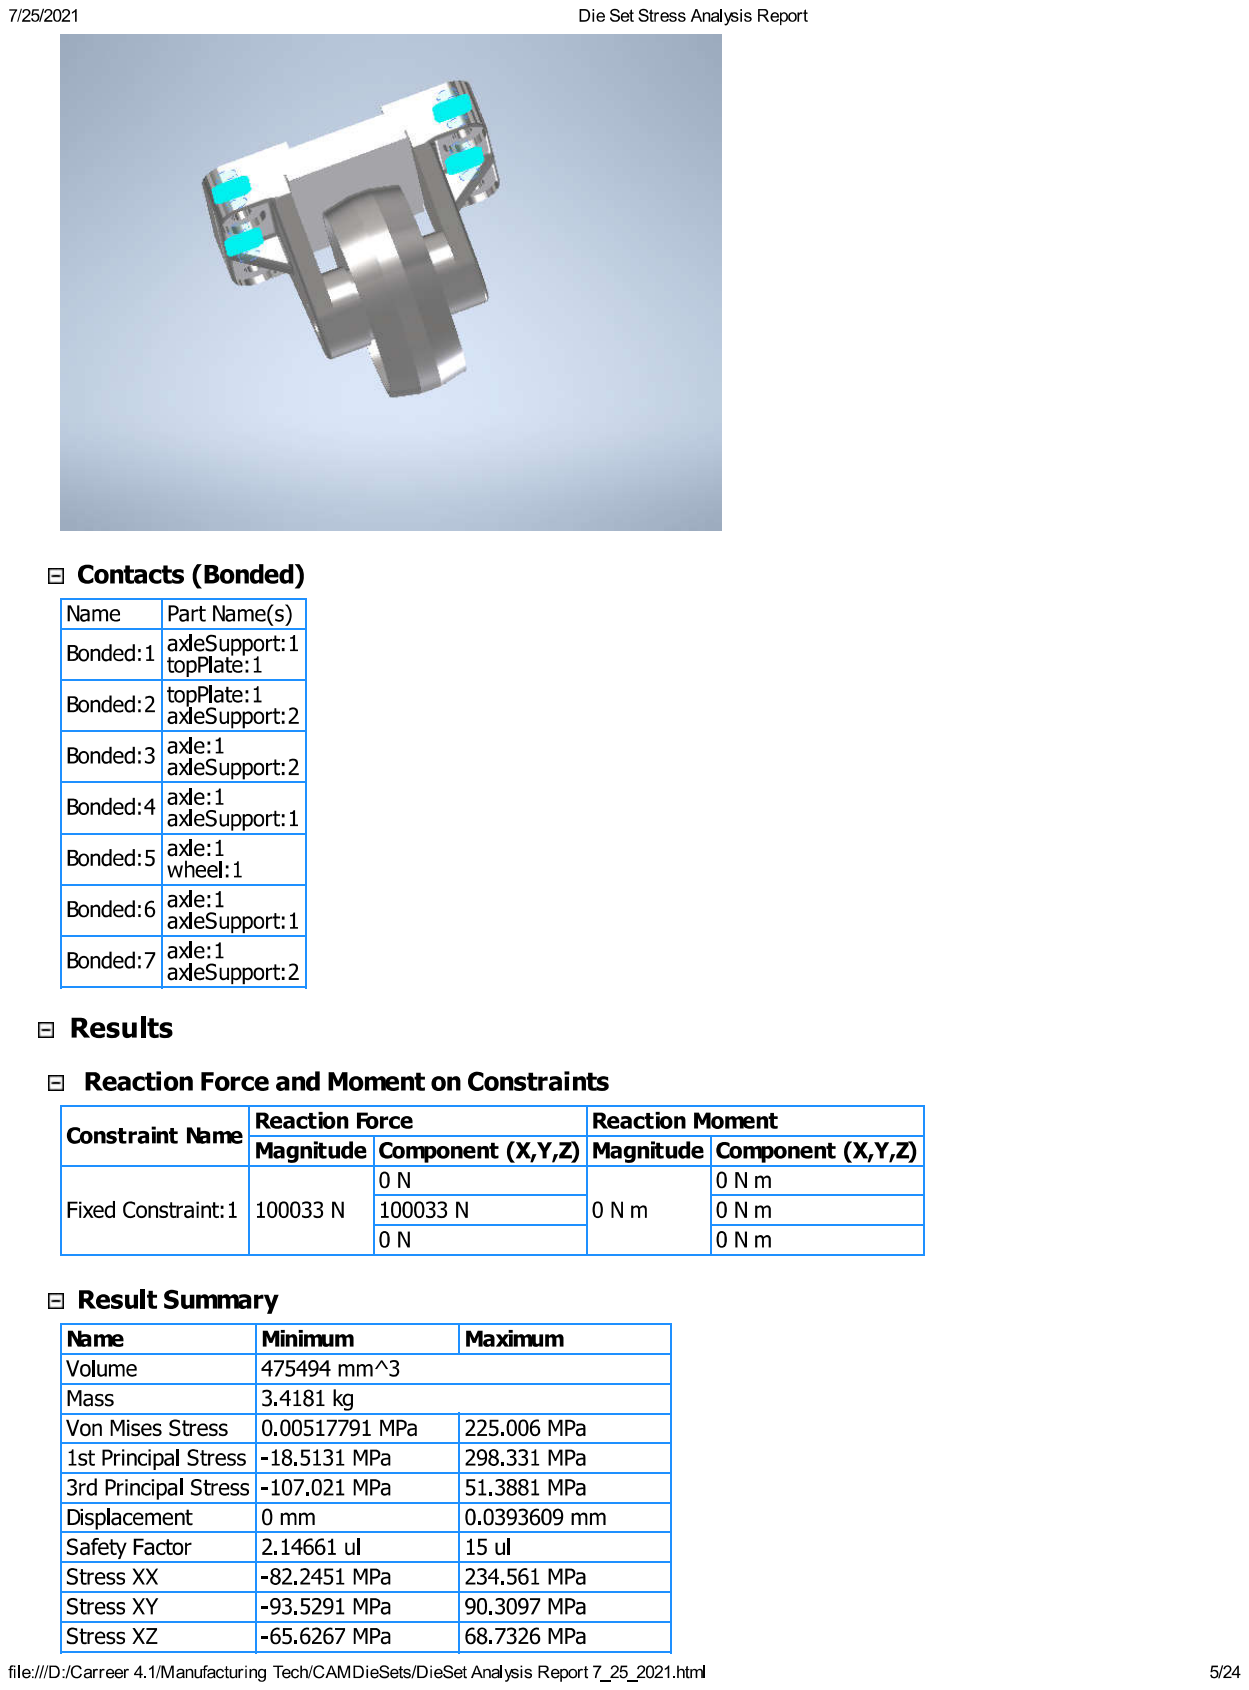
[picture p117: page 5]

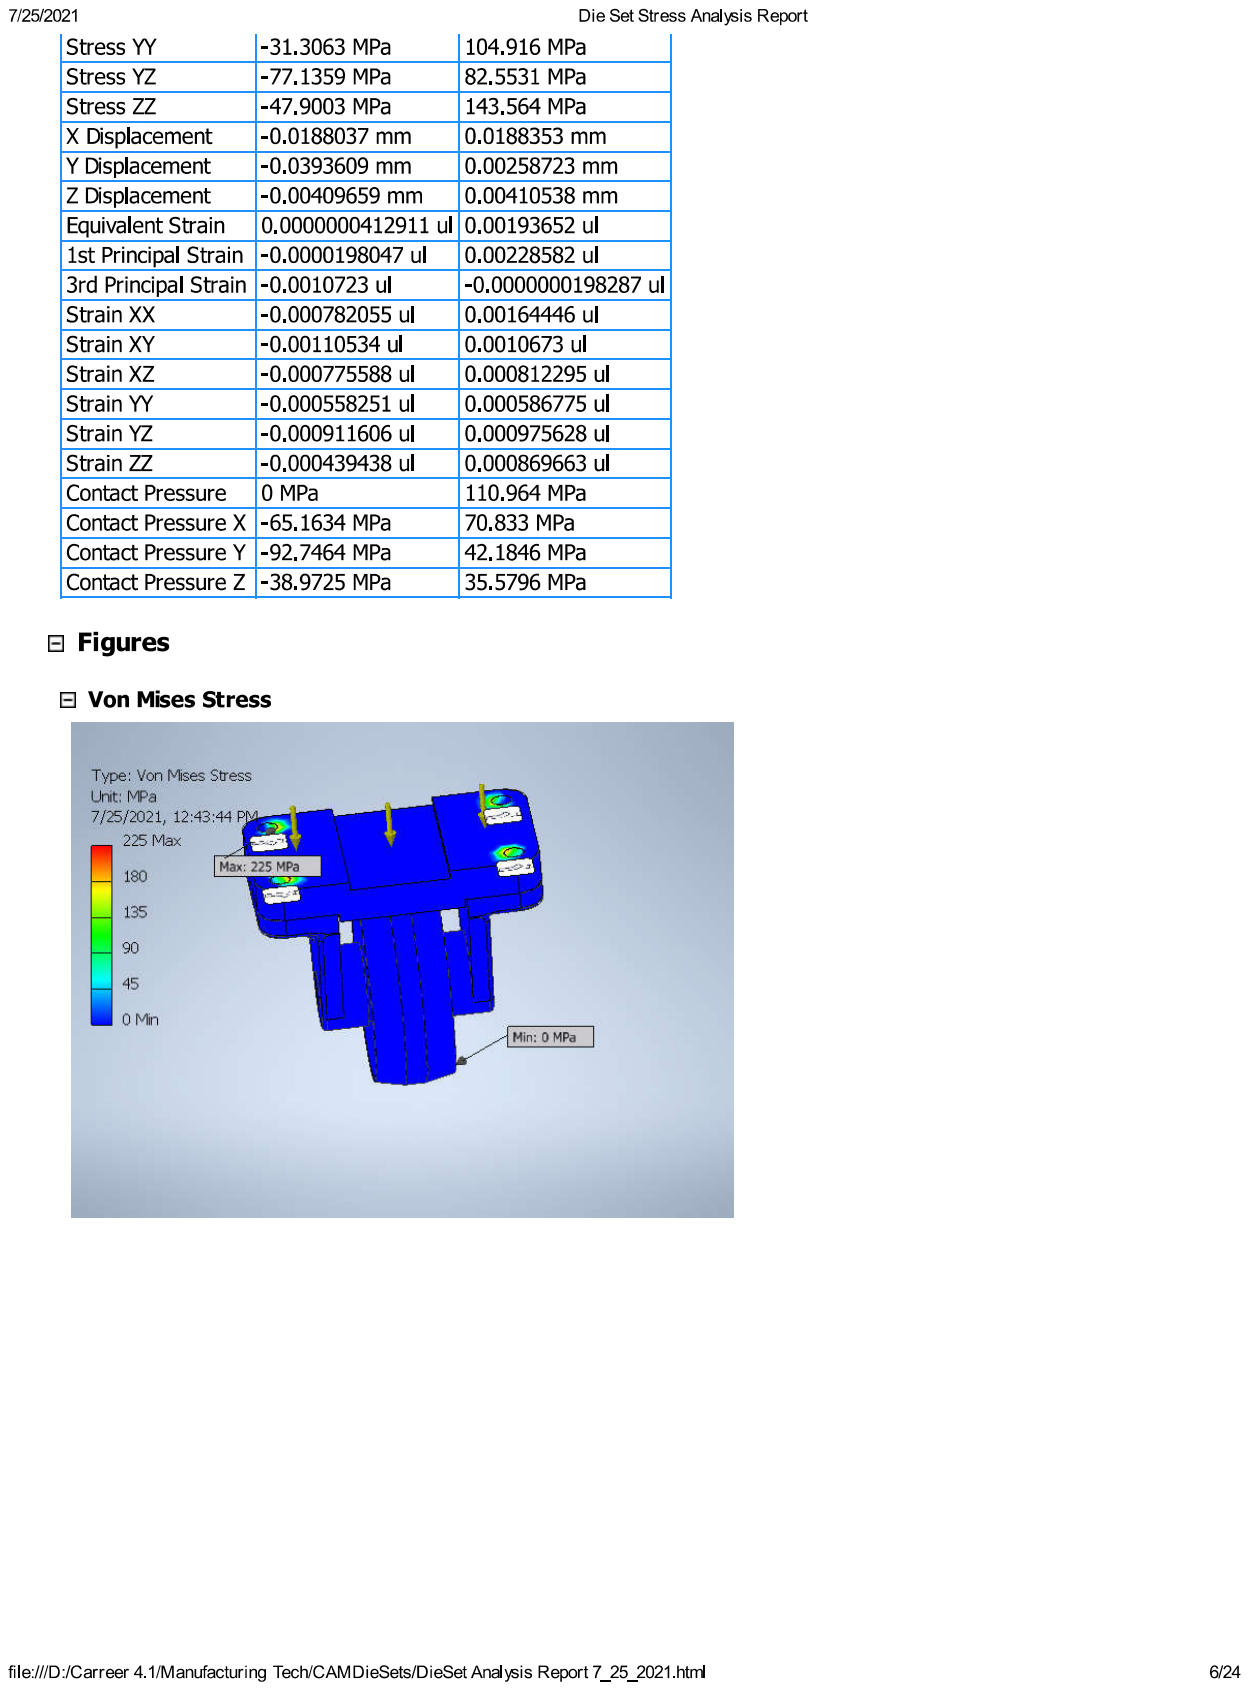
[picture p118: page 6]

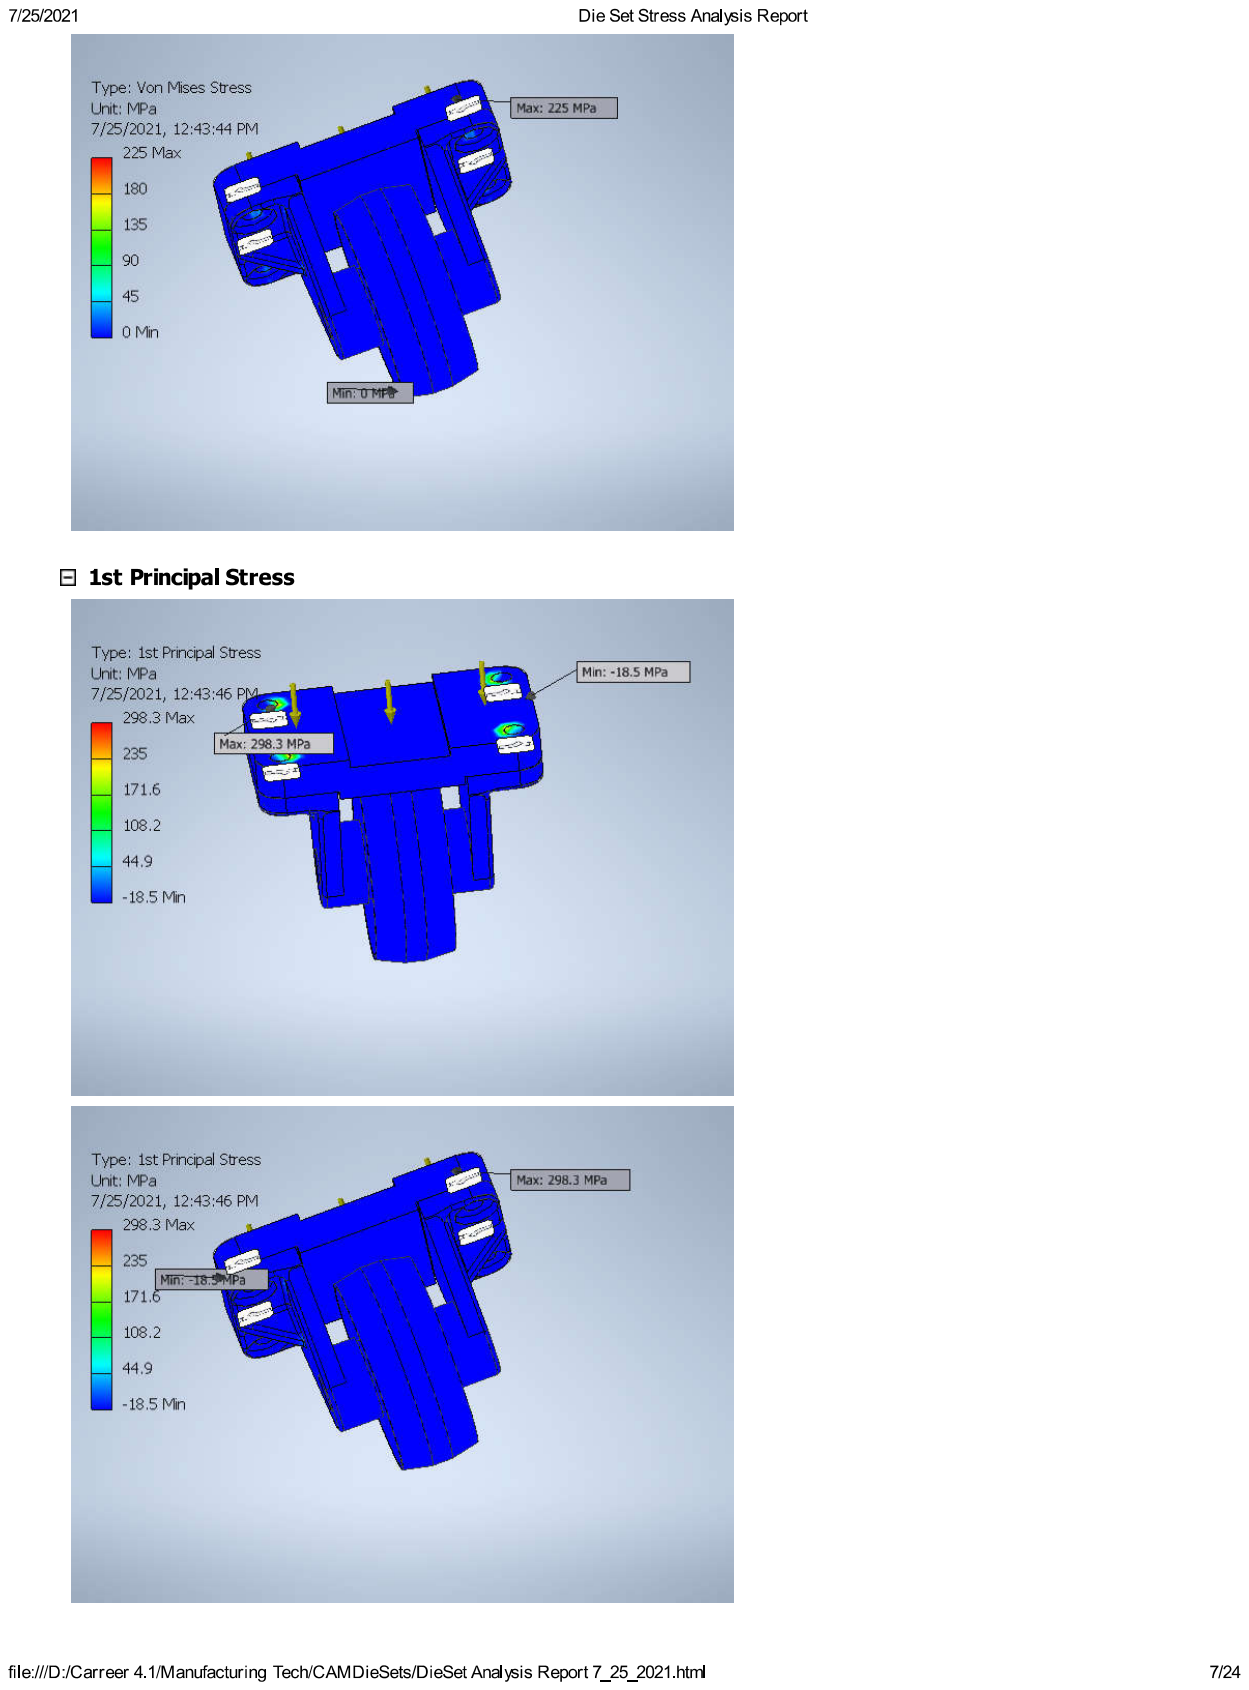
[picture p119: page 7]

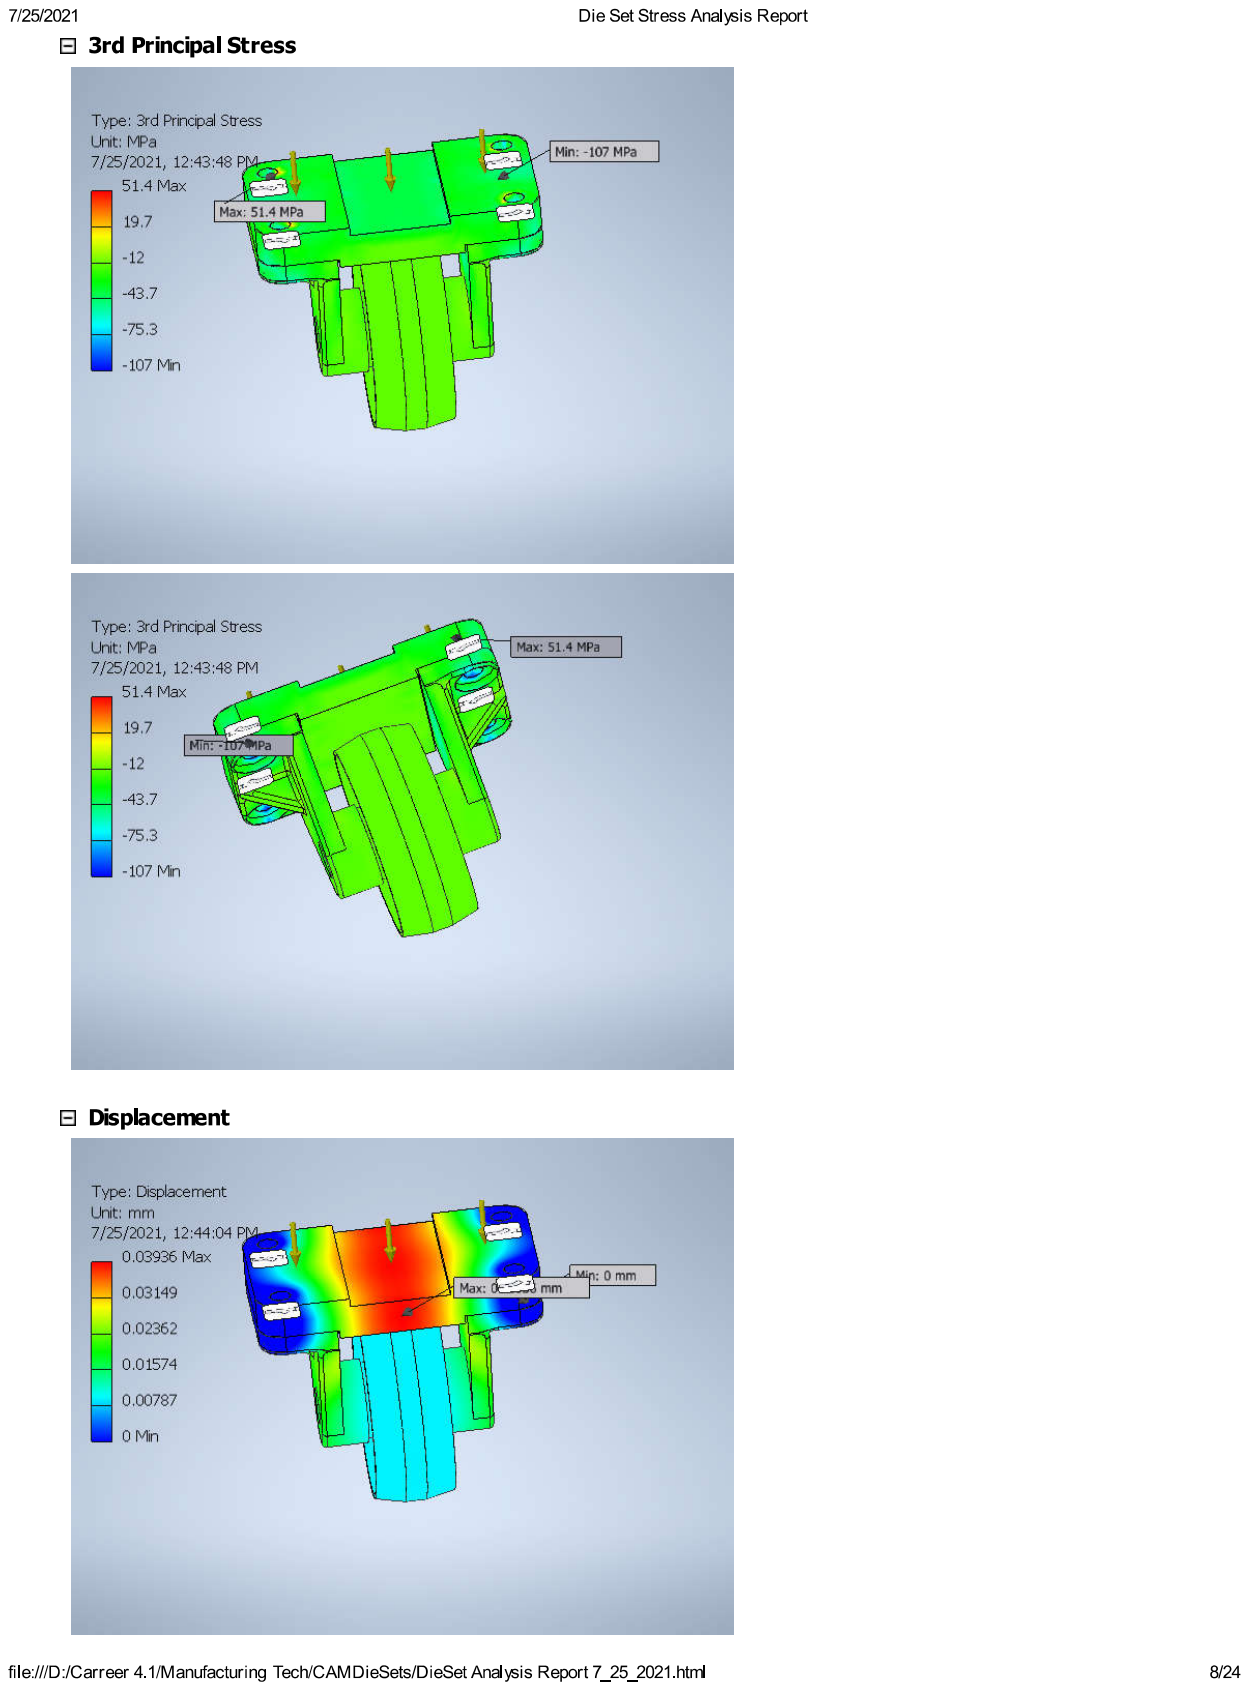
[picture p120: page 8]

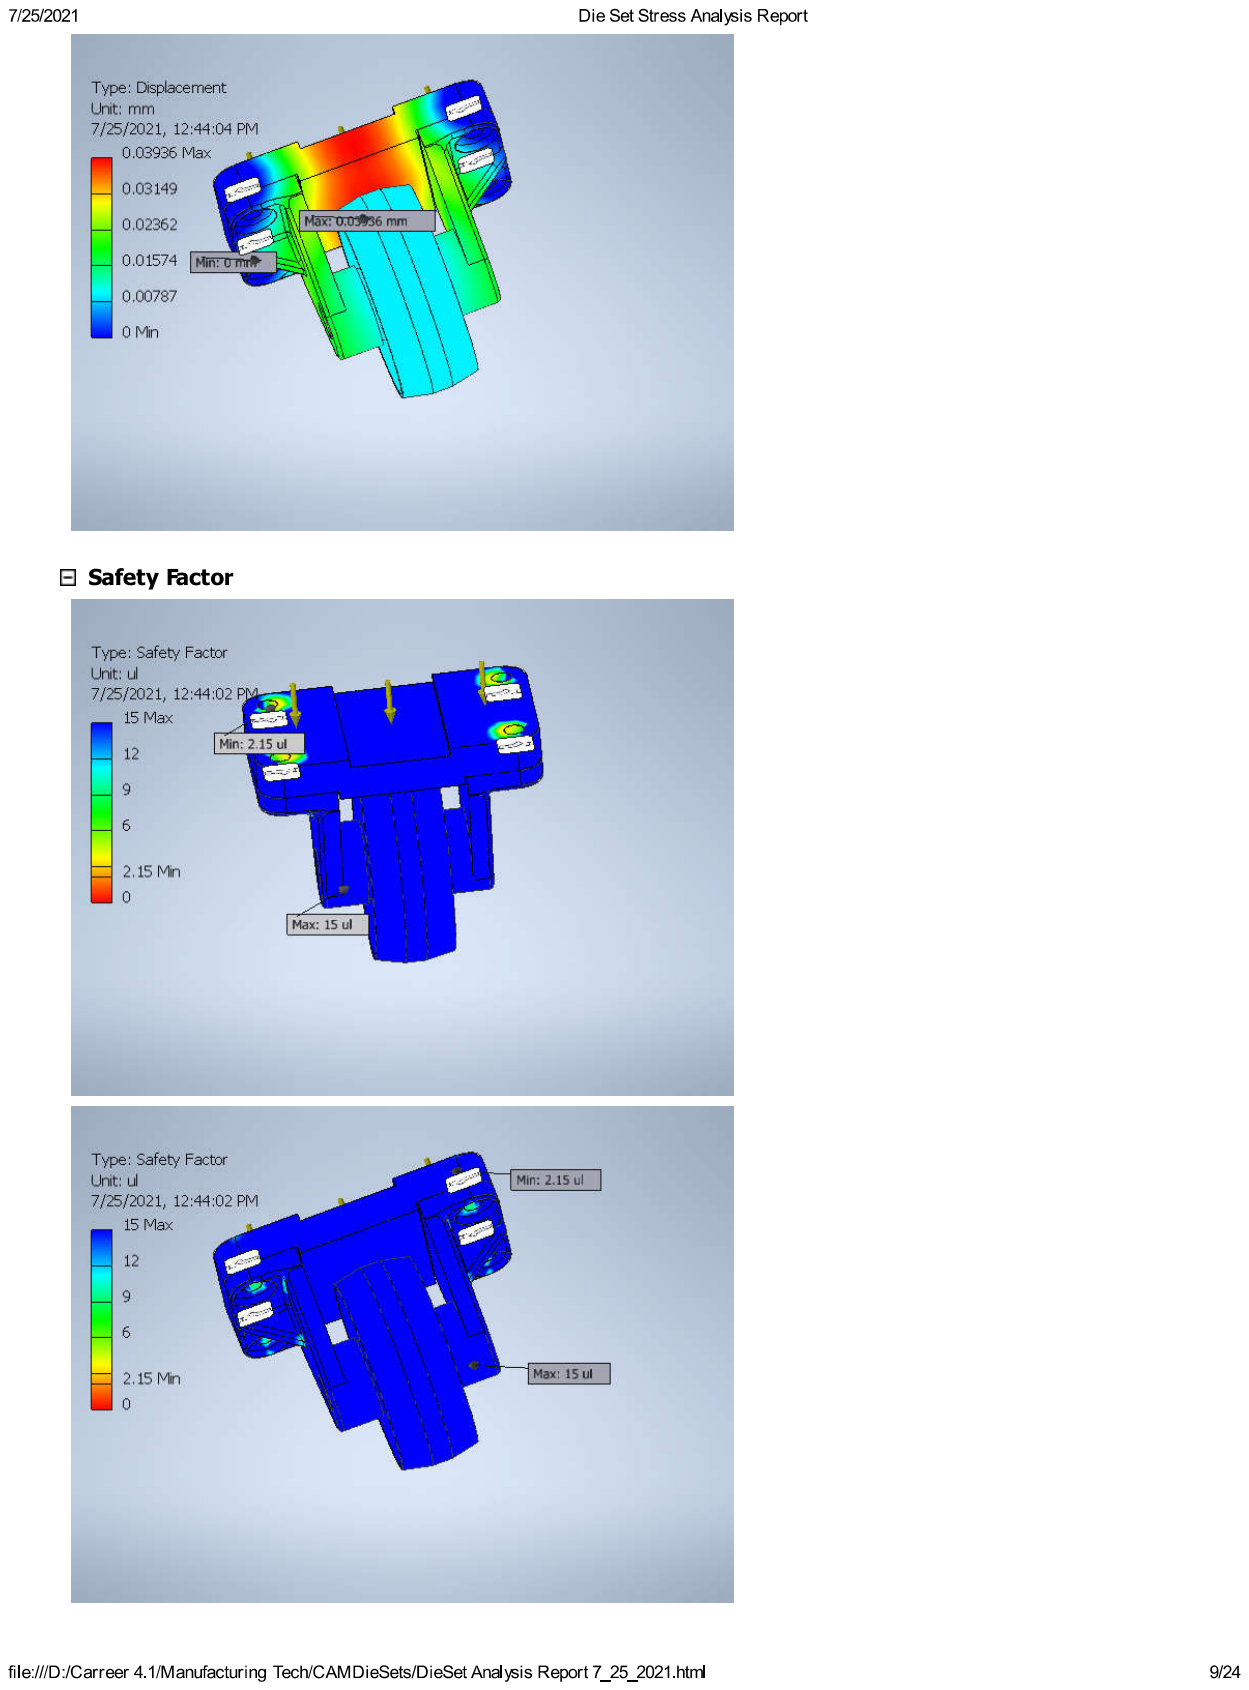
[picture p121: page 9]

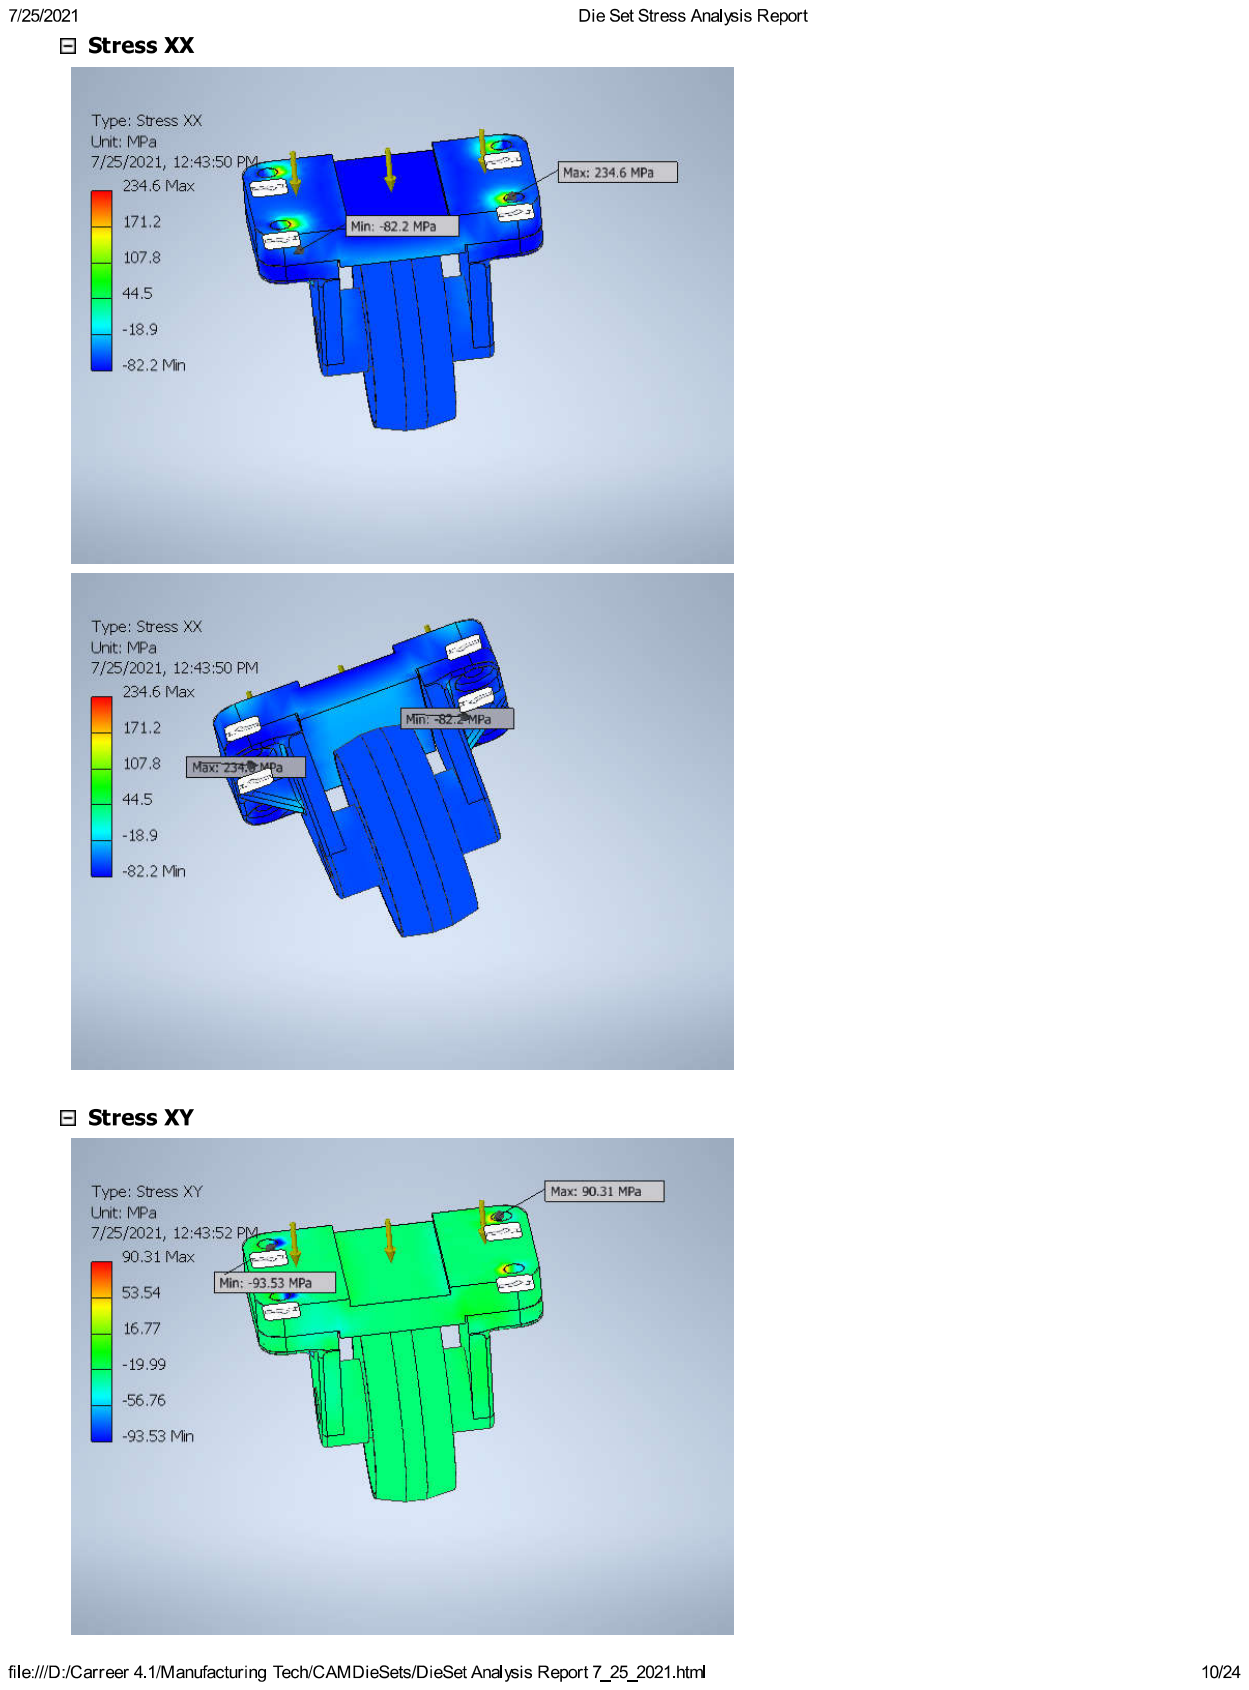
[picture p122: page 10]

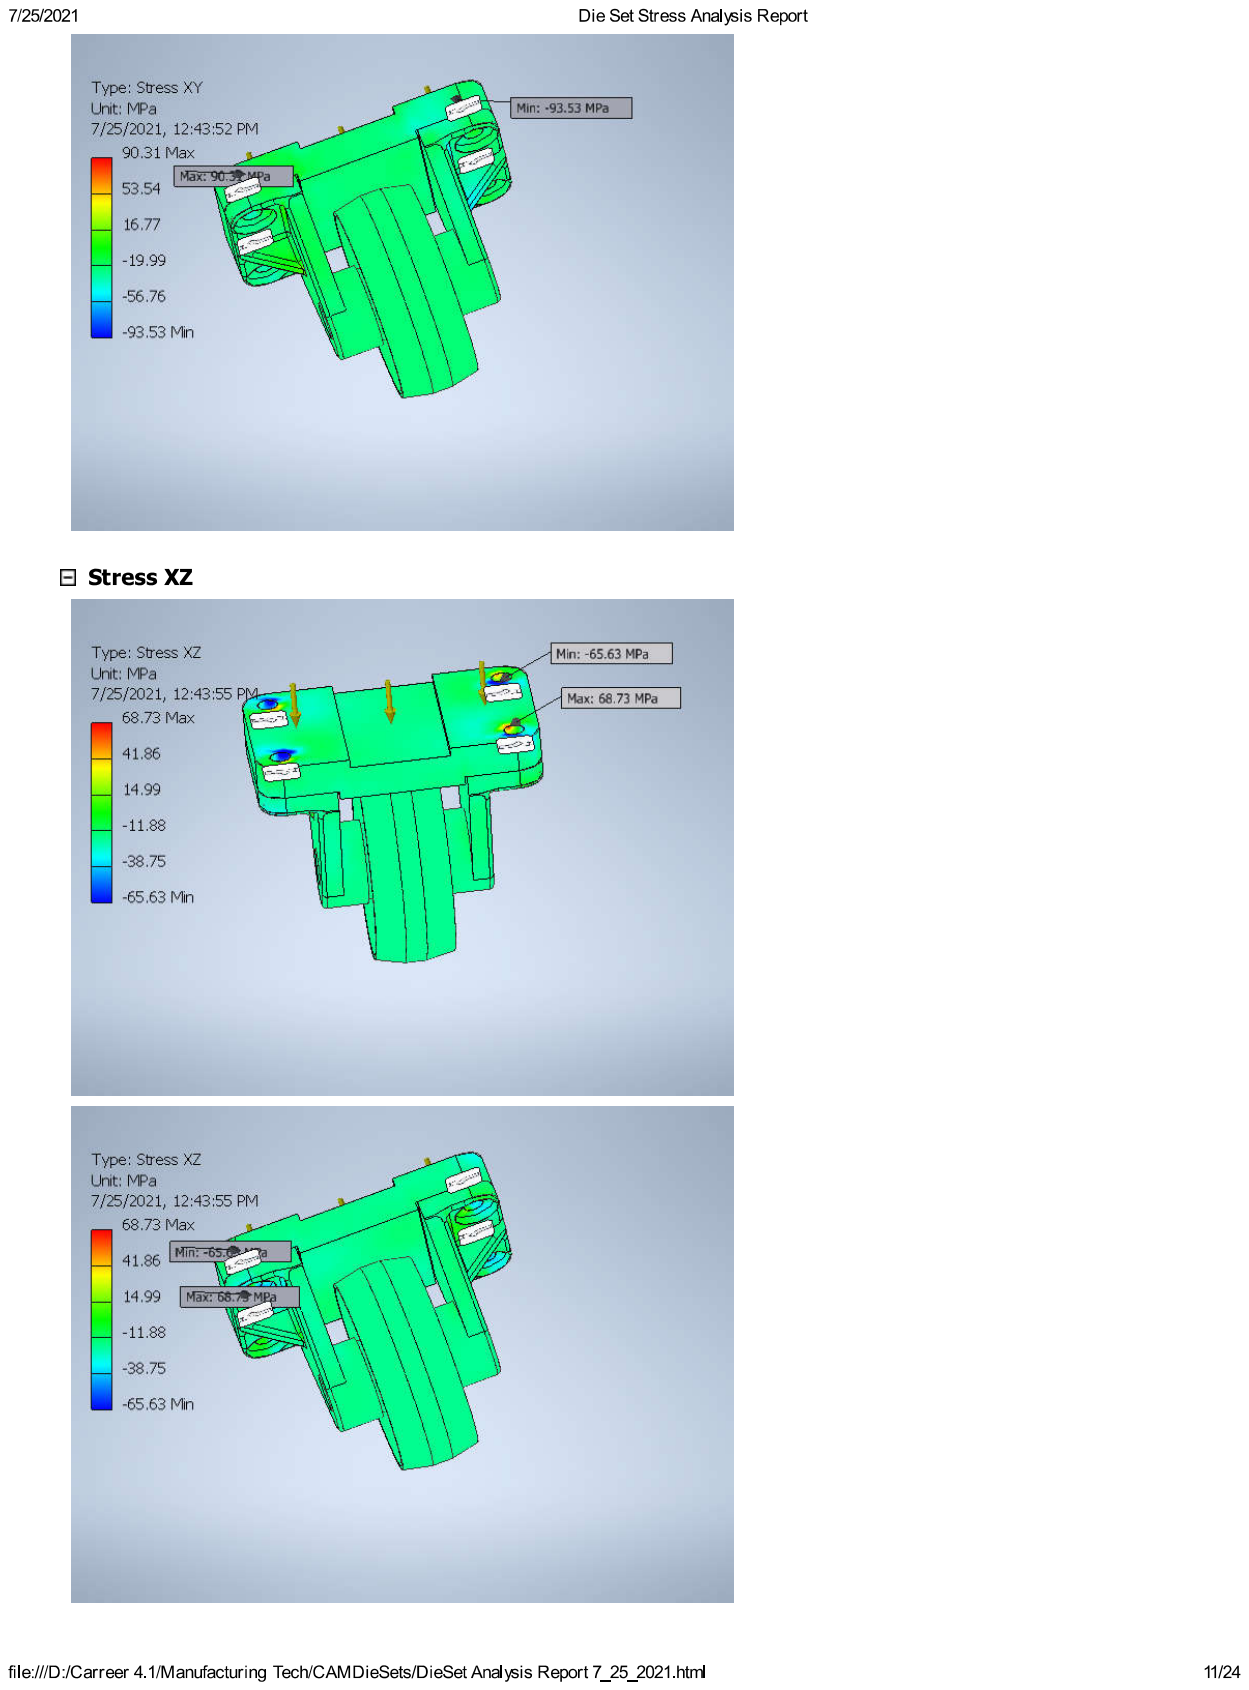
[picture p123: page 11]

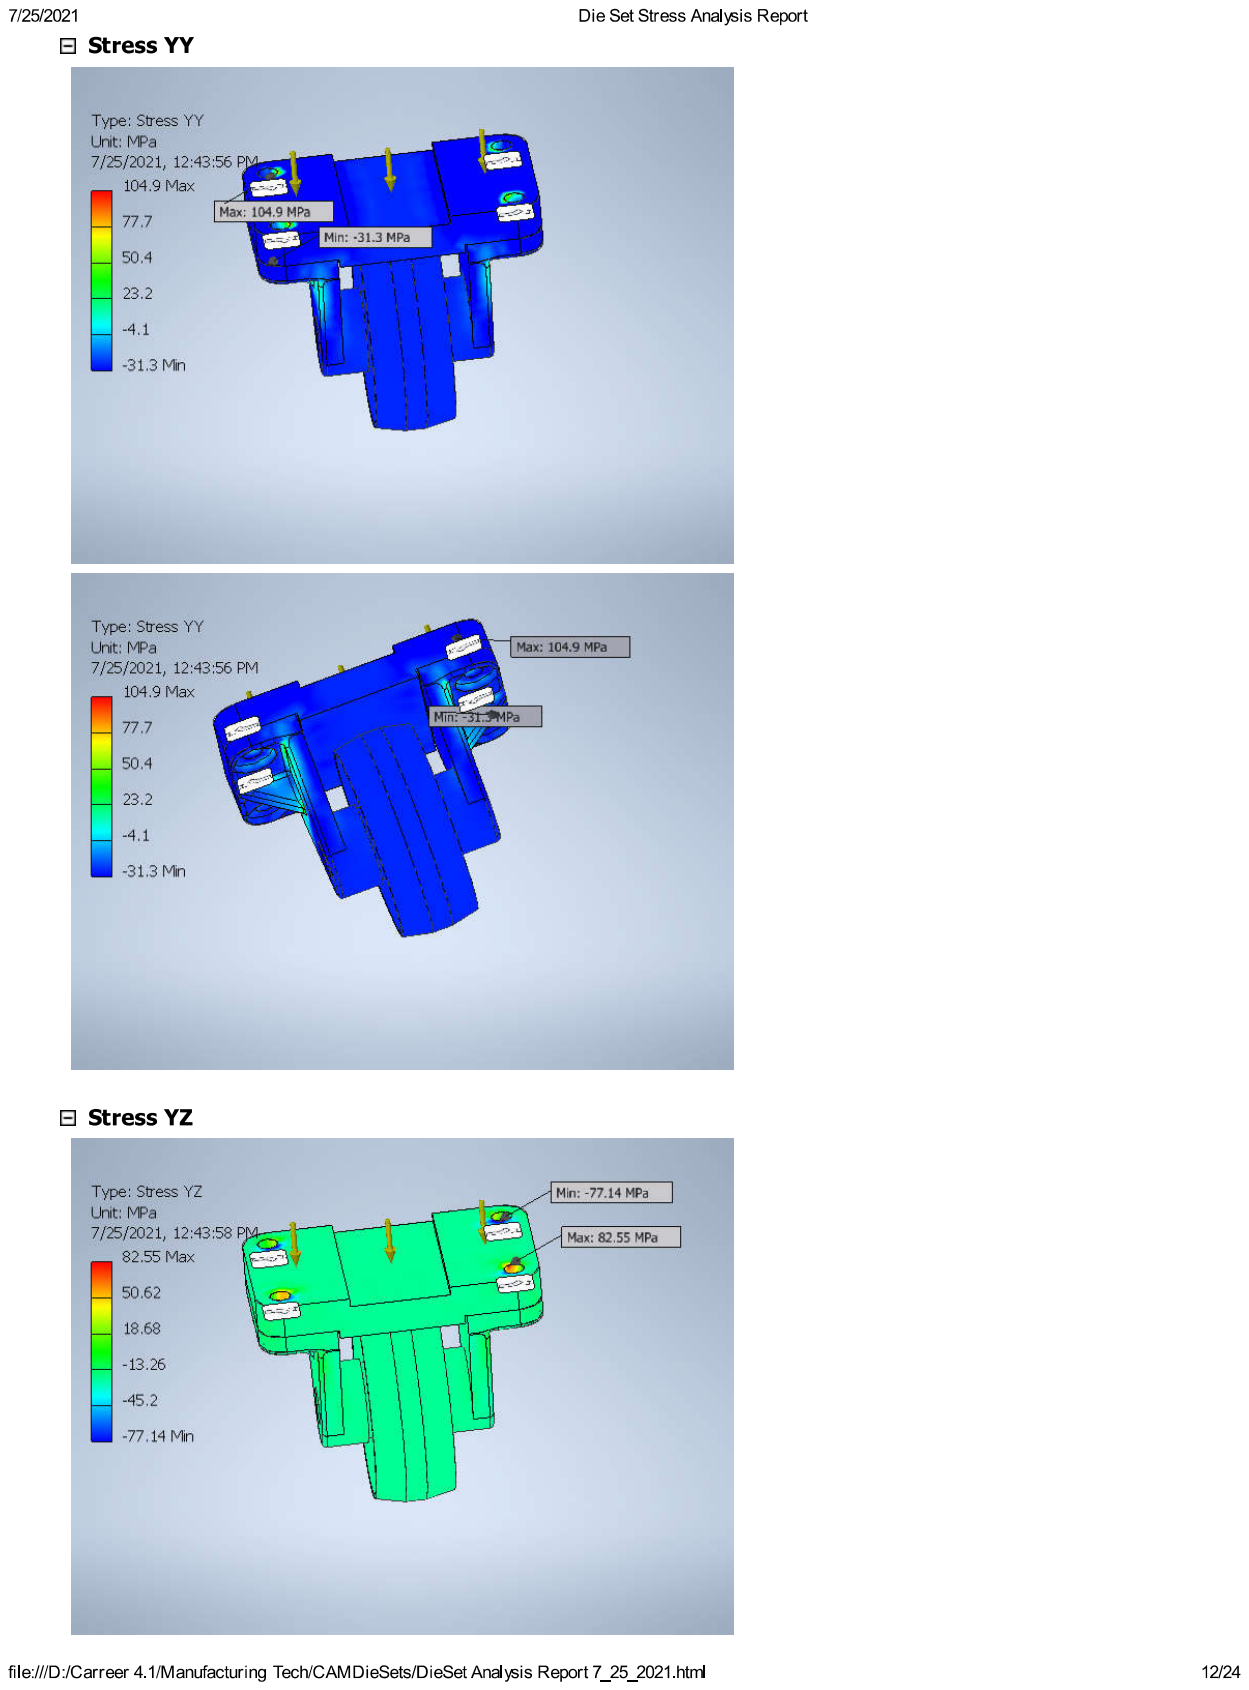
[picture p124: page 12]

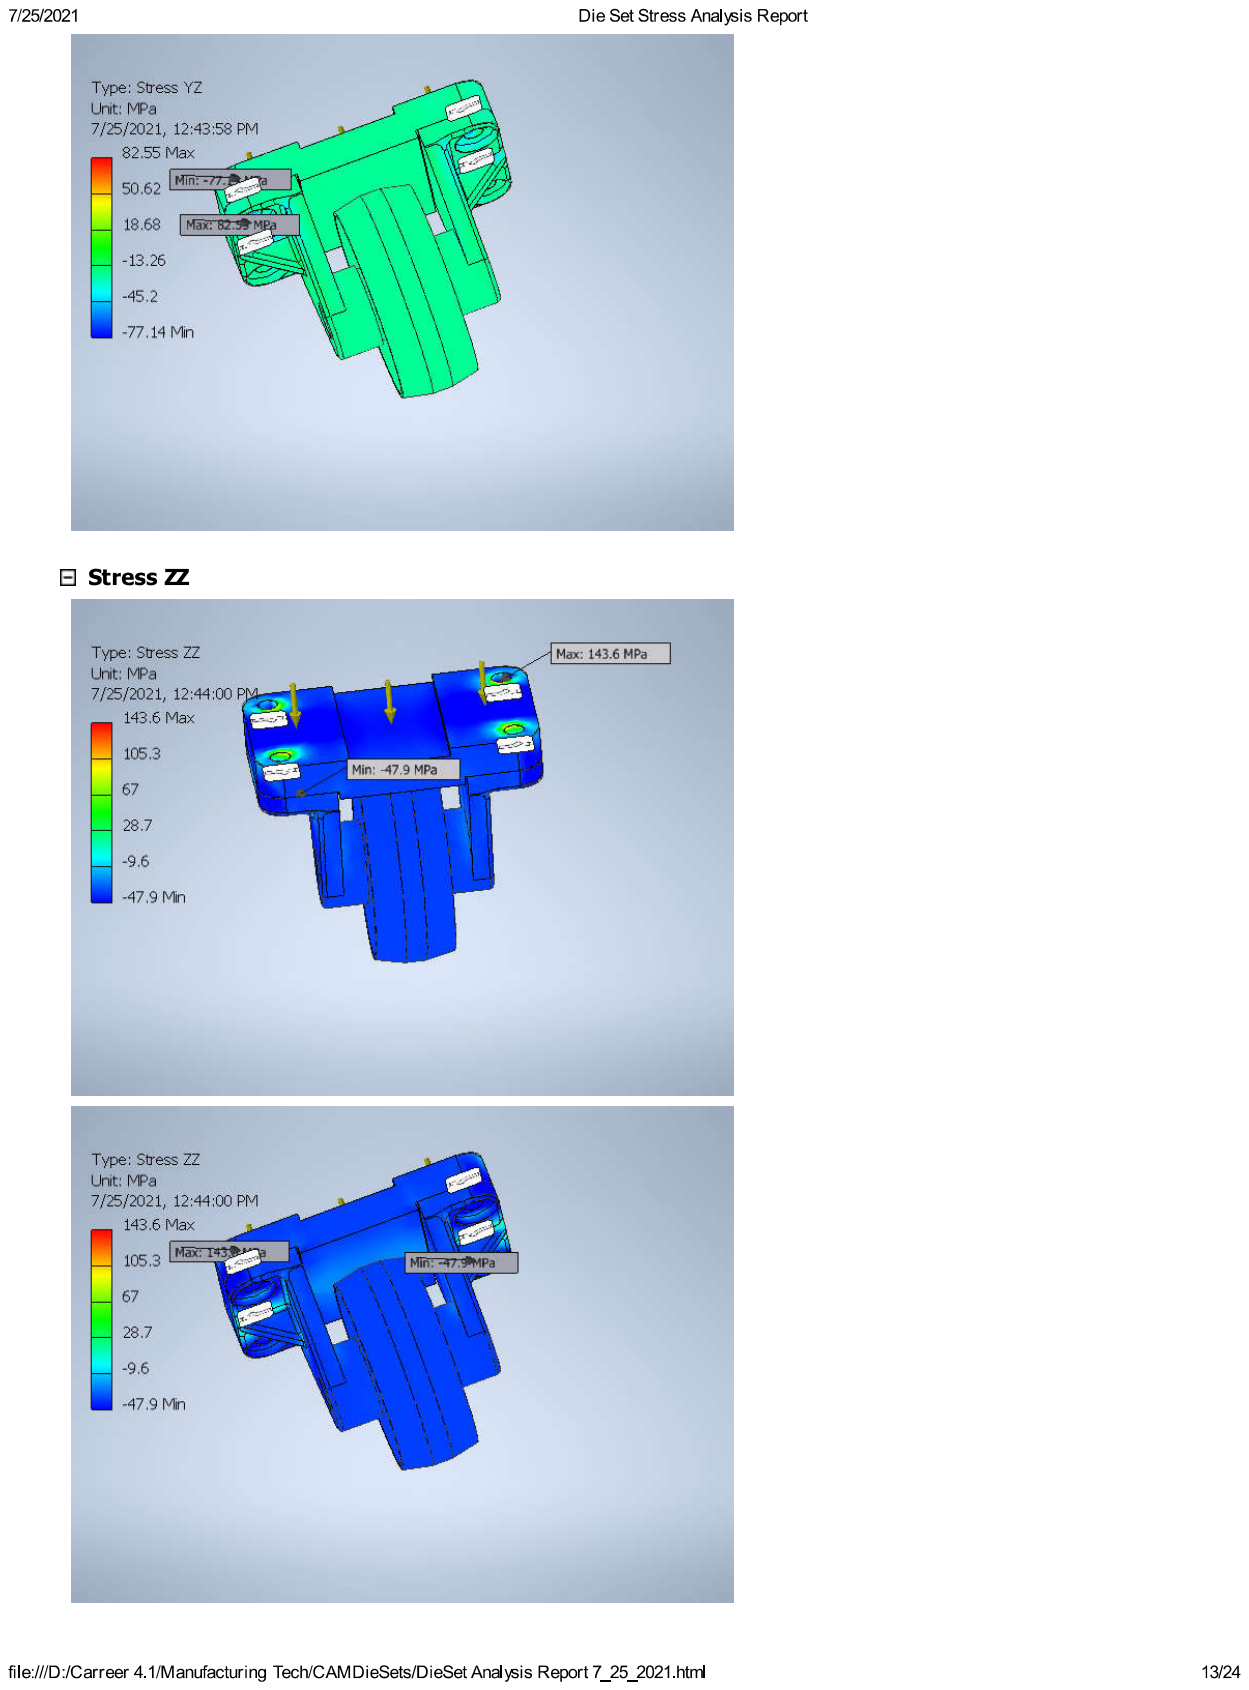
[picture p125: page 13]

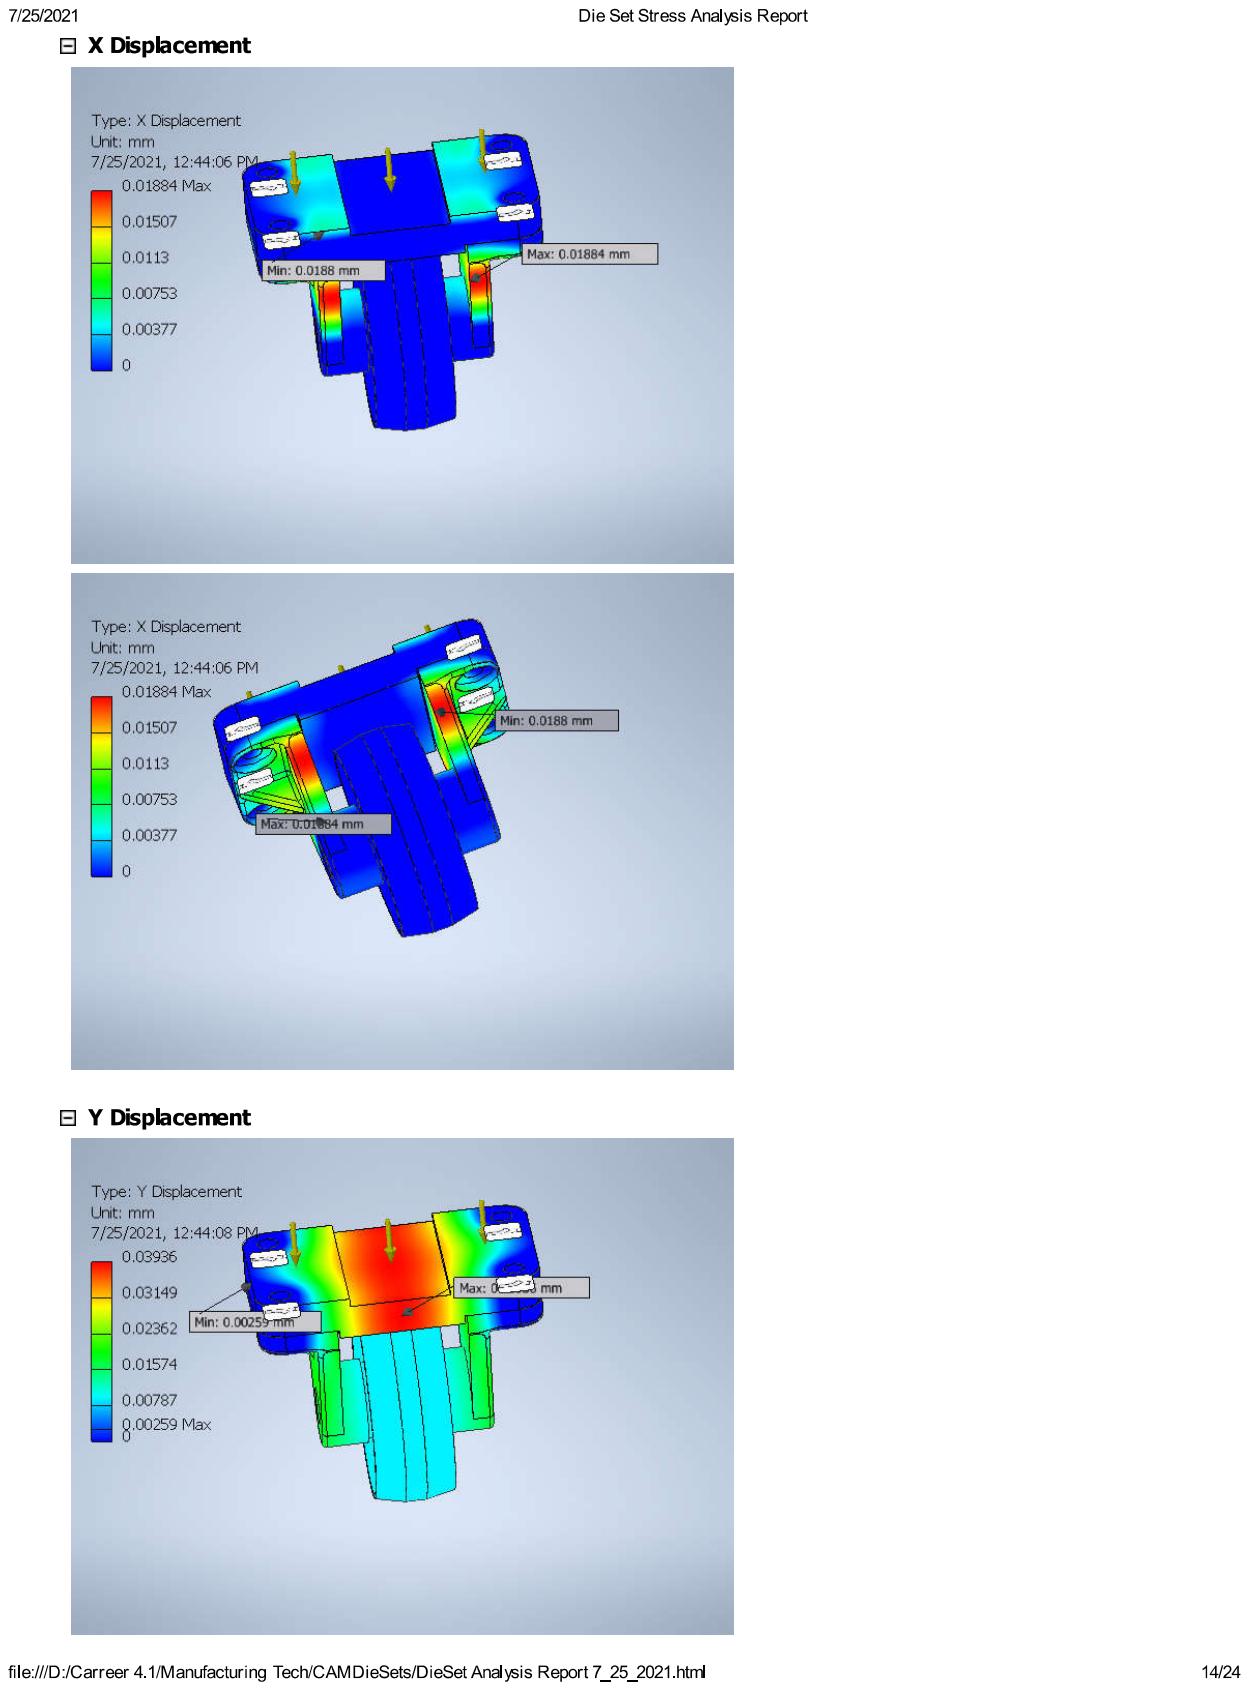
[picture p126: page 14]

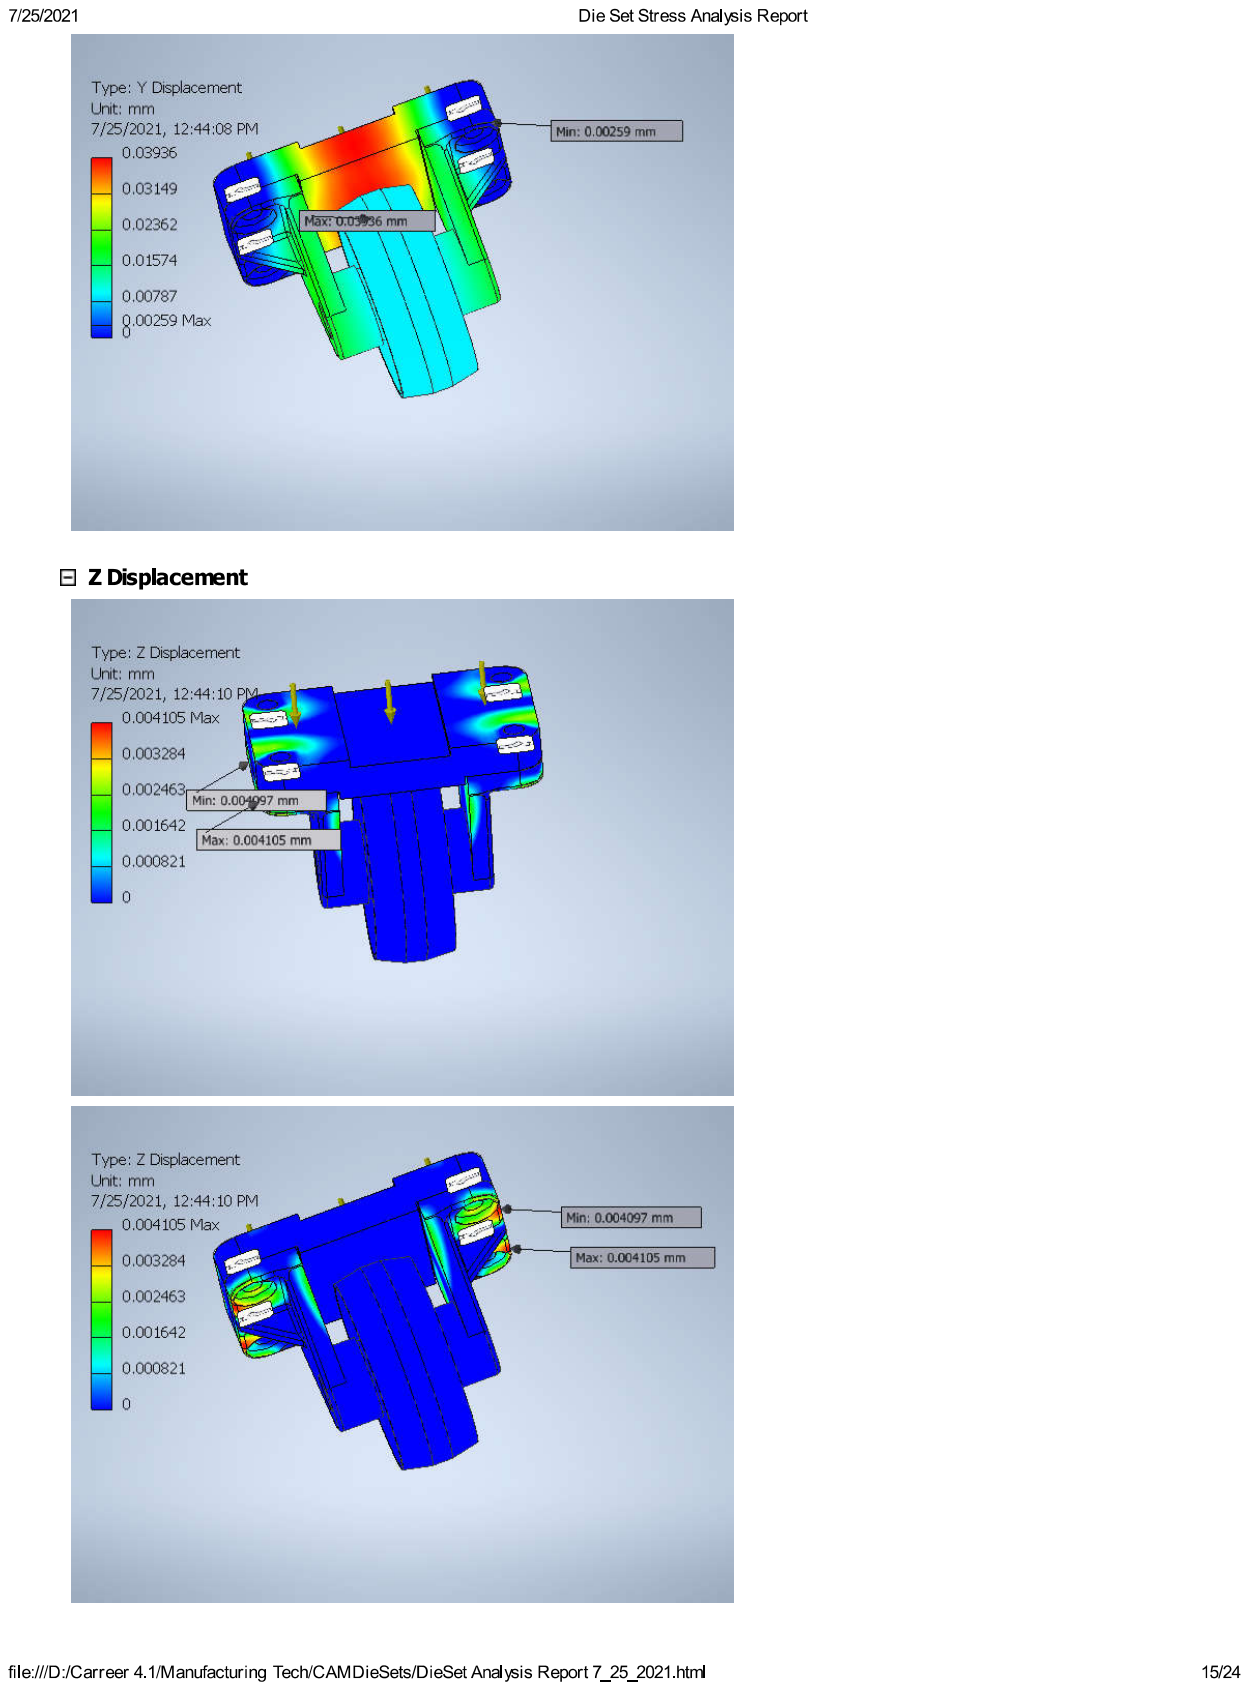
[picture p127: page 15]

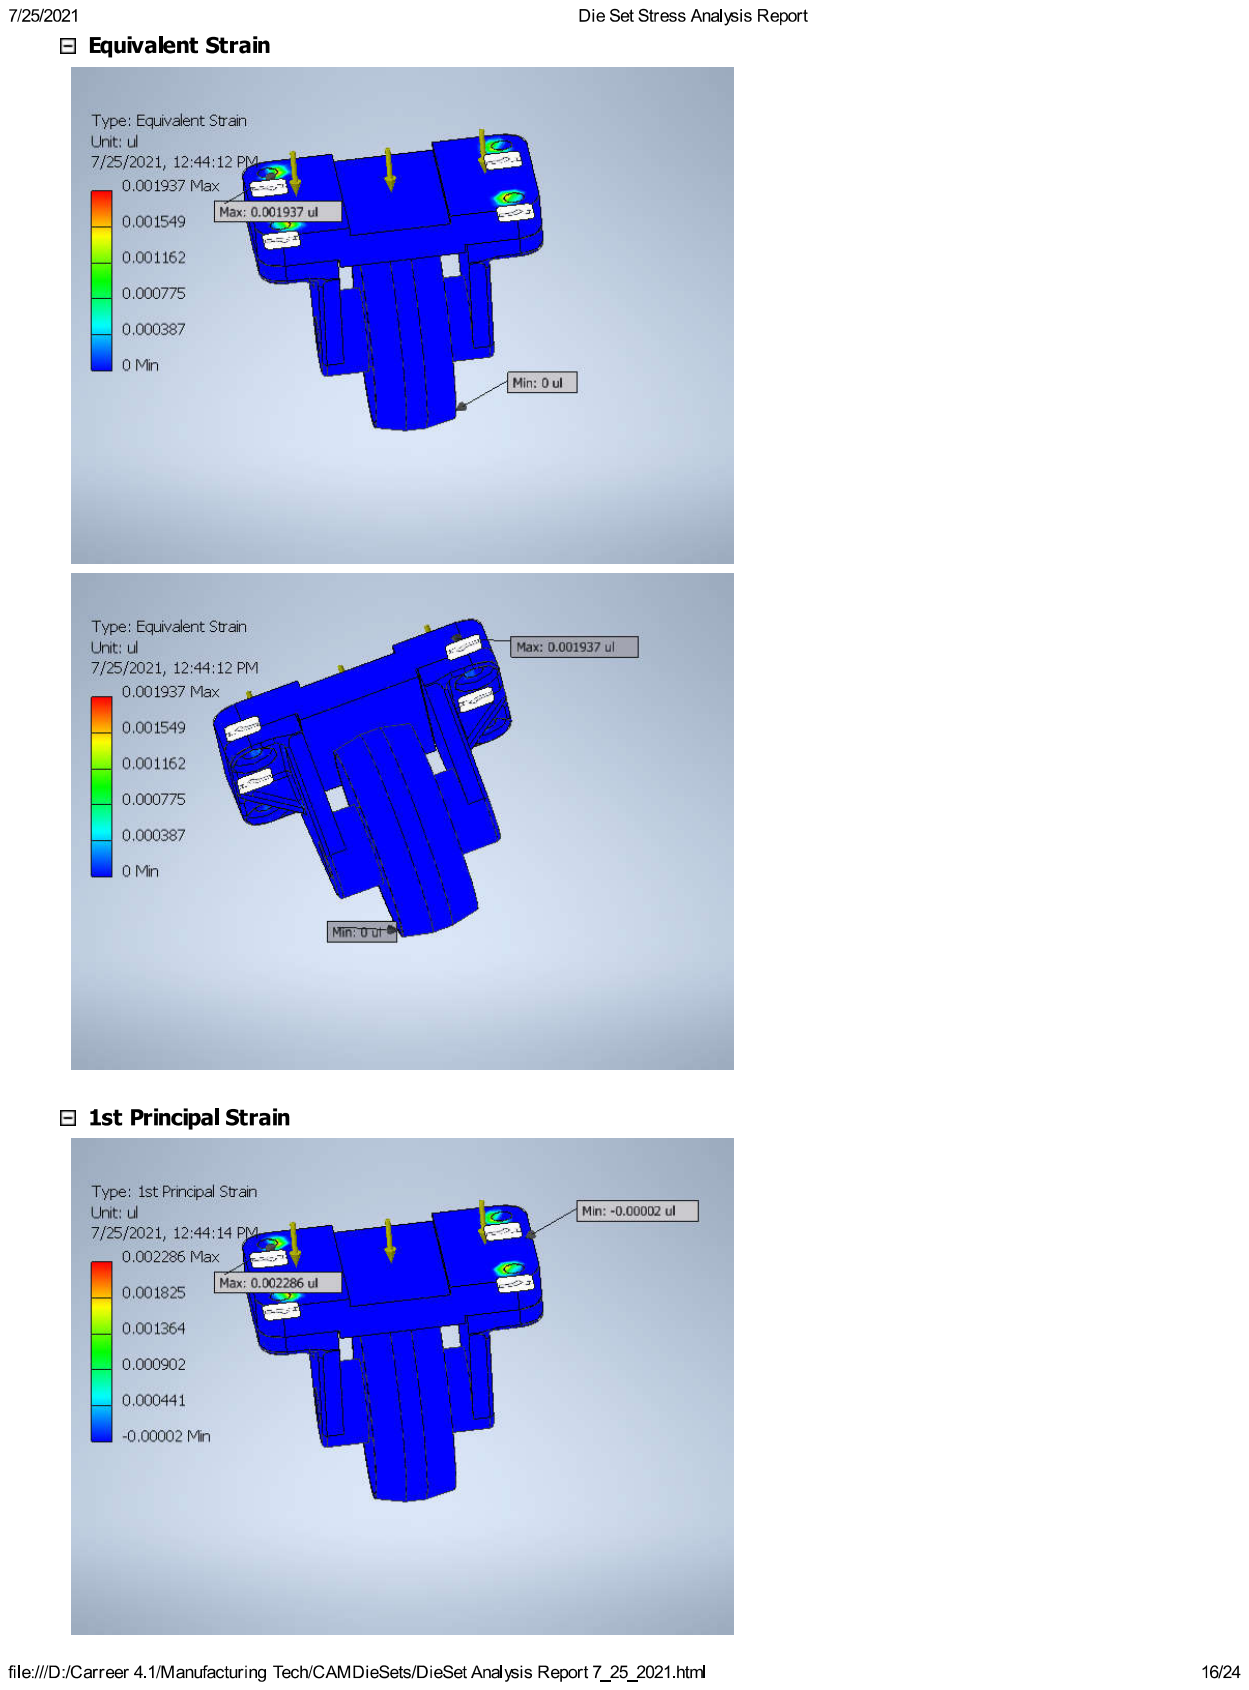
[picture p128: page 16]

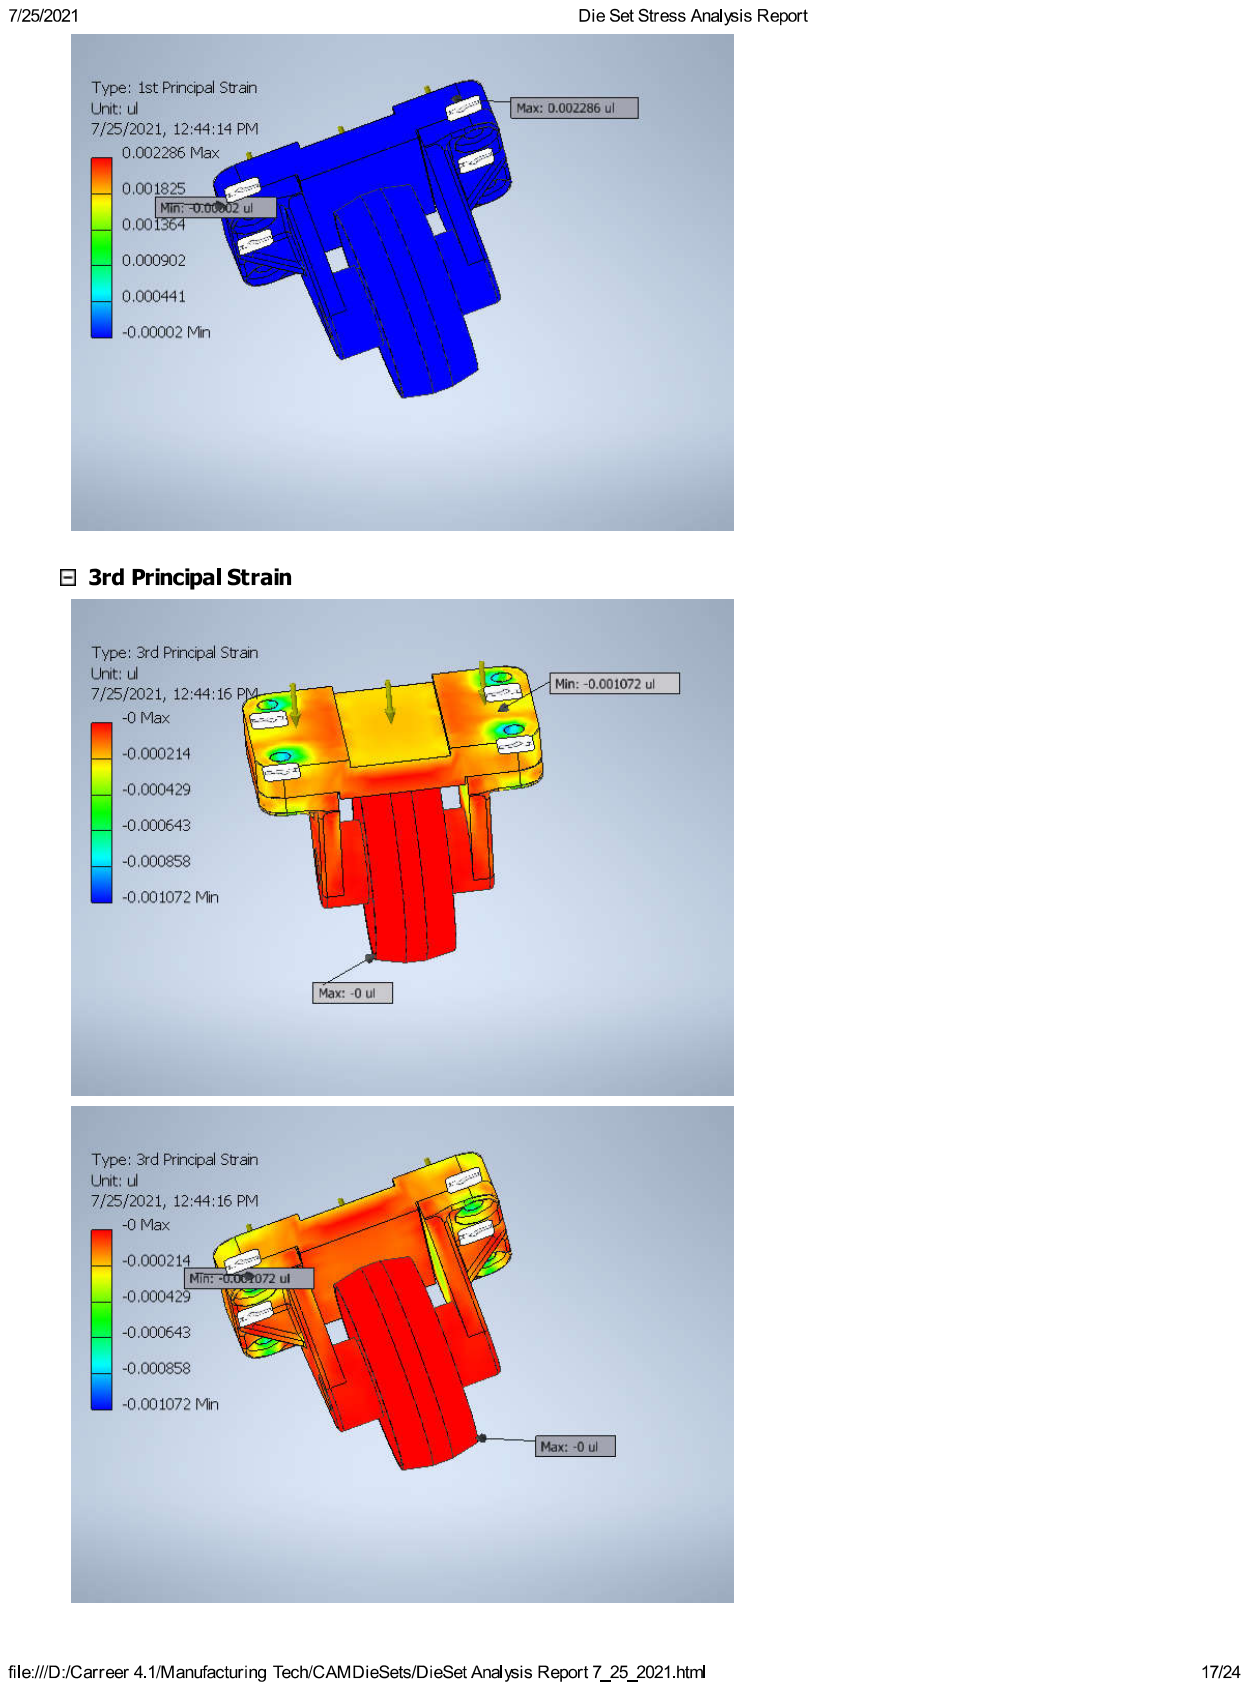
[picture p129: page 17]

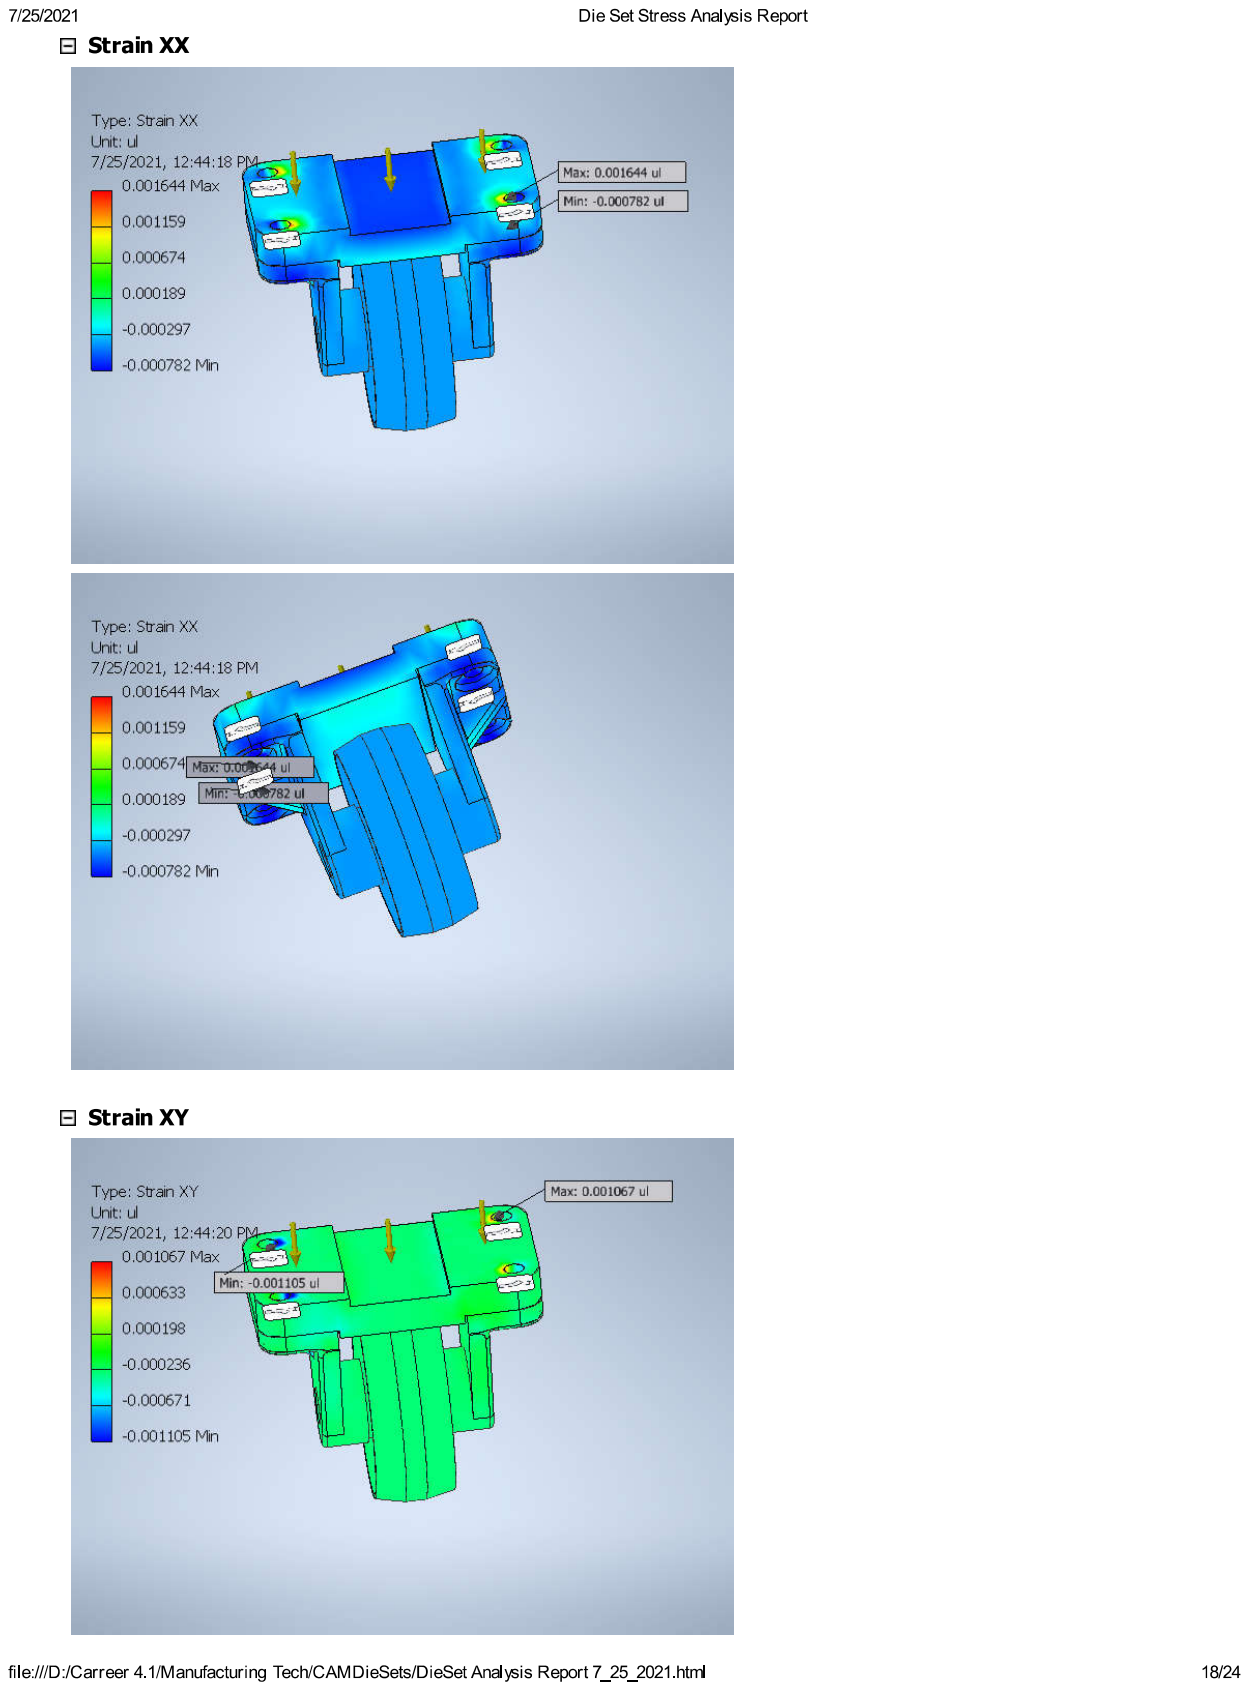
[picture p130: page 18]

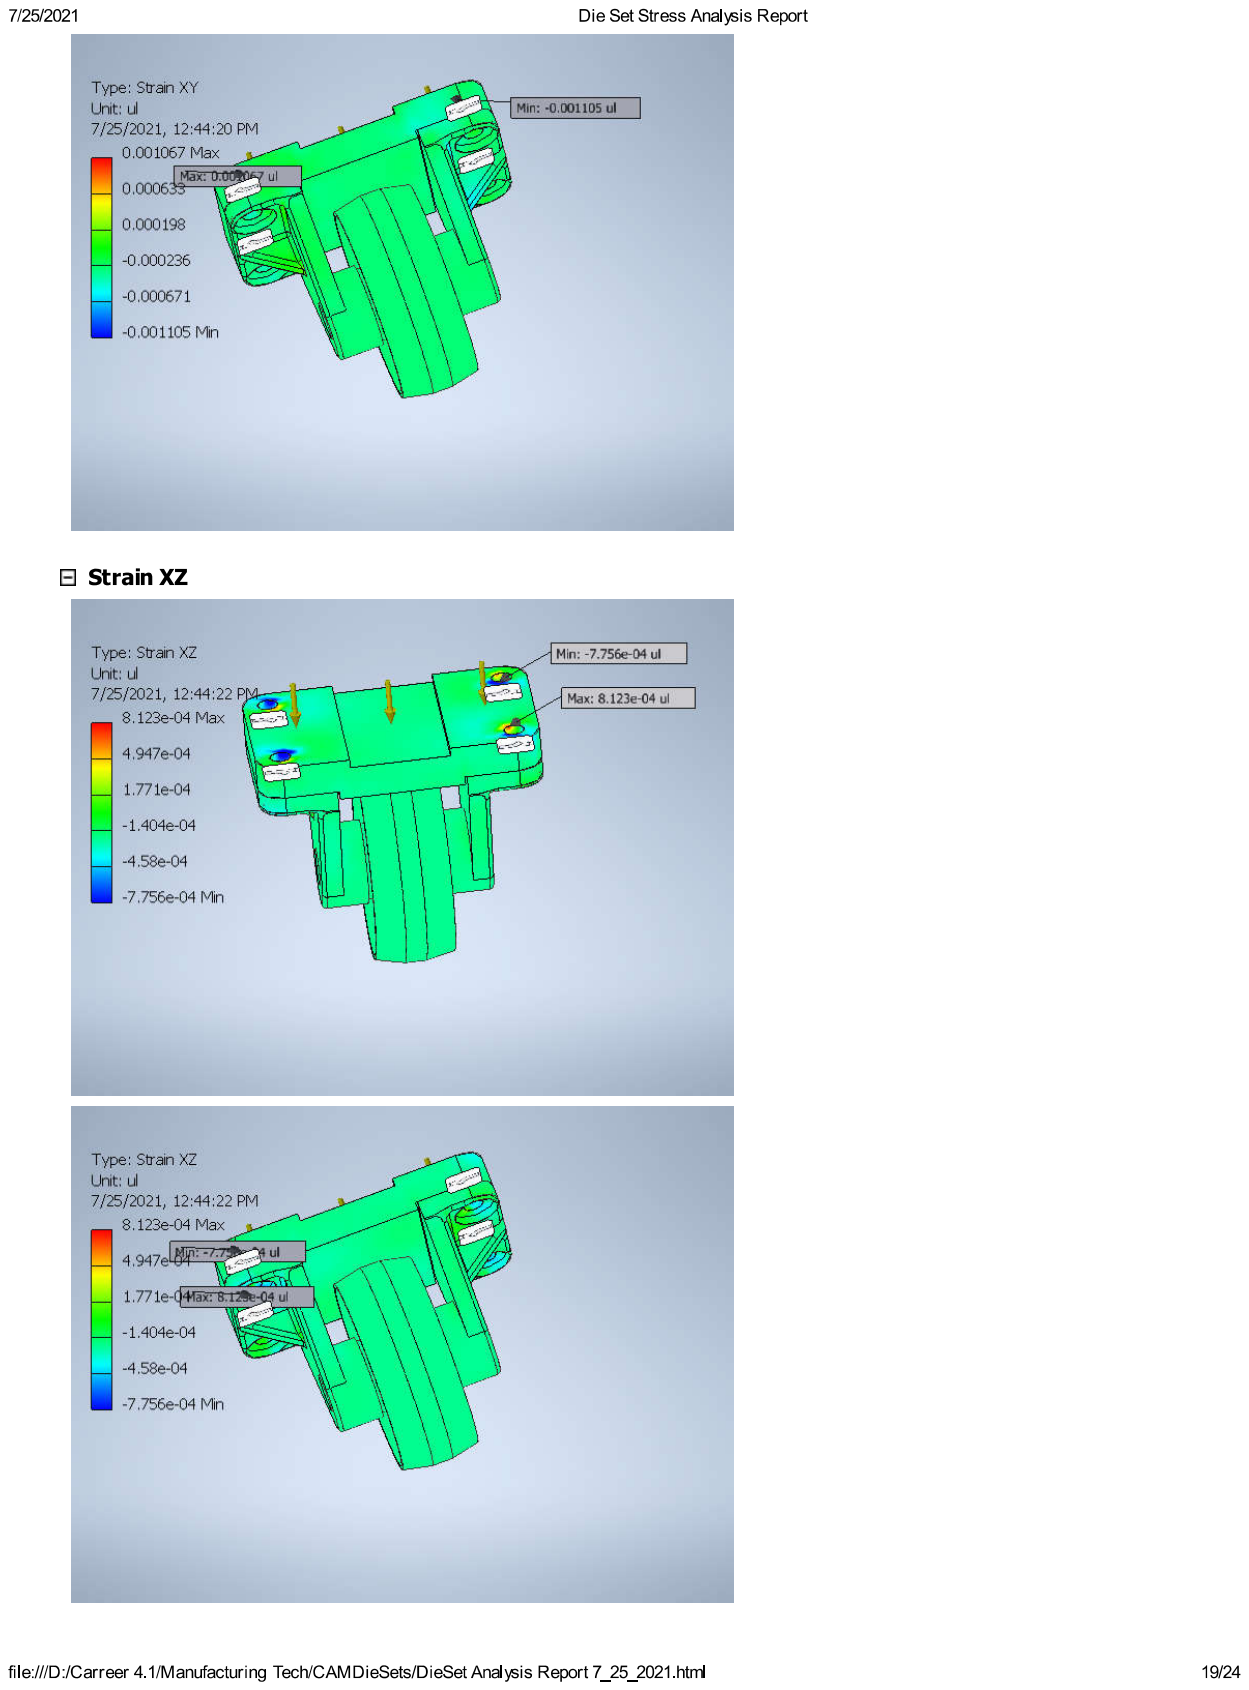
[picture p131: page 19]

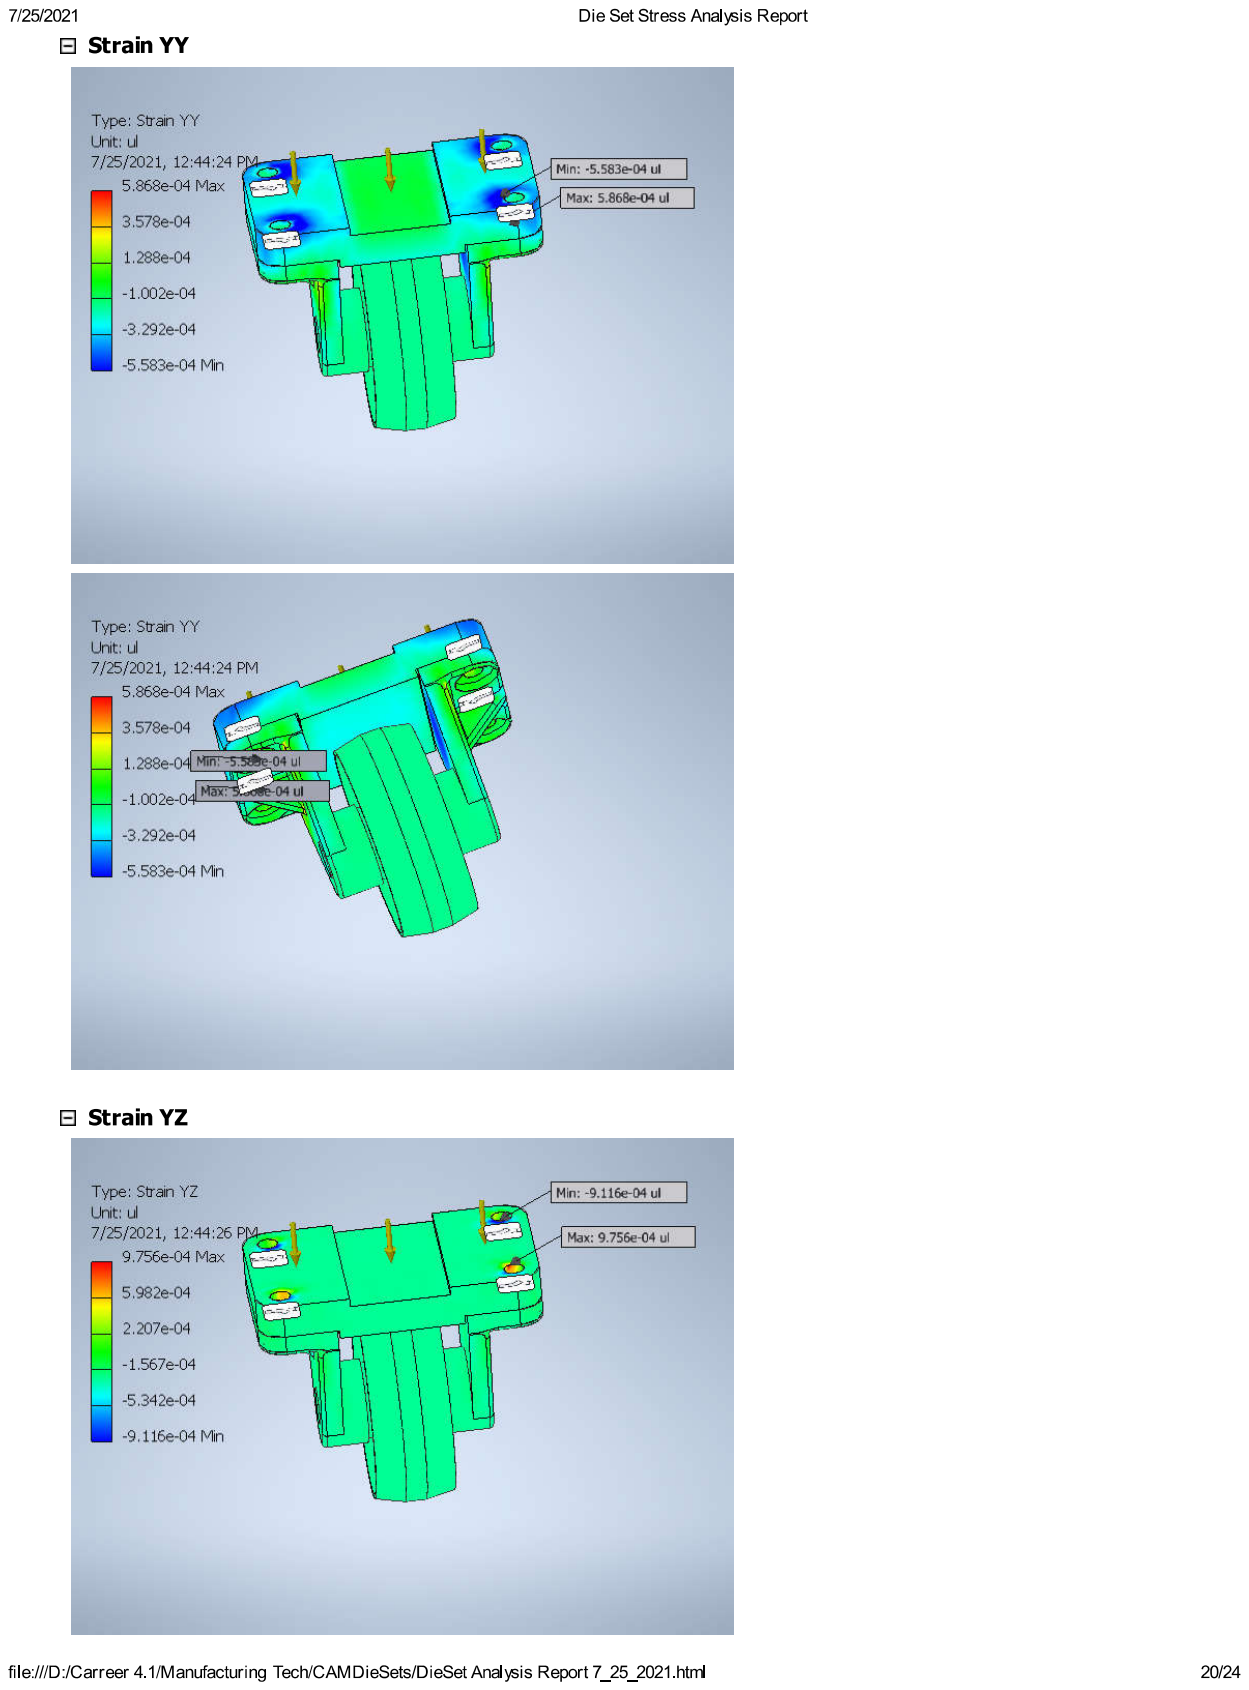
[picture p132: page 20]

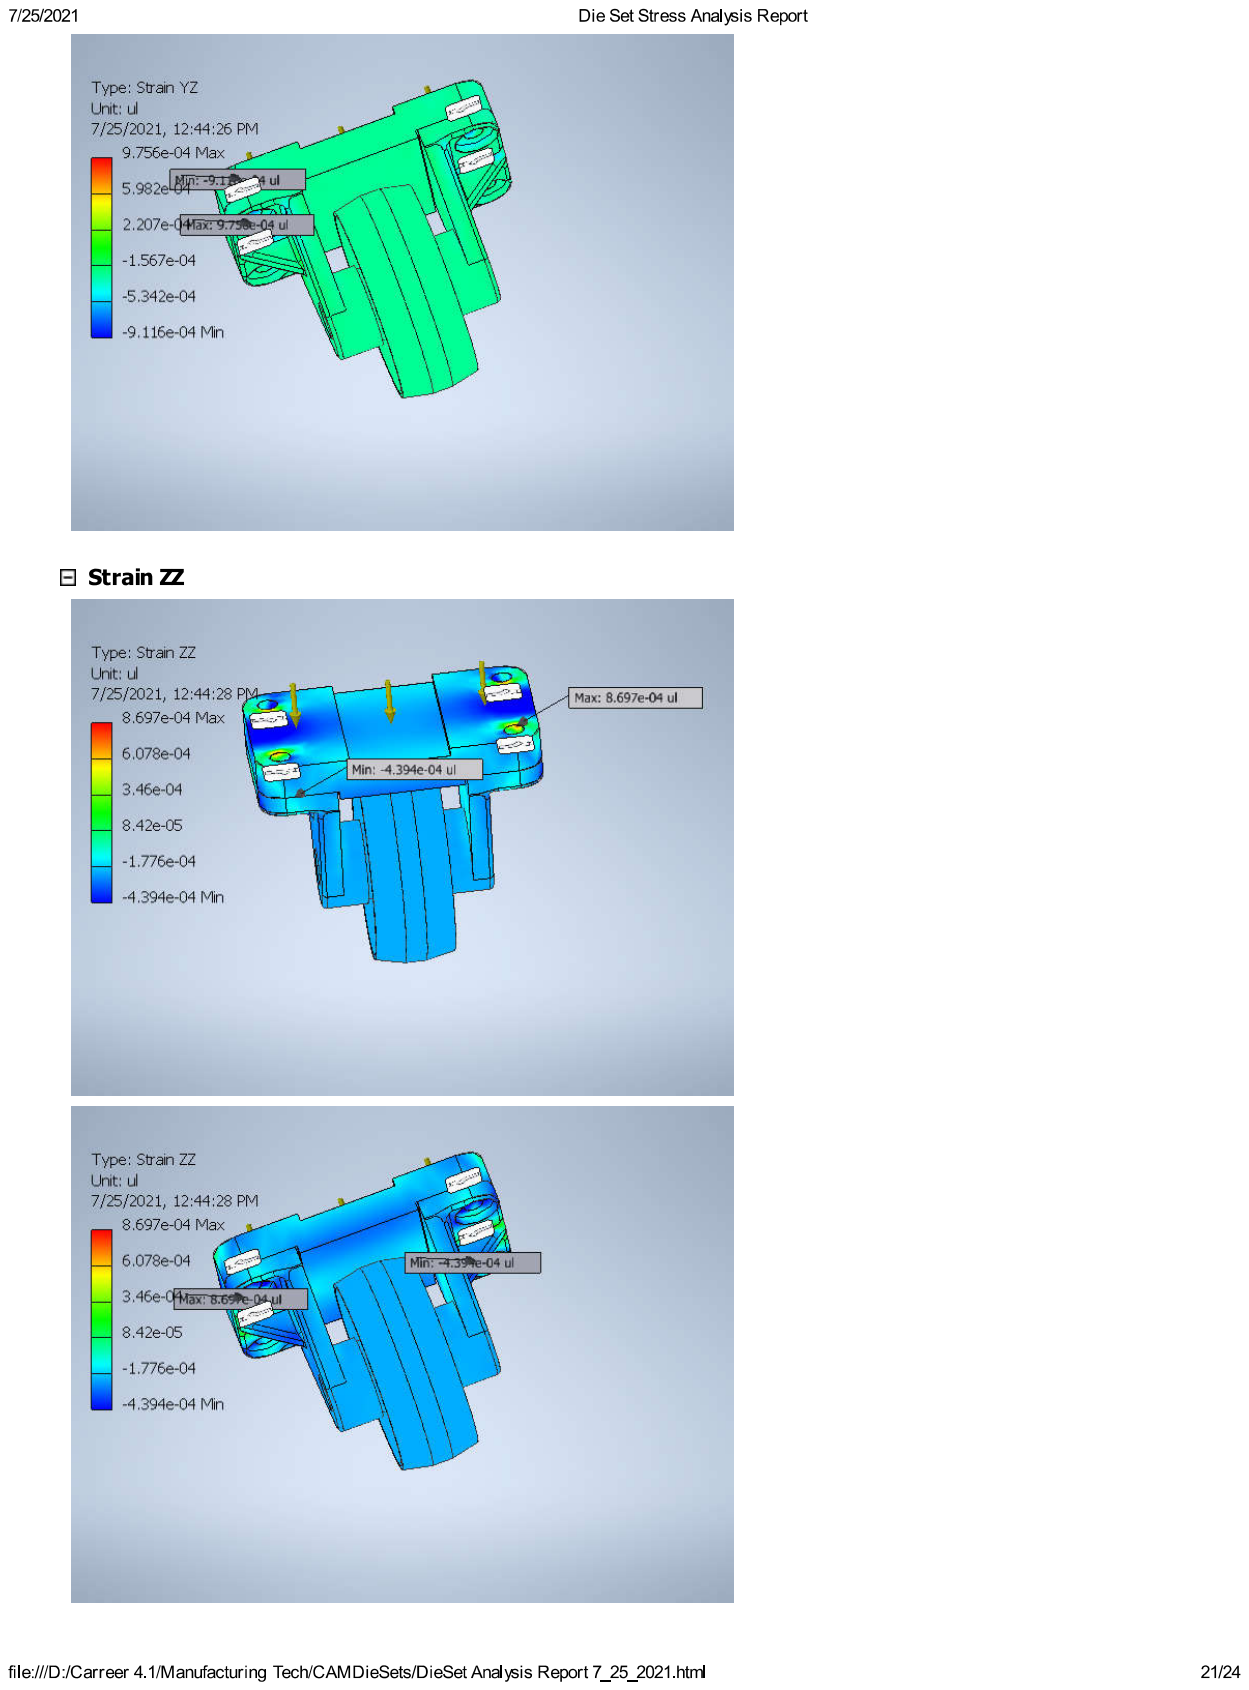
[picture p133: page 21]

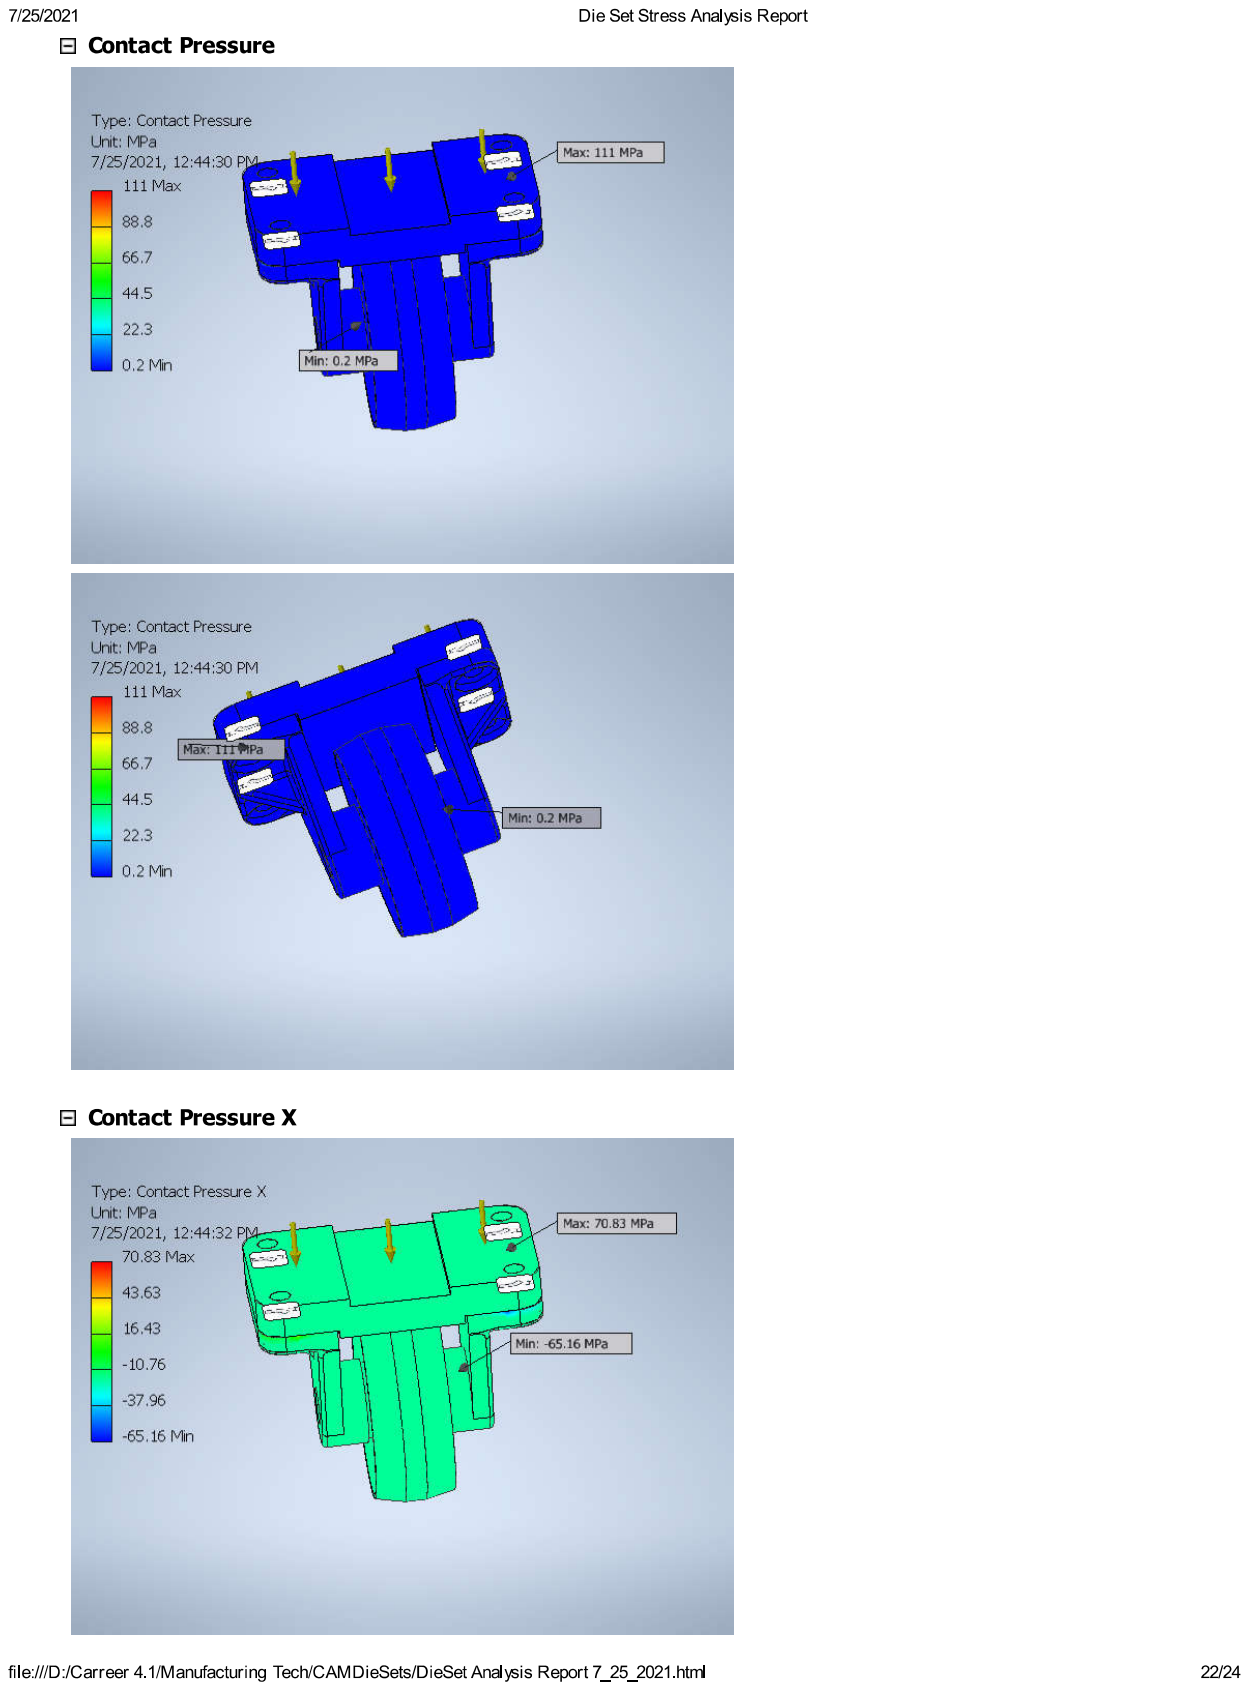
[picture p134: page 22]

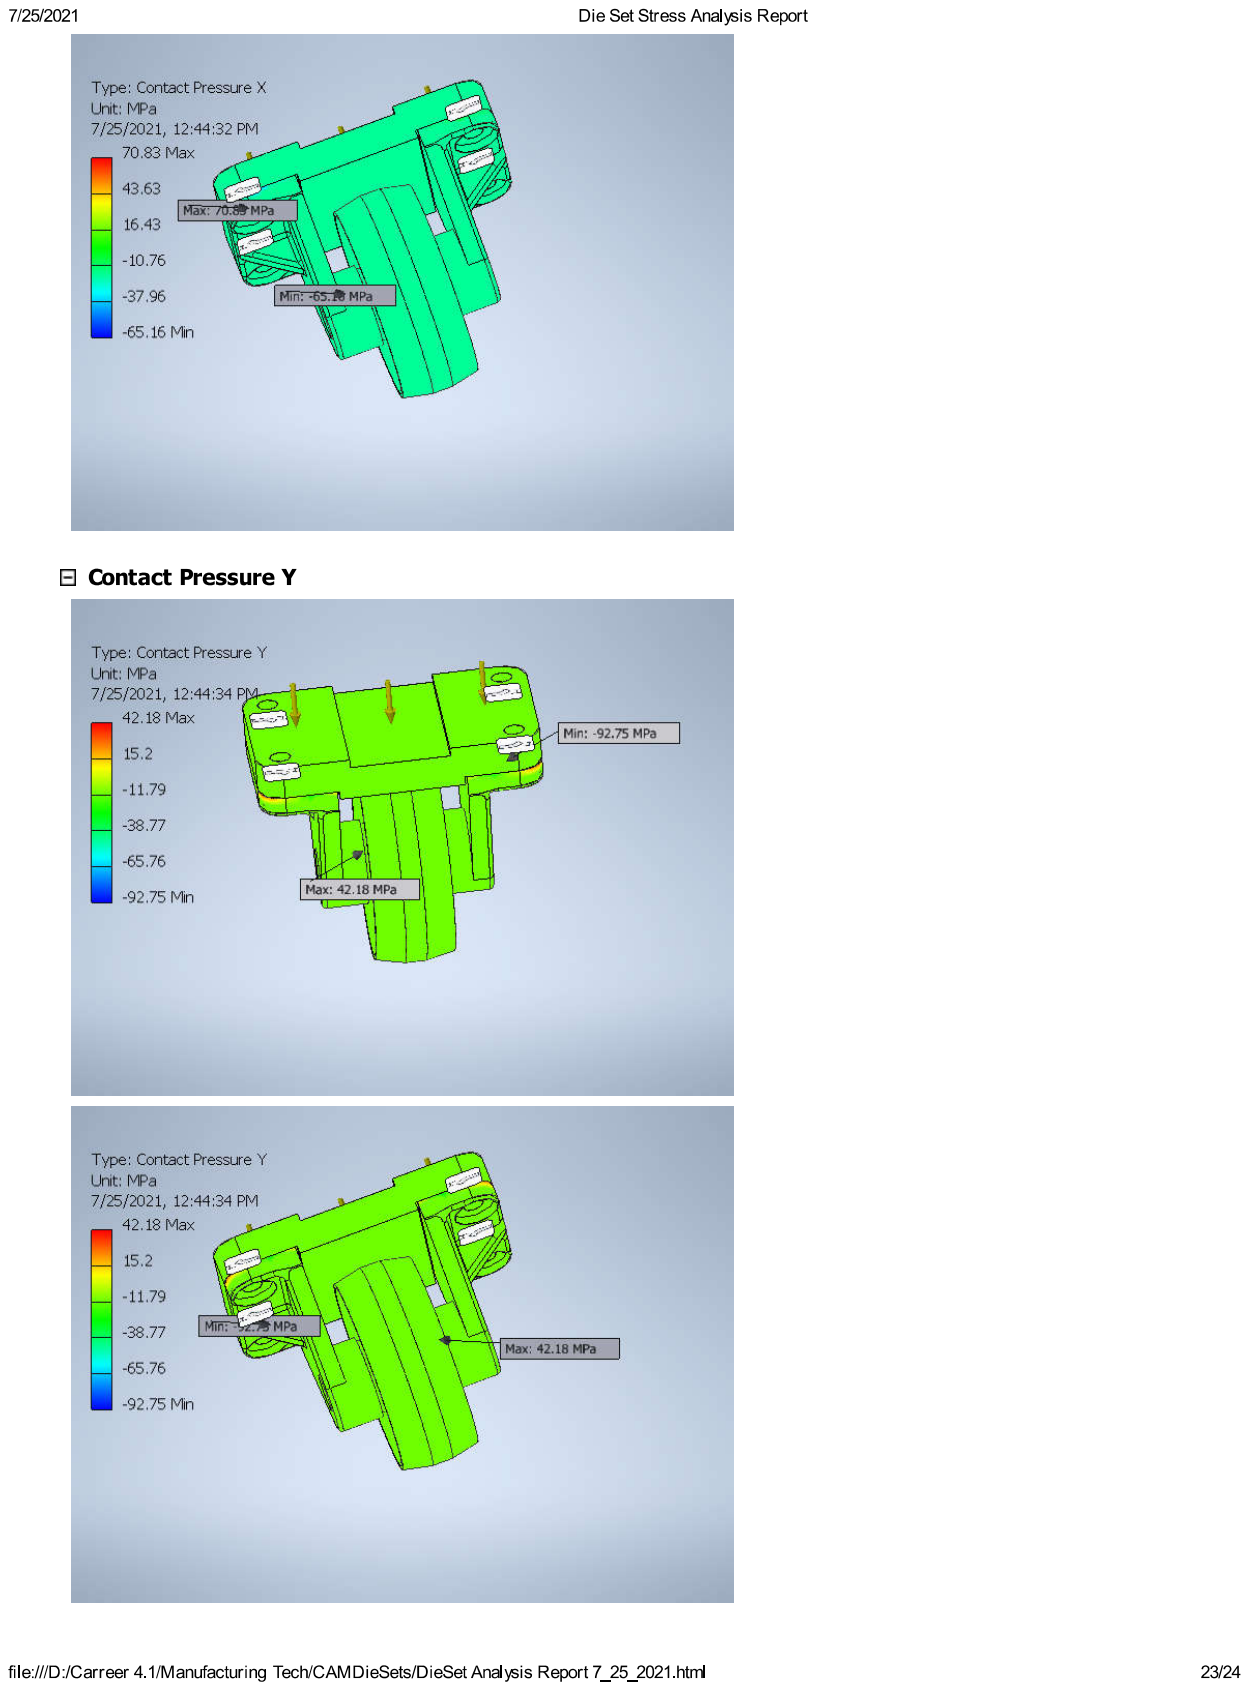
[picture p135: page 23]

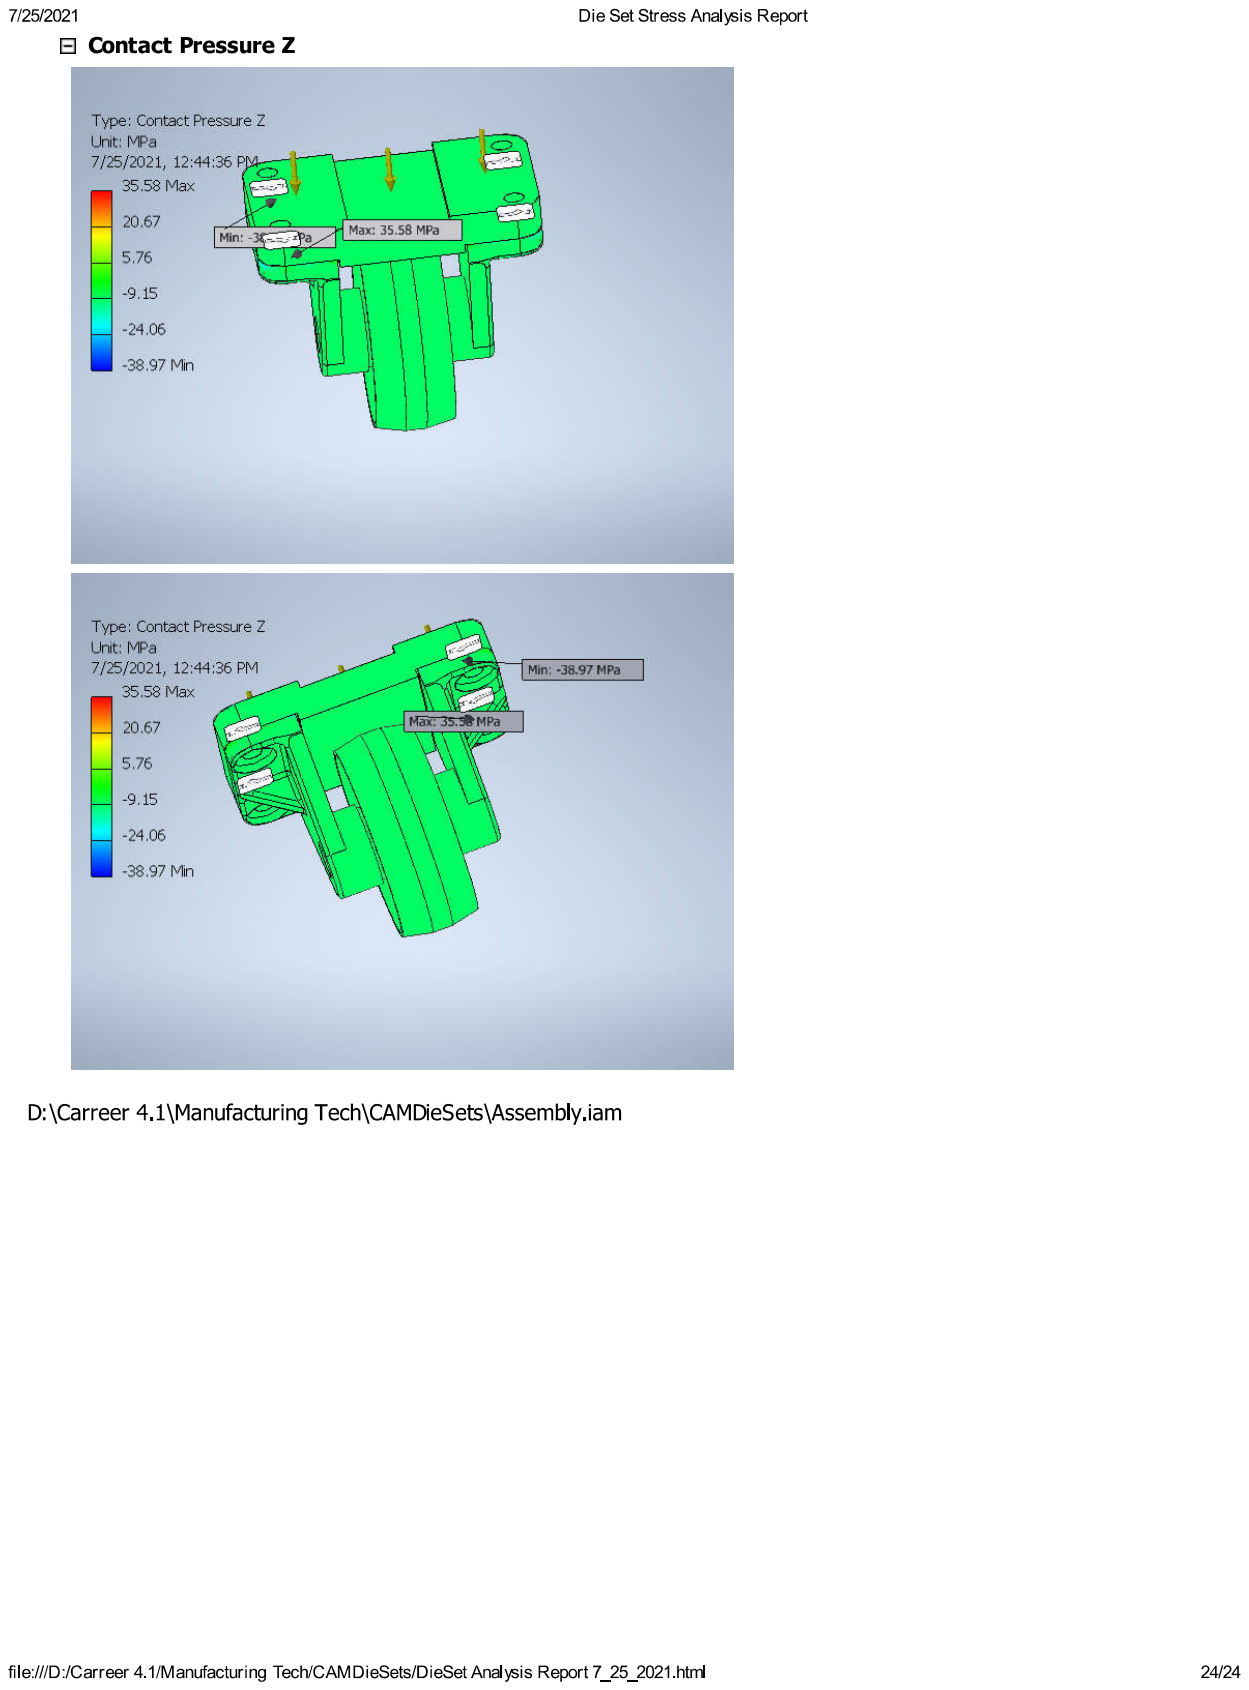
[picture p136: page 24]
