EricoDeMecha/Die-Set/Reports/DieSetAnalysisReports/Top Plate Analysis Report.pdf

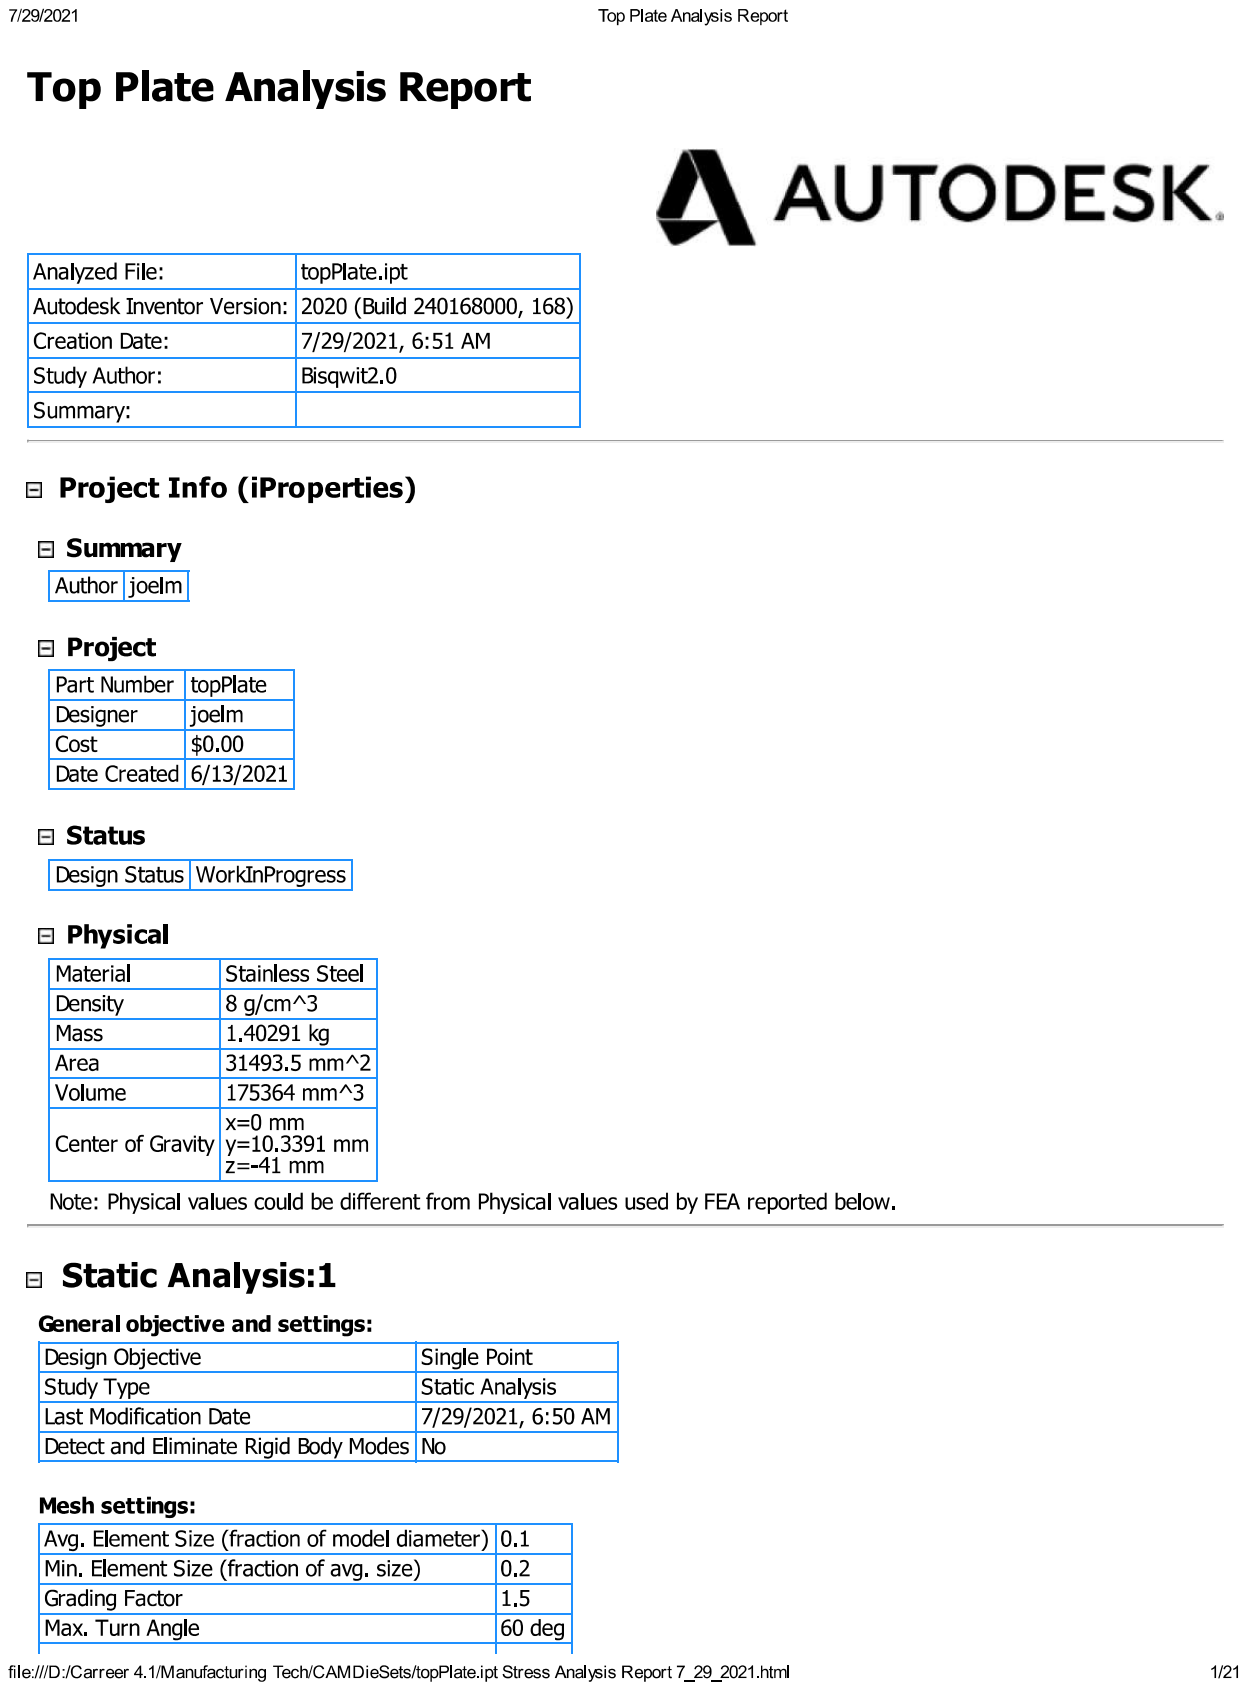
[picture p137: page 1]

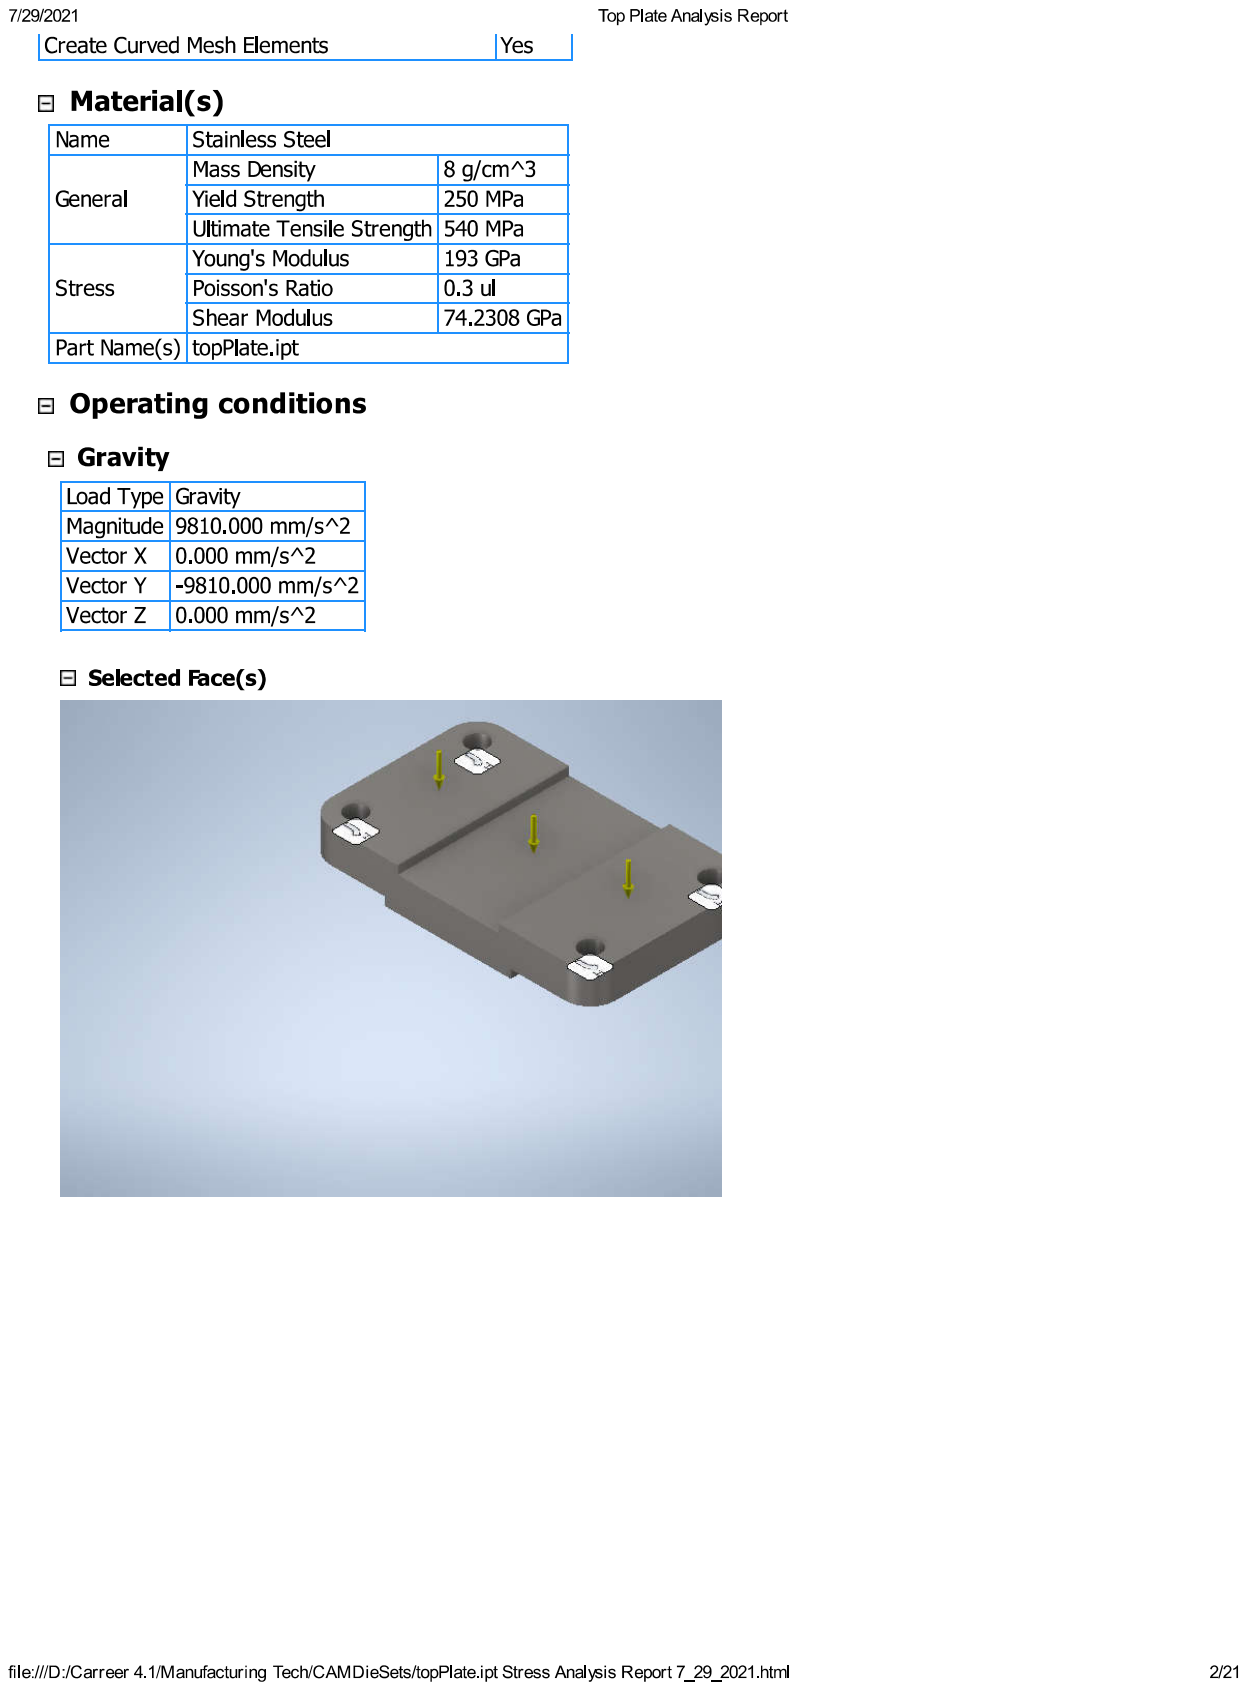
[picture p138: page 2]

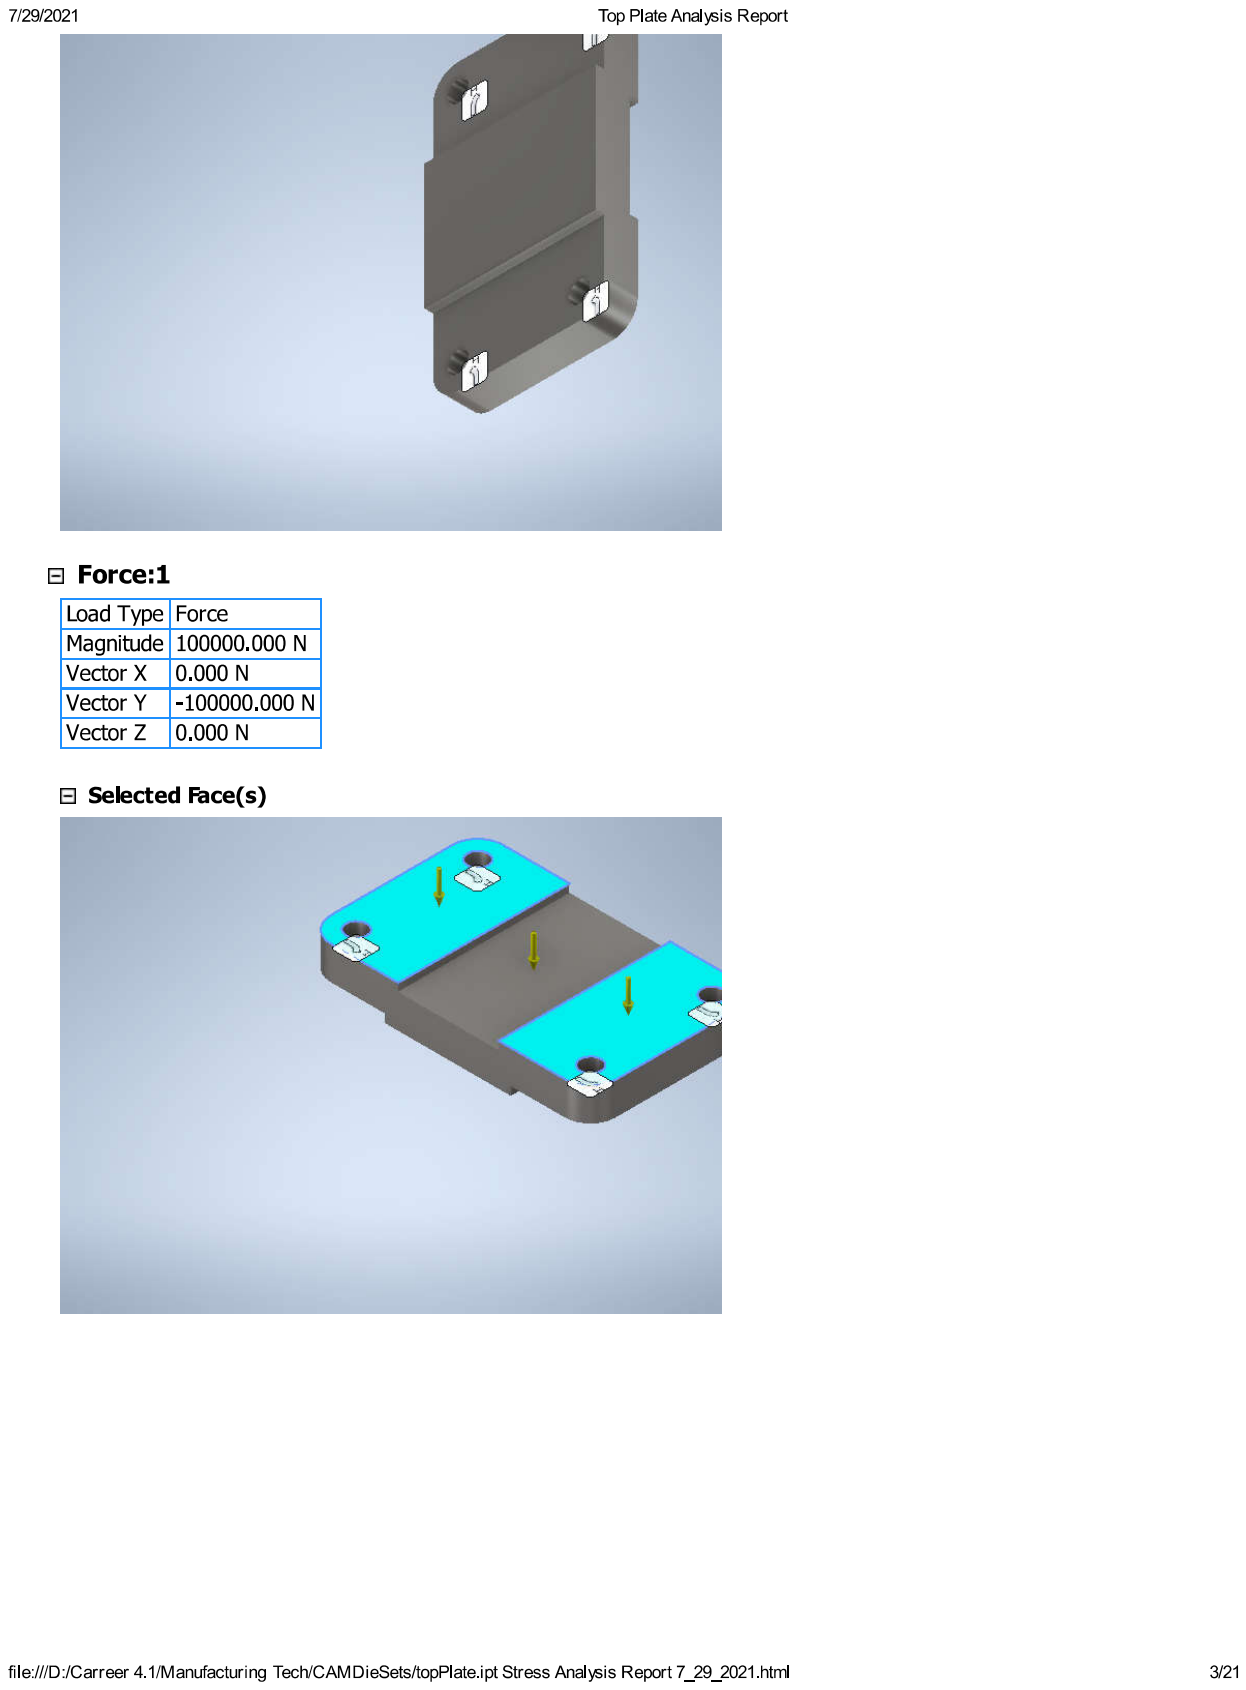
[picture p139: page 3]

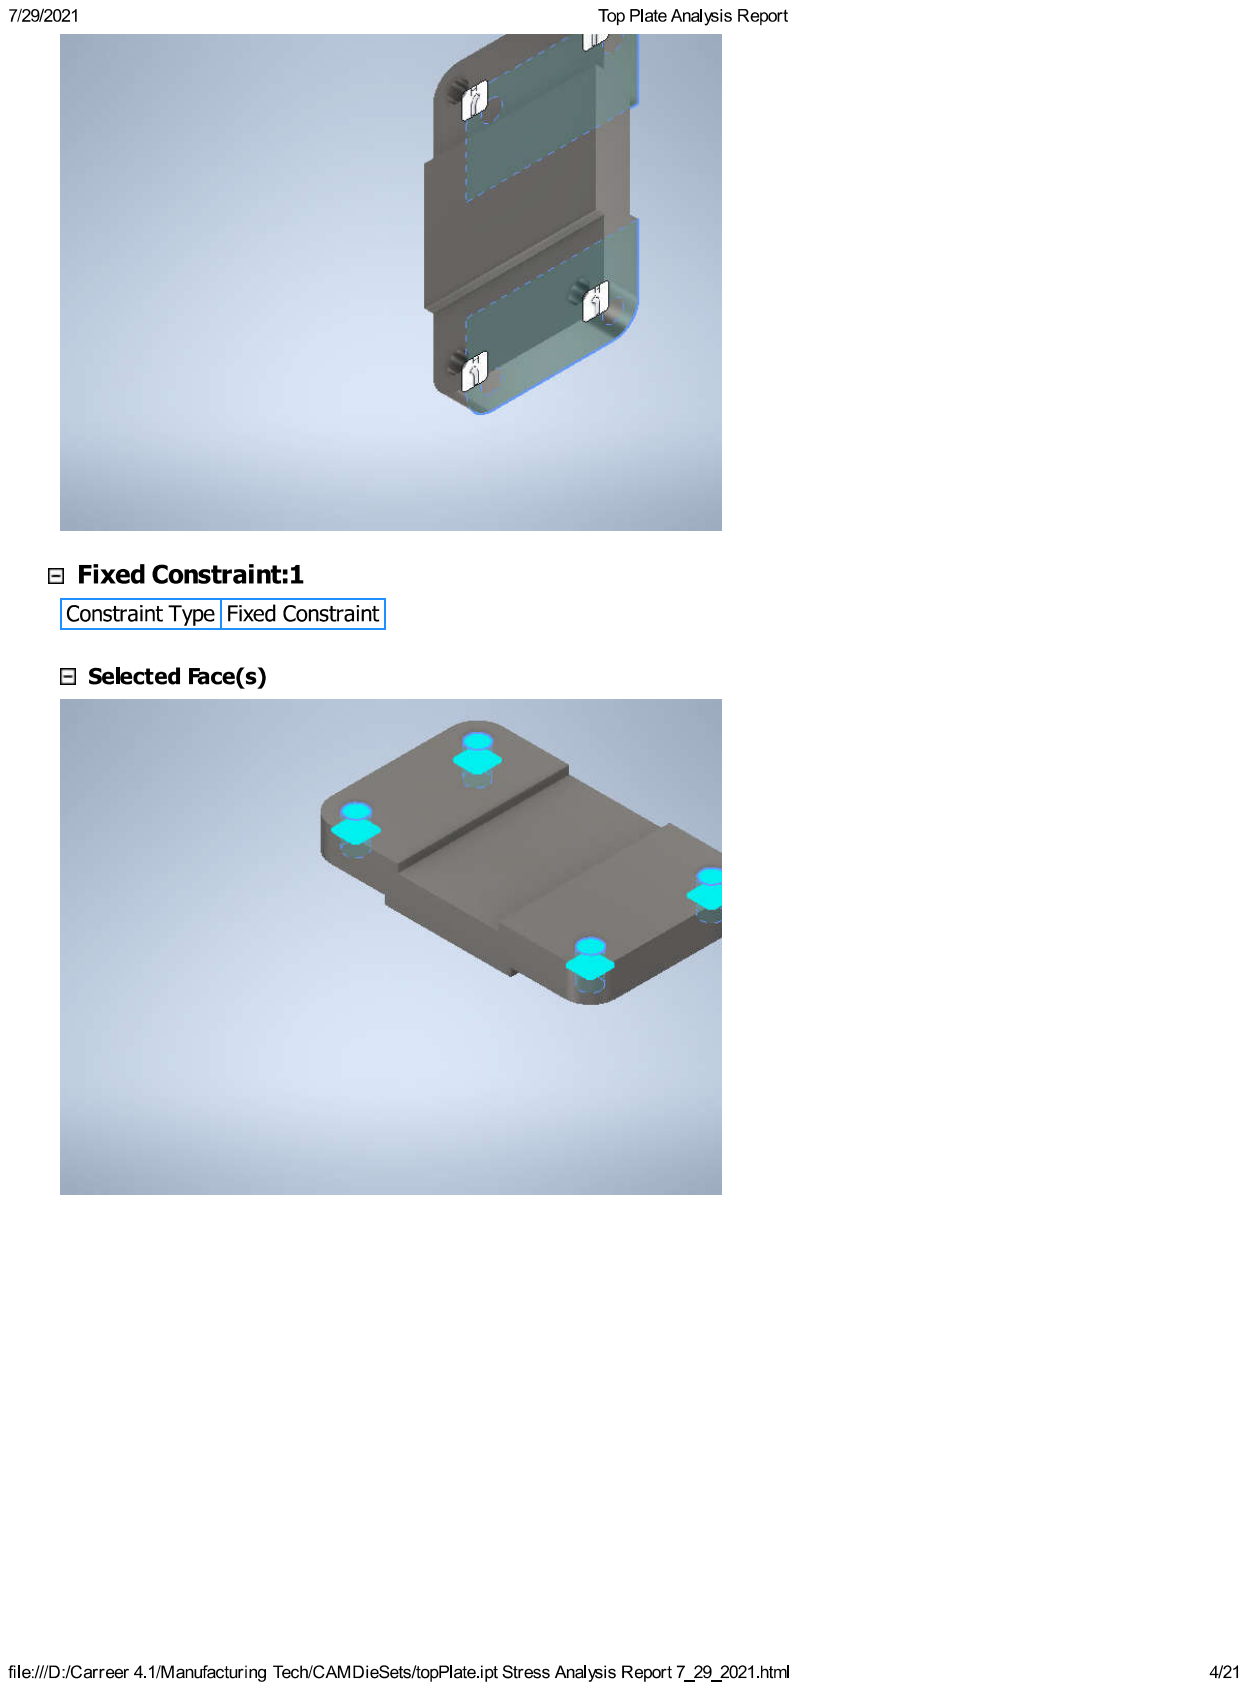
[picture p140: page 4]

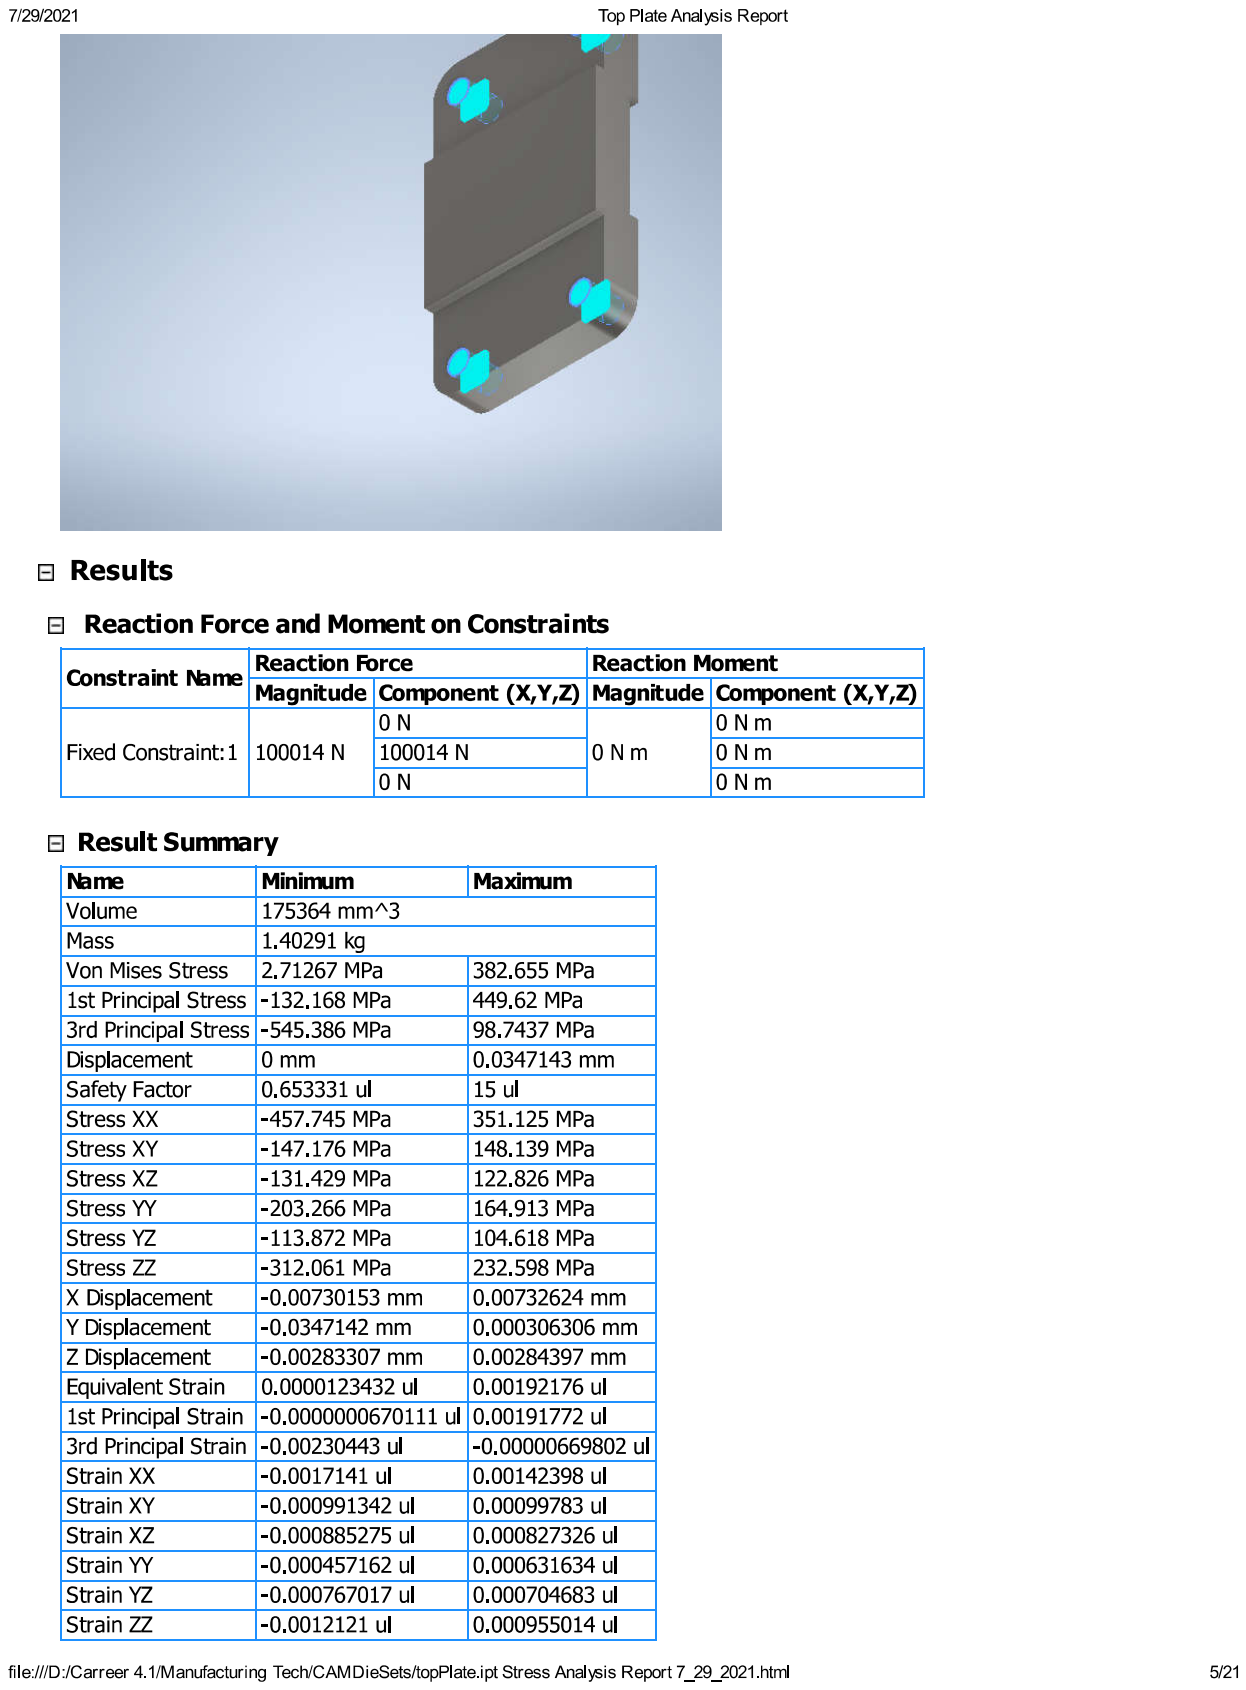
[picture p141: page 5]

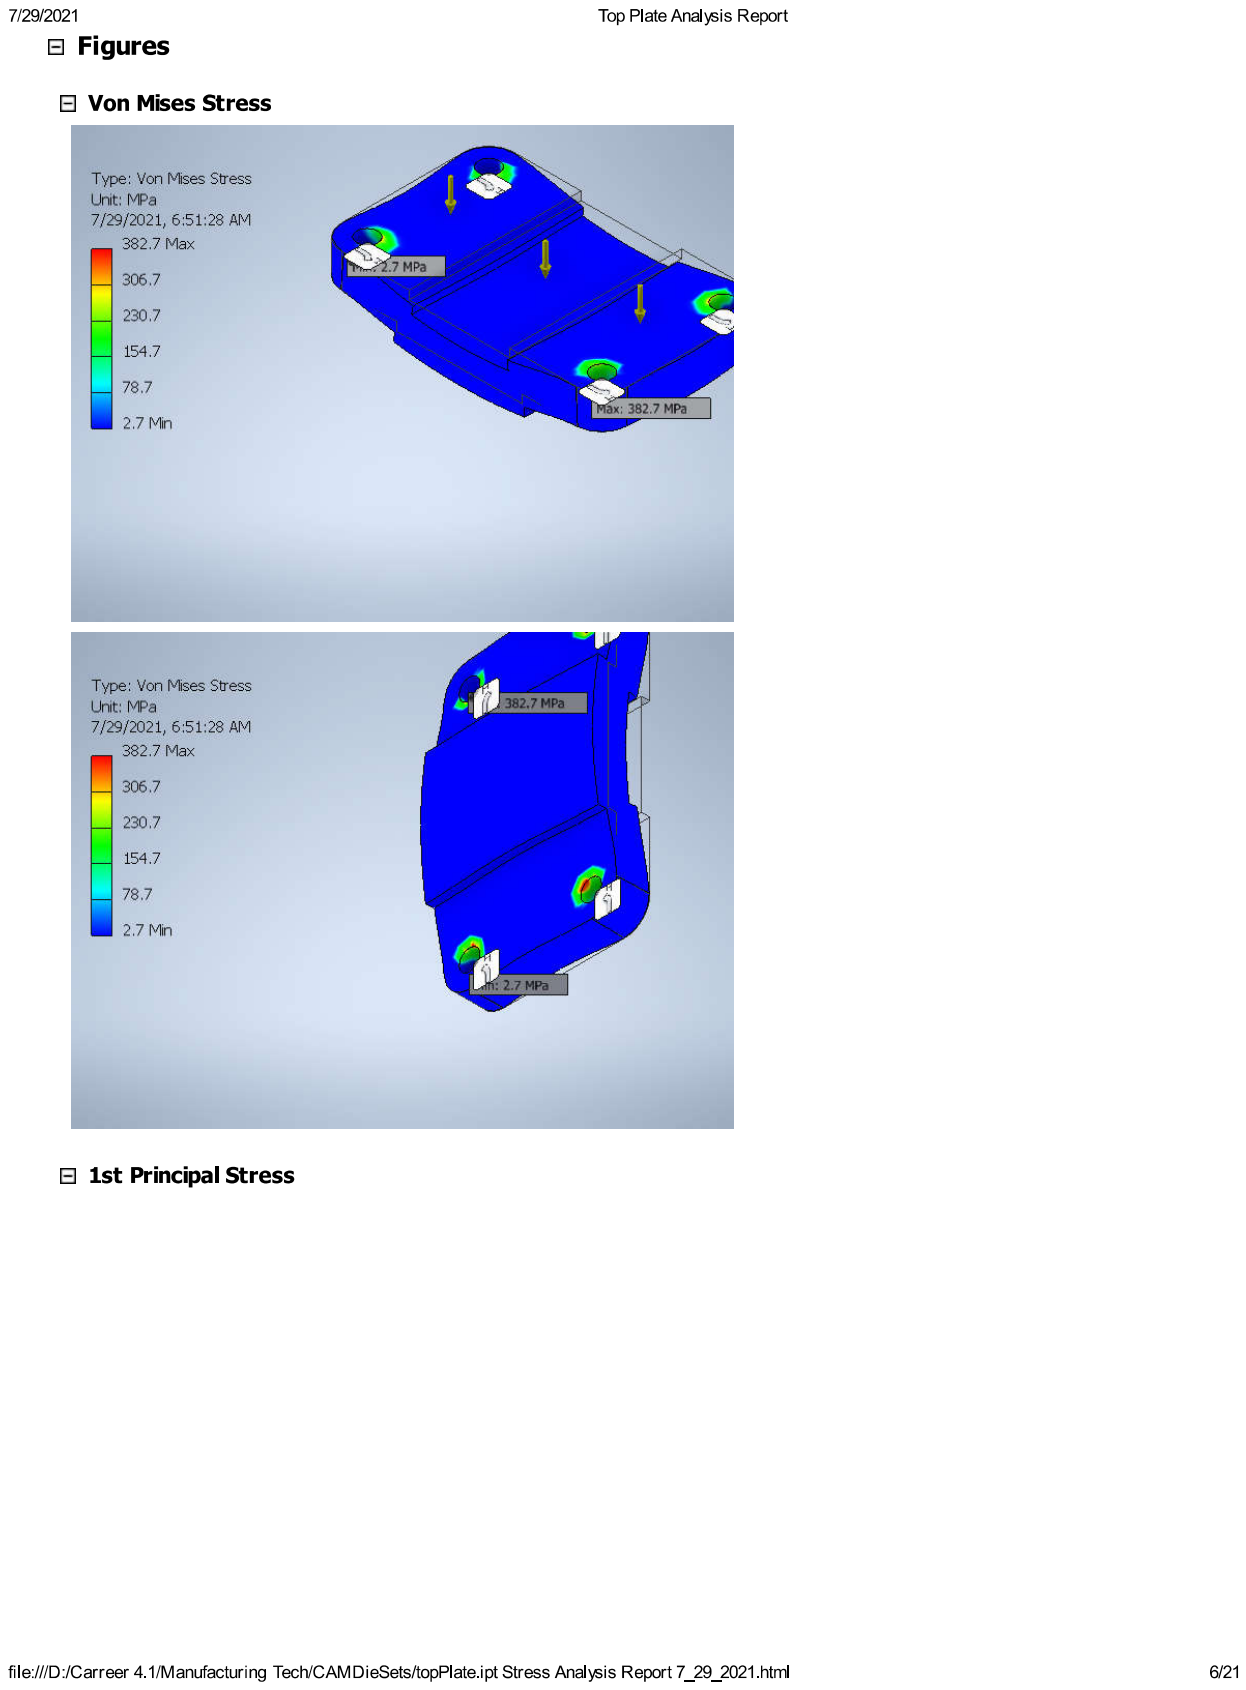
[picture p142: page 6]

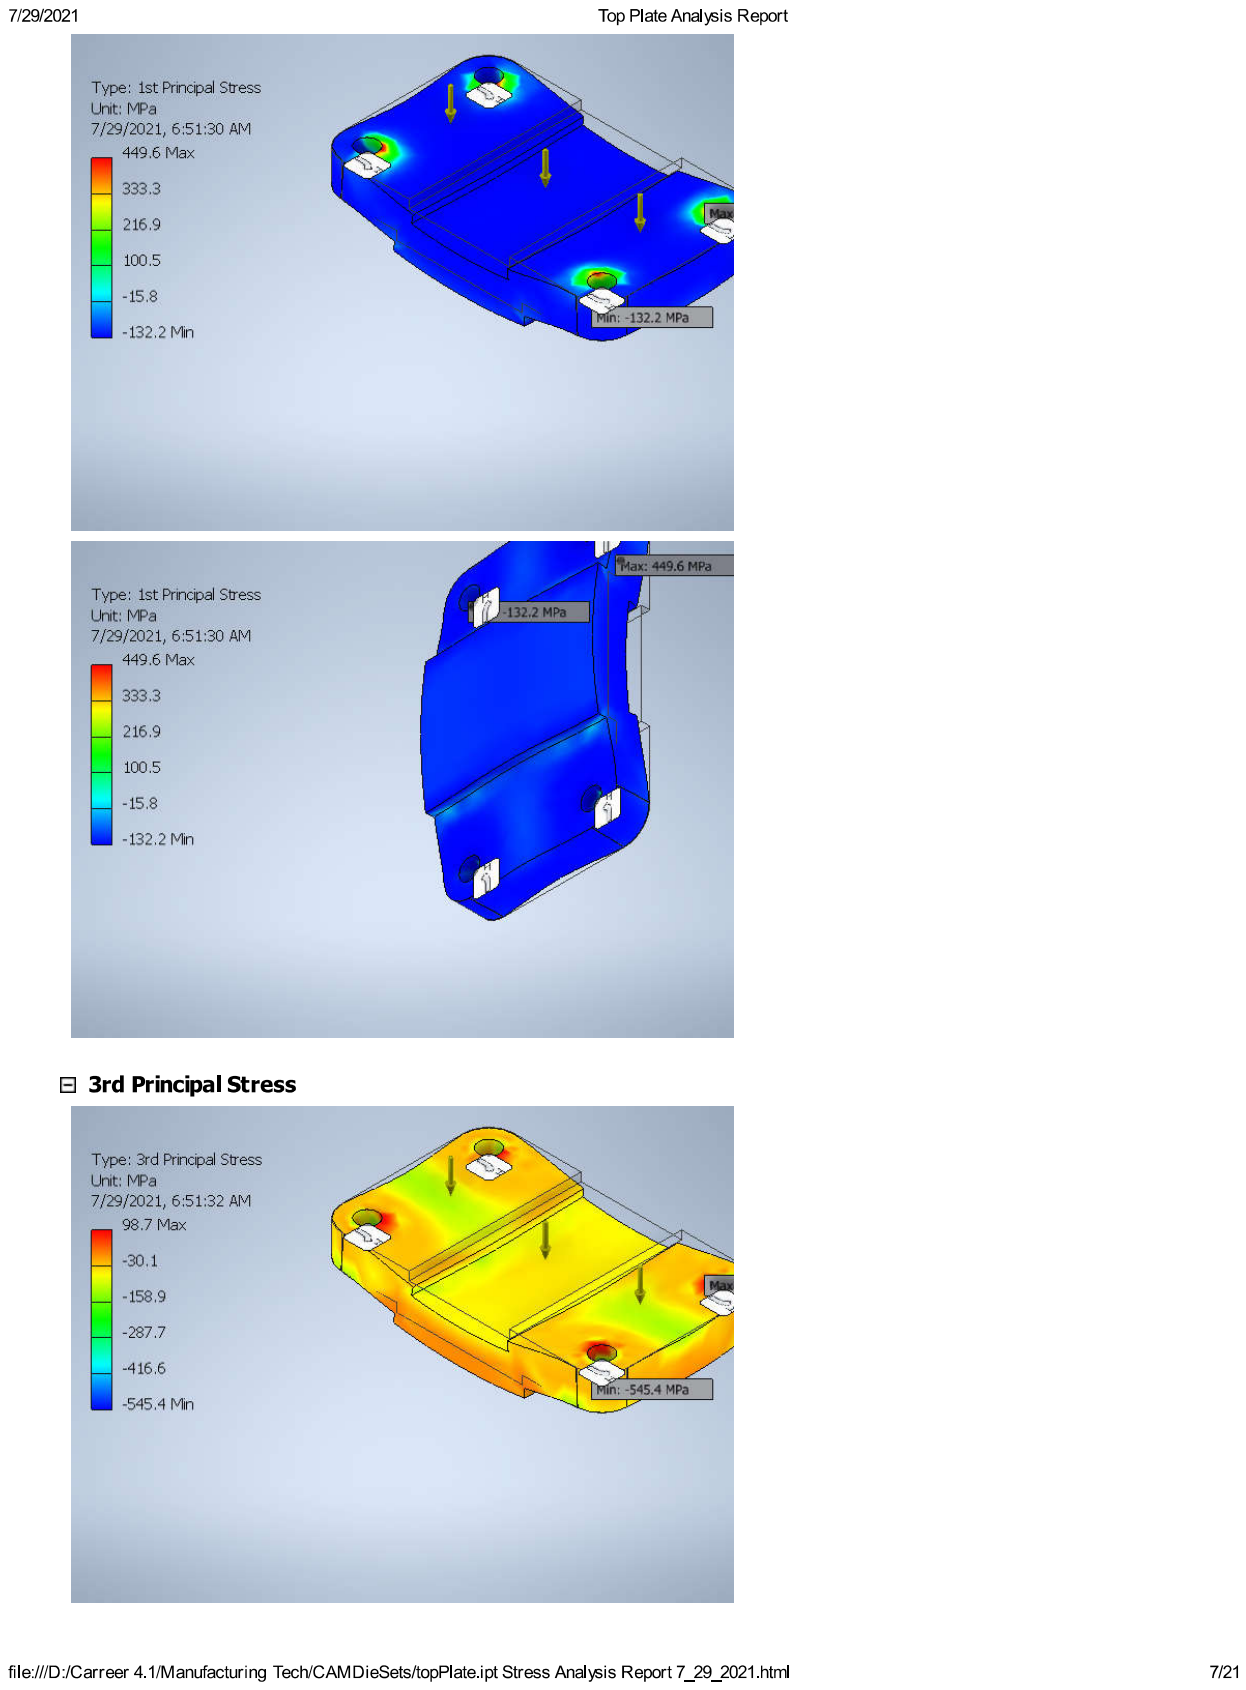
[picture p143: page 7]

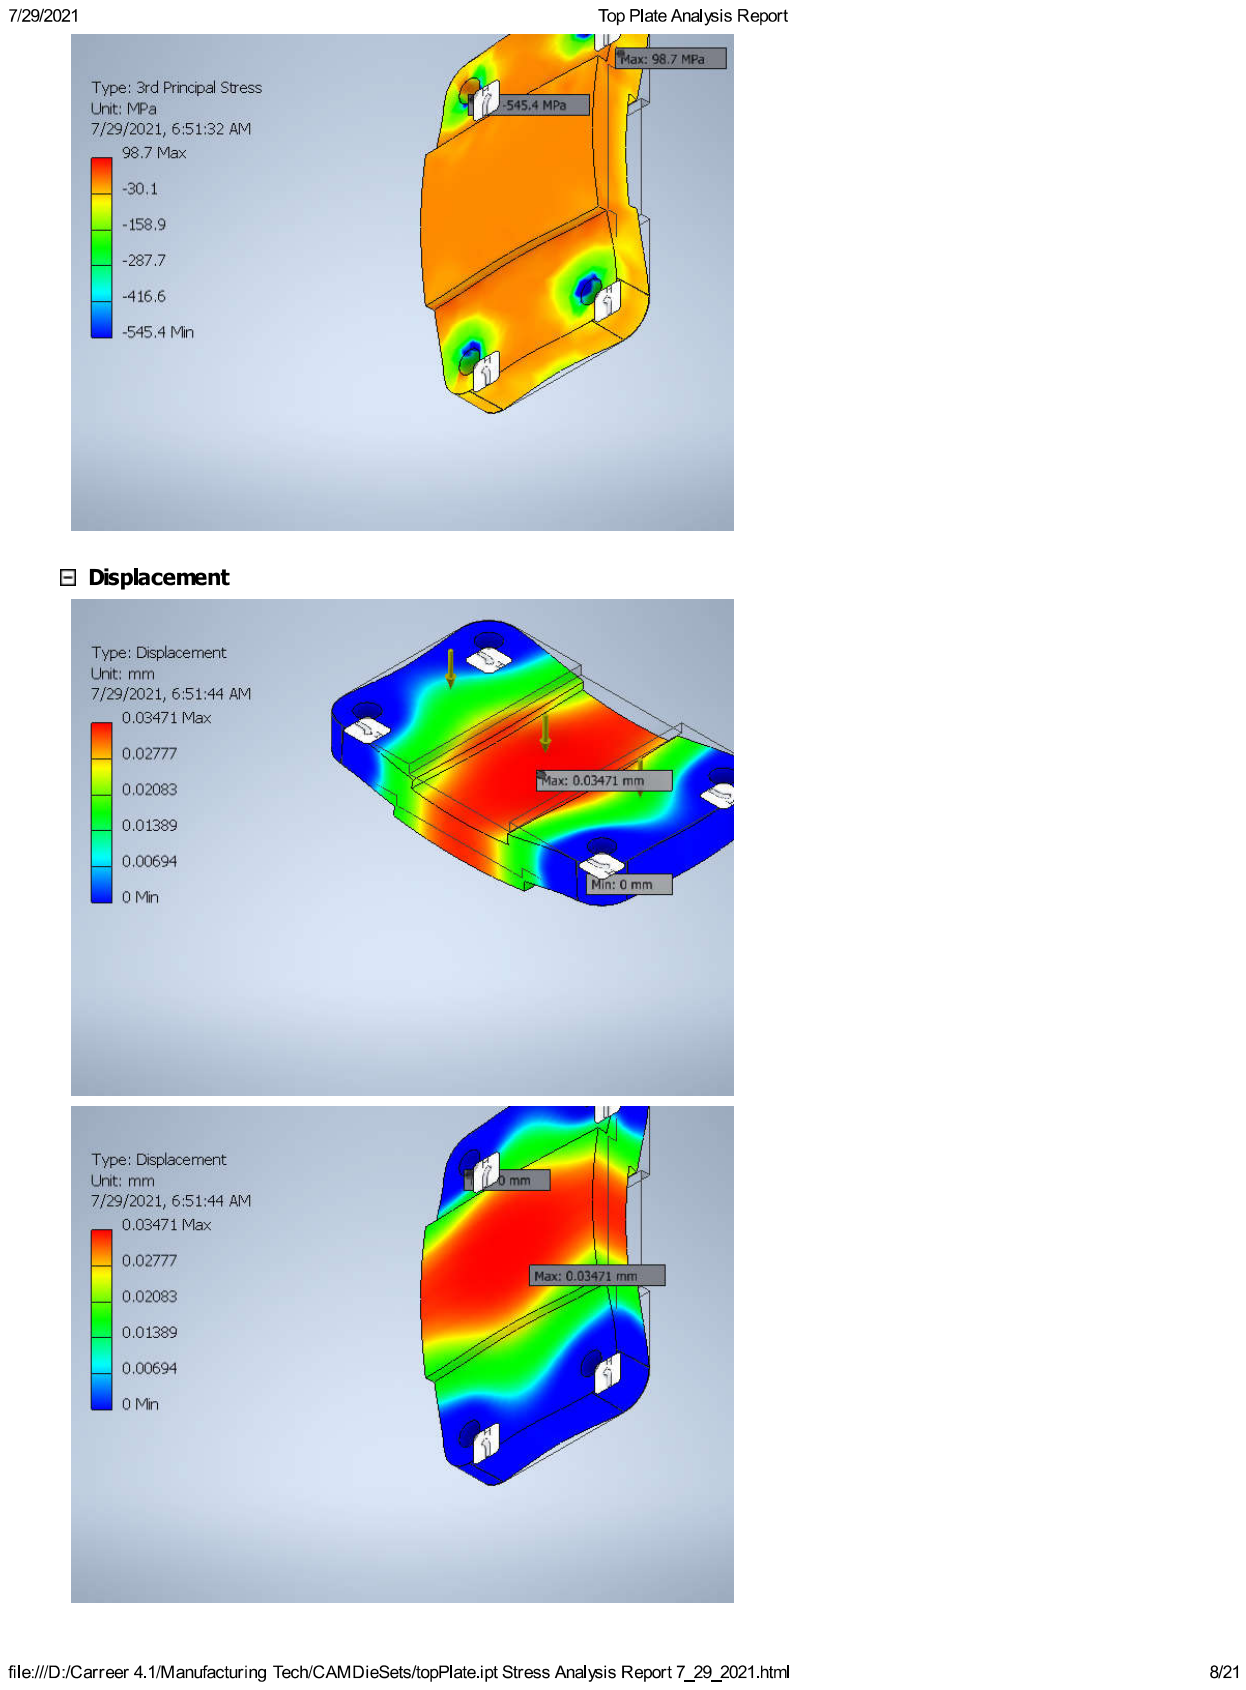
[picture p144: page 8]

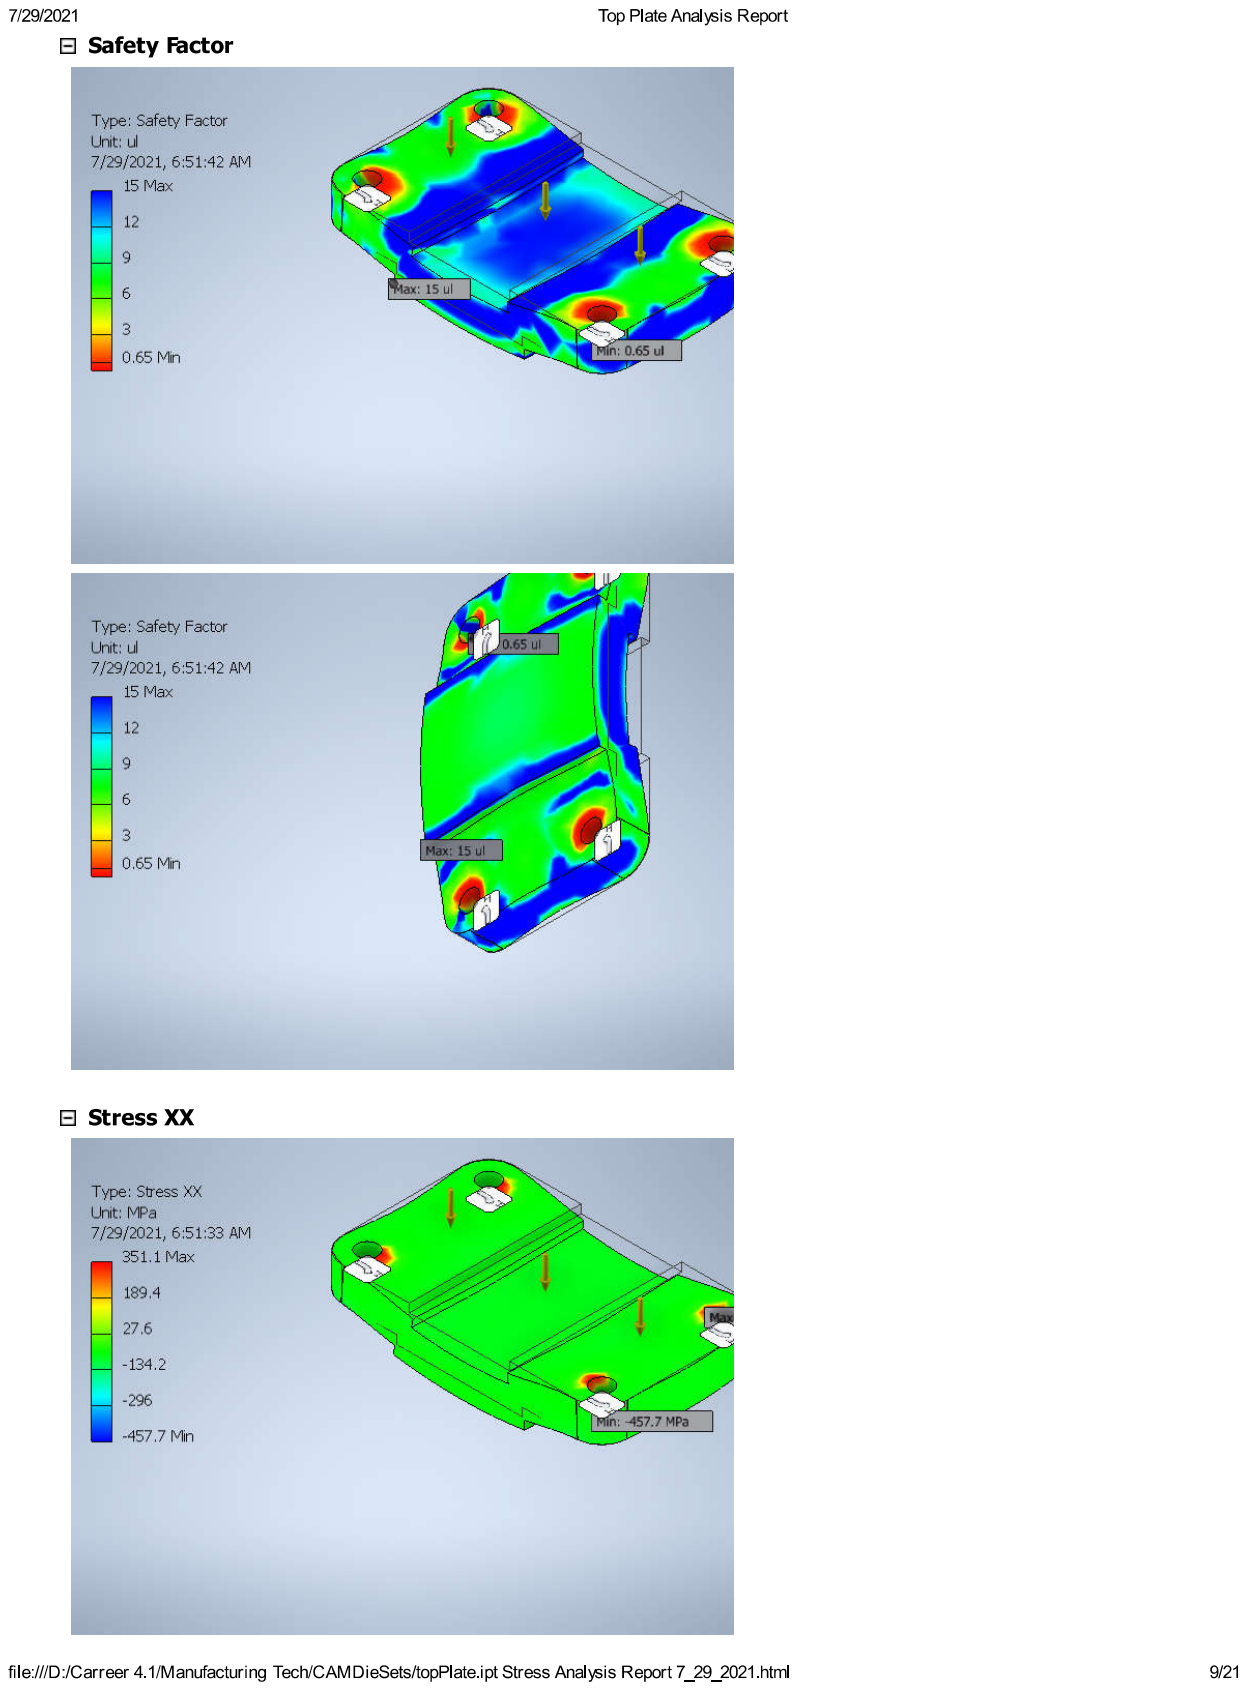
[picture p145: page 9]

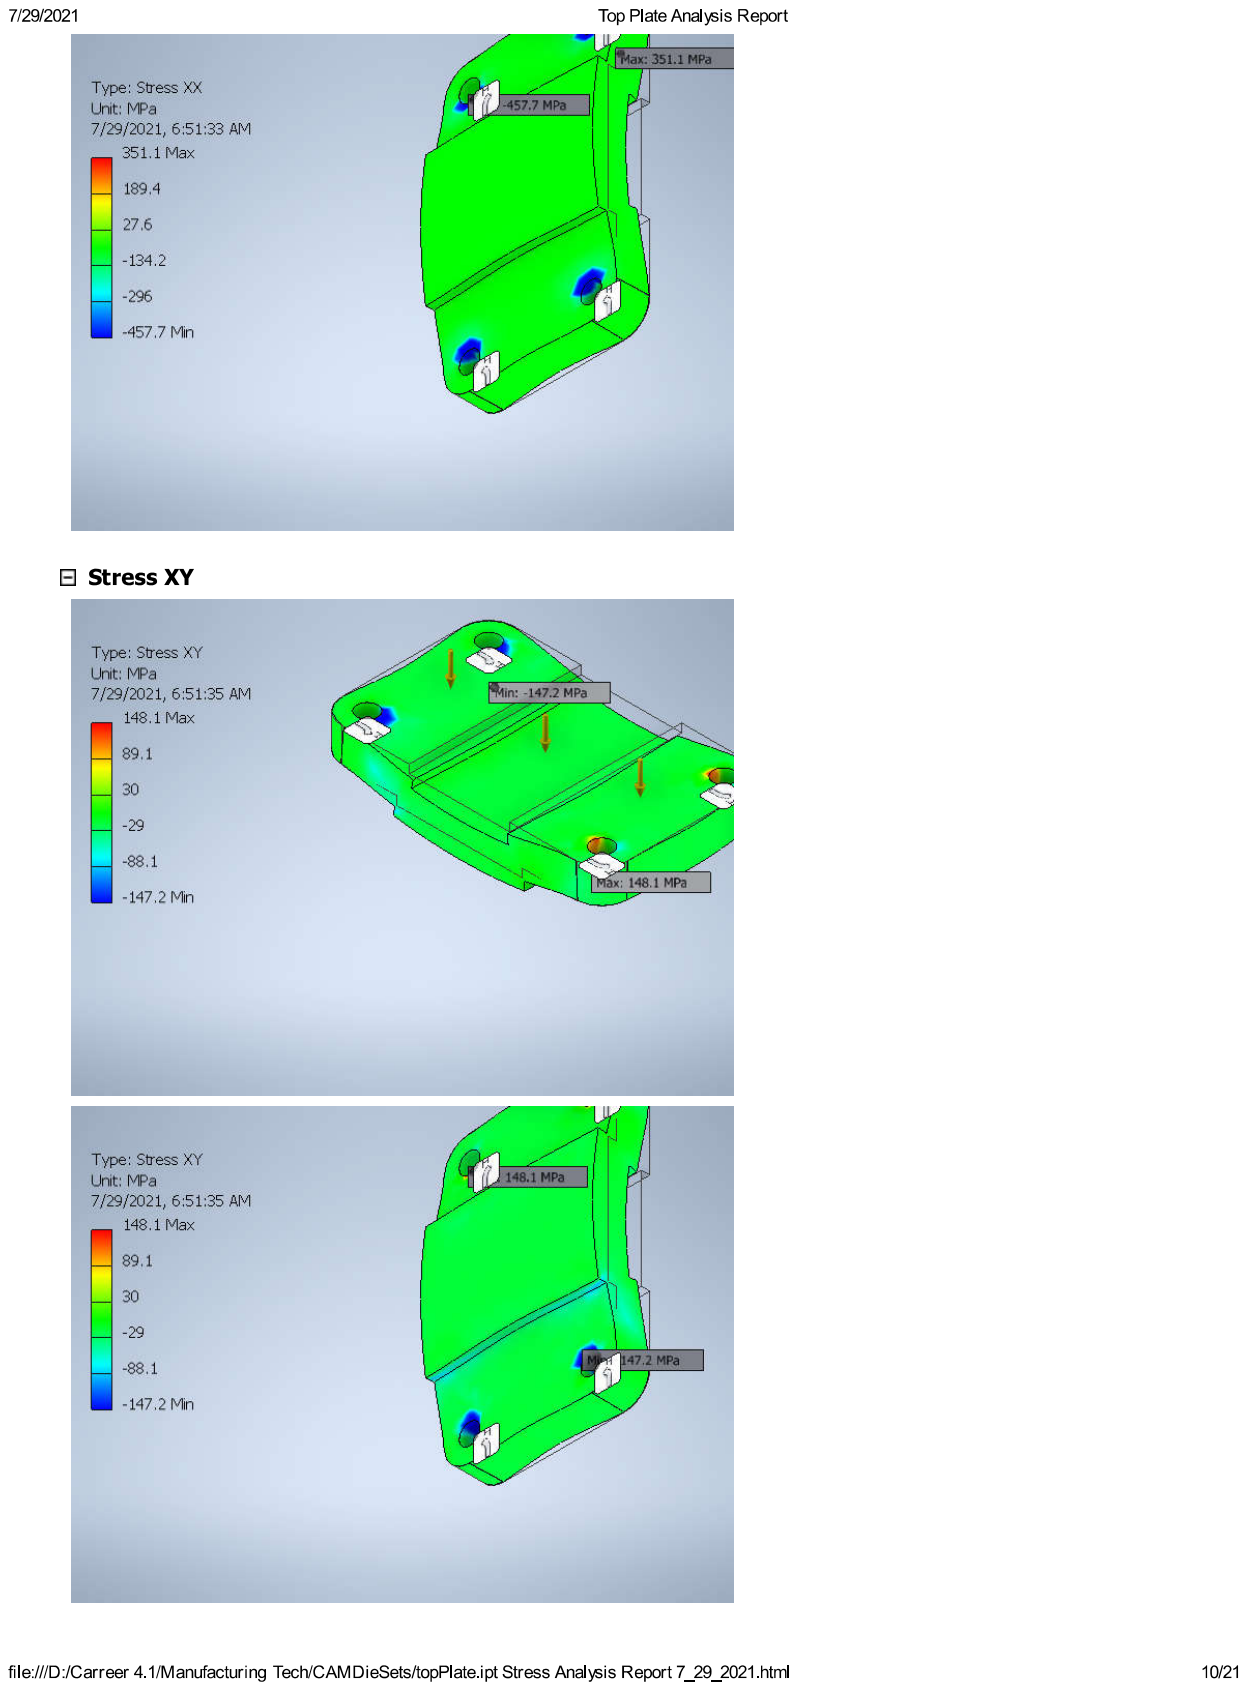
[picture p146: page 10]

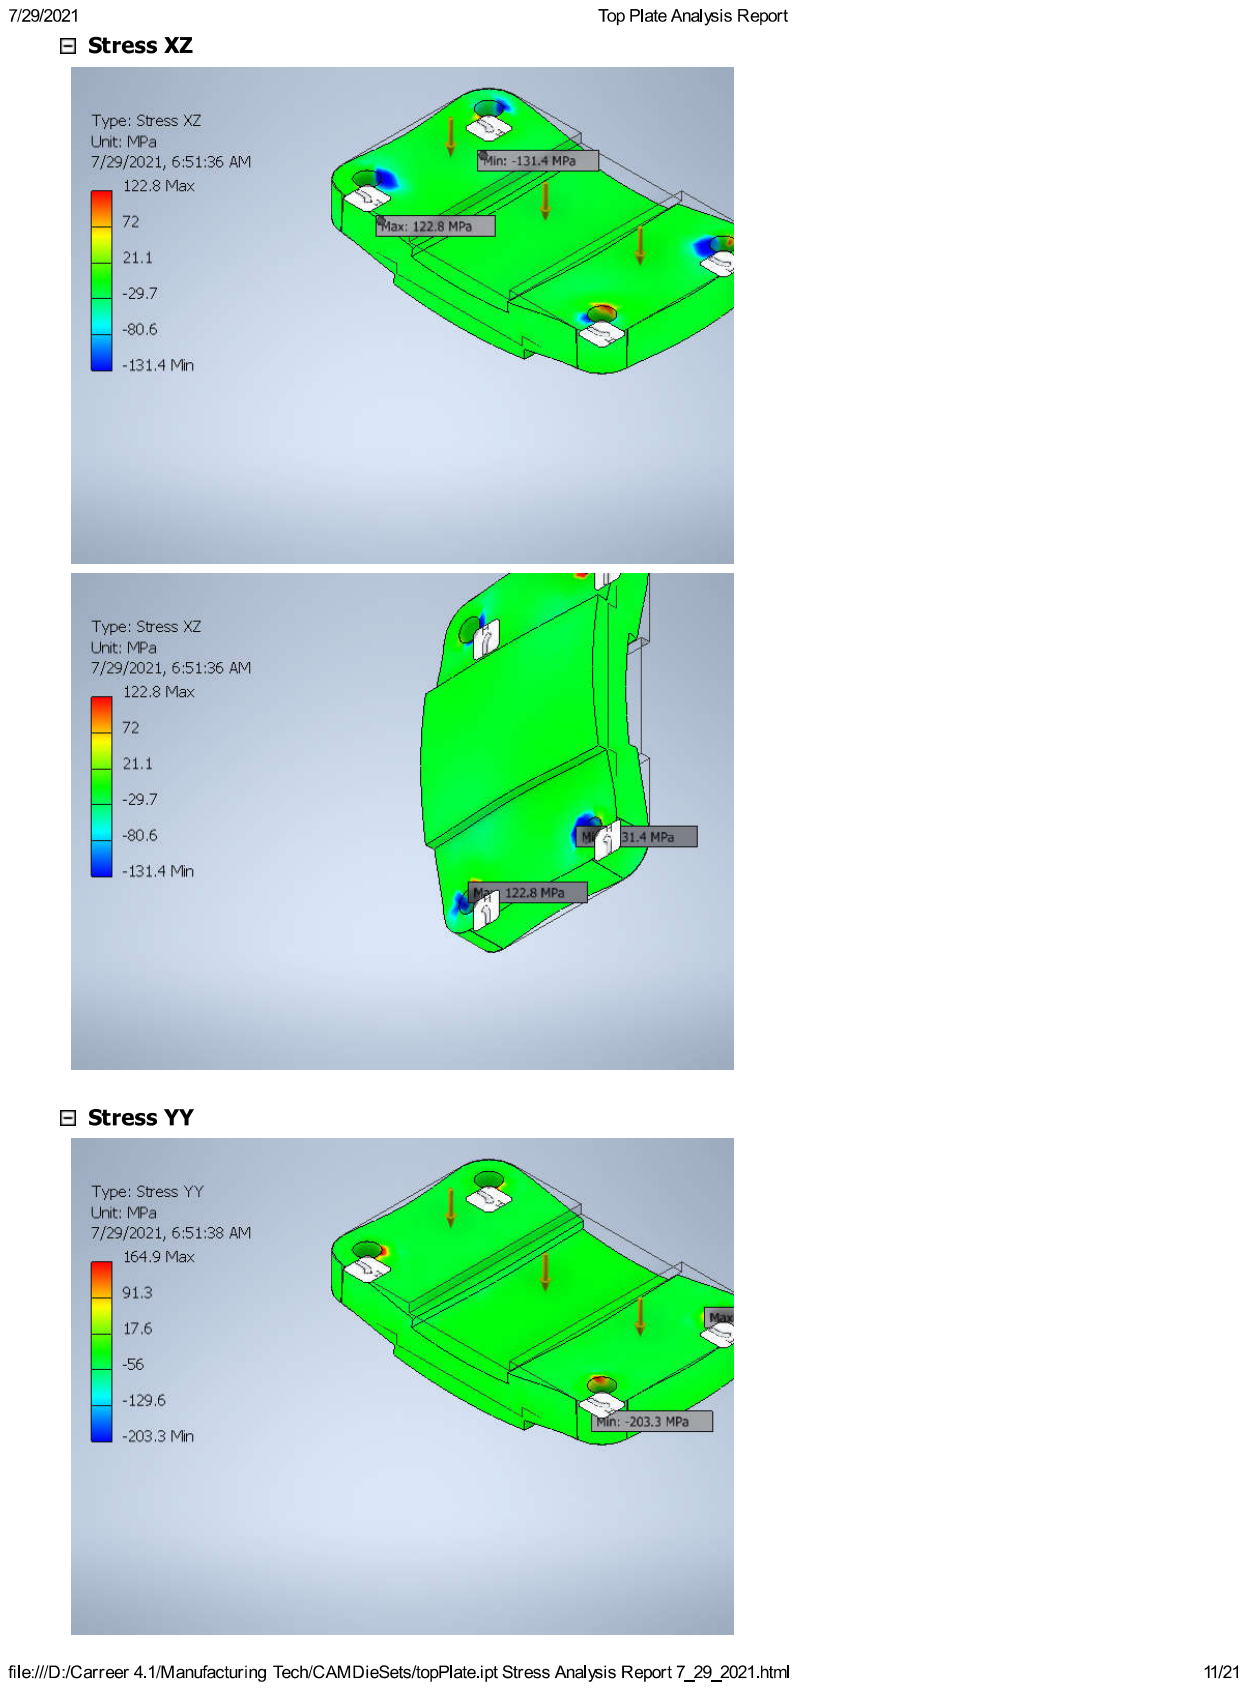
[picture p147: page 11]

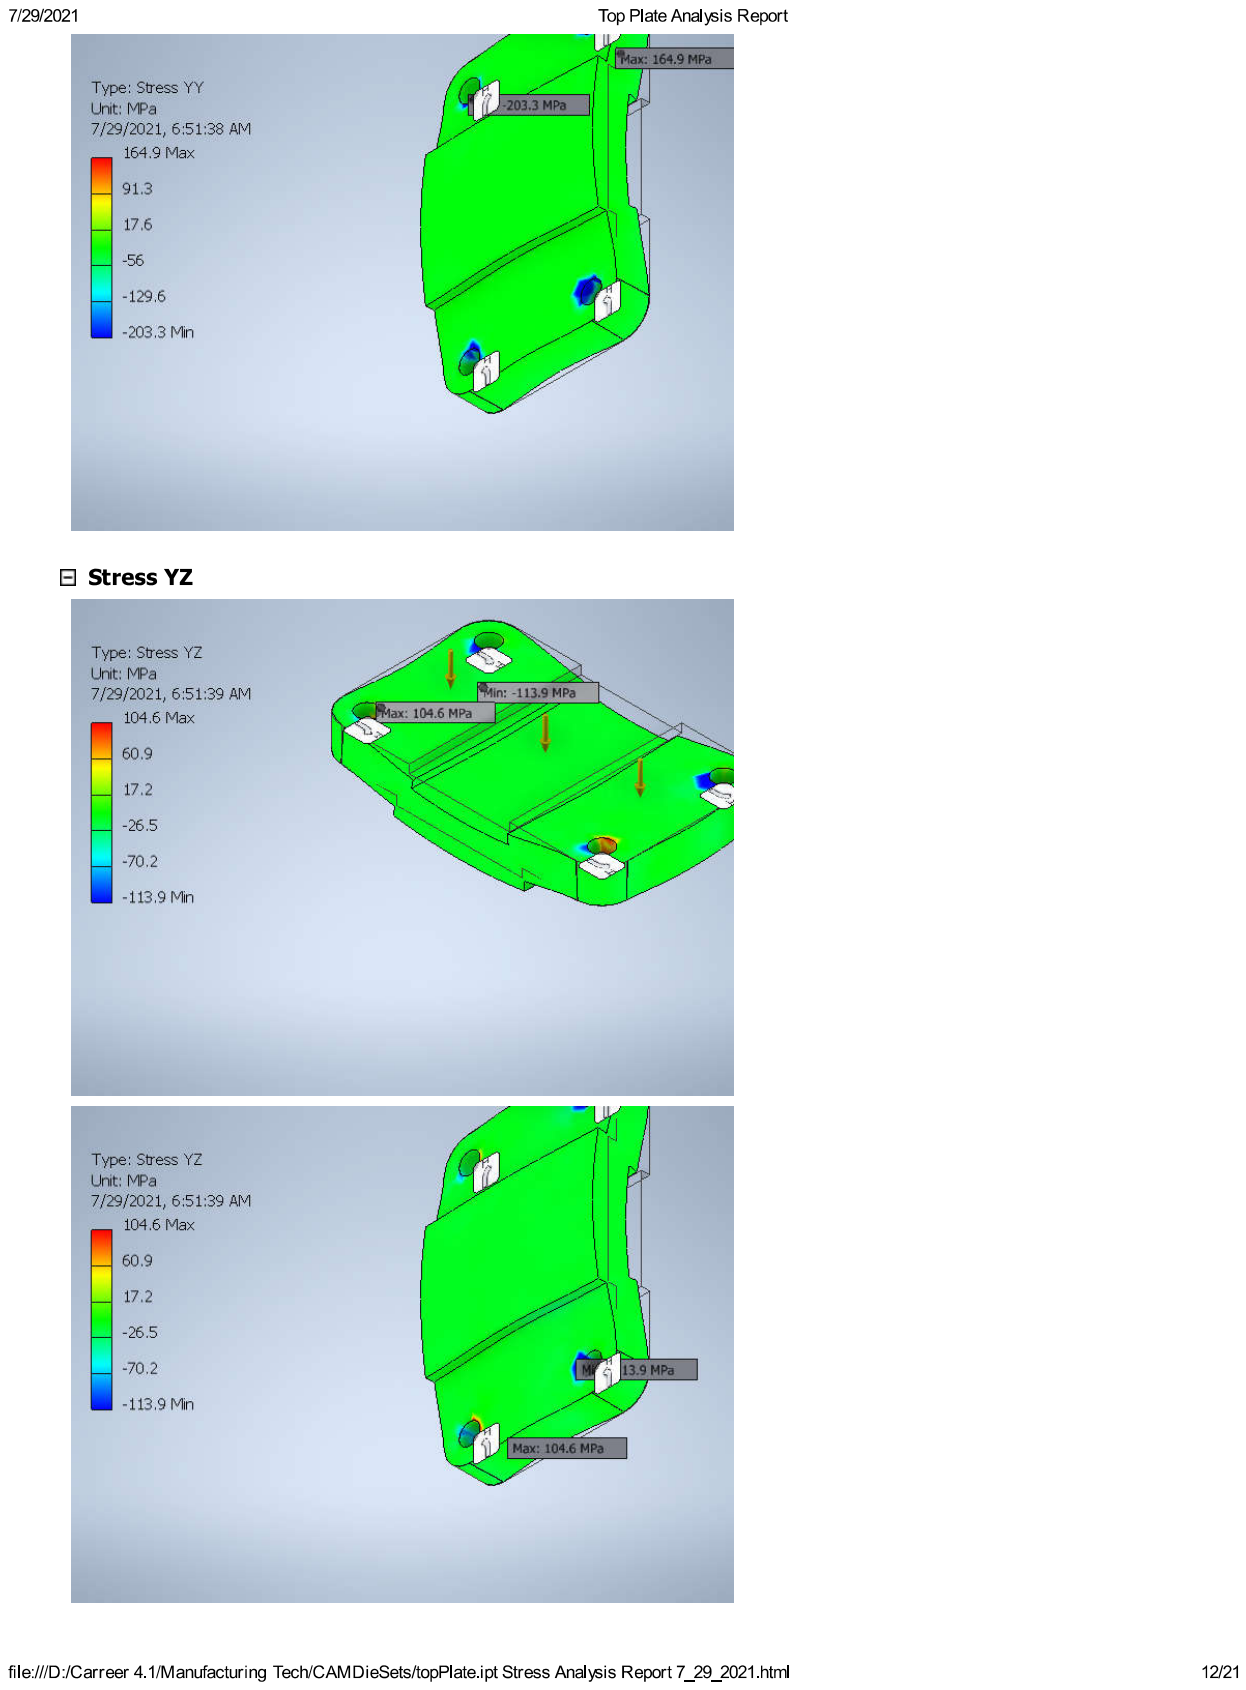
[picture p148: page 12]

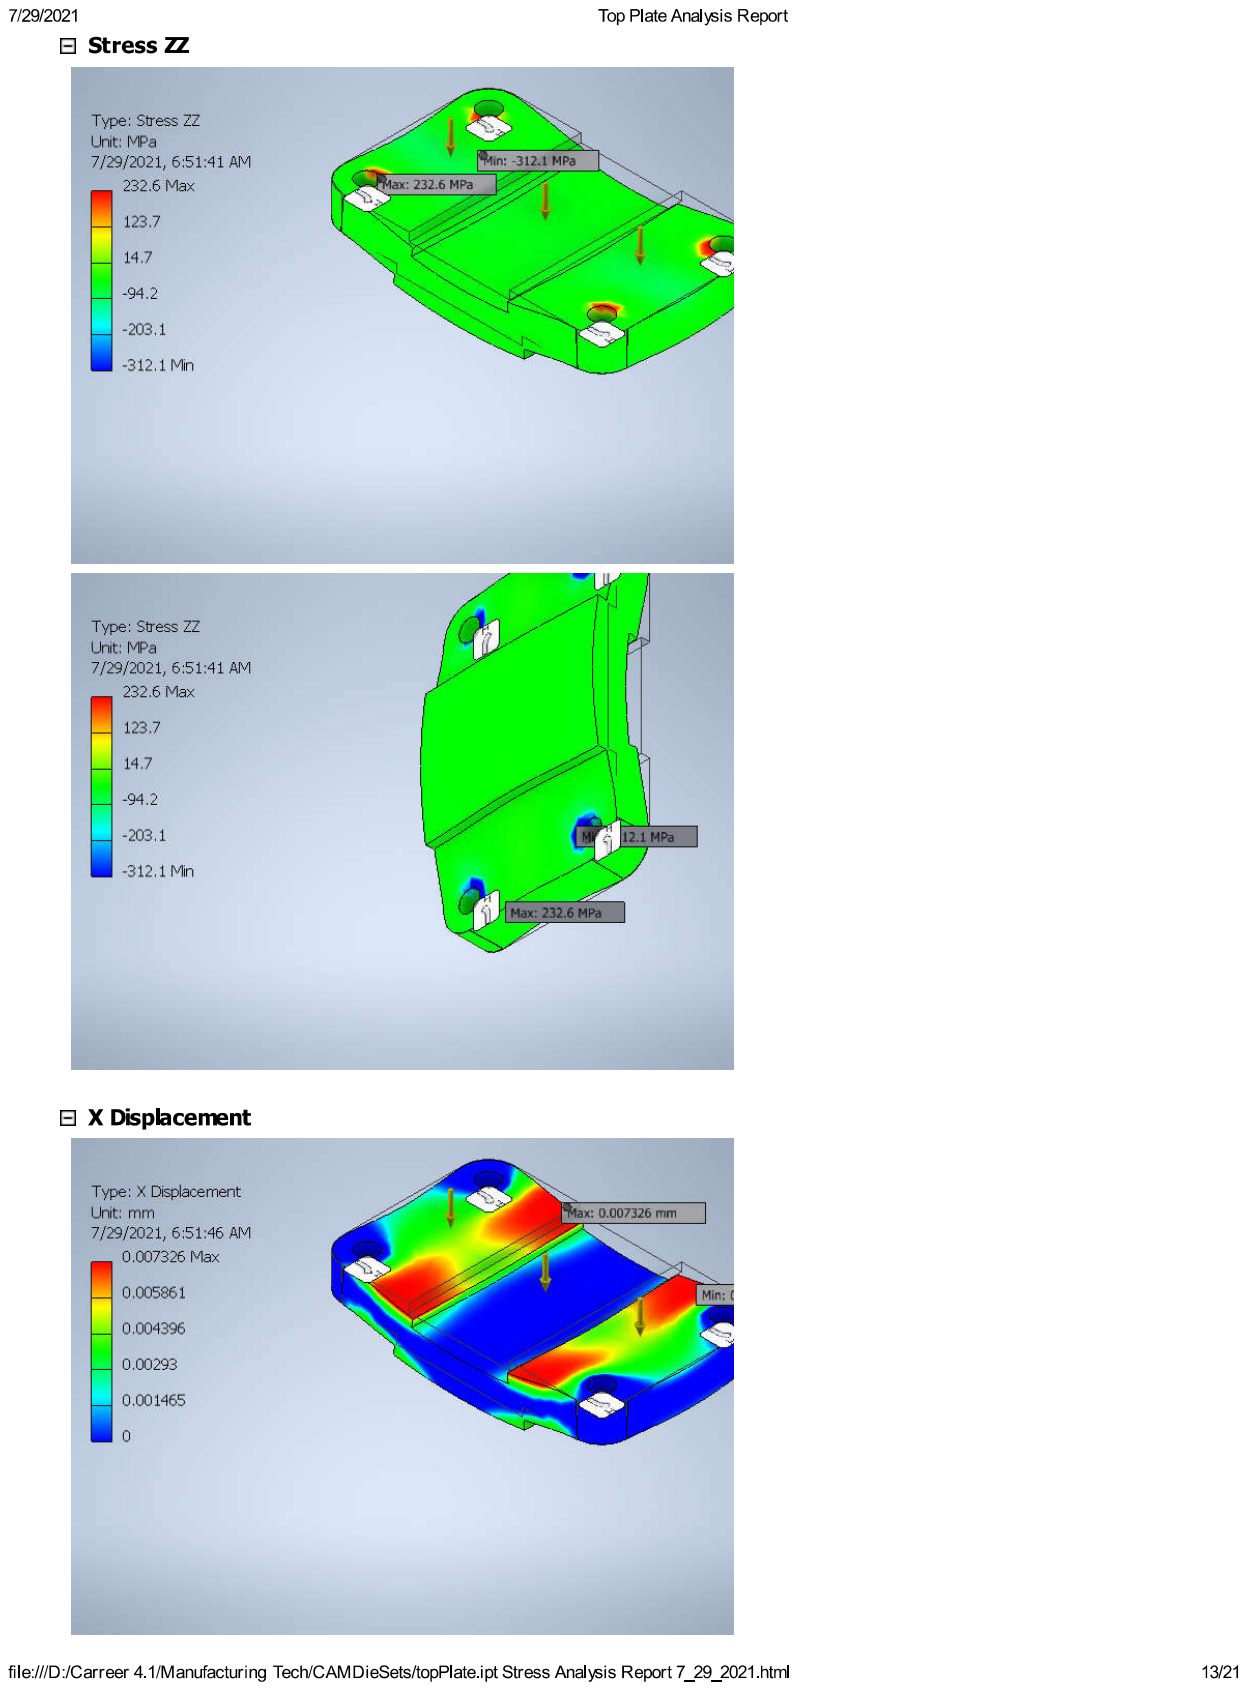
[picture p149: page 13]

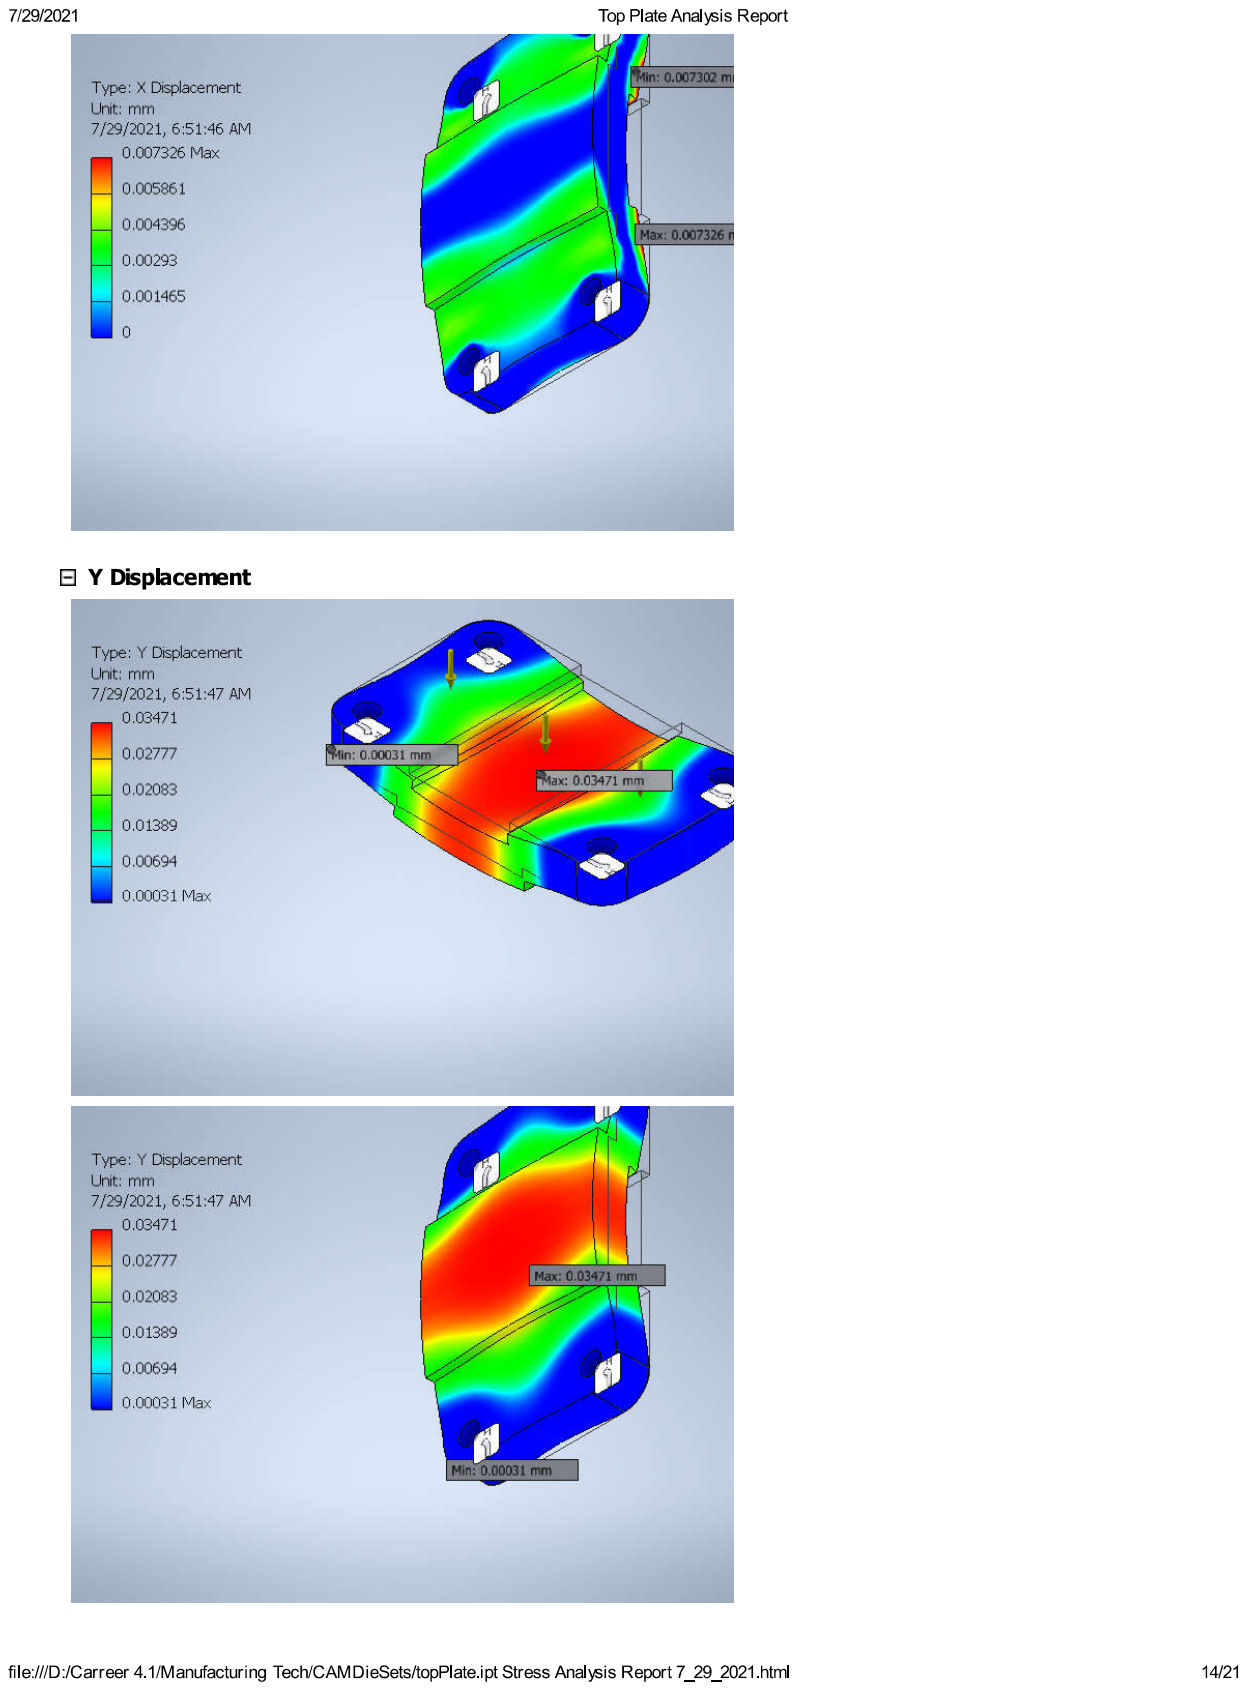
[picture p150: page 14]

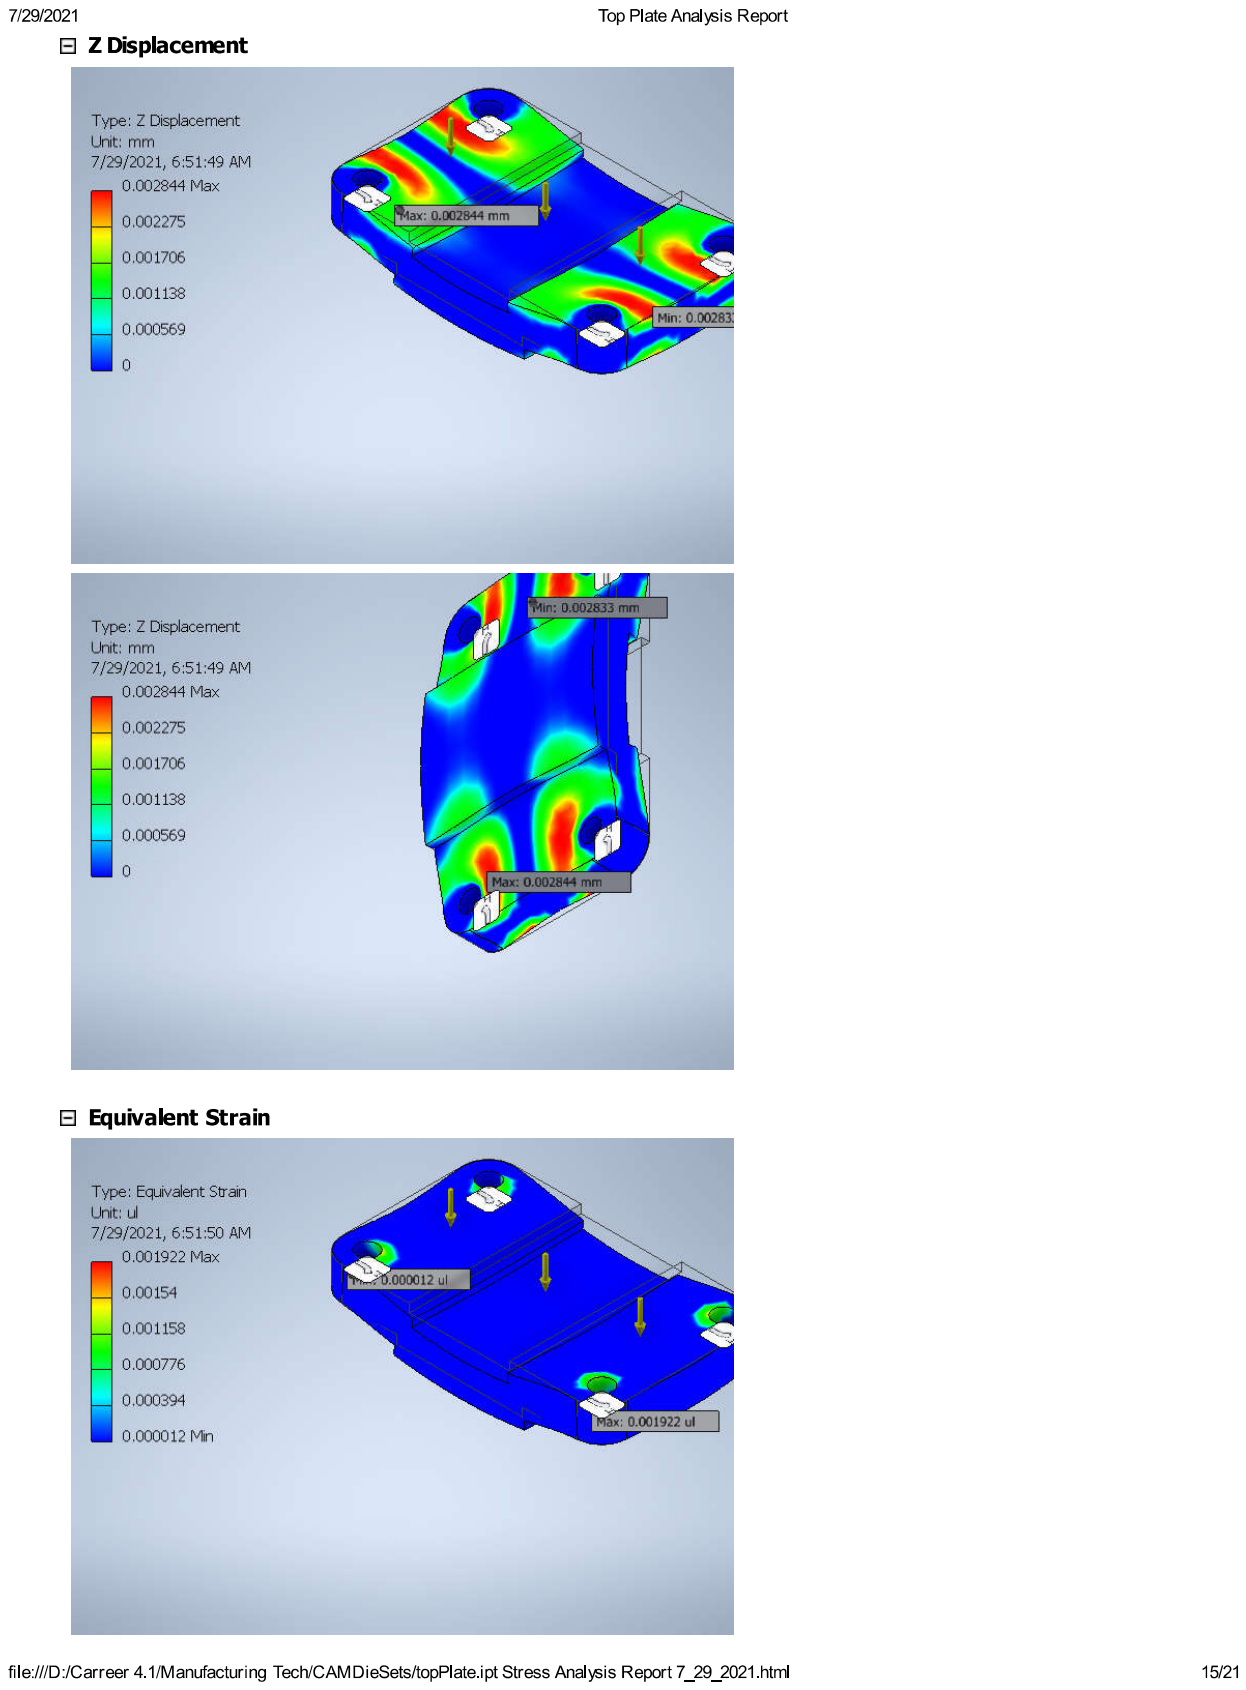
[picture p151: page 15]

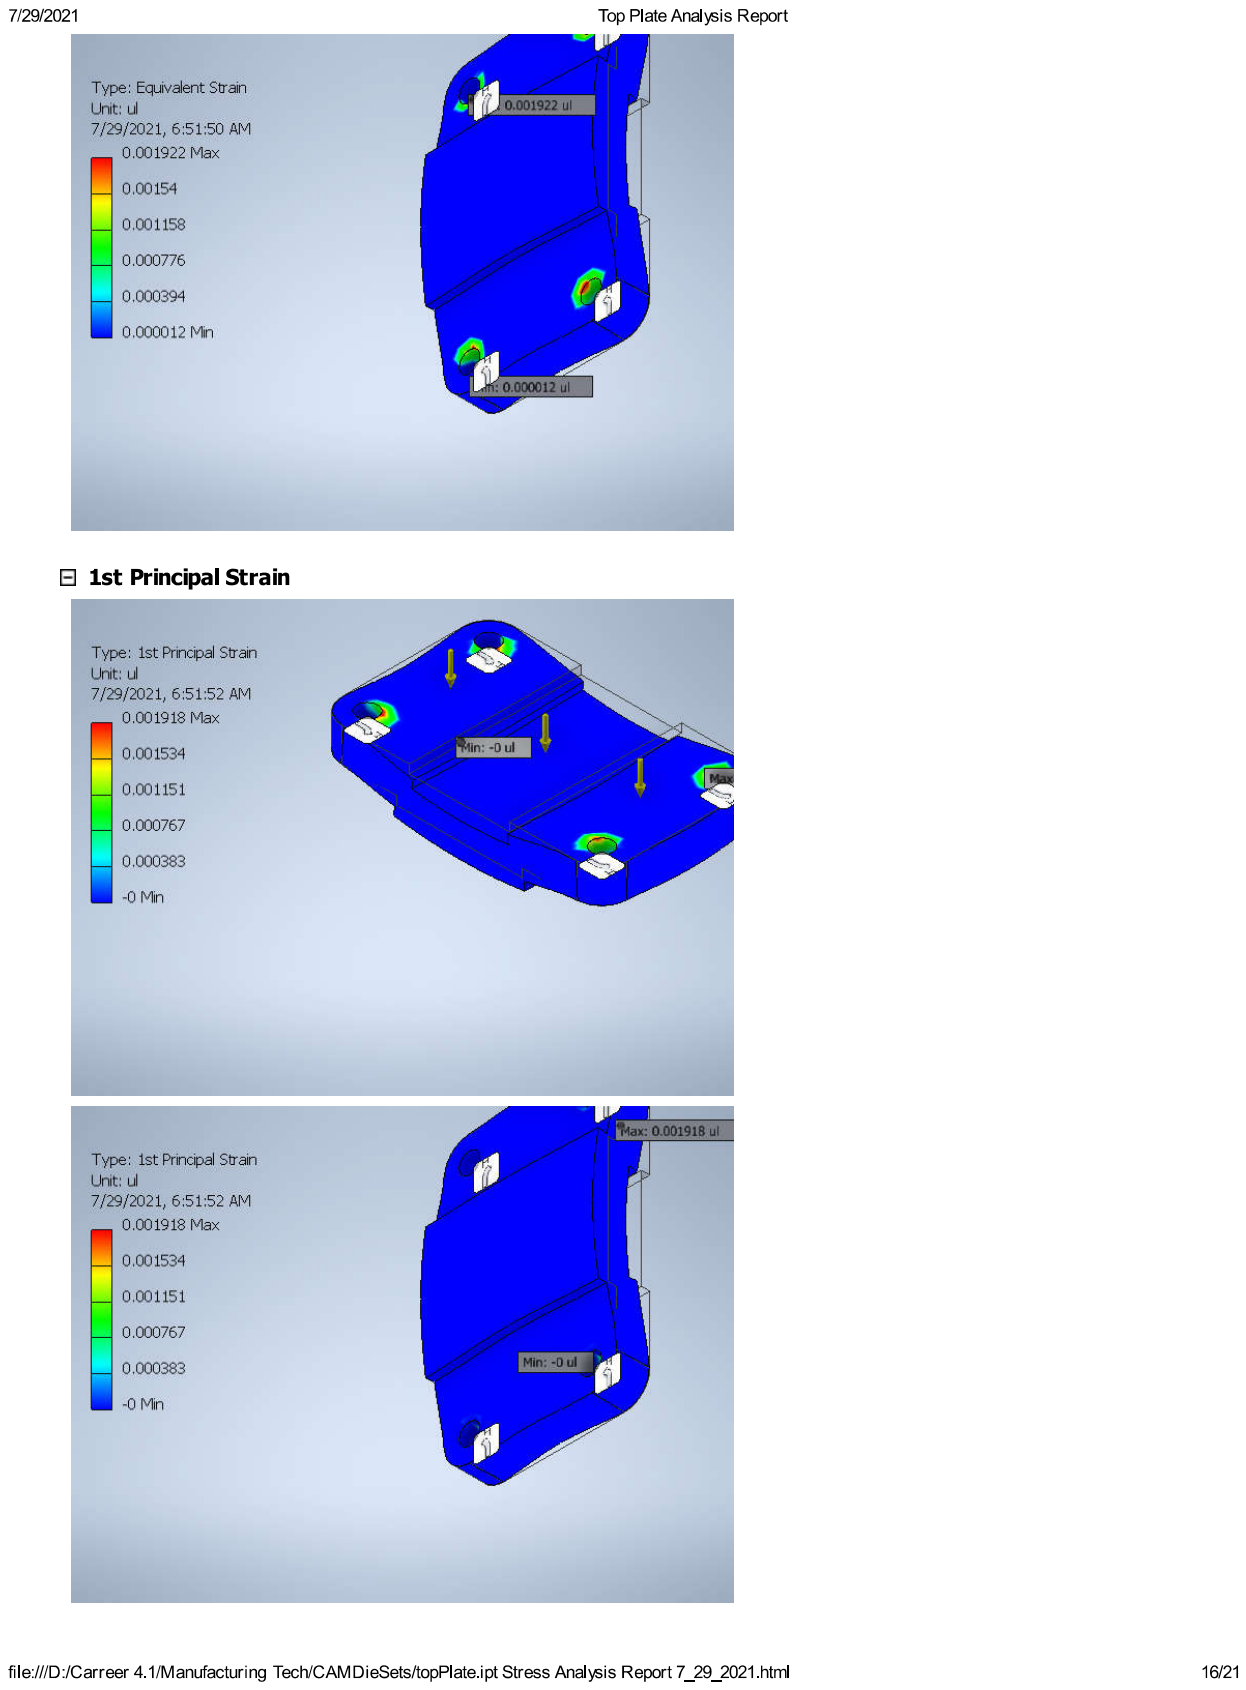
[picture p152: page 16]

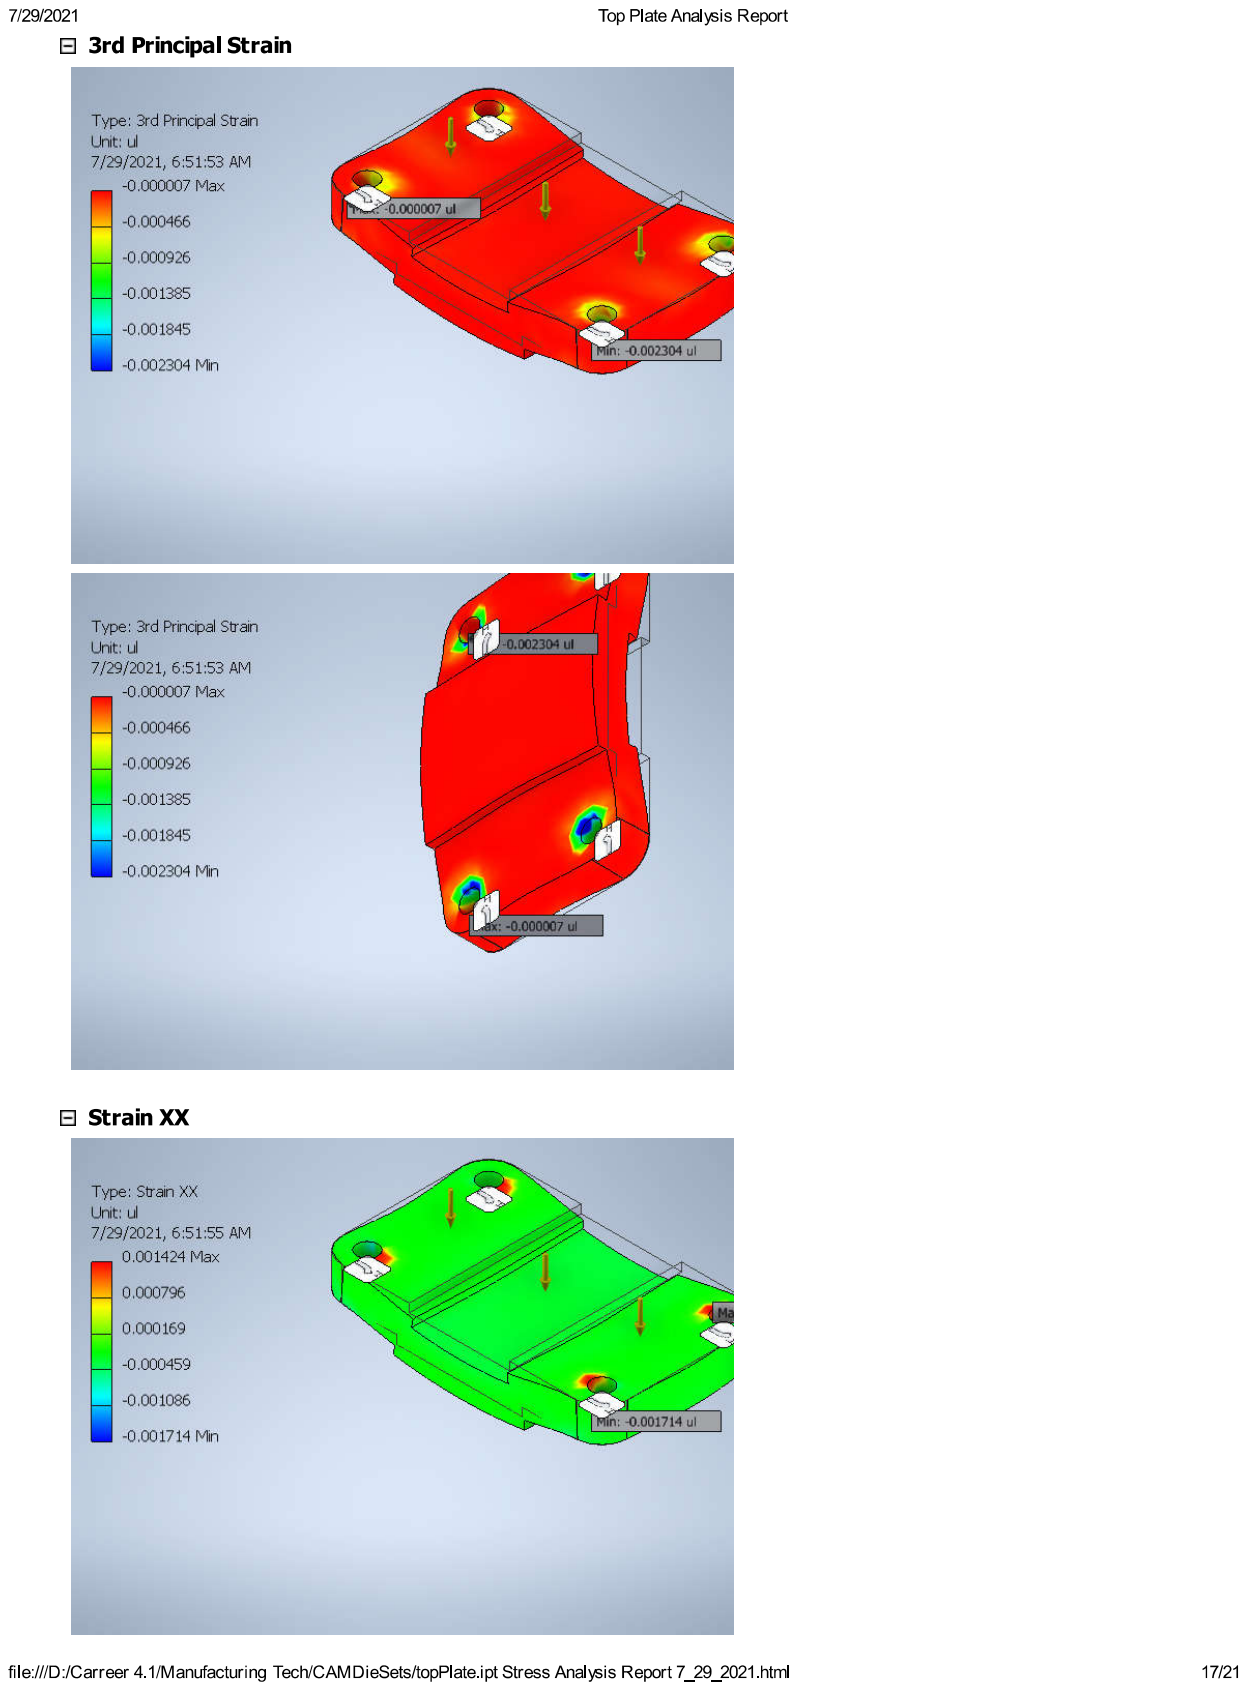
[picture p153: page 17]

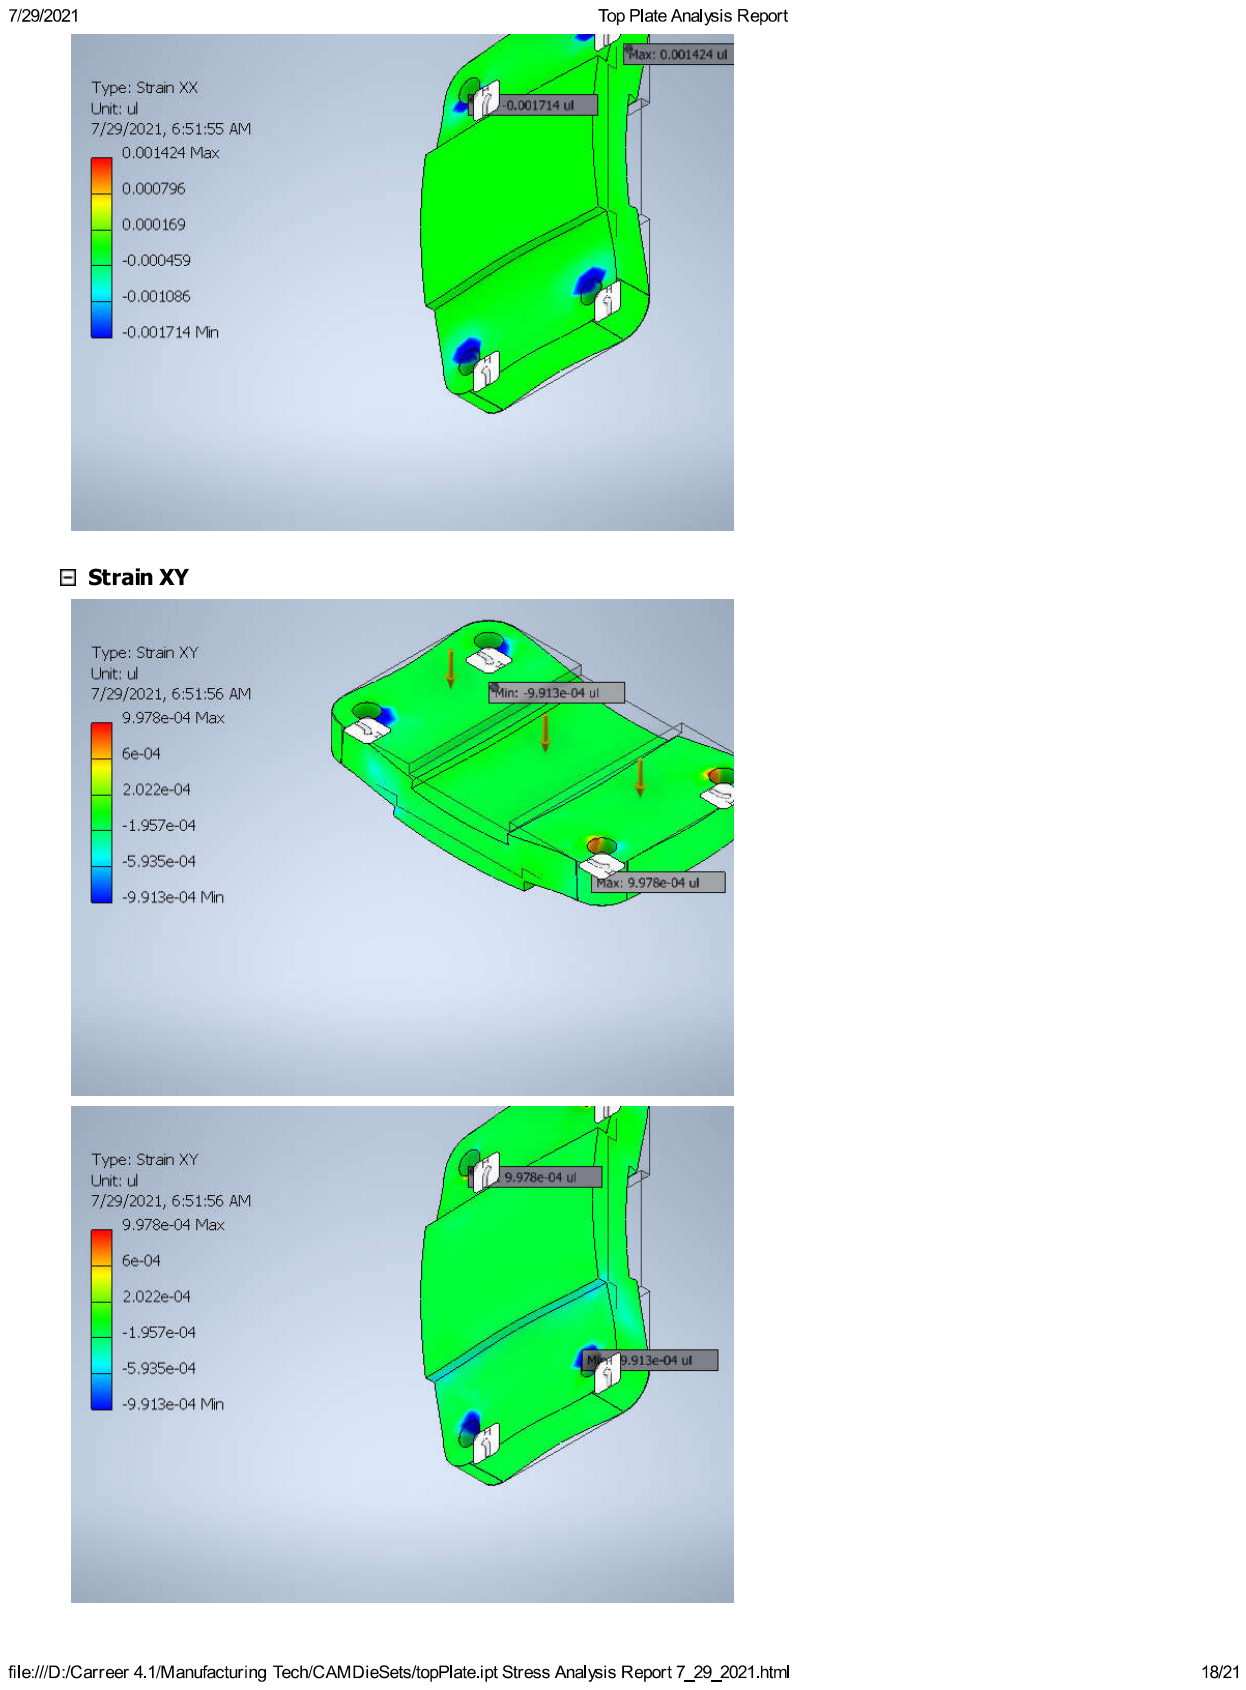
[picture p154: page 18]

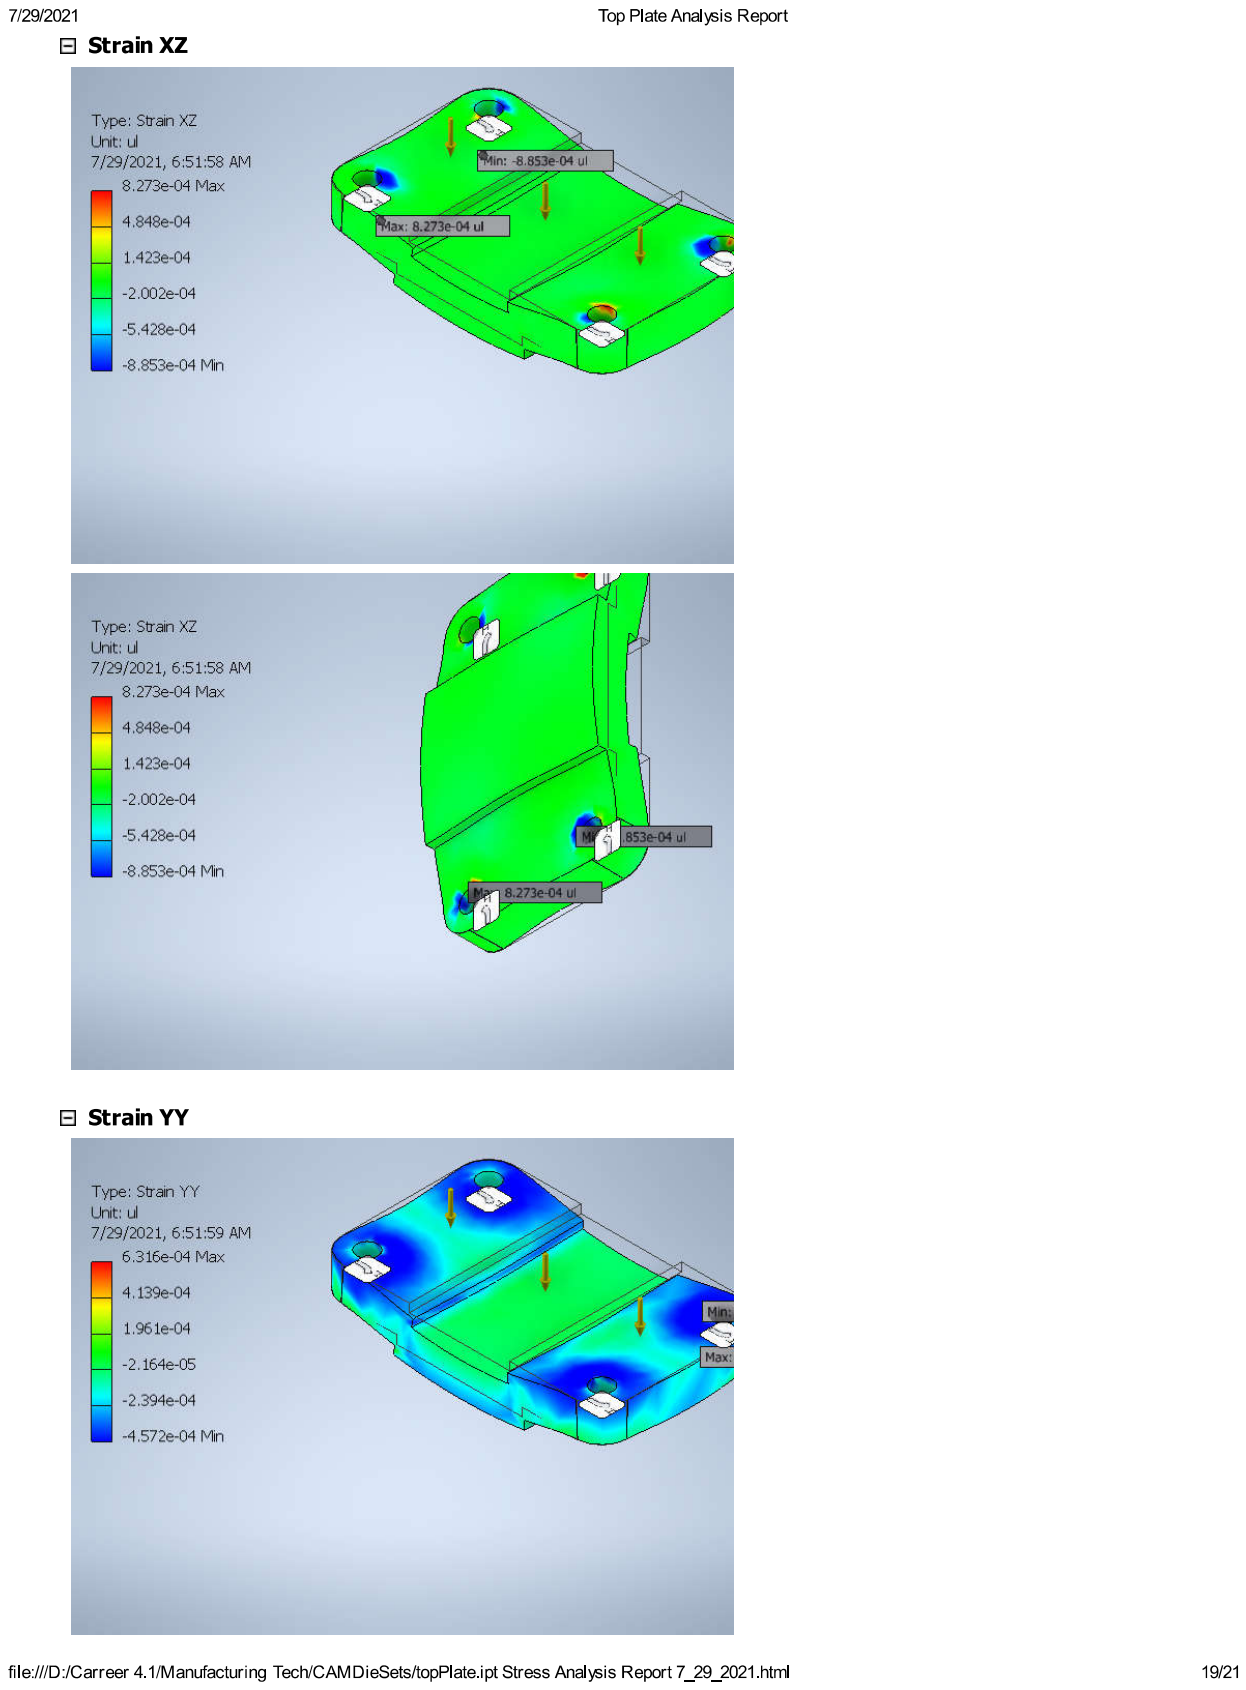
[picture p155: page 19]

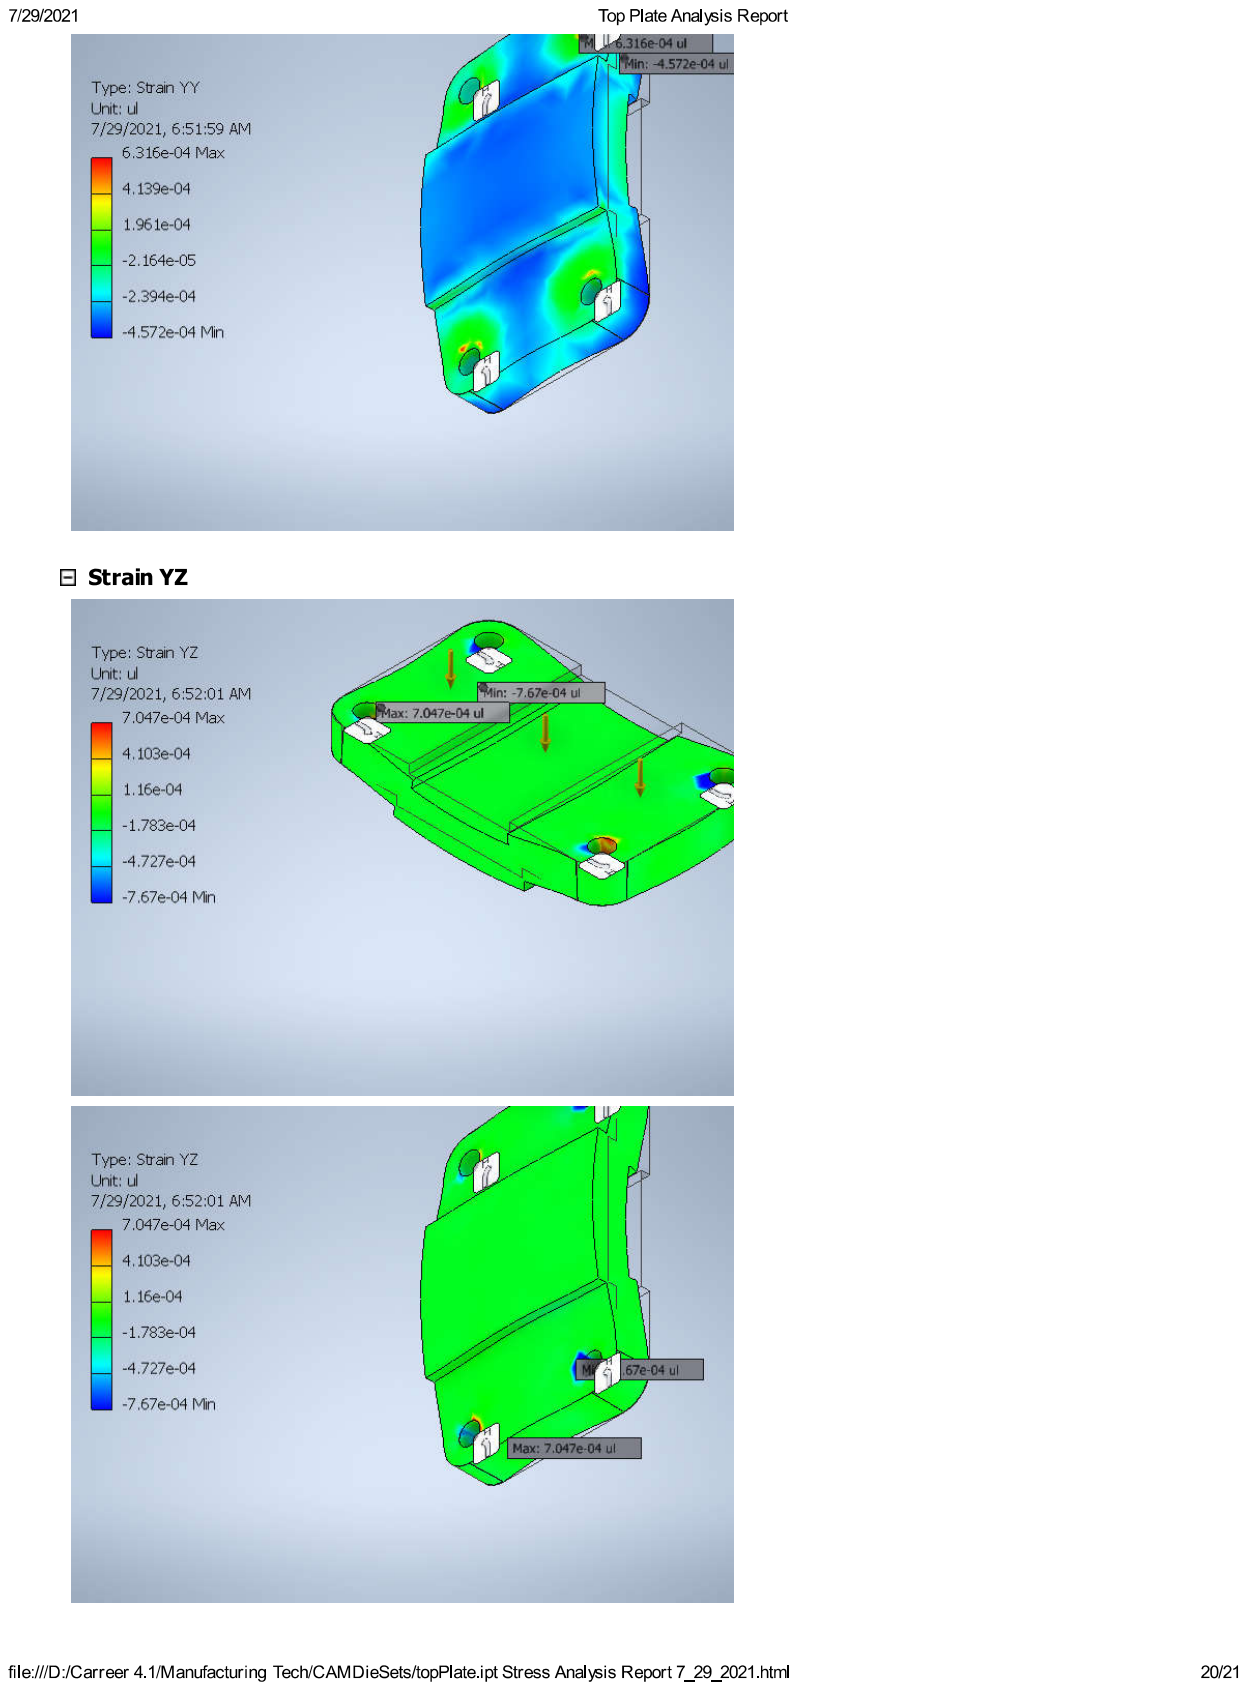
[picture p156: page 20]

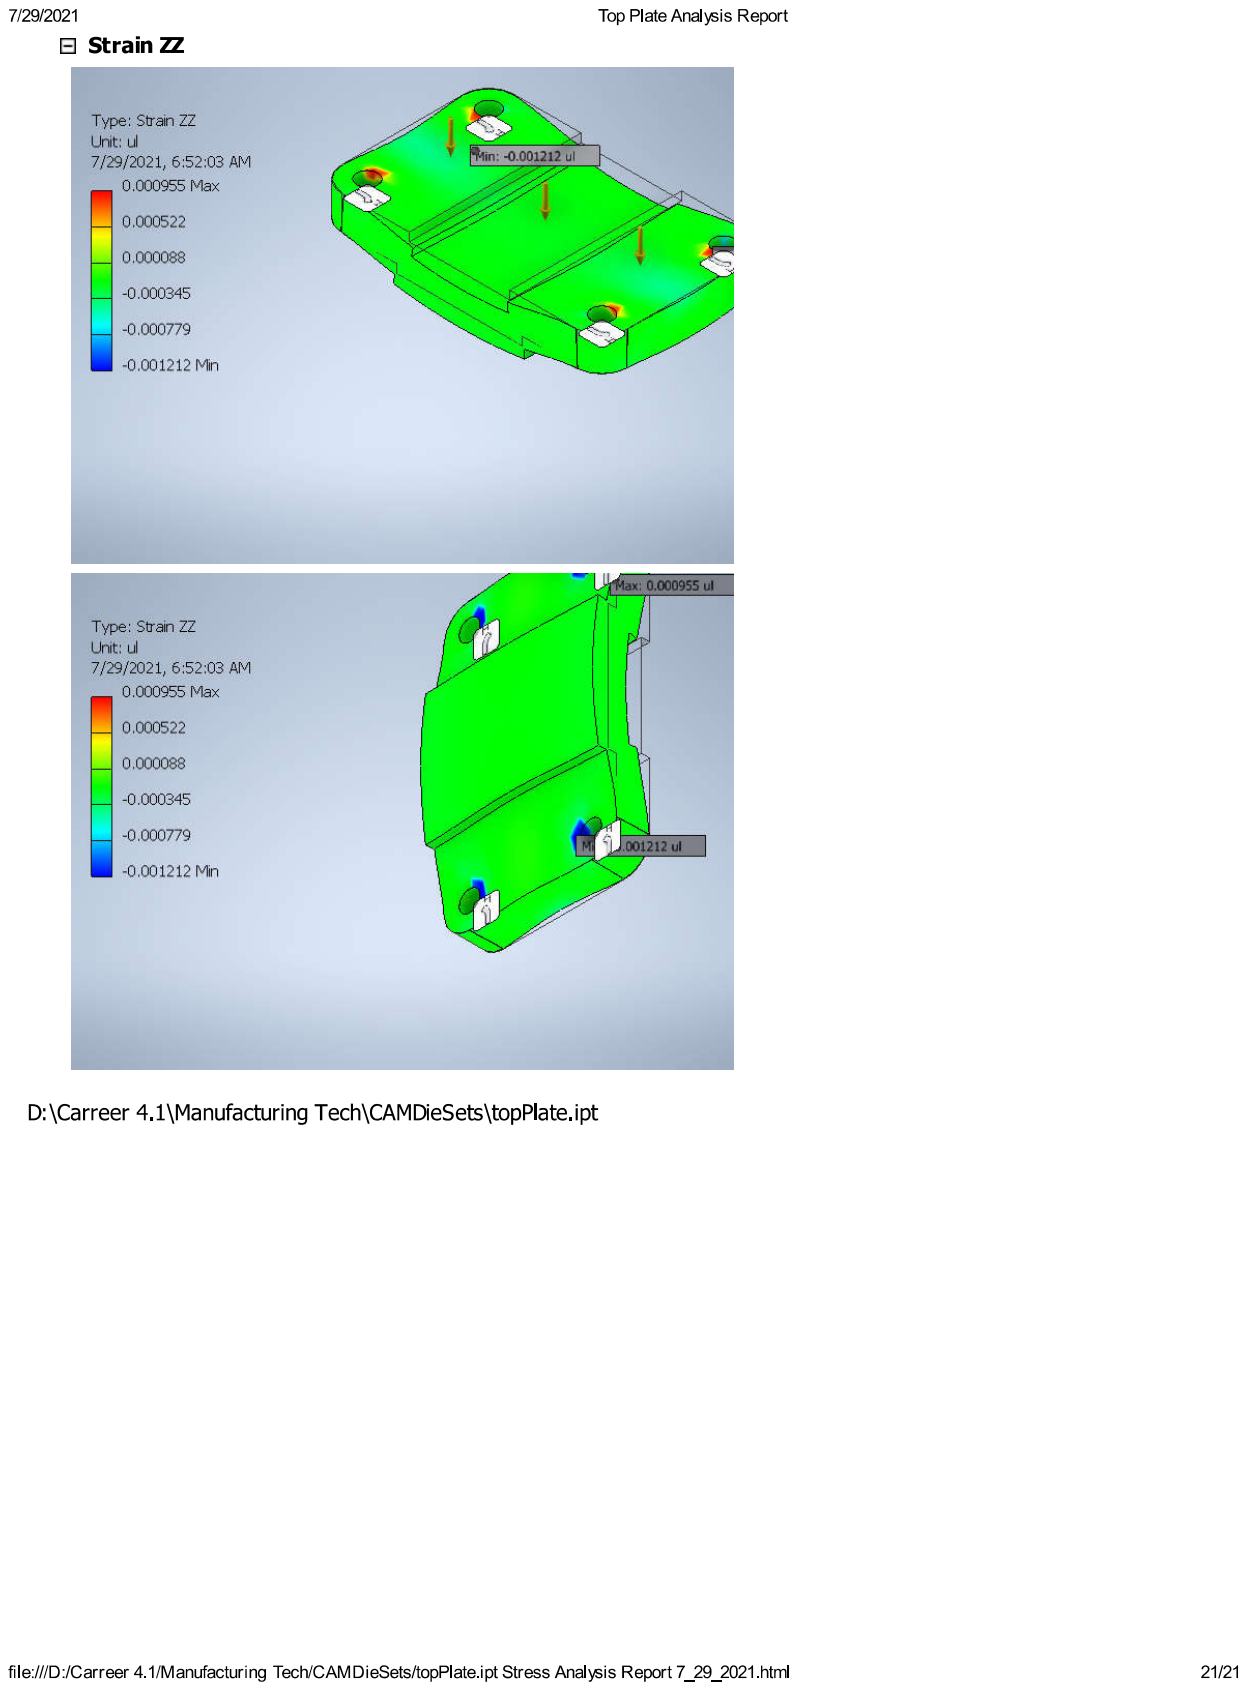
[picture p157: page 21]
