EricoDeMecha/Die-Set/(commit log)

2021-07-29 [test] google drive maintainer
    [Assembly.0001.iam, Assembly.0003.iam, Assembly.0005.iam, Assembly.iam, axle.0002.ipt, axle.ipt, axle.stp, axleSupport.0001.ipt]
2021-07-29 [update]G&M codes for the axle and wheel added
    [Assembly.0003.iam, Assembly.0004.iam, Assembly.0005.iam, Assembly.0006.iam, Assembly.iam, axle.0002.ipt, axle.0003.ipt, axle.ipt]
2021-07-30 [Stress Analysis reports] 3 materials comparisons
    [topPlate.0006.ipt, topPlate.0009.ipt, topPlate.ipt]
2021-07-30 [Caster angle] zero die set and 15 caster, caster wheel
    [Assembly.0004.iam, Assembly.0006.iam, Assembly.0007.iam, Assembly.iam, axle.0003.ipt, axle.0004.ipt, axle.ipt, axleSupport.0003.ipt]
2021-07-31 [completed] Completed
    [Assembly.0007.iam, Assembly.0008.iam, Assembly.iam]
2021-08-03 [clean up] cleaned junk and added more reports
    [Assembly.0001.iam, Assembly.0006.iam, Assembly.0008.iam, Assembly.iam, axle.0002.ipt, axle.0004.ipt, axle.ipt, axle.stp]
